NxRLab/gibbot/Code/Python_Projects/Vision/readme.md

Camera.py - Defines Camera class for grabbing, transforming, and clustering blobs
DisplayBlobs.py - Manages two Cameras, combines their output, and displays it to the screen
GUITest.py - Simple standalone Tkinter test code
