NxRLab/gibbot/Code/PIC_Projects/PIC32/BLDC/README

4/2/13
The initial version of this code was tested on a Pittman 4443S013 brushless motor.  The target motor is the Maxon EC 60, so the code will mostly likely change to reflect this.
