NxRLab/gibbot/Frame/Frame v4/POWERPOINT/12.10.14 Presentation.pptx

## Gibbot Frame V4

By Preston Wang

## Version 3

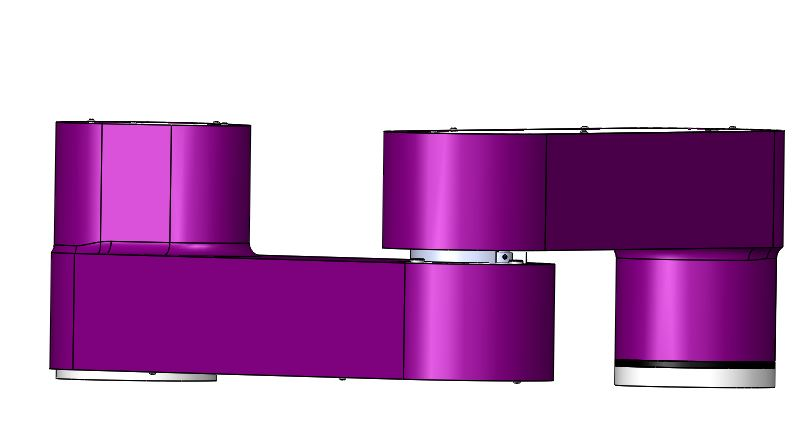
[picture p2: figure]

- Frame Material: ABS Plastic
- Manufacture Method: Rapid Prototyped
- Length: 9.4 in.
- Height: 4.94 in.
- Major Design Change: Redesigned Magnet Holder into one piece, Combined Carrier and Shaft into one component, Added Double Bearings at Magnet Holder Connection

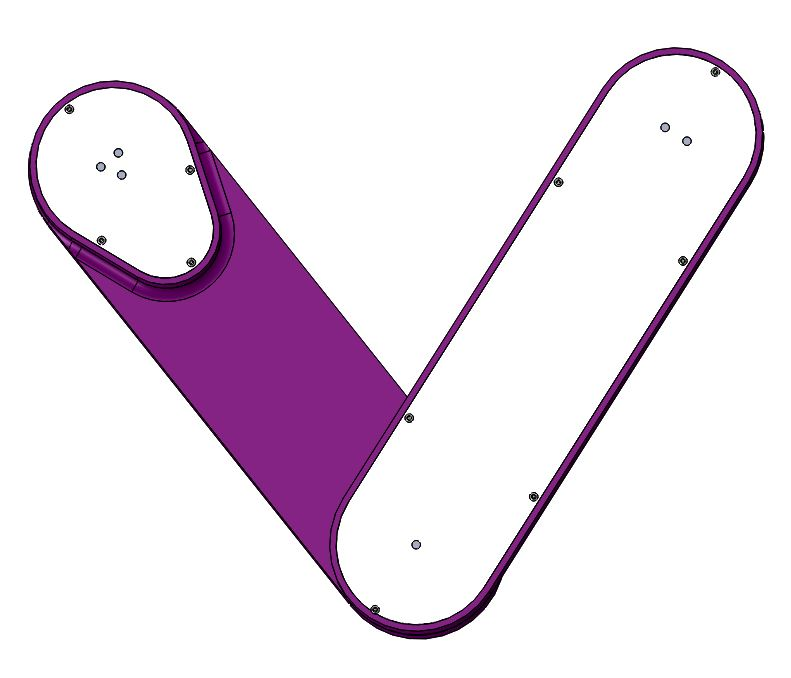
[picture p3: figure]

## Design Goals

- Increase space for wiring
  - Current frame layout and length does not provide enough space for wires between the motor and board
  - Increase overall length of frame
- Reduce the angular play between links
  - Change the link connection from a single bearing to double bearing
- Increase the stiffness of the connection between the links
  - Change carrier attachment to frame from blindly threaded screw to nuts and bolts
- Verify wall thickness of combined carrier and shaft

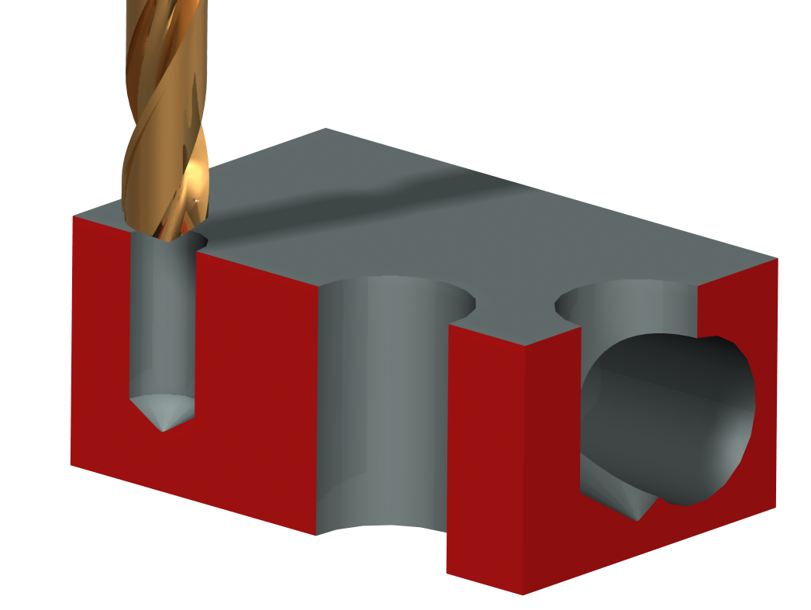
[picture p4: figure]

## Reason for Changing Gears

- Nut and bolt connection requires adequate clearance between fastener and motor
  - Current ring gear size does not satisfy clearance requirement
- Increasing ring gear ID will provide required clearance
  - Increase spacing between planetary gear bearings and DC Motor fasteners

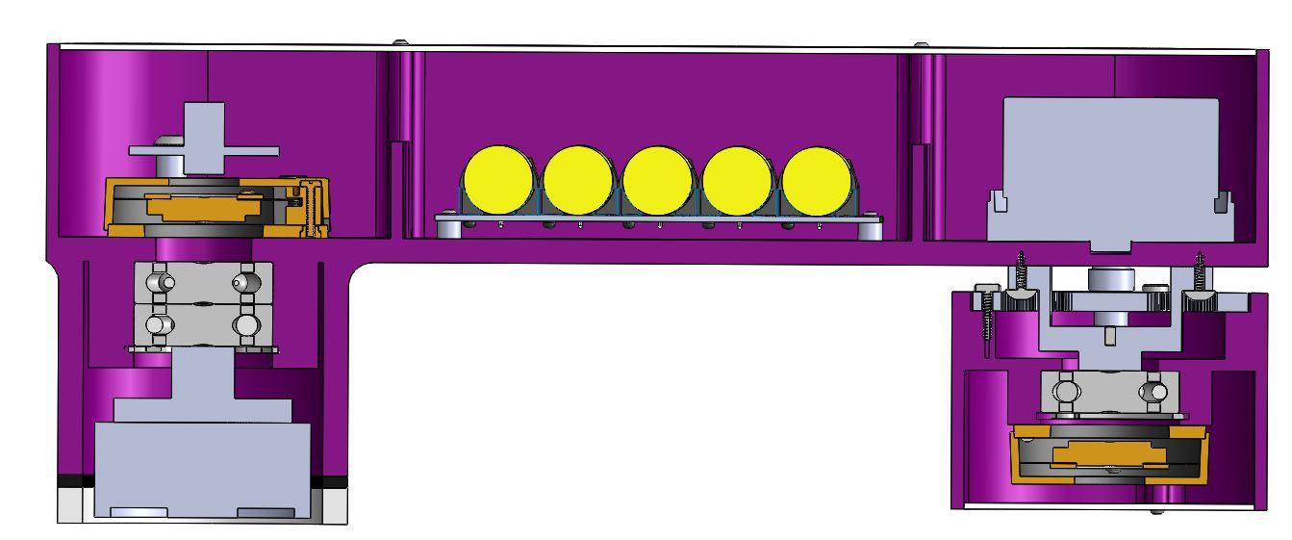
[picture p5: figure]
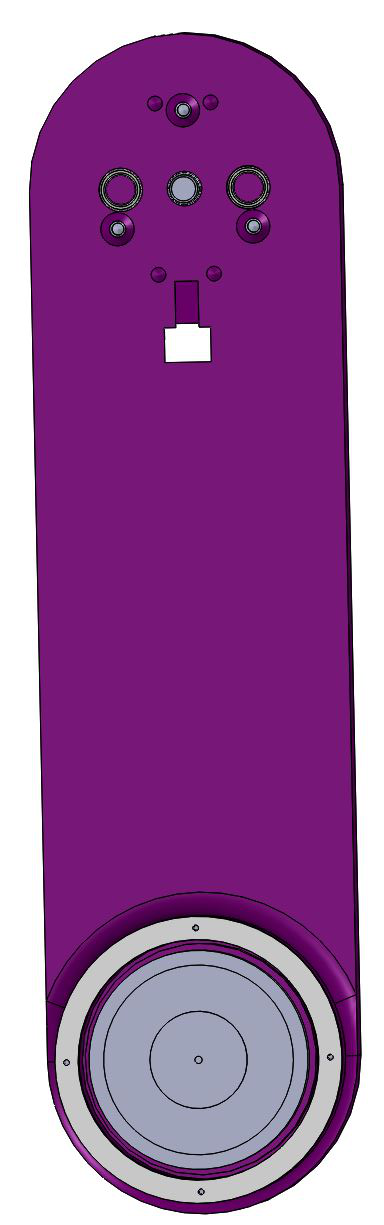
[picture p6: figure]

## Gear Selection Criteria

- Increase Ring Gear ID
  - Minimum ID is 3.5 in
- Maintain same gear ratio of 6
  - # of revolution of sun gear to revolution of ring gear
- Choose planetary gears and sun gear with hubs
  - Hubs provide means of attaching gears to shafts
  - Sun gear bore must be 8mm to fit on motor shaft
- Verify that gears can withstand max torque from motor

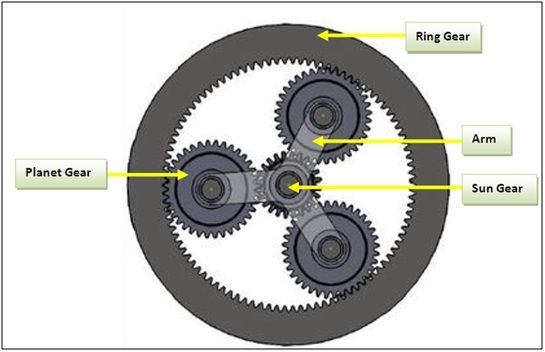
[picture p7: figure]
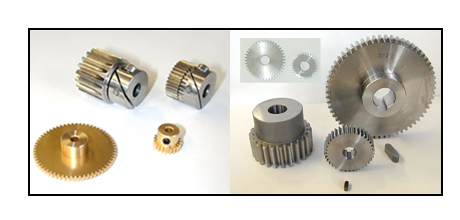
[picture p8: figure]

## Gear Selection

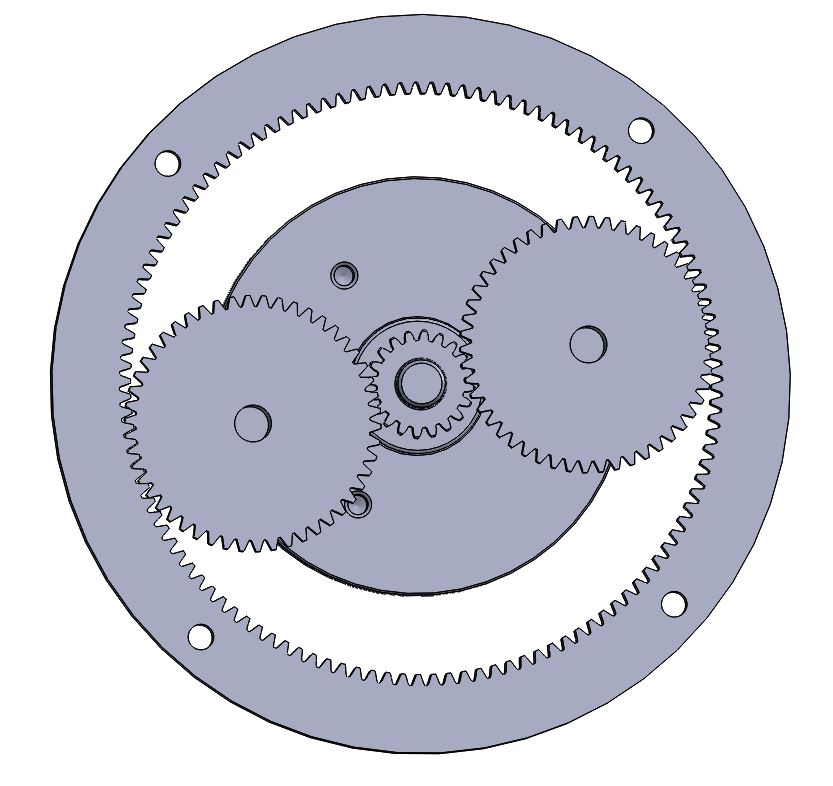
[picture p9: figure]
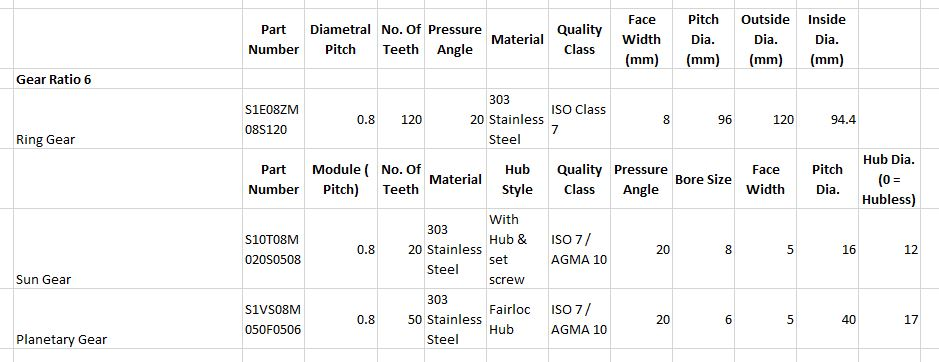
[picture p10: figure]
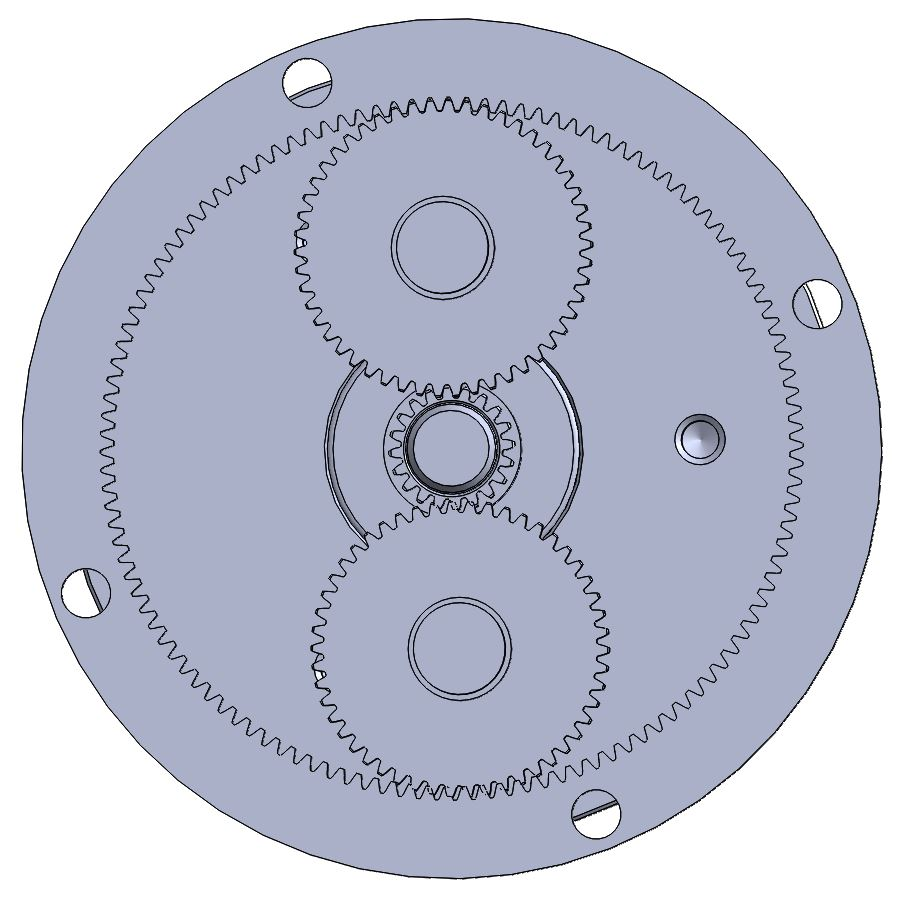
[picture p11: figure]

## Gear Calculations

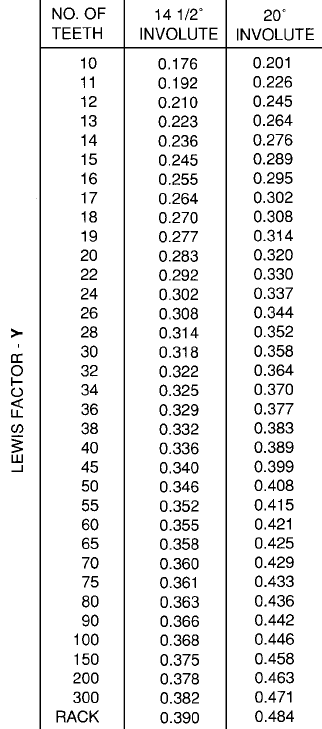
[picture p12: figure]
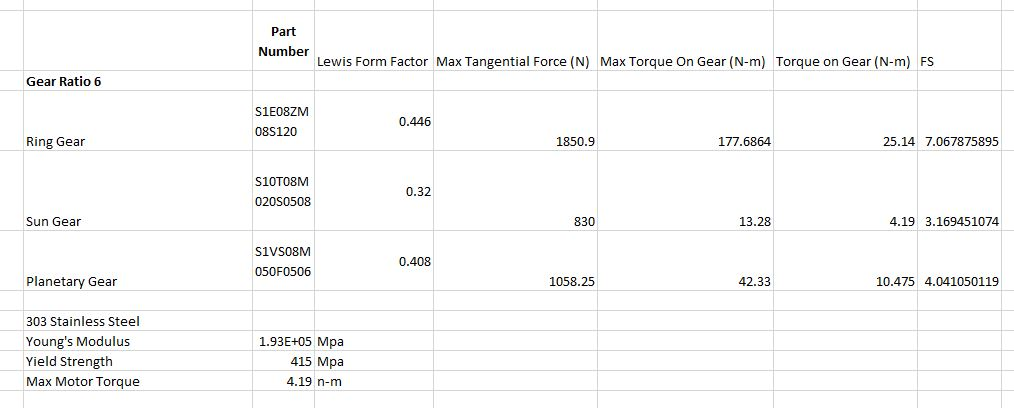
[picture p13: figure]
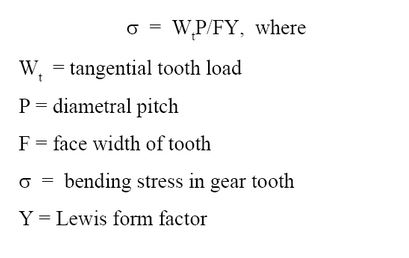
[picture p14: figure]

## Shaft and Fastener Calculations

## Carrier and Shaft

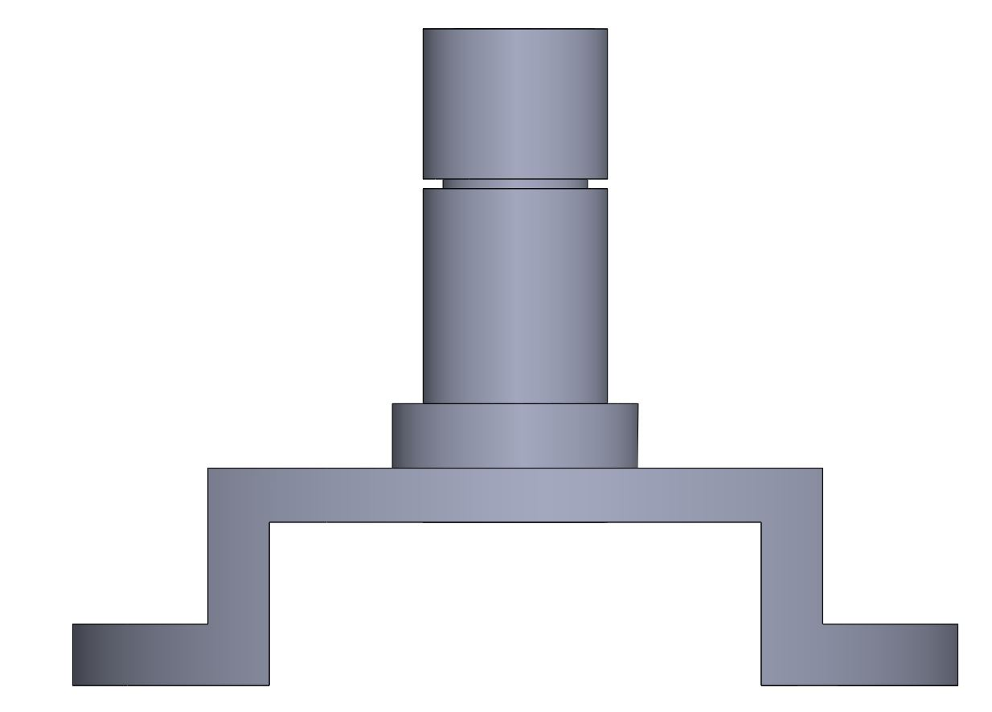
[picture p15: figure]

- Changes:
  - Increased Height to accommodate 2 bearings
  - Increased width to provide clearance between fastener and DC motor
  - Changed bearing holes to accommodate 12mm OD bearing
- Maintained ¾ in. OD and ½ in. ID on shaft
  - Can reuse same bearings
  - Maintains space for wiring

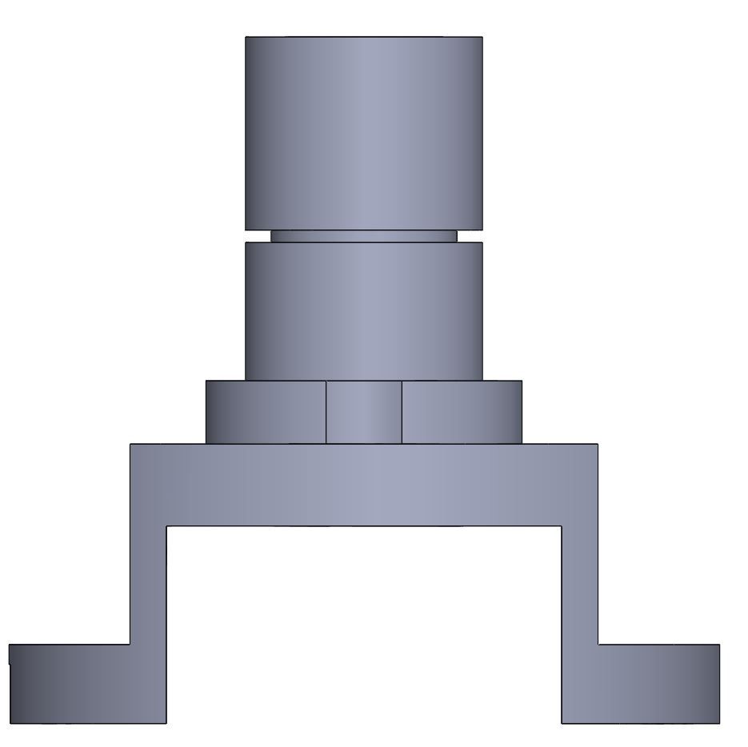
[picture p16: figure]

## Wall Link

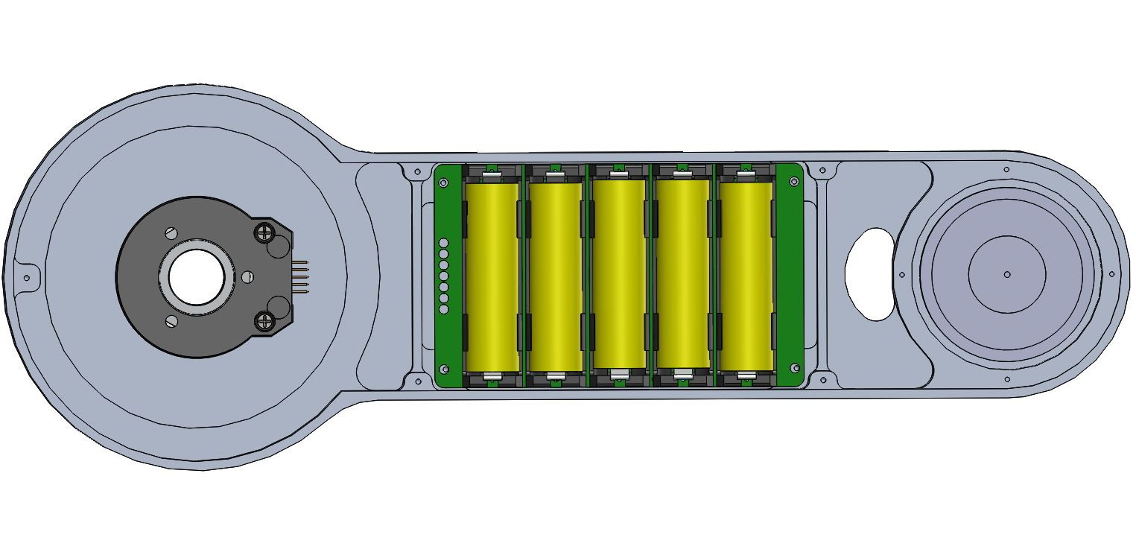
[picture p17: figure]
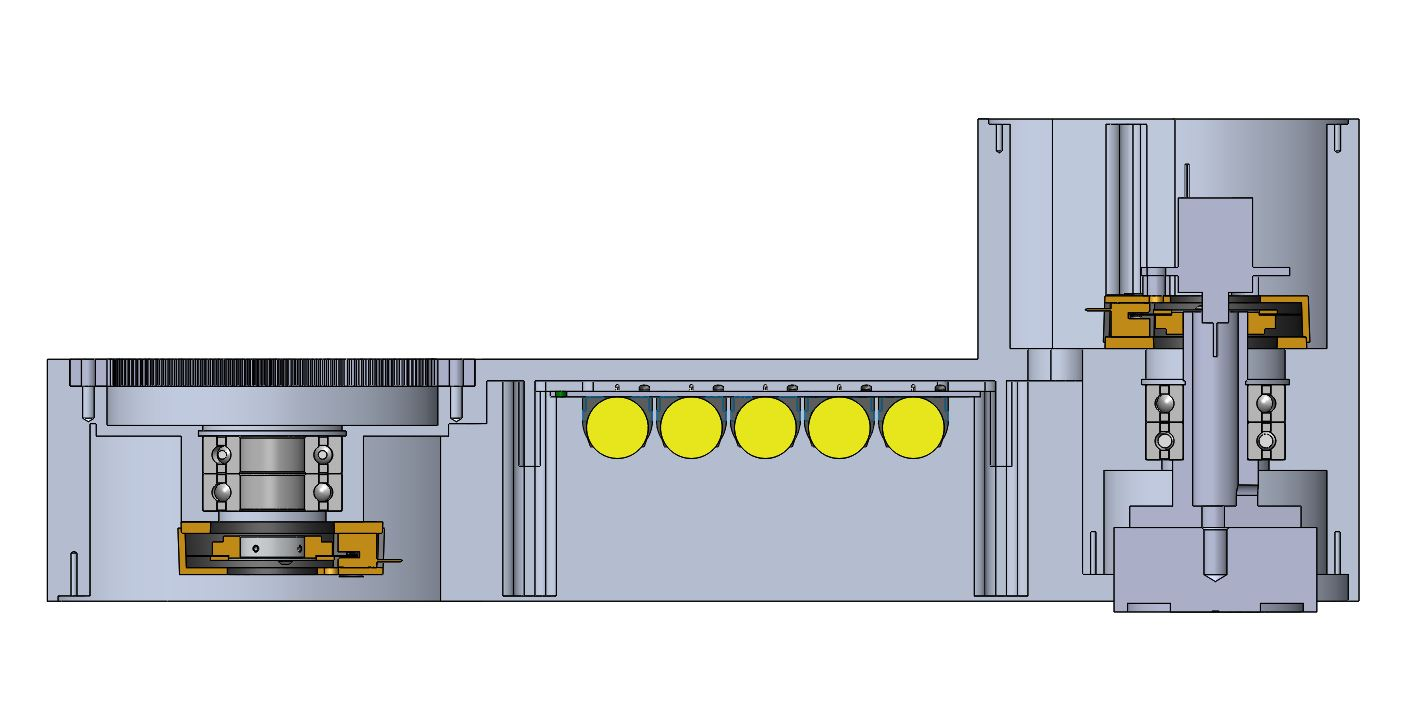
[picture p18: figure]

## Motor Link

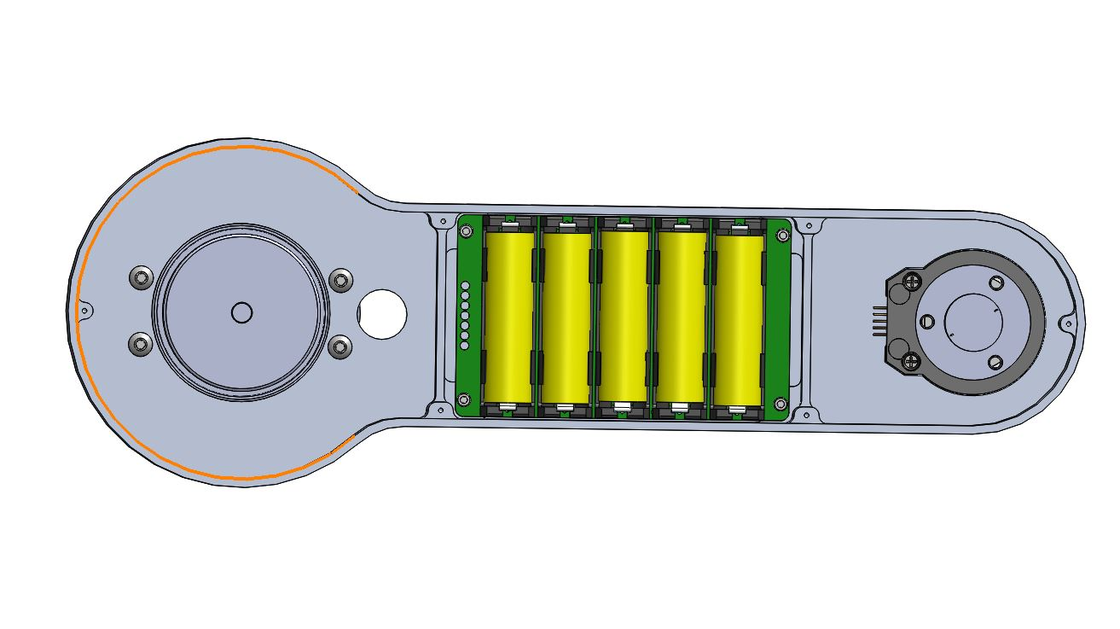
[picture p19: figure]
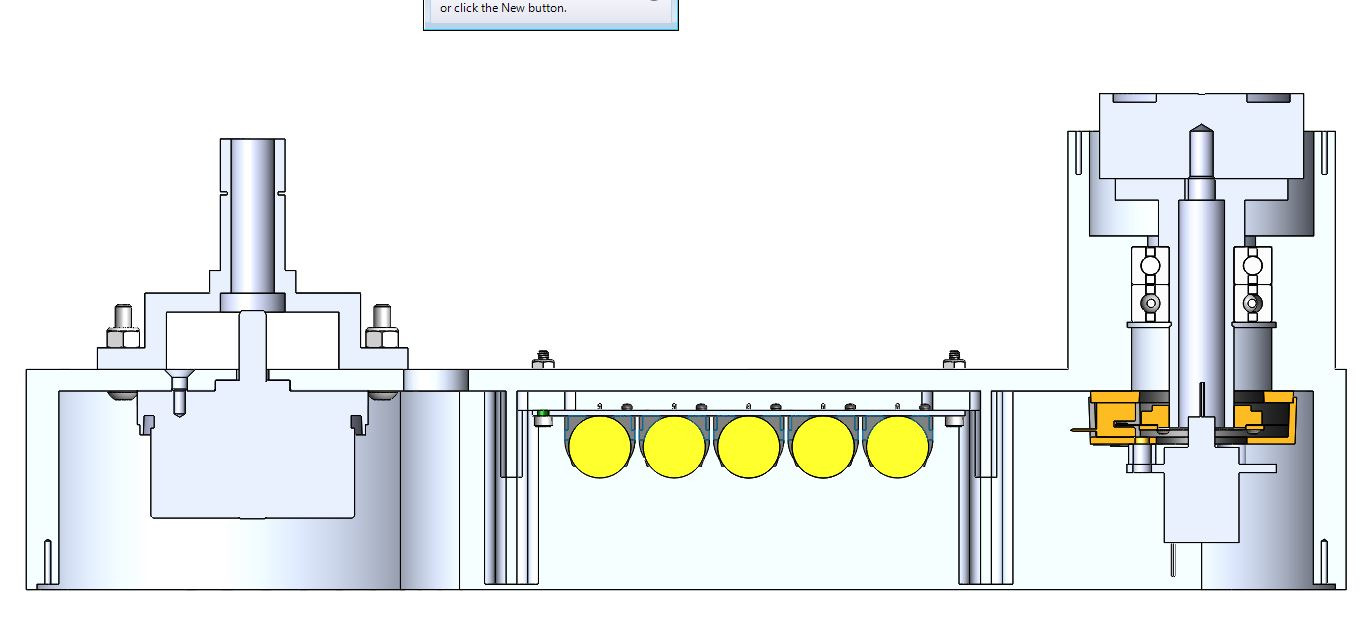
[picture p20: figure]

## Gibbot

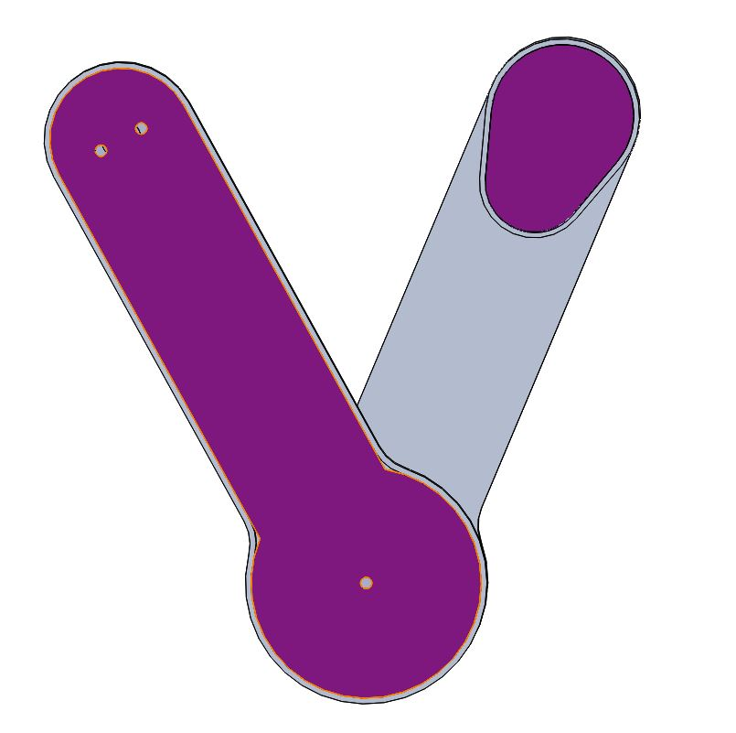
[picture p21: figure]
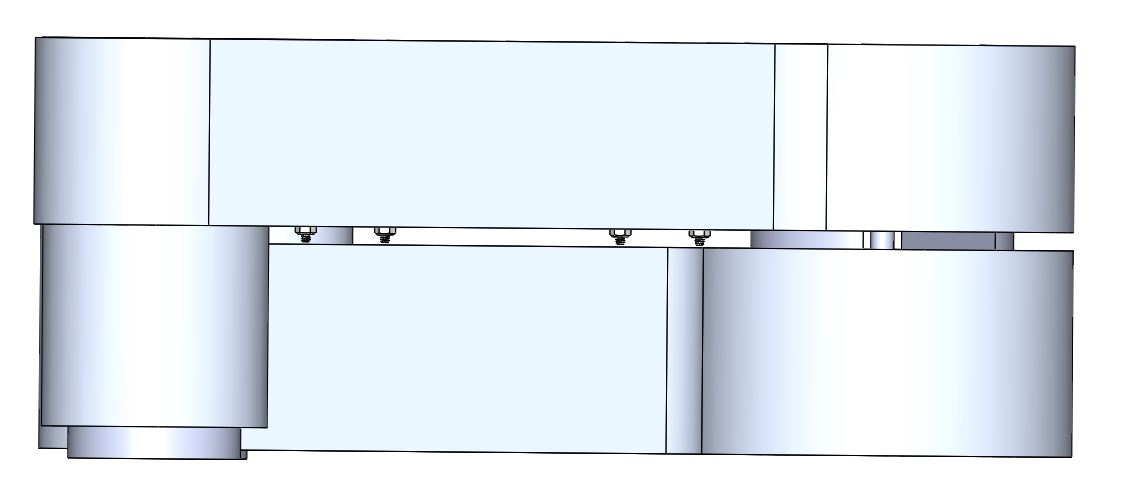
[picture p22: figure]
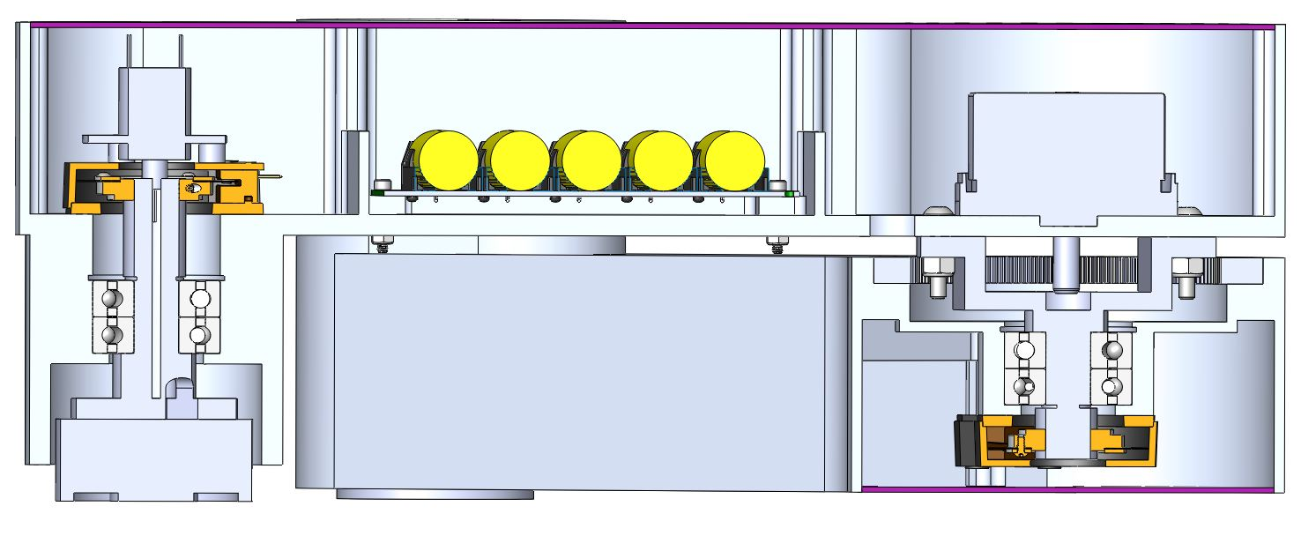
[picture p23: figure]

## Comparison to Previous Year

- Wall Link Weight:
  - V4: 4.26 Lbs
  - V3: 1.23 Lbs
- Motor Link Weight:
  - V4: 3.55 Lbs
  - V3: 0.97 Lbs

## Future Steps

- Decrease height of Motor and Wall Link
- FEA of Links
- GD&T of both links
- Outsource to Industrial Molds

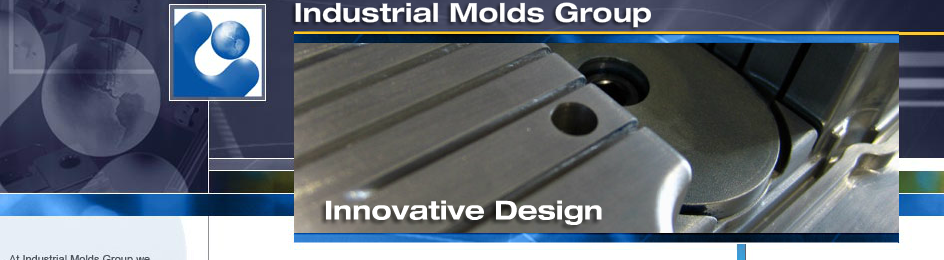
[picture p24: figure]
