NxRLab/gibbot/Documentation/Reports/PCB Documentation/v5.pdf

# Gibbot v5 PCB

Andrew Griesemer

June 9, 2014

## Contents

1 dsPIC Pinout | 2
2 Power Regulation | 2
3 BLDC Motor Driver | 4
4 Inertial Measurement Unit - MPU9150 | 8
5 XBee | 8
6 Magnet Control | 8
7 IR LEDs | 9
8 Current Sensor | 9
9 Wire Gages | 10
10 PCB Bill of Materials | 12
11 Board Issues | 13

## 1 dsPIC Pinout

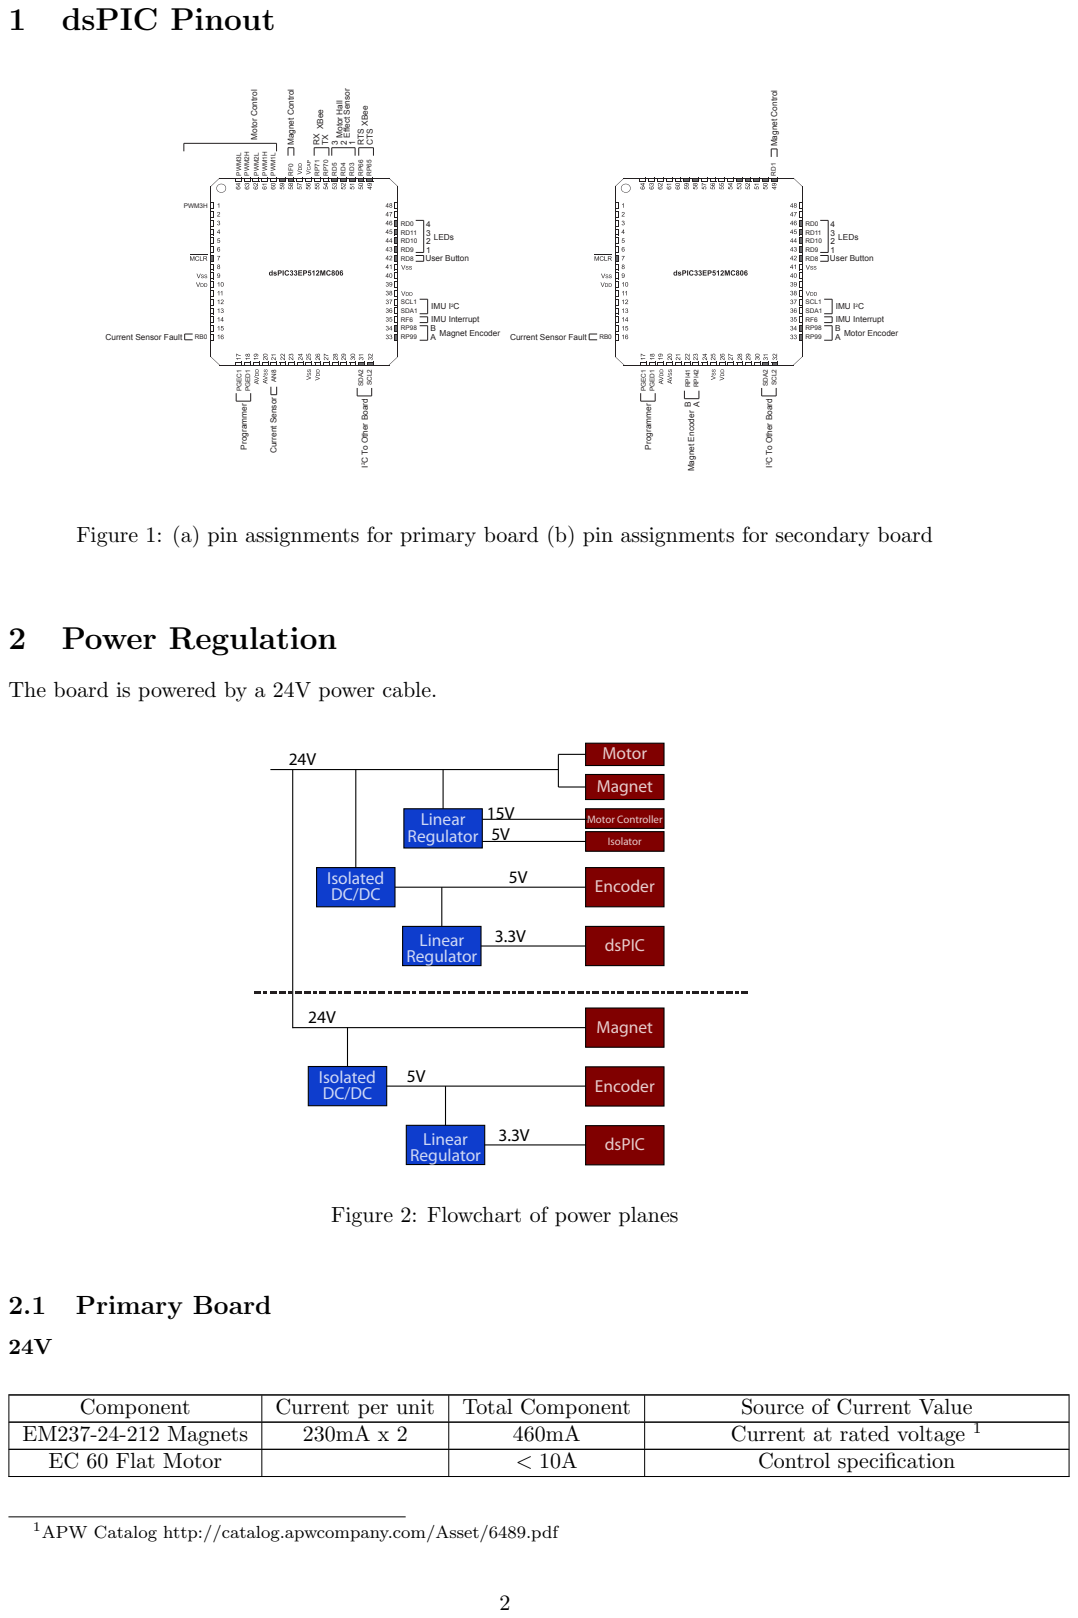
[picture p75: page 2]
SCL1 SDA1 RF6 RP98 RP99; SDA2; SCL2; PGEC1; PGED1; LEDs; User Button; IMU I²; C IMU Interrupt Magnet Encoder B A; Current Sensor; Programmer; TX XBee; RTS; CTS XBee; Motor Hall; Effect Sensor; Motor Control; Magnet Control; PWM3L; PWM2H; PWM2L; PWM1H PWM1L; PWM3H; C IMU Interrupt Motor Encoder B A; Magnet Encoder; RPI41; RPI42; 2 Power Regulation; Linear Regulator; Isolated DC/DC; Motor; Magnet; Encoder; dsPIC; Motor Controller; Isolator; 2.1 Primary Board

Current Sensor Fault

2C To Other Board

Figure 1: (a) pin assignments for primary board (b) pin assignments for secondary board

The board is powered by a 24V power cable.

Figure 2: Flowchart of power planes

Component | Current per unit | Total Component | Source of Current Value
EM237-24-212 Magnets | 230mA x 2 | 460mA | Current at rated voltage 1
EC 60 Flat Motor | | < 10A | Control specification

1APW Catalog http://catalog.apwcompany.com/Asset/6489.pdf

15V

Component | Current per unit | Total Component | Source of Current Value
2 Encoders | 78mA x 2 | 156mA | 62mA maximum no load current + 8mA x 2 maximum output current²

5V

Component | Current per unit | Total Component | Source of Current Value
E3 Encoders | 78mA x 2 | 156mA | 62mA maximum no load current + 8mA x 2 maximum output current³

3.3V

dsPIC | | 320mA | Absolute maximum rating current from VSS⁴
Status LEDs | 3.3mA x 6 | 20mA | Assuming 3.3V and 1k resistor
IMU | | 10mA | 3.9mA gyro + 6mA magnetometer⁵
IR LEDs | 10mA x 6 | 60 mA | 3.3V and 330 ohm resistor
Total | | 0.410 A

### 2.2 Digital Isolation

In previous iterations noise from the motor caused spurious errors across the board. To eliminate the noise the V5 board uses a CC6-2405SF-E (http://www.digikey.com/product-search/en?vendor=0&keywords=CC6-2405SF-E) isolated DC/DC converter on each board to isolate the 5V ground plane from the 24V ground plane. Digital signals to the motor controller and the magnet MOSFETs are transmitted through SI86x0EC-B-IS1 (http://www.digikey.com/product-detail/en/SI8610EC-B-IS/336-2058-5-ND/2623300) series digital isolators.

2E3 1800 CPR product page http://www.usdigital.com/products/e3
3E3 1800 CPR product page http://www.usdigital.com/products/e3
4dsPIC33EP512MC806 datasheet http://ww1.microchip.com/downloads/en/DeviceDoc/70616g.pdf 5MPU-9150 datasheet http://dlnmh9ip6v2uc.cloudfront.net/datasheets/Sensors/IMU/PS-MPU-9150A.pdf

## 3 BLDC Motor Driver

### 3.1 BLDC Motor Background

A Brushless DC Motor is different from a brushed DC motor because it lacks the internal brushes that allow a typical DC motor to reverse the direction of current flow as the rotor coil rotates within the magnetic stator. In order to drive a BLDC motor the direction of current flow must be commutated by external control circuitry. Benefits of BLDC motors over brushed motors include lighter weight for the same amount of torque and increased longevity.
A typical BLDC motor has two or more coils and a sensor that can determine the angular position of the rotor. A microcontroller reads the state of the sensor and changes the direction of current across the coils in order to maximize torque. The BLDC motor on the Gibbot is the Maxon EC 60 Flat which has 3 coils and 3 Hall Effect sensors that detect the angular position of the rotor. A commutation pattern diagram is shown in Figure 3. This diagram depicts the same pattern as the diagram in the Maxon E-Paper Catalog⁶
, but has been modified for clarity. In the diagram the binary hall effect sensor states are shown on top. The MOSFET bridge outputs are shown below. The MOSFET bridge states are indicated as either high, low or float. The float state is represented by a diagonal line.

## Block commutation

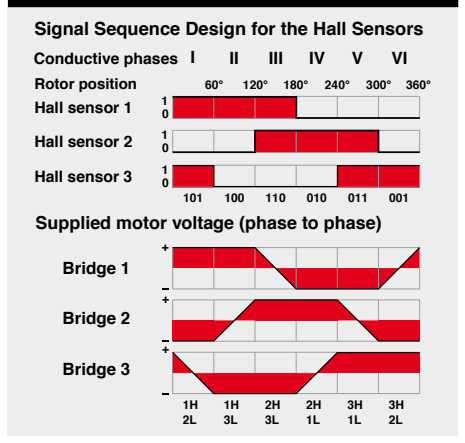
[picture p76: figure]
I II III IV V VI; Bridge 1; Conductive phases; Hall sensor 1; Rotor position; Hall sensor 2 Hall sensor 3 Supplied motor voltage (phase to phase); Bridge 2; Bridge 3

## Signal Sequence Design for the Hall Sensors

Figure 3: The commutation pattern for the Maxon EC 60 Flat Motor.

The pin connections for the Maxon EC 60 Flat motor hall effect sensor ribbon cable are given in Table 1a. Note: The pin numbering from the EC 60 Flat catalog page is for a ribbon cable that has been replaced. The motor pole connections are given in Table 1b.

Table 1: Motor Connections

(a) Hall Effect Cable Pin Connections
Color | Pin Number | Connection
Blue | 1 | 5V
Gray | 2 | GND
Gray | 3 | 1
Gray | 4 | 2
Gray | 5 | 3
(b) Motor Pin Connections
Color | Pin Connection
Red | 1
Black | 2
White | 3

For a lower power application the control of each coil of the motor could have been accomplished by a typical H-bridge. Because the Gibbot requires up to 10A at 24V the commutation circuitry requires higher power H-bridges using MOSFETs. Figure 4 shows the schematic of an H-bridge connection for a single coil. The pull down resistor on the low-side MOSFET gate prevents both MOSFETs from activating before the dsPIC turns on.

6Figure 3 is taken from pg 32 of the Maxon E-Paper Catalog http://epaper.maxonmotor.ch/en/

Figure 4: A single H-bridge for the BLDC motor

### 3.2 HIP4086 Driver

The driver circuit uses Intersil’s HIP4086 3-Phase MOSFET driver⁷
. This chip solves two issues with driving the MOSFETs from a dsPIC, (1) stepping up the control voltage for the low side MOSFET from the microcontroller’s logic level 3.3V to the 15V required to fully turn on the MOSFET. (2) stepping up the gate voltage for the high side MOSFET to 15V plus the motor drive voltage. This voltage level is required because the high side MOSFET’s source is connected to the motor coil so the gate-to-source voltage on the high side MOSFET is referenced to the motor voltage. The HIP4086 accomplishes this higher voltage with Bootstrap capacitors (more info in Section 3.5). The chip also has added functionality such as programmable deadtime which is described further in Section 3.6.

### 3.3 MOSFET Selection

The bridge MOSFETs are the most critical components in the BLDC driver. The MOSFETs must be able to switch quickly and withstand the high drive voltages and switching currents.

Gate Charge (QG) The switching speed of the MOSFET is primarily determined by the gate charge. A smaller gate charge correlates with faster switching time so the gate charge should be minimize. The gate charge listed on a datasheet is typically the gate charge at a VGS = 5V . However, when the HIP4086 has a supply voltage of 15V VGS will be 15V. To determine QG at this voltage a plot of QG vs VGS is used. The plot from the datasheet of the MOSFETs used in the current motor driver circuit, the IRFR3806TRPBF, is shown in Figure 5⁸
. From the plot QG = 33nC at VGS=15V
0 | 5 | 10 | 15 | 20 | 25
Q , Total Gate Charge (nC)

0.0

2.0

4.0

6.0

8.0

10.0

12.0

V

G

S, Gate-to S- ource Voltage V( )

I

D= 25A

14.0

16.0

30 35

VDS= 48V
VDS= 30V
VDS= 12V

Figure 5: Typical Gate Charge vs. Gate-to-Source Voltage linearly extrapolated to VGS = 15V .

7Datasheet http://www.intersil.com/content/dam/Intersil/documents/hip4/hip4086-a.pdf
8
IRFR3806PbF datasheet pg 3 http://www.irf.com/product-info/datasheets/data/irfr3806pbf.pdf

Max Continuous Current The required continuous current for the motor to achieve the desired torque is 10A.

Max Drain to Source Voltage (VDS) The required drain-to-source voltage is the same as the Motor Supply Voltage, which was 48V, but is now 24V. To keep the design flexible to the higher voltage range VDS is set a value above 48V.

Max Gate-to-Source Voltage (VGS) The required gate-to-source voltage is determined by the gate drive voltage of the HIP4086 driver. This gate drive voltage is the same as the supply voltage for the HIP4086. The recommended maximum operating supply voltage on the HIP4086 datasheet⁹ is
15V. To keep the design flexible to supply voltages for the HIP4086 the max gate-to-source voltage should be at least ±15V .

On State Drain-to-Source Resistance (RDS(ON)) The on state resistance effects the efficiency of the drive circuitry and partially determines the temperature rise during operation. RDS(ON) should also be minimized.

Maximum Power Dissipation (PD) This value is not considered in MOSFET selection. While the ability of the MOSFET to dissipate heat from conducting is important, the way in which PD,MAX is defined varies widely between manufacturers. Moreover, the ability of a MOSFET to dissipate heat should not vary significantly between different devices in the same physical package. Determining a specification for power dissipation would also be difficult because it involves a combination of the power dissipated during turn-on and turn-off periods when RDS is high and the power dissipated during the fully on state at the much lower RDS(ON)

### 3.4 Clamping Circuit

The HIP4086 Datasheet and the HIP4086 Demo Board User Guide provide two different methods of clamping the HS pin to prevent negative transients. The two methods are shown in Figure 6. The purpose of the clamping circuit is to limit the negative transient voltage that is induced when the high side MOSFET is turned off to the -6V voltage limit specified for the HIP4086. The two methods accomplish this while limiting the current that is able to flow through the path during the deadtime when both MOSFETs are off. The method used in the HIP4086 Datasheet (Figure 6a) uses two diodes in series. The method used in the HIP4086 Demo Board User Guide (Figure 6b) uses a single diode with a resistor in series. Because values are not established for the resistor in the Demo Board User Guide method we used the simpler method from the Datasheet (Figure 6a).

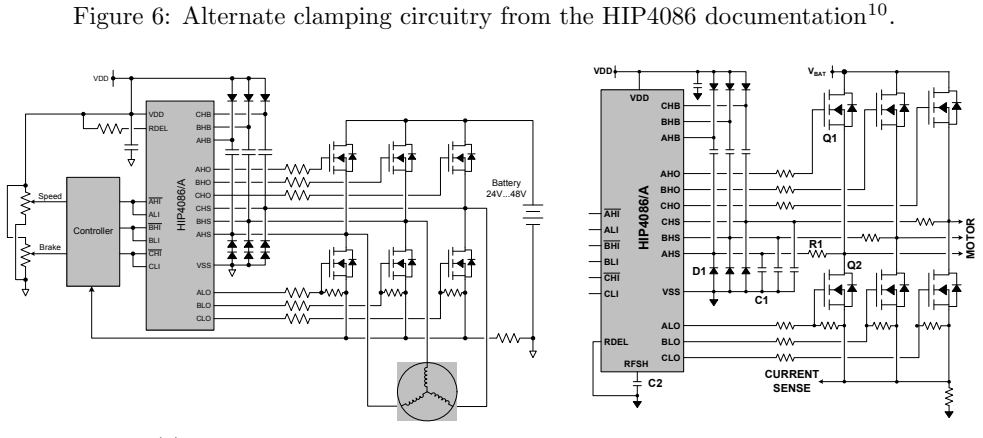
[picture p77: figure]
Controller; AHO; CLO; BLO; ALO; CHO; BHO; CLI; BLI; ALI; CHI; BHI; AHI; CHS; AHS; BHS; CHB; AHB; BHB; VDD RDEL; VDD; Speed; Brake; Battery 24V...48V; HIP4086/A; VSS; RDEL; OTO; VBAT; CURRENT SENSE; RFSH

Figure 6: Alternate clamping circuitry from the HIP4086 documentation¹⁰

(a) HIP4086 Datasheet
(b) HIP4086 Demo Board User guide

9HIP4086 Datasheet pg 5 http://www.intersil.com/content/dam/Intersil/documents/hip4/hip4086-a.pdf
10HIP4086 datasheet pg 12 http://www.intersil.com/content/dam/Intersil/documents/hip4/hip4086-a.pdf and HIP4086
Demo Board User Guide, Application Note 1829 pg 7 http://www.intersil.com/content/dam/Intersil/documents/an18/an1829.pdf

### 3.5 Bootstrap Capacitor, Diode and Resistor Selection

The boot capacitor value is chosen so that the capacitor can provide the gate charge of the driven FET without causing the capacitor voltage to sag excessively.
The formula for calculating bootstrap capacitance from the HIP4086 datasheet is:

QC = QGAT E + P eriod ·

IHB +

VHO

RGS

+ IGAT ELEAK

Because there is no gate-to-source resistor for the high side MOSFETs, the VHO
RGS

term can be elimi-nated. The other values are calculated as follows:

QGAT E = 32nC, gate Charge of the MOSFET at VGS = 15V and VDS ≈ 30V from Figure 5. P eriod = 50µs, maximum on time of the high side MOSFET at 100% Duty Cycle.
IHB = 100µA, worst case high side current through the xHB pin of the HIP4086. IGateLeak = 100nA, leakage current of the MOSFET gate.

QC = 32nC +

1
20, 000Hz

∗ (100uA + 100nA) = 37nC

CBOOT =

QC
Ripple · VDD

CBOOT =

37nC
5% · 15V

= 49nF ≈ 0.047uF

### 3.6 Set Dead Time on the HIP4086

Because the gate capacitance of the MOSFET keeps the MOSFET on for a period of time after the control signal has gone low, there must be a delay between the turn-off event of one PWM output in a complementary pair and the turn-on event of the other. Otherwise shoot through might occur when both MOSFETs are conducting causing the power to short to ground. The time between transitions of the control PWM signal is called dead time. In the current configurations of the Gibbot dead time is redudantly programmed into both the dsPIC PWM control as well as the HIP4086.
Dead time on the HIP4086 is set using a resistor between ground and the pin RDEL on the HIP4086. Figure 7 from the HIP4086 datasheet can be used to set RDEL approximately.

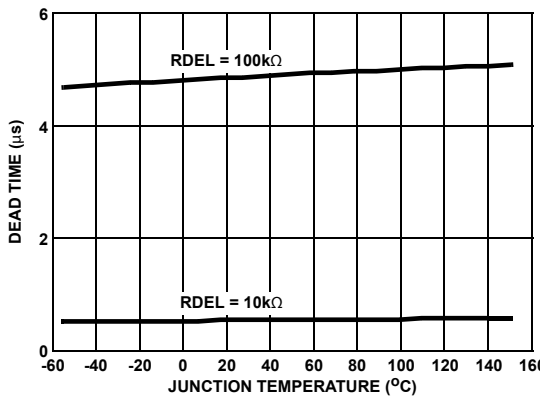
[picture p78: figure]
JUNCTION TEMPERATURE (; DEAD TIME (μs); RDEL = 100kΩ; RDEL = 10kΩ

-60 -40 -20 0 20 40 60 80 100 120 140 160

Figure 7: RDEL vs. Dead Time¹¹

11From HIP4086 3-Phase Bridge Driver Configurations and Applications pg 4 http://www.intersil.com/content/dam/Intersil/documents/an96/an9642.pdf

## 4 Inertial Measurement Unit - MPU9150

The MPU9150 is a 9-axis sensor with a 3-axis gyroscope, a 3-axis accelerometer and a 3-axis magne-tometer. There is an MPU9150 on both the primary and secondary board. The supporting circuitry is shown in Figure 8 below¹². Pull-up resistors in a 0402 package are attached the the SCL and SDA I²C communication lines.

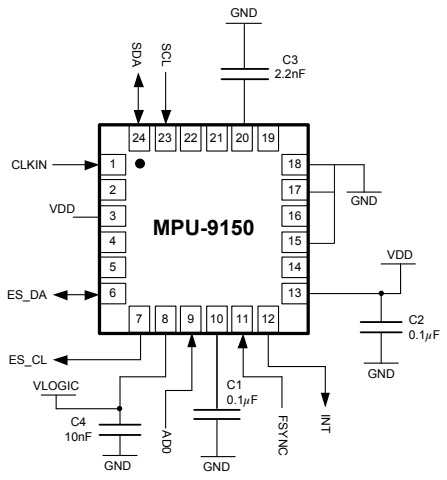
[picture p79: figure]
MPU-9150; CLKIN; GND; FSYNC; INT; VDD; SCL; SDA; VLOGIC

Figure 8: MPU9150 Typical Operating Circuit

## 5 XBee

There are pads for installing an XBee on both the primary and the secondary board. The XBee is connected to the dsPIC on each board through two communications wires, RX and TX.
CTS and RTS, Multiple LEDs are connected to outputs from the XBee to provide a visual indicator of its status. The schematic for these connections are shown in Figure 9.

RSSI Recieved Signal Strength Indicator - A high speed PWM output ranging from 24% to 100% duty cycle depending on the strength in decibels above the sensitivity threshold of the last recieved RF packet.

Associated Blinks when the XBee is associated with a coordinator.

## 6 Magnet Control

Logic level MOSFETs control the electromagnets. To maintain isolation between the noisy 24V line and the 5V digital line the magnet MOSFET control signal is transmitted through a digital isolator.

12MPU9150 Product Specification p21 http://www.invensense.com/mems/gyro/documents/PS-MPU-9150A-00v4 3.pdf

Figure 9: XBee Connections

## 7 IR LEDs

The Gibbot is mounted with six Optitrack IR LEDs. (http://www.naturalpoint.com/optitrack/static/documents/850%20nm%20IR%20LED%20Data%20Sheet.pdf) The LEDs are mounted on the face plate in three clusters (2 above the top magnet, 1 above the motor, 3 above the bottom magnet) so that the Optitrack cameras can detect the position of each magnet and the motor joint.

### 7.1 IR LED Resistor Values

In this iteration all of the LEDs are powered on 5V lines. The minimum resistor values were calculated as follows:

1 LED
5V − (1 ∗ VF,MAX)

IF,MAX

=

5V − 1.6V
100mA = 34Ω

2 LED
5V − (2 ∗ VF,MAX)

IF,MAX

=

5V − 3.2V
100mA = 18Ω

3 LED
5V − (3 ∗ VF,MAX)

IF,MAX

=

5V − 4.8V
100mA = 2Ω

Where:
VF,MAX = 1.6V
IF,MAX = 100mA
To avoid the risk of running maximum current through the resistors these value should be increased by about 50%.

## 8 Current Sensor

The current sensor used on the board is the ACS716KLATR-12CB-T which has an optimized accuracy range of +/- 12.5A and a linear sensing range of +/- 37.5A. The sensor outputs an analog voltage proportional to the current through its sensing path, centered at 1.65V for zero current with a slope of 37mV/A.

### 8.1 dsPIC ADC Inductor

The dsPIC33EP512MC806 datasheet¹³ recommends an inductor between the VDD and AV DD to improve ADC noise rejection. The inductance of this inductor is calculated as follows:

L =

1
2 · π ·

FCNV
2

·

√
C

!2

Where:
FCNV = ADC Conversion Rate
When the ADC is configured to read a single input using manual read triggering and automatic sampling triggering with TAD = 250ns the maximum FCONV = 115kHz.

L =

1
2 · π ·

115kHz
2

·

√

.1uF !2
= 76µH

The datasheet also specifies that the inductor should have a maximum impedance of 1Ω and a current rating of at least 10mA. The largest inductance value available on Digikey (http://www.digikey.com/product-detail/en/LBC3225T470KR/587-2430-1-ND/2230296) that was still in a relatively small package was 47µH. From this value, the maximum FCNV should be:

FCNV,MAX =

1
π ·

√
L · C

=

1
π ∗

√
47µH · 0.1µF

= 147kHz

13dsPIC33EPXXX(GP/MC/MU)806/810/814 datasheet pg 32 http://ww1.microchip.com/downloads/en/DeviceDoc/70616g.pdf

### 8.2 ACS716 Filter Capacitor

The ACS716 allows for a filter capacitor to limit noise in the sensor. The capacitance is determined from the plot below. Since the motor is driven with a PWM frequency at 20kHz an appropriate bandwidth is between 10 and 20kHz. The corresponding capacitance from Figure 10 is between 5 and 9nF.

Capacitor connected between FILTER pin and GND
1000

100

10

1

0.1
0.01 | 0.1 | 1 | 10 | 100 | 1000

Bandwidth (kHz)

Capacitance (nF)

Figure 10: ACS716 Bandwidth versus External Capacitor Value, CF

14

### 8.3 Overcurrent Threshold

The overcurrent threshold voltage allows us to detect if the current level is above a user-set limit, likely because of a short. The overcurrent limit is set using a voltage divider composed of RH and RL to set a reference voltage on pin VOC . When the current through the current path is detected to be higher than

COC = IOC ∗ 37mV /A

the ACS716 drives the output of the FAULT pin high. We chose to set the current threshold at 30A.

COC = 30A ∗ 37mV /A = 1.1V

Resistors values of RH = 2k and RL = 1k set VOC at

VOC = 3.3V ∗

1k
1k + 2k

= 1.1V

To prevent the fault detection from triggering because of noise a capacitor is connected between fault and ground. The maximum recomended value of 22nF is used. In previous iterations this features was configured, but the FAULT pin was not connected to the PIC. The pin is now connected to pin B0 on the PIC.

## 9 Wire Gages

### 9.1 Wire Sources

The standard wire gages on purchased connectors are:

Orbex Slip Ring 2A: AWG26 or AWG28

Sparkfun JST PH Jumper Wire: 24 AWG

Sparkfun JST SH Jumper Wire: 28 AWG

Mechatronics Lab Red & Black 22 AWG

Nick’s stores Red, Blue & Green 30 AWG

NxR 30 AWG Black
22 AWG Green
16-19 AWG Lime Green
22 AWG Black, Blue, Red White, Green, Orange in Grey case 16 AWG Blue, Brown Green
Unknown AWG Red, Black, White shielded clear
22 AWG Striped

14From ACS716 Datasheet pg 10 http://www.allegromicro.com/˜/media/Files/Datasheets/ACS716-Datasheet.ashx

### 9.2 Wire Requirements

24V Power
Current Sensor
Main Board 5V Power 22 AWG Red & Black Secondary Board 5V Power 22 AWG Red & Black

### 1 LED Power 30 AWG Red & Black 2 LED Power 30 AWG Red & Black 3 LED Power 30 AWG Red & Black

Top Magnet Control 30 AWG Red, Green, Blue & Red Bottom Magnet Power 22 AWG Red & Black
Top Magnet (Slip Ring) 28 AWG Red, Yellow & Black Bottom Magnet (Slip Ring) 28 AWG Red, Yellow & Black Top Magnet Encoder 30 AWG Black, Red, Green & Blue Bottom Magnet Encoder 30 AWG Black, Red, Green & Blue Motor Encoder 30 AWG Black, Red, Green & Blue
I2C 30 AWG Green & Blue

## 10 PCB Bill of Materials

Part Number | Quantity | Description
Microcontrollers & Sensors
PIC1, PIC2 | 2 | DSPIC33EP512MC806 (http://www.digikey.com/product-detail/en/DSPIC33EP512MC806-I%2FPT/DSPIC33EP512MC806-I%2FPT-ND/2835084)
X1 | 1 | XBee Series 1 Wired Antenna (https://www.sparkfun.com/products/8665)
CS1 | 1 | ACS716KLATR-6BB-T Current Sensor (http://www.digikey.com/product-detail/en/ACS716KLATR-6BB-T/620-1445-1-ND/2890908)
IMU1, IMU2 | 2 | MPU-9150 (Out of Stock)
| 2 | MPU-6000 (Replacement) (http://www.digikey.com/product-detail/en/MPU-6000/1428-1005-1-ND/4038006)
MD1 | 1 | HIP4086 BLDC Motor Driver (http://www.digikey.com/product-detail/en/HIP4086ABZ/HIP4086ABZ-ND/936251)
Resistors
R40, R41, R43 | 3 | 0 ohm
R70 | 1 | 3.3 Ω
R34, R35, R36, R37, R38, R39 | 6 | 10 Ω
R25 | 1 | 22 Ω
R24 | 1 | 47 Ω
R2, R7, R8, R9, R10, R11, R12, R13, R17, R18, R19, R31, R66, R67, R68, R69, R77, R78 | 18 | 1k Ω
R1 | 1 | 2k Ω
R14, R42, R61, R73 | 4 | 2.2k Ω
R16 | 1 | 10kΩ
R4, R5, R6 | 3 | 20k Ω
R3 | 1 | 330k Ω
Capacitors
C34, C35, C36, C37, C50, C51, C52, C53, C61 | 9 | .01uF 0603
C1, C11, C12, C13, C21, C22, C25, C26, C28, C29, C31, C32, C33, C38, C40, C41, C42, C43, C54, C55, C56, C57, C59, C60, C62 | 25 | .1uF 0603
C7, C8 | 2 | .1uF 0603 25V Rated
C39 | 1 | .1uF 0603 50V Rated
C6, C46, C47 | 3 | .1uF 1206
C17, C18, C19 | 3 | .03uF 0603 16V Rated
C2 | 1 | 1nF 0603
C64 | 1 | 1uF 1206
C23, C27 | 2 | 2.2nF 0603
C20, C24 | 2 | 10nF 0603
C15, C48, C49, C63 | 4 | 10uF 0603 Polarized
C5, C30 | 2 | 10uF 0603
C14, C44, C45, C58, C65 | 5 | 10uF 1206
C66, C67 | 2 | 10uF 1206
C4 | 1 | 22nF 0603
C9, C10 | 1 | 22uF 0603 15V Rated
C3 | 1 | 7nF 0603
Diodes
D1, D2, D3, D4, D5, D7, D8, D9, D10, D11, D12
11 | ES1B 100V, 1A (http://www.digikey.com/product-detail/en/ES1B/ES1BFSCT-ND/3042546)

Power Converters
P2 | 1 | 24V to 5V DC-DC Converter (http://www.digikey.com/product-search/en?WT.z_header=search_go&lang=en&site=us&x=0&y=0&formaction=on)
P3 | 1 | 24V to 15V & 5V Linear Regulator (http://www.digikey.com/product-search/en?vendor=0&keywords=IFX21004TNV51)
P1, P4 | 2 | 5V to 3.3V LDO Regulator (http://www.digikey.com/product-detail/en/TLV1117LV33DCYR/296-28778-1-ND/2666520)
P5 | 1 | 15V to 5V Linear Regulator (http://www.digikey.com/product-detail/en/LM2937IMPX-5.0%2FNOPB/LM2937IMPX-5.0%2FNOPBCT-ND/3526931)
Digital Isolators
DI2, DI3 | 2 | 1 Channel (http://www.digikey.com/scripts/DkSearch/dksus.dll?Detail&itemSeq=147517739&uq=635321171204954916)

Part Number | Quantity | Description
DI1 | 1 | 6 Channel (http://www.digikey.com/product-detail/en/SI8660EC-B-IS1/336-2118-5-ND/2623366)
MOSFETs
1H, 1L, 2H, 2L, 3H, 3L | 6 | IRFR3806 (http://www.digikey.com/product-detail/en/IRFR3806TRPBF/IRFR3806TRPBFCT-ND/1925534)
M1, M2 | 2 | SSM3K329RLFCT-ND, 30V, Logic Level (http://www.digikey.com/product-detail/en/SSM3K329R,LF/SSM3K329RLFCT-ND/3522426)
LEDs
12 | 0603 LED
Switches & Buttons
SW1 | 1 | SPDT Slide Switch (http://www.digikey.com/product-detail/en/MHSS1104/679-1848-ND/1795408)
RESET1, USER1, RESET2, USER2 | 4 | Momentary, Normally Off, Tactile Switch (http://www.digikey.com/product-detail/en/MJTP1243/679-2452-ND/1798039)
Connectors
J1, J6, J7, J8, J9, J14, J15, J20, J21 | 9 | JST PH 2pos Right Angle Header (http://www.digikey.com/product-search/en?pv88=2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)
| 9+ | JST PH 2pos Housing (http://www.digikey.com/product-search/en?s=3742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)
| 5+ | JST KR 2pos IDC (http://www.digikey.com/product-search/en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)
J4, J13 | 2 | JST PH 3pos Right Angle Header (http://www.digikey.com/product-search/en?pv69=367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)
| 2+ | JST PH 3pos Housing (http://www.digikey.com/product-search/en?s=3742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)
| 5+ | JST KR 3pos IDC (http://www.digikey.com/product-search/en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)
J2, J17, J18 | 3 | JST PH 4pos Right Angle Header (http://www.digikey.com/product-search/en?pv69=367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)
| 2 | JST PH 4pos Housing (http://www.digikey.com/product-search/en?s=3742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)
| 5+ | JST KR 4pos IDC (http://www.digikey.com/product-search/en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)
J3, J12 | 2 | JST PH 8pos Right Angle Header (http://www.digikey.com/product-search/en?pv69=367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)
| 2 | JST PH 8pos Housing (http://www.digikey.com/product-search/en?s=3742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)
| 2 | JST PH 8pos IDC (http://www.digikey.com/product-search/en?s=3215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)
| 40+ | JST PH Contact 22-26AWG (http://www.digikey.com/product-detail/en/SPH-001T-P0.5L/455-2147-1-ND/1634655)
| 40+ | JST PH Contact 24-30AWG (http://www.digikey.com/product-detail/en/SPH-002T-P0.5S/455-1127-1-ND/527358)
| 40+ | JST PH Contact 28-32AWG (http://www.digikey.com/product-detail/en/SPH-004T-P0.5S/455-1318-1-ND/608807)
J10, J11, J16, J19 | 4 | JST SH/SR 2pos Right Angle Header (http://www.digikey.com/product-detail/en/SM02B-SRSS-TB(LF)(SN)/455-1802-1-ND/926873)
| 4+ | JST SR 2pos IDC (http://www.digikey.com/product-search/en/connectors-interconnects/rectangular-connectors-free-hanging-panel-mount/1442549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)
J5 | 1 | JST SH/SR 5pos Right Angle Header (http://www.digikey.com/product-detail/en/SM05B-SRSS-TB(LF)(SN)/455-1805-1-ND/926876)
| 1 | JST SR 5pos IDC (http://www.digikey.com/product-search/en?pv88=24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)
| 20+ | JST SH Contacts 28-32AWG (http://www.digikey.com/product-detail/en/SSH-003T-P0.2/455-1561-1-ND/720818)
JP1, JP2, JP3, JP4, JP5 | 5 | Molex Mini Fit Jr. 2pos Right Angle Header (http://www.digikey.com/product-detail/en/0039300020/WM21351-ND/930320)
| 5 | Molex Mini Fit Jr. 2pos Vertical Header (http://www.digikey.com/product-detail/en/0039293026/WM3843-ND/2002650)
| 5 | Molex Mini Fit Jr. 2pos Housing (http://www.digikey.com/product-detail/en/0039012020/WM3700-ND/61315)
JP6 | 1 | Molex Mini Fit Jr. 3pos Right Angle Header (http://www.digikey.com/product-detail/en/0039303035/WM18446-ND/300079)
| 1 | Molex Mini Fit Jr. 3pos Housing (http://www.digikey.com/product-detail/en/0039012020/WM3700-ND/61315)
| 15 | Molex Mini Fit Jr. Contacts 16AWG (http://www.digikey.com/product-detail/en/0039000077/WM3112CT-ND/1643460)
| 15 | Molex Mini Fit Jr. Contacts 18-24AWG (http://www.digikey.com/product-detail/en/0039000038/WM2501CT-ND/467978)
| 15 | Molex Mini Fit Jr. Contacts 22-28AWG (http://www.digikey.com/product-detail/en/0039000046/WM2503CT-ND/3028710)
Miscellaneous
10 | 18650 Battery Holder (http://www.keyelco.com/product.cfm/Thru-Hole-Mount/1043P/product_id/13958)

## 11 Board Issues

Triangles on programming pins DC-DC Converter RC Pin shorted to 24V, should be shorted to GND. Pads for standoffs misaligned. Motor Board Current Sense and Input Voltage mislabeled On 8 pin connector between PIC board and motor board 3.3V and GND are reversed in order Motor hall effect sensors connection pins are labeled in reverse order RDEL is not connected to 15V. Encoder inputs are in different order on different boards Magnet MOSFET - ”SOT23F” label is the footprint, part number is actually SSM3K329R SCL and SDA on secondary board labeled incorrectly
