NxRLab/gibbot/Documentation/Reports/PCB Documentation/CodeDoc.pdf

# Gibbot v4 Code

Andrew Griesemer

April 26, 2014

## 1 I²C

The Gibbot PCB uses I²C communication between the dsPIC in each link. The dsPICs also each communicate with a MPU-9150 Nine Axis Sensor via I²C. To maintain compatibility, the I²C protocol between the two dsPICs will be based off of the I²C used by the MPU-9150. For communication between the two dsPICs the dsPIC in the top link will act as master and the dsPIC in the lower link will act as slave. For communication between the dsPICs and the MPU-9150 both dsPICs will act as master. This section references three documents in the footnotes. Those documents are:

MPU-9150 Product Specification Revision 4.3 http://www.invensense.com/mems/gyro/documents/PS-MPU-9150A-00v4 3.pdf

dsPIC33/PIC24 Family Reference Manual: Inter-Integrated Circuit (I2C) Section

http://ww1.microchip.com/downloads/en/DeviceDoc/70000195f.pdf

dsPIC33EPXXX(GP/MC/MU)806/810/814 Data Sheet (10/17/2012)

http://ww1.microchip.com/downloads/en/DeviceDoc/70616g.pdf

### 1.1 Commands

Single-Byte Write Sequence

Burst Write Sequence

Master | S | AD+W | | RA | | DATA | | P
Slave | | | ACK | | ACK | | ACK
Master | S | AD+W | RA | DATA | DATA | P
Slave | ACK | ACK | ACK | ACK

Single-Byte Read Sequence

Burst Read Sequence

Master | S | AD+W | RA | S | AD+R | NACK | P
Slave | ACK | ACK | ACK | DATA
Master | S | AD+W | | RA | | S | AD+R | | | ACK | | NACK | P
Slave | | | ACK | | ACK | | | ACK | DATA | | DATA
Signal | Description
S | Start Condition: SDA goes from high to low while SCL is high
AD | Slave I² C address
W | Write bit (0)
R | Read bit (1)
ACK | Acknowledge: SDA line is low while the SCL line is high at the 9th clock cycle
NACK | Not-Acknowledge: SDA line stays high at the 9th clock cycle
RA | MPU-9150 internal register address
DATA | Transmit or received data
P | Stop condition: SDA going from low to high while SCL is high

Figure 1: I²C commands for MPU-9150¹

The module is responsbible for the four different commands shown in Figure 1.

### 1.2 Slave Configuration

Because the slave dsPIC does not control the timing of the I²C messages communication is handled by the the I²C Slave Interrupt. The initialization code for the I²C does four things:

1. Sets a 7 bit address that the I²C module will recognize as the device address.
2. Configures a global pointer variable RegPtr to point to the address of the first slot in an array RegBuffer.

1From MPU-9150 Product Spec p 34-35

3. Initialize the I²C slave interrupt
4. Turn on the I²C module

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

At the beginning of a transmission the I²C module detects the start condition and compares the following address byte with the I2C2ADD register. If the address matches, the I²C Slave Interrupt flag is set, the D/A bit in the I2C2STAT register is cleared and the R/W bit in the I2C2STAT register is modified to reflect the R/W bit in the command. If the address does not match, the module takes no action and all following bytes are ignored until after a stop condition is detected.

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

}
}
IF S 3 bi t s . SI2C2IF = 0 ; }
