NxRLab/gibbot/Documentation/Reports/PCB Documentation/images/V5PowerPath.pdf

Linear
Regulator

Isolated
DC/DC

Linear
Regulator

Motor
Magnet

Encoder

dsPIC

24V

15V

5V

3.3V

Isolated
DC/DC

Linear
Regulator

5V

3.3V

24V

Encoder

dsPIC

Motor Controller
5V | Isolator

Magnet
