NxRLab/gibbot/Documentation/Reports/PCB Documentation/images/commutation.pdf

I II III IV V VI

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
60° 120° 180° 240° 300° 360°

Conductive phases

Hall sensor 1

Rotor position

Hall sensor 2
Hall sensor 3

Supplied motor voltage (phase to phase)

Block commutation
Signal Sequence Design for the Hall Sensors
