NxRLab/gibbot/Documentation/Reports/PCB Documentation/images/commutation2.pdf

## I II III IV V VI

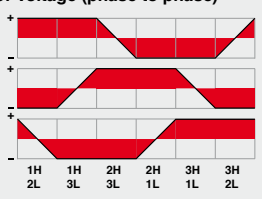
[picture p80: figure]

## Bridge 1

1
0
1
0
1
0

60° 120° 180° 240° 300° 360°

## Conductive phases

## Hall sensor 1

### Rotor position

## Hall sensor 2 Hall sensor 3

## Supplied motor voltage (phase to phase)

# Block commutation

## Bridge 2

## Bridge 3

## Signal Sequence Design for the Hall Sensors

101 100 110 010 011 001
