NxRLab/gibbot/Documentation/Reports/PCB Documentation/images/mpu9150.pdf

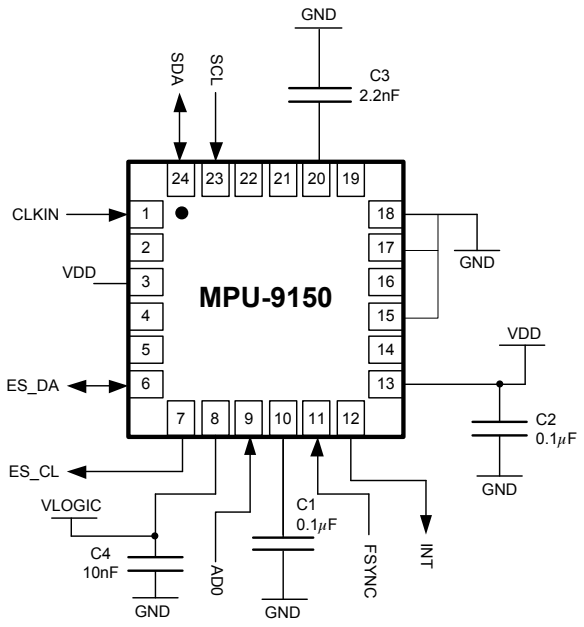
[picture p81: figure]
MPU-9150; CLKIN; GND; FSYNC; INT; VDD; SCL; SDA; VLOGIC
