NxRLab/gibbot/Documentation/Reports/PCB Documentation/images/qg.pdf

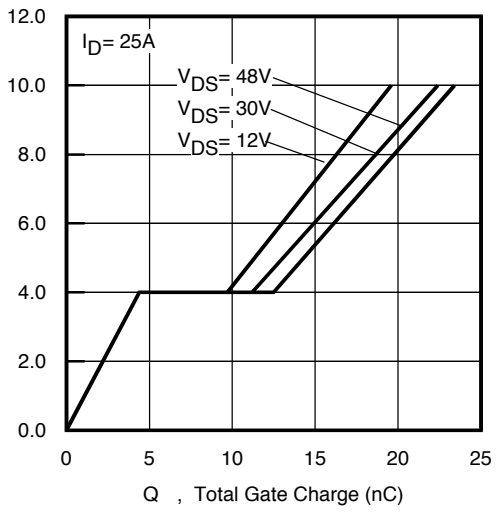
[picture p82: figure]
tal Ga; e Charge (nC)

### VGS, Gate-to S- ource Voltage V( )
