NxRLab/gibbot/Documentation/Reports/PCB Documentation/images/qg2.pdf

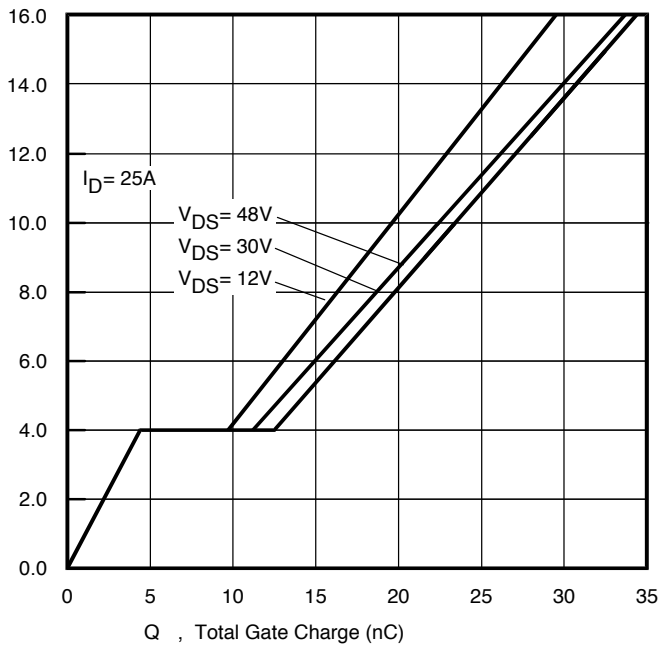
[picture p83: figure]
tal Ga; e Charge (nC)

### VGS, Gate-to S- ource Voltage V( )
