NxRLab/gibbot/Code/Java_Projects/gui4/images/bananaBubble.png

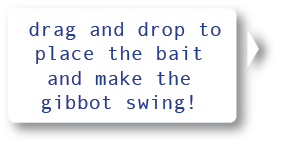
Code/Java_Projects/gui4/images/bananaBubble.png
