NxRLab/gibbot/Code/Java_Projects/gui4/images/batteryArrow.png

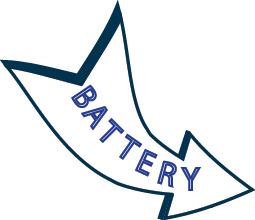
Code/Java_Projects/gui4/images/batteryArrow.png
