NxRLab/gibbot/Code/Java_Projects/gui4/images/batteryBar.png

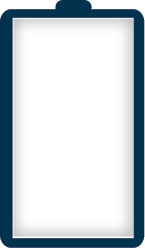
Code/Java_Projects/gui4/images/batteryBar.png
