NxRLab/gibbot/Code/Java_Projects/gui4/images/bicep.png

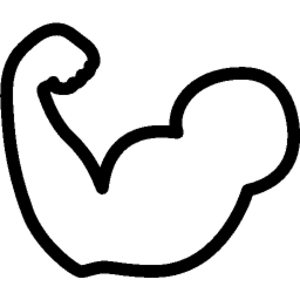
Code/Java_Projects/gui4/images/bicep.png
