NxRLab/gibbot/Code/Java_Projects/gui4/images/board.png

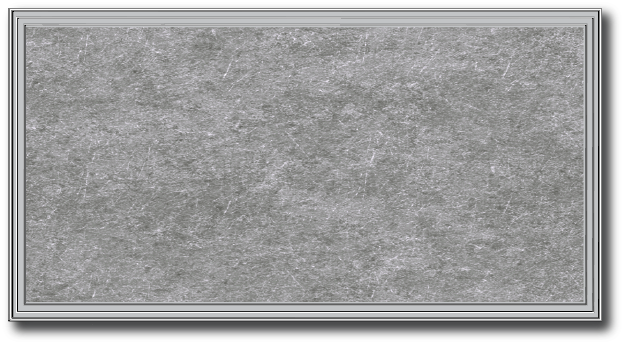
Code/Java_Projects/gui4/images/board.png
