NxRLab/gibbot/Code/Java_Projects/gui4/images/gibbotBubble.png

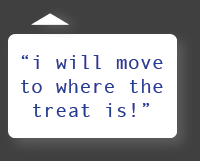
Code/Java_Projects/gui4/images/gibbotBubble.png
