NxRLab/gibbot/Code/Java_Projects/gui4/images/gibbotTab1.png

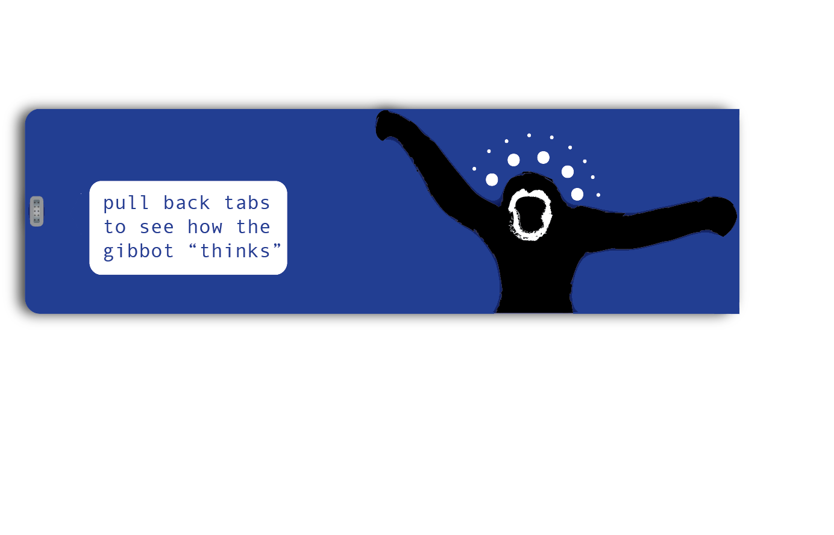
Code/Java_Projects/gui4/images/gibbotTab1.png
