NxRLab/gibbot/Code/Java_Projects/gui4/images/gibbotTab2.png

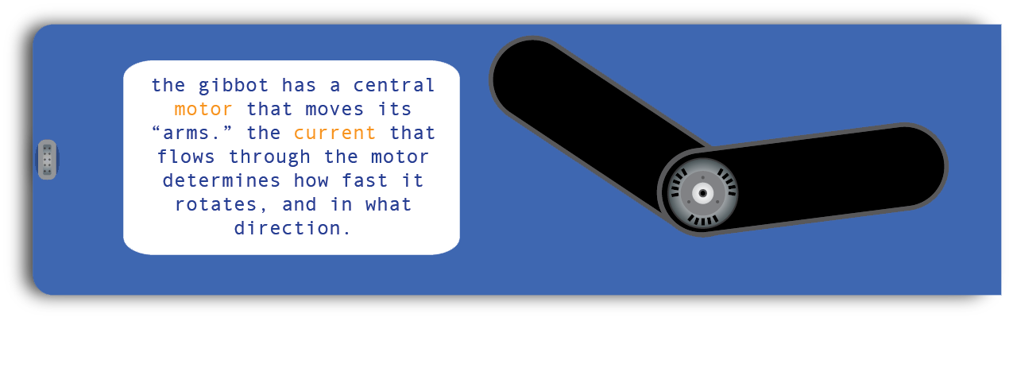
Code/Java_Projects/gui4/images/gibbotTab2.png
