NxRLab/gibbot/Code/Java_Projects/gui4/images/gibbotTab3.png

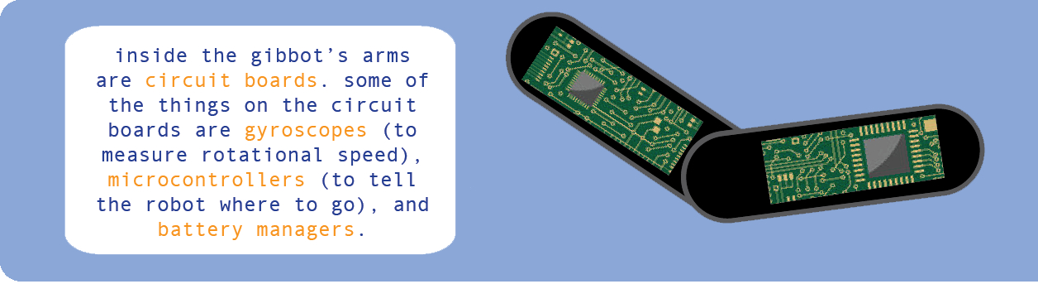
Code/Java_Projects/gui4/images/gibbotTab3.png
