NxRLab/gibbot/Code/Java_Projects/gui4/images/jungle.png

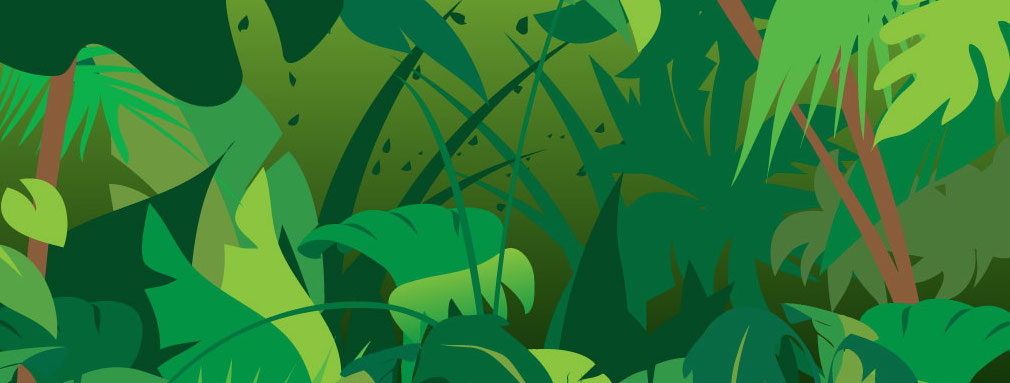
Code/Java_Projects/gui4/images/jungle.png
