NxRLab/gibbot/Code/Java_Projects/gui4/images/sleepBubble.png

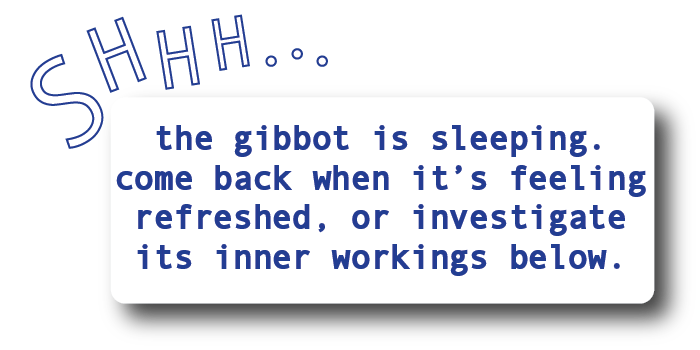
Code/Java_Projects/gui4/images/sleepBubble.png
