NxRLab/gibbot/Code/Java_Projects/gui4/images/speedometer.png

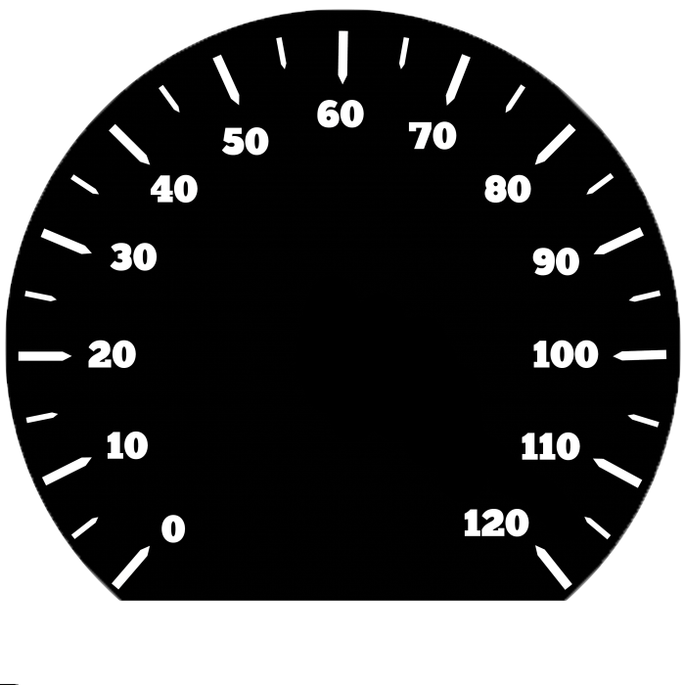
Code/Java_Projects/gui4/images/speedometer.png
