NxRLab/gibbot/Code/Java_Projects/gui4/images/thermometer.png

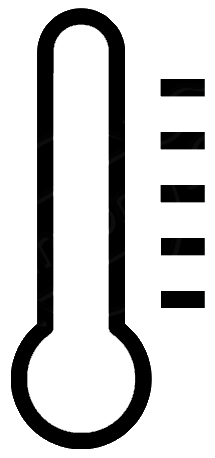
Code/Java_Projects/gui4/images/thermometer.png
