NxRLab/gibbot/Documentation/Images/Other/4 Attempts at Bridge.JPG

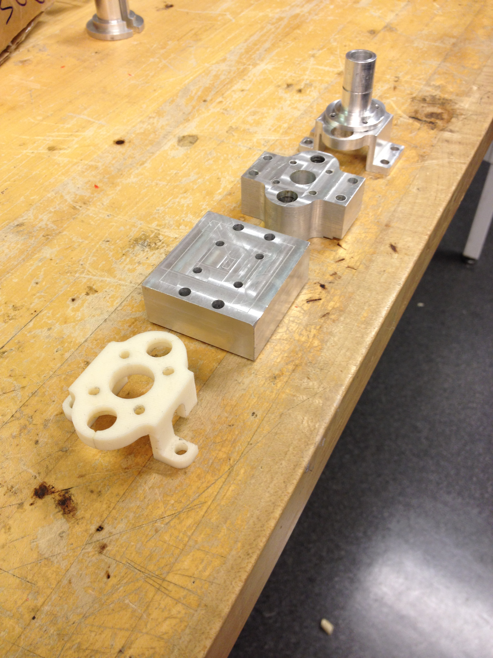
Documentation/Images/Other/4 Attempts at Bridge.JPG
