NxRLab/gibbot/Documentation/Images/Other/4 Attempts of Bridge.JPG

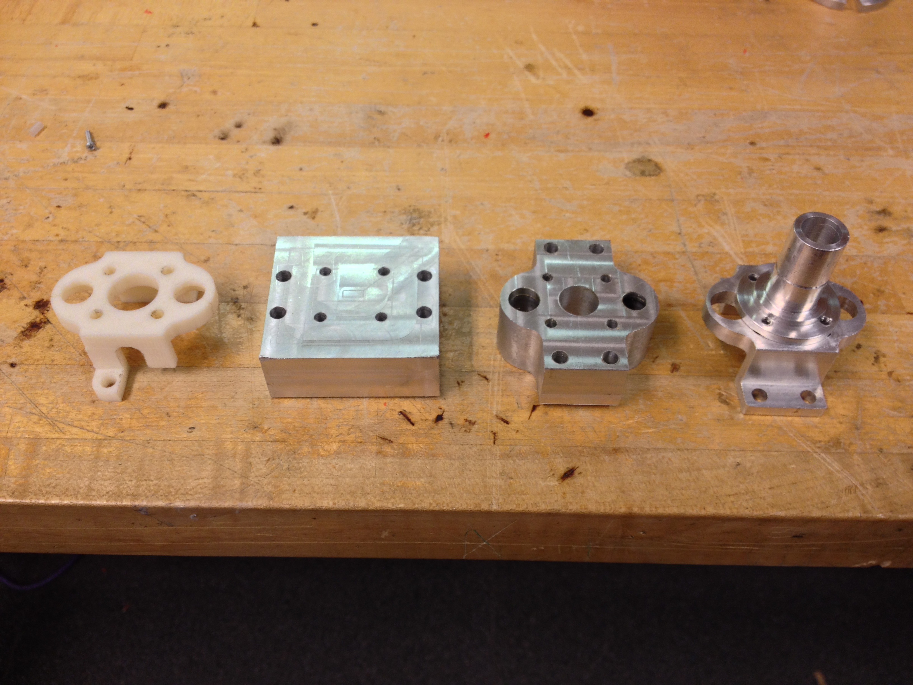
Documentation/Images/Other/4 Attempts of Bridge.JPG
