NxRLab/gibbot/Documentation/Images/Other/Frame.JPG

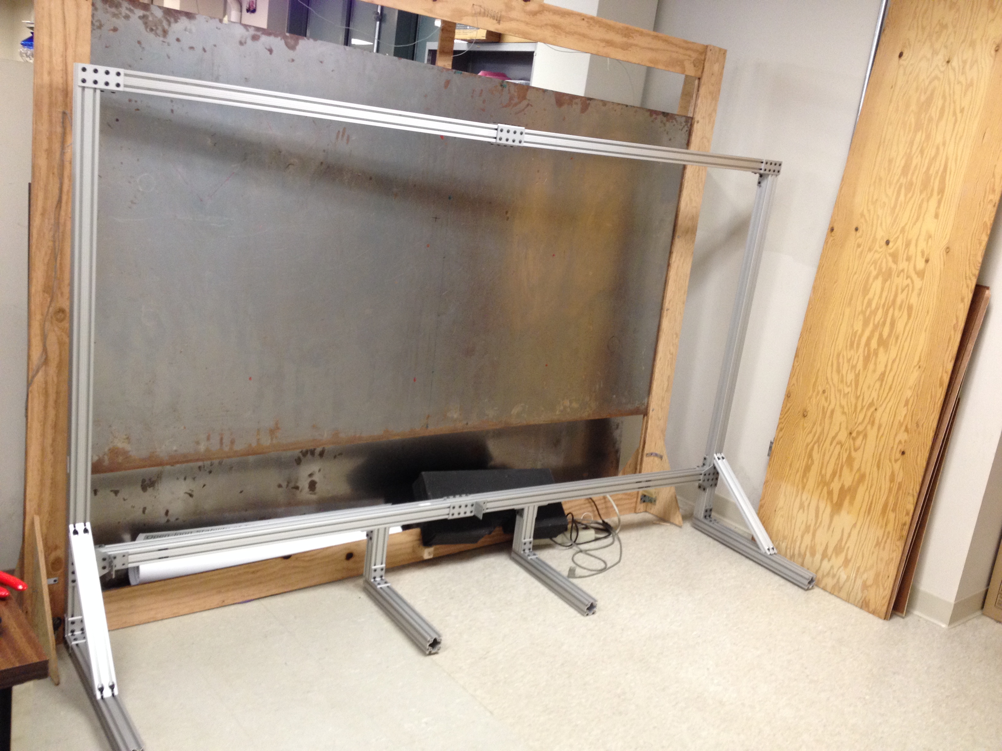
Documentation/Images/Other/Frame.JPG
