NxRLab/gibbot/Documentation/Images/Other/Wall Whiteboard Design.JPG

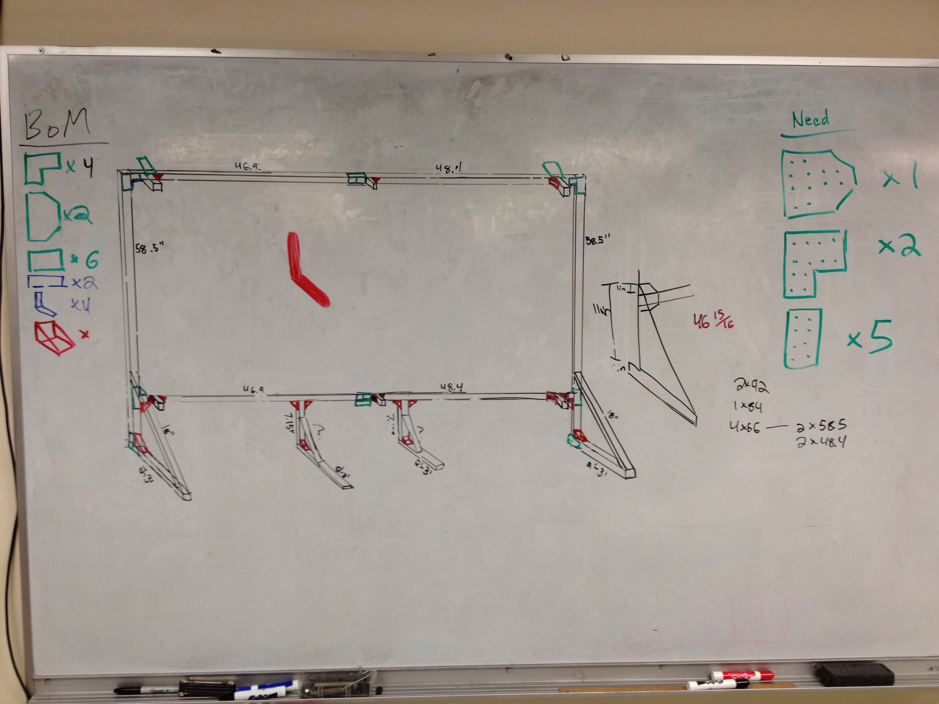
Documentation/Images/Other/Wall Whiteboard Design.JPG
