NxRLab/gibbot/Documentation/Images/PCBs/BLDC Driver Prototype 1.JPG

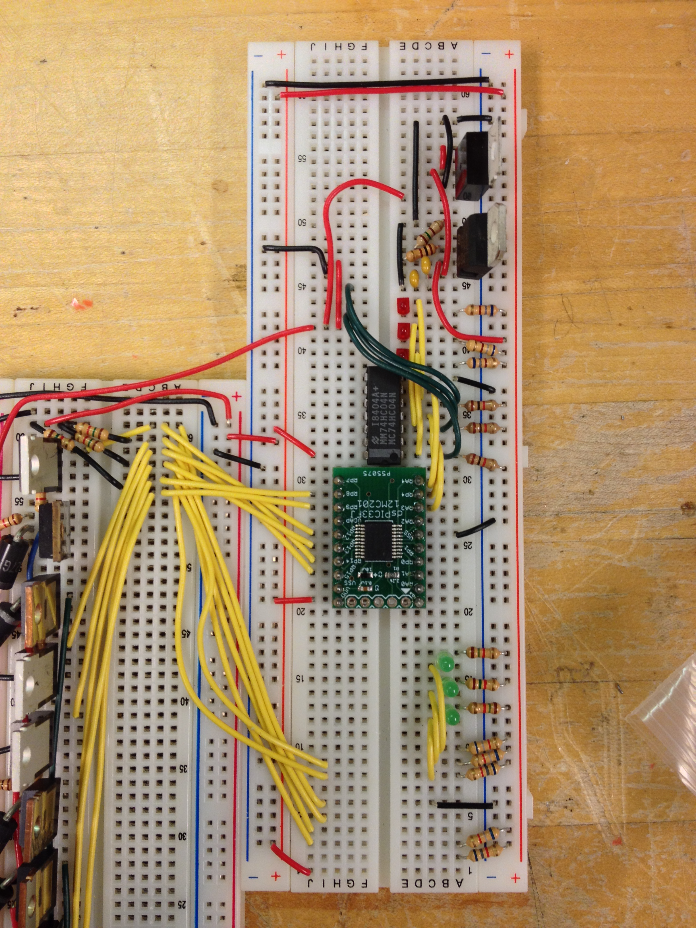
Documentation/Images/PCBs/BLDC Driver Prototype 1.JPG
