NxRLab/gibbot/Documentation/Images/PCBs/BLDC Driver Prototype 2.JPG

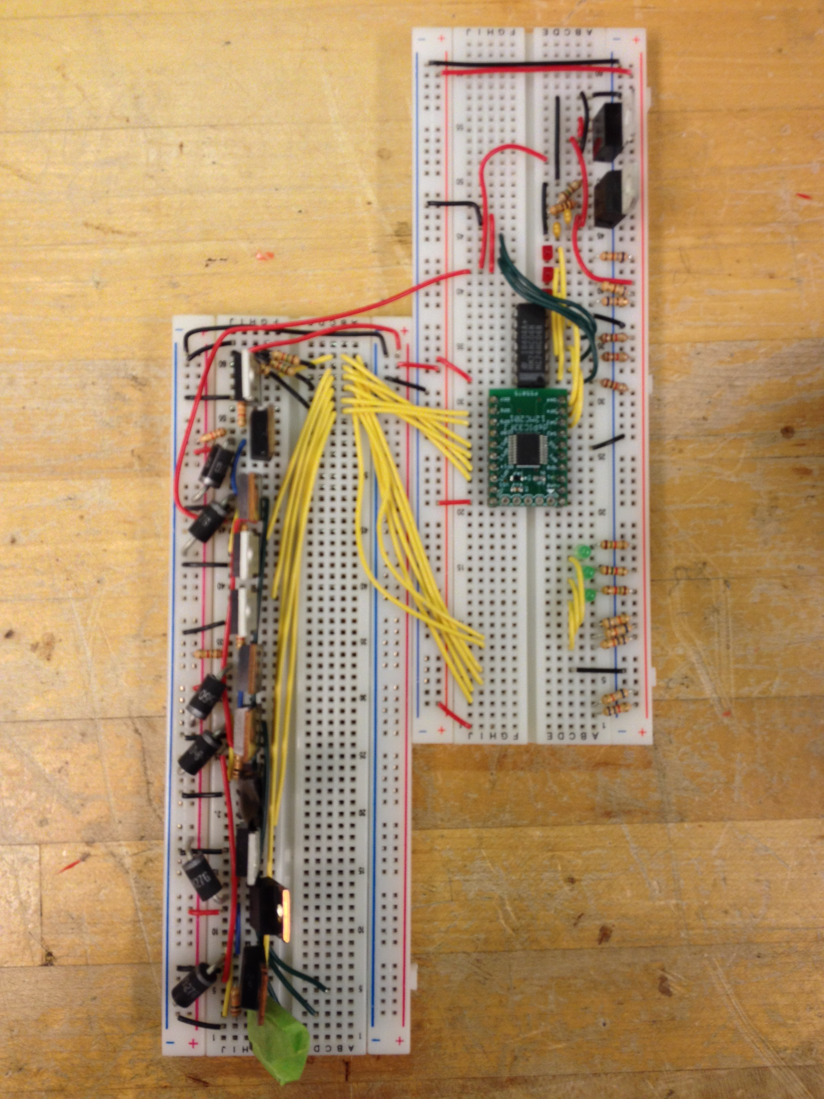
Documentation/Images/PCBs/BLDC Driver Prototype 2.JPG
