NxRLab/gibbot/Documentation/Images/PCBs/BLDC Driver Prototype.JPG

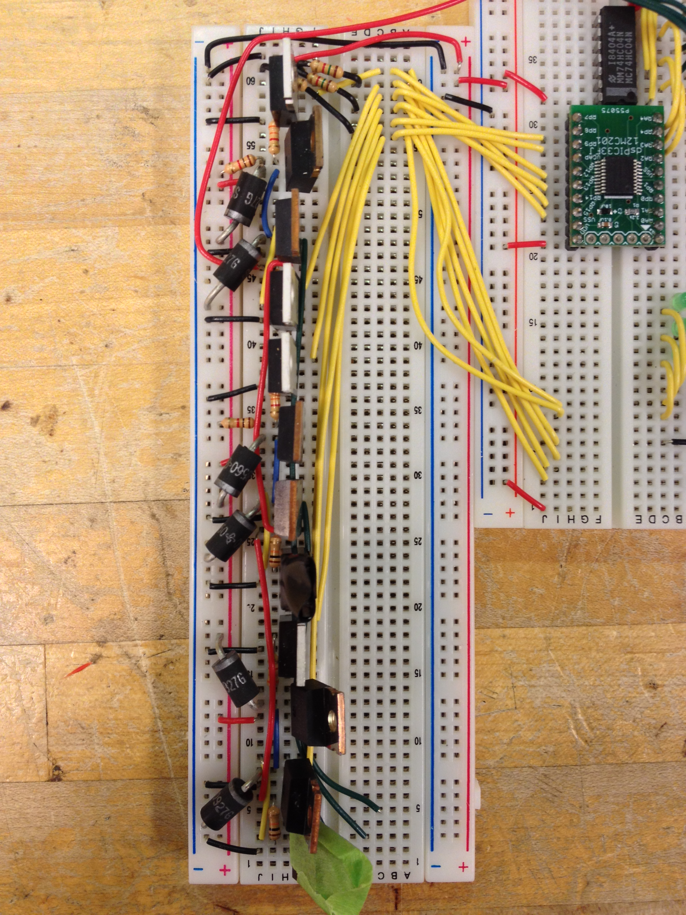
Documentation/Images/PCBs/BLDC Driver Prototype.JPG
