NxRLab/gibbot/Documentation/Images/PCBs/IMG_1069.JPG

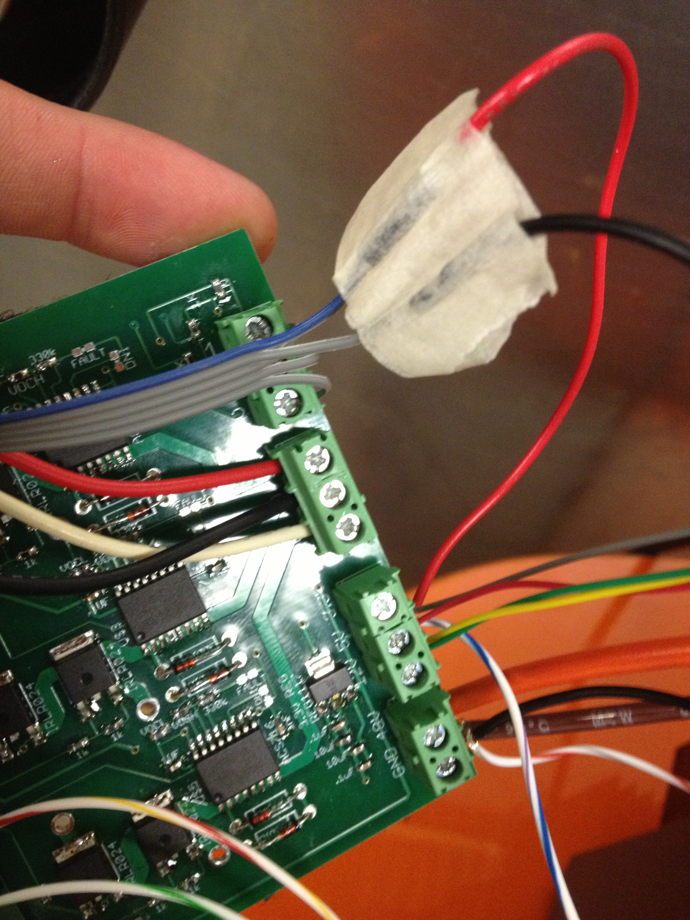
Documentation/Images/PCBs/IMG_1069.JPG
