NxRLab/gibbot/Documentation/Images/PCBs/PCB v3 Blown Capacitor.JPG

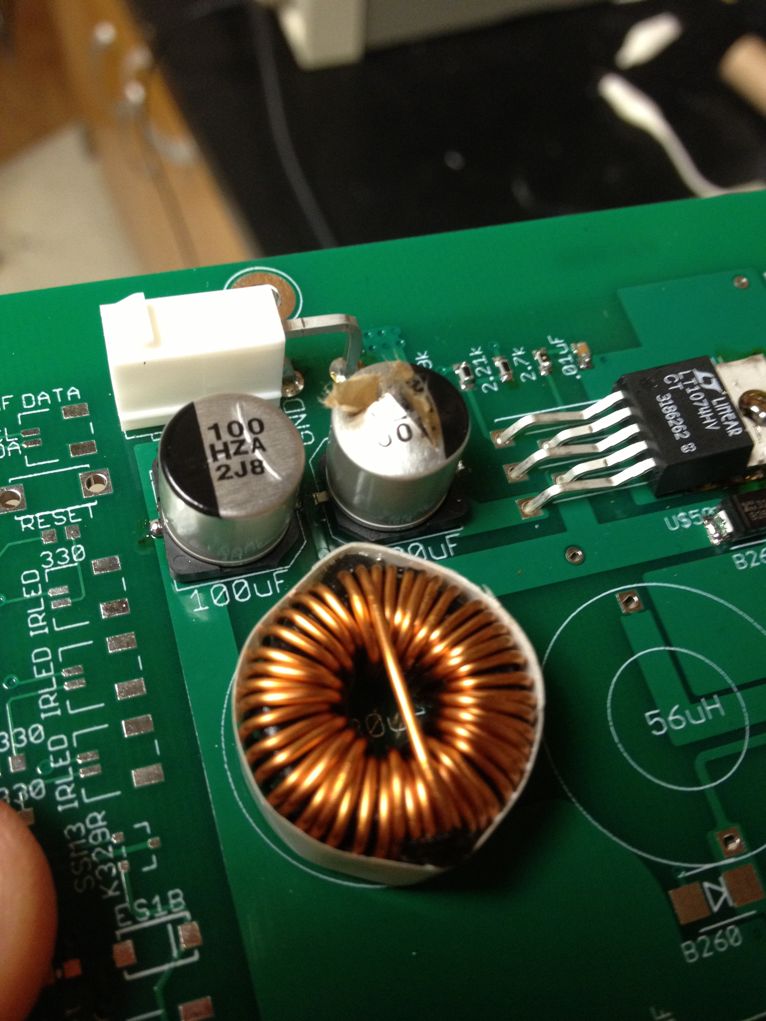
Documentation/Images/PCBs/PCB v3 Blown Capacitor.JPG
