NxRLab/gibbot/Documentation/Images/PCBs/PCB v3 Power Circuitry.JPG

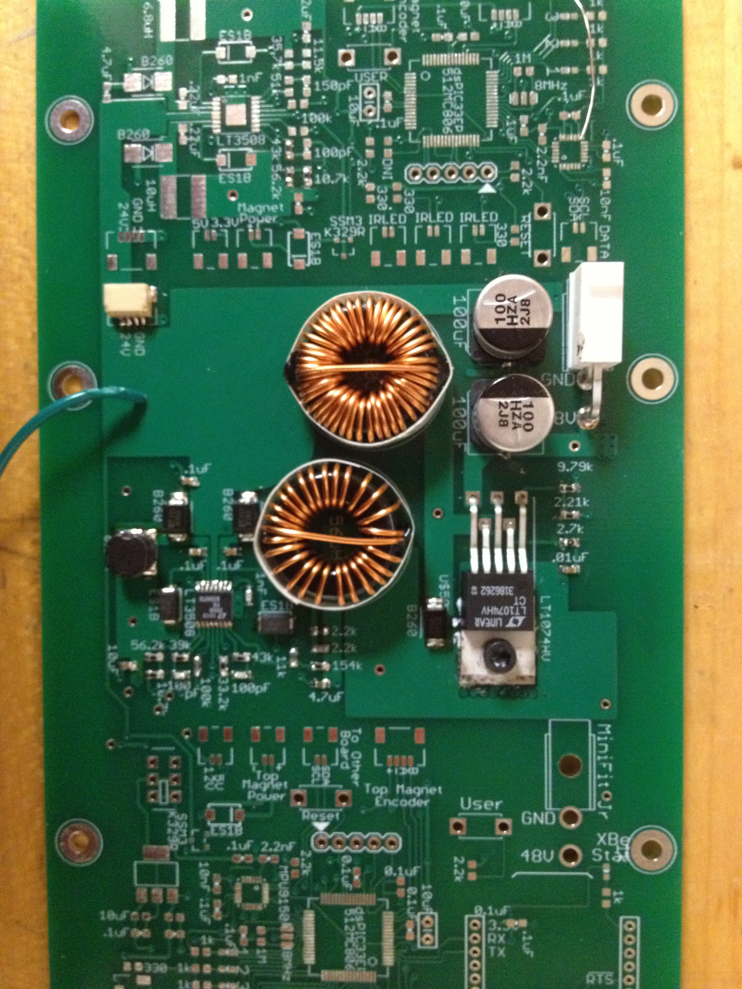
Documentation/Images/PCBs/PCB v3 Power Circuitry.JPG
