NxRLab/gibbot/Documentation/Images/PCBs/PCB v3b 2.JPG

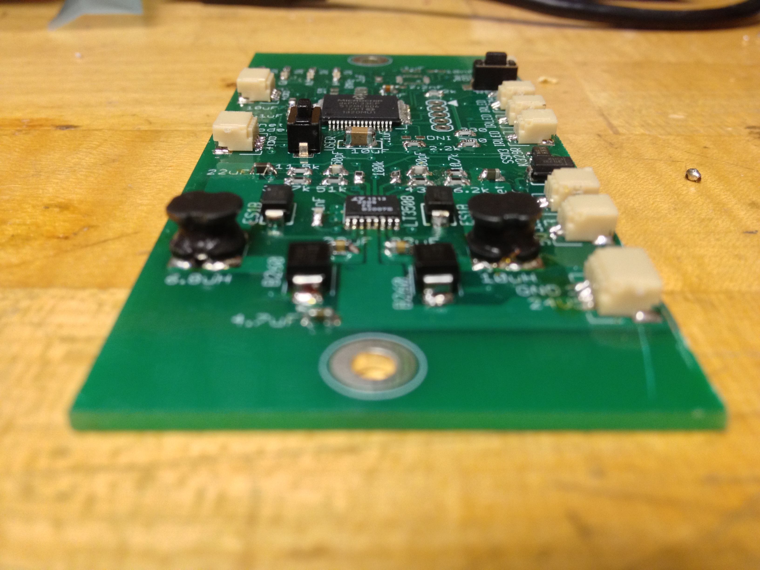
Documentation/Images/PCBs/PCB v3b 2.JPG
