NxRLab/gibbot/Documentation/Images/PCBs/PCB v3b 3.JPG

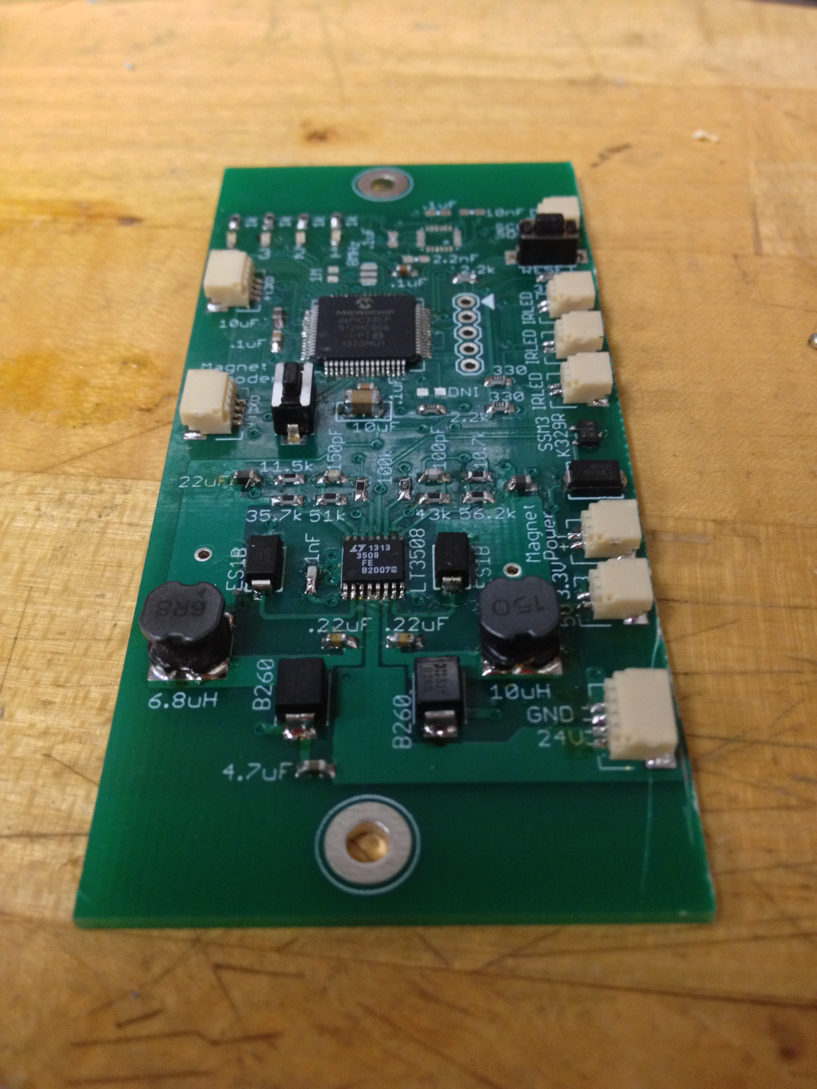
Documentation/Images/PCBs/PCB v3b 3.JPG
