NxRLab/gibbot/Documentation/Images/PCBs/PCB v3b.JPG

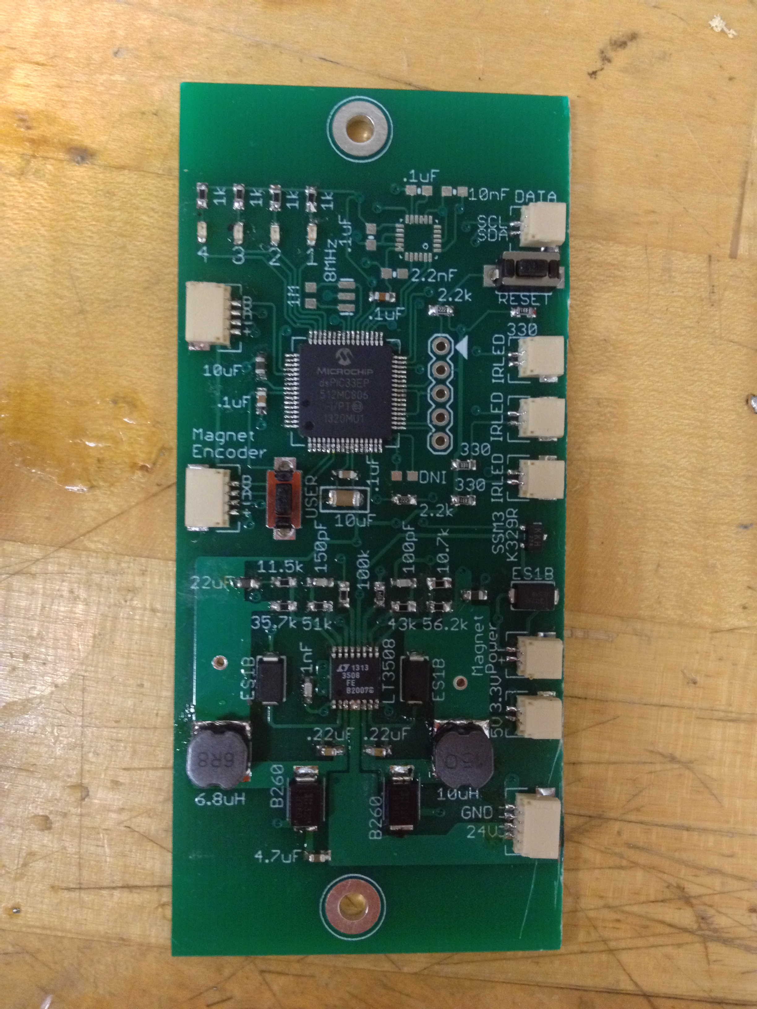
Documentation/Images/PCBs/PCB v3b.JPG
