NxRLab/gibbot/Documentation/Images/Scope Pictures/TEK00004.PNG

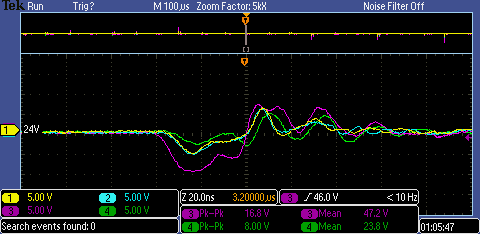
Documentation/Images/Scope Pictures/TEK00004.PNG
