NxRLab/gibbot/Documentation/Images/Scope Pictures/TEK00005.PNG

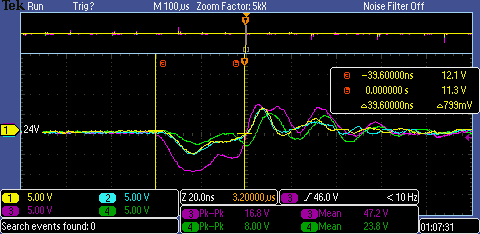
Documentation/Images/Scope Pictures/TEK00005.PNG
