NxRLab/gibbot/Documentation/Images/Scope Pictures/TEK00006.PNG

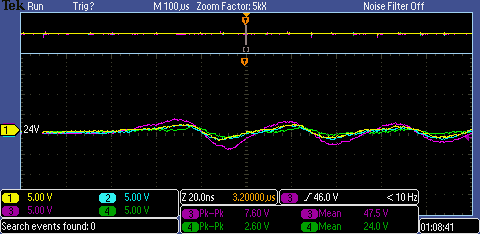
Documentation/Images/Scope Pictures/TEK00006.PNG
