NxRLab/gibbot/Documentation/Images/Scope Pictures/TEK00008.PNG

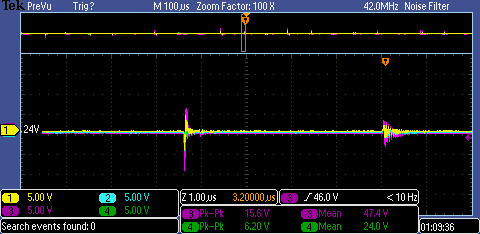
Documentation/Images/Scope Pictures/TEK00008.PNG
