NxRLab/gibbot/Documentation/Images/Scope Pictures/TEK00009.PNG

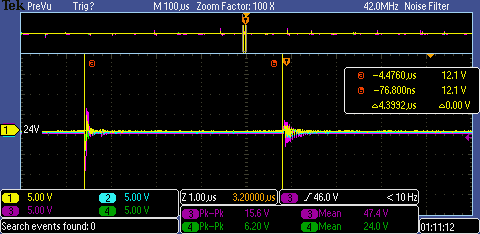
Documentation/Images/Scope Pictures/TEK00009.PNG
