NxRLab/gibbot/Documentation/Images/Scope Pictures/TEK00010.PNG

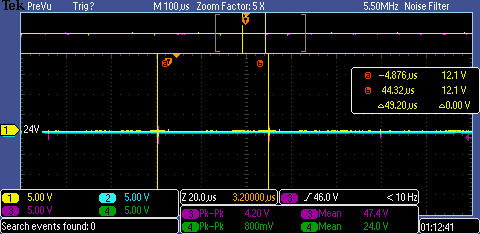
Documentation/Images/Scope Pictures/TEK00010.PNG
