NxRLab/gibbot/Documentation/Images/Scope Pictures/TEK00012.PNG

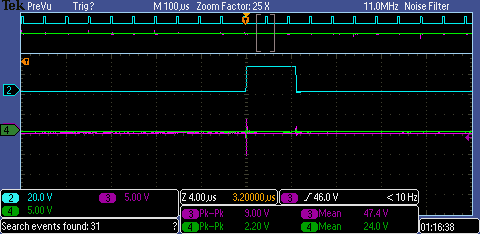
Documentation/Images/Scope Pictures/TEK00012.PNG
