NxRLab/gibbot/Documentation/Images/Scope Pictures/TEK00014.PNG

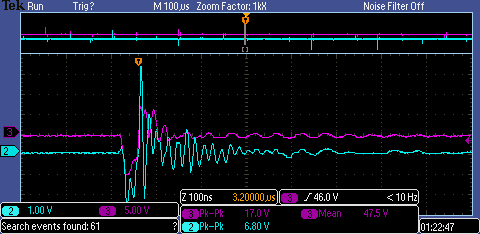
Documentation/Images/Scope Pictures/TEK00014.PNG
