NxRLab/gibbot/Documentation/Images/Wiki/dspic.png

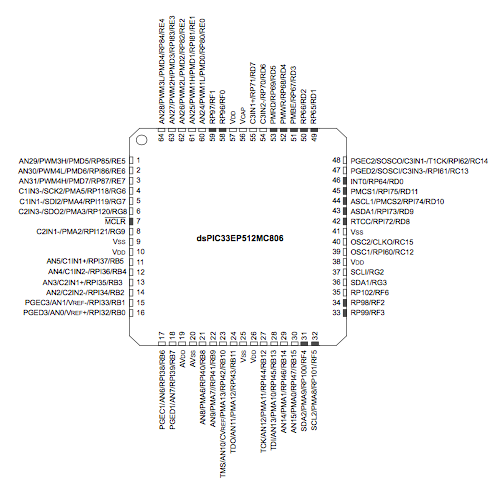
Documentation/Images/Wiki/dspic.png
