NxRLab/gibbot/Documentation/Images/Wiki/Gibbot Power Path 2.png

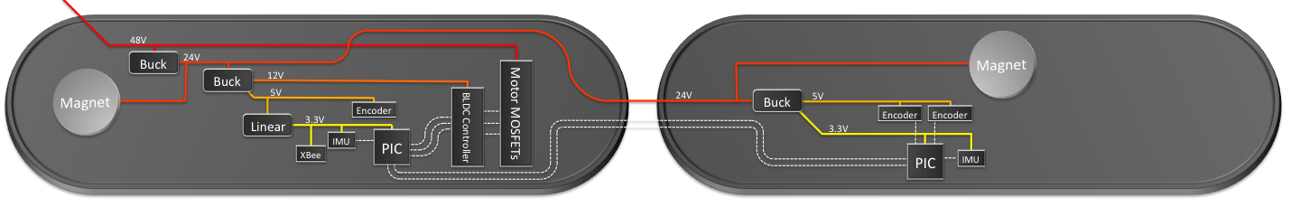
Documentation/Images/Wiki/Gibbot Power Path 2.png
