NxRLab/gibbot/Documentation/Images/Wiki/GroundPath.png

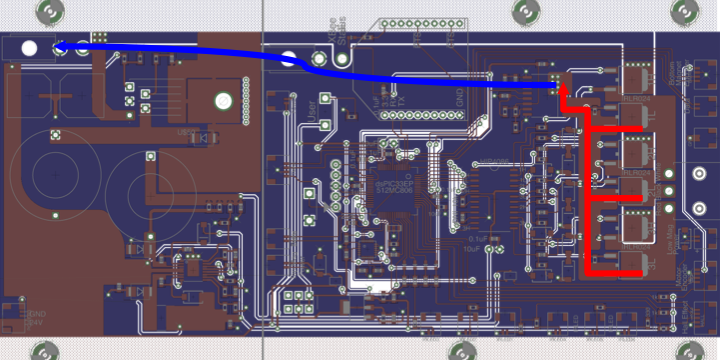
Documentation/Images/Wiki/GroundPath.png
