NxRLab/gibbot/Documentation/Images/Wiki/LT1074SampleCircuit.png

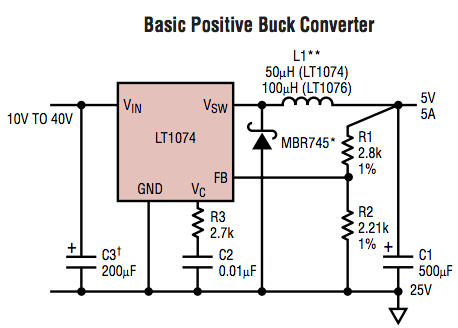
Documentation/Images/Wiki/LT1074SampleCircuit.png
