NxRLab/gibbot/Frame/CAD v3/9.4in. Frame/Pictures/4.1.14-4.PNG

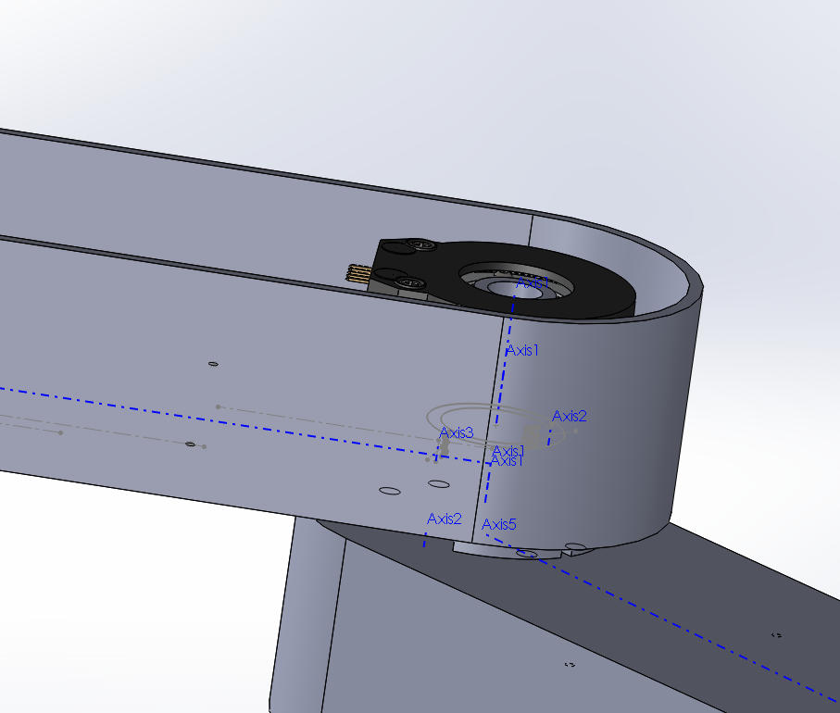
Frame/CAD v3/9.4in. Frame/Pictures/4.1.14-4.PNG
