NxRLab/gibbot/Frame/CAD v3/9.4in. Frame/Pictures/4.2.14-1.PNG

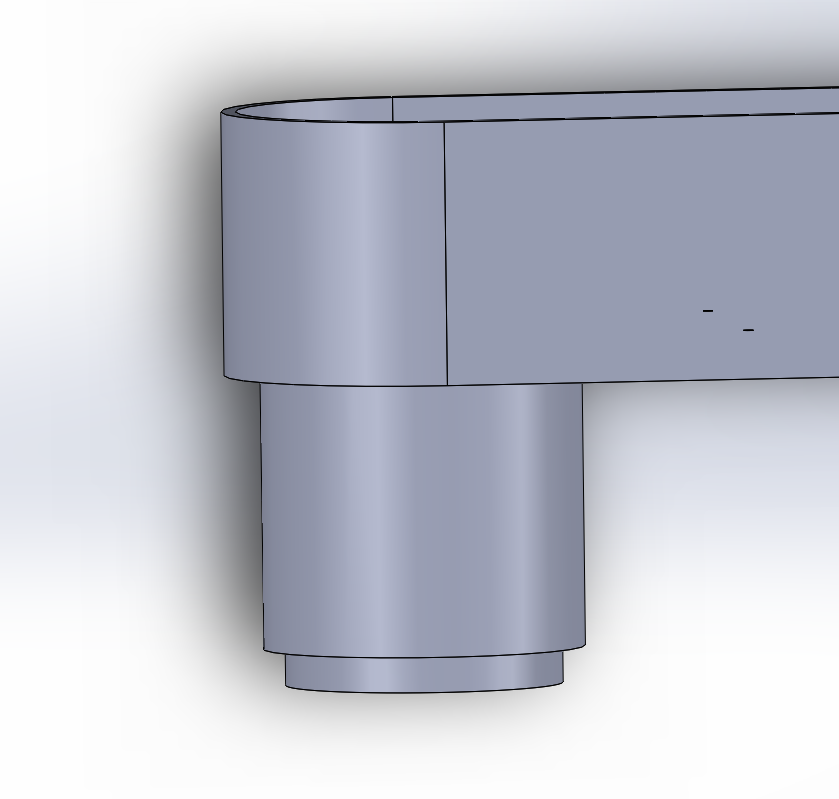
Frame/CAD v3/9.4in. Frame/Pictures/4.2.14-1.PNG
