NxRLab/gibbot/Frame/CAD v3/9.4in. Frame/Pictures/4.2.14-2.PNG

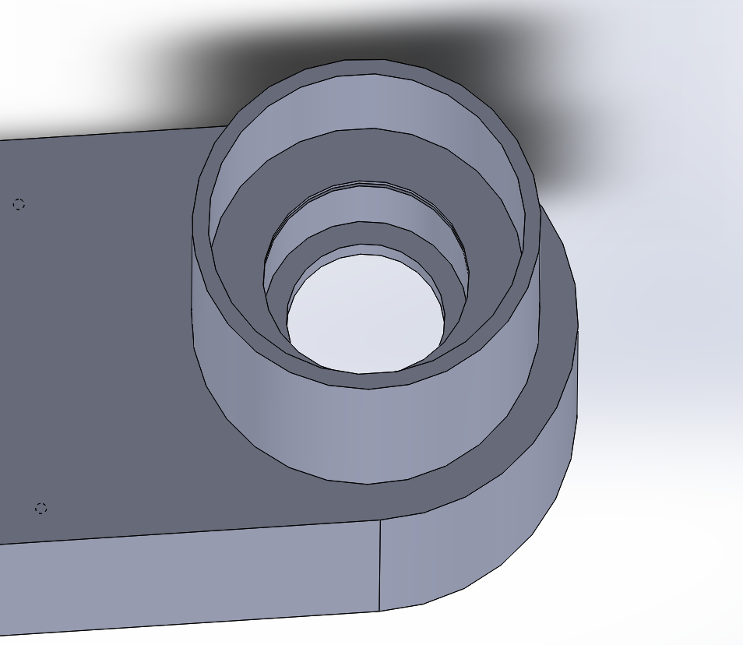
Frame/CAD v3/9.4in. Frame/Pictures/4.2.14-2.PNG
