NxRLab/gibbot/Frame/CAD v3/9.4in. Frame/Pictures/4.4.14 - M322M1-0600.PNG

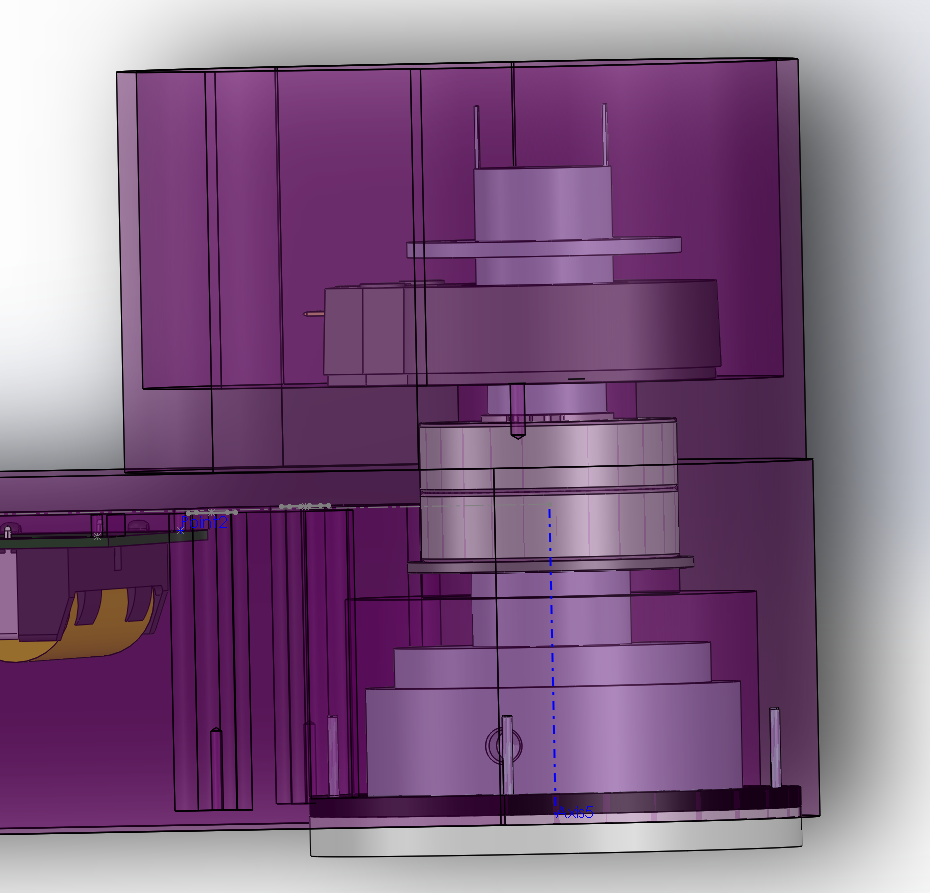
Frame/CAD v3/9.4in. Frame/Pictures/4.4.14 - M322M1-0600.PNG
