NxRLab/gibbot/Frame/CAD v3/9.4in. Frame/Pictures/Combined Carrier and Shaft 3.31.14.PNG

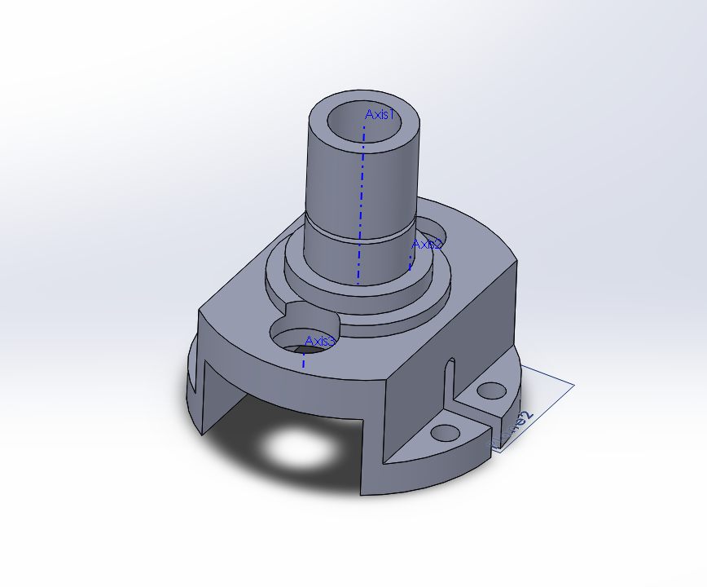
Frame/CAD v3/9.4in. Frame/Pictures/Combined Carrier and Shaft 3.31.14.PNG
