NxRLab/gibbot/Frame/Frame v4/POWERPOINT/Pictures/Motor Link Section View.JPG

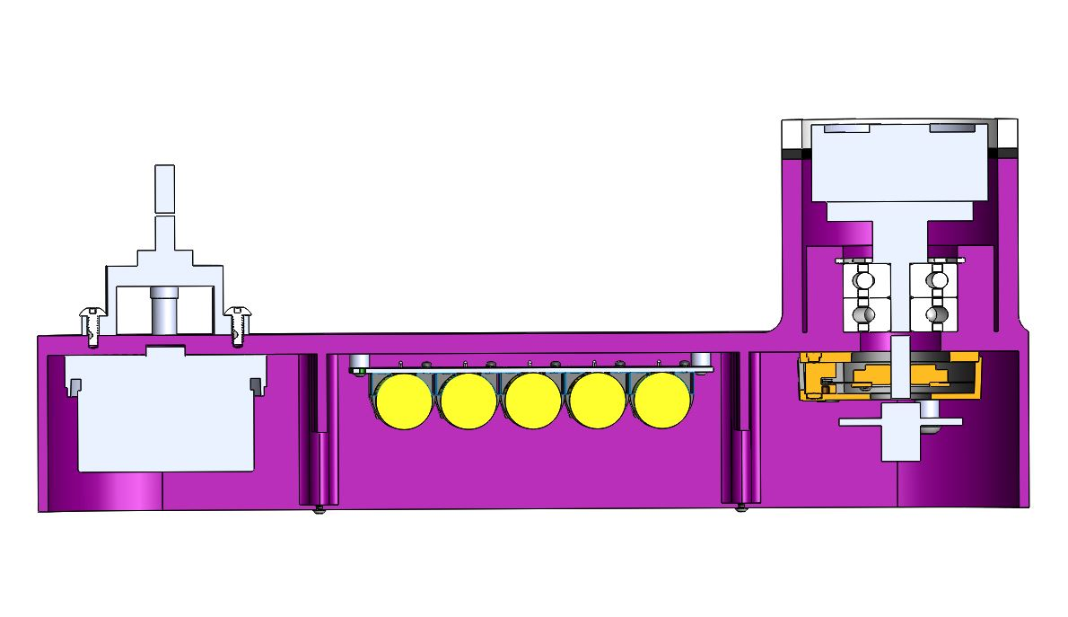
Frame/Frame v4/POWERPOINT/Pictures/Motor Link Section View.JPG
