NxRLab/gibbot/Frame/Frame v4/POWERPOINT/Pictures/Motor link.JPG

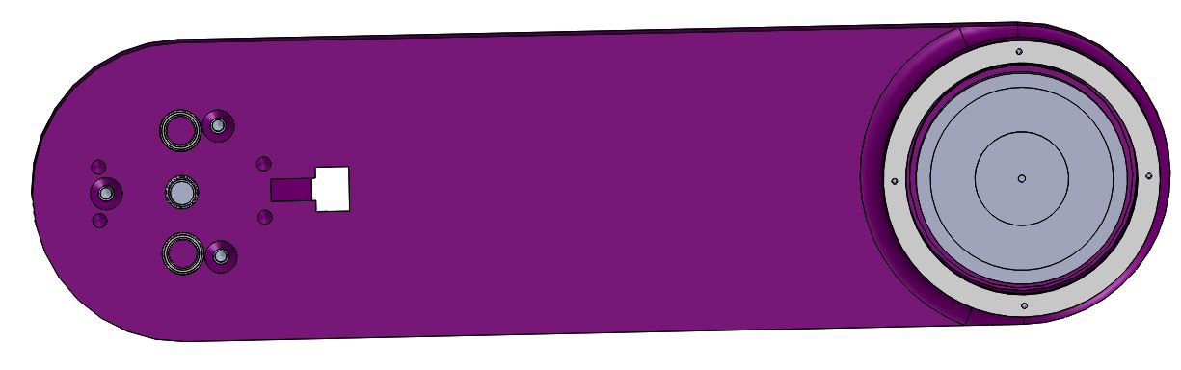
Frame/Frame v4/POWERPOINT/Pictures/Motor link.JPG
