NxRLab/gibbot/WebApp/bunch.png

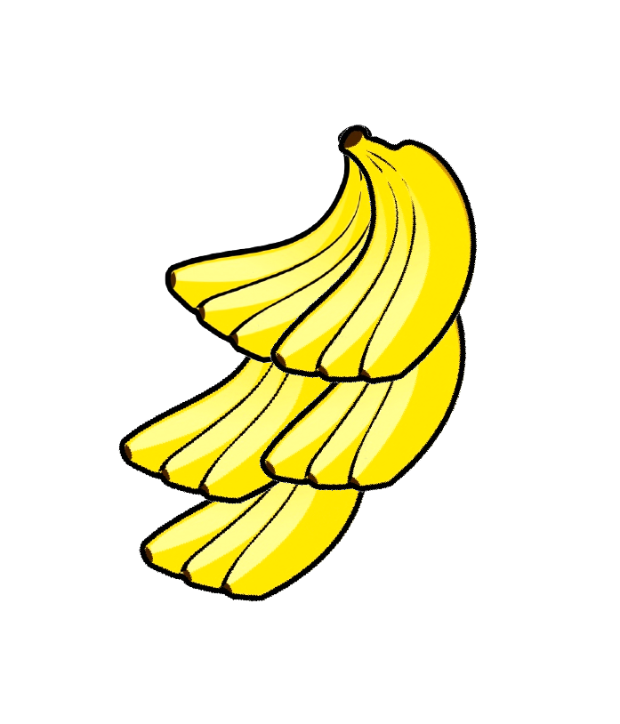
WebApp/bunch.png
