NxRLab/gibbot/WebApp/gibbon.jpeg

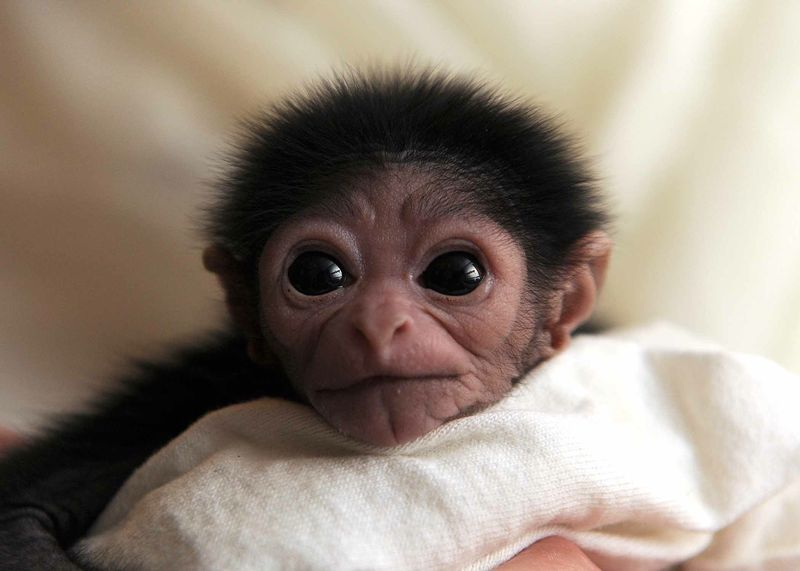
WebApp/gibbon.jpeg
