NxRLab/gibbot/WebApp/NEW WEBSITE/images/4.jpg

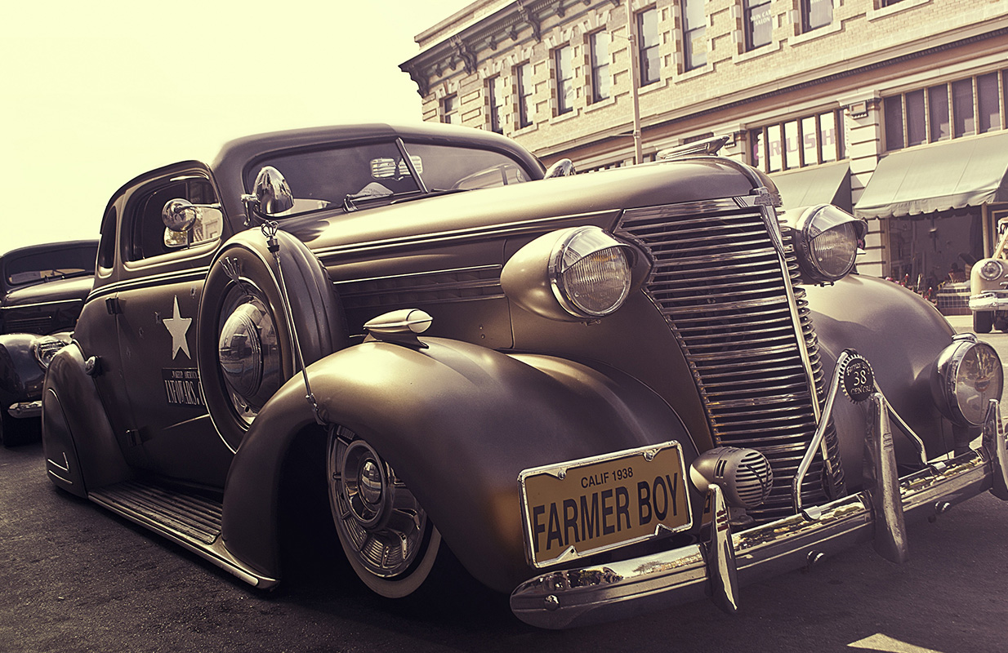
WebApp/NEW WEBSITE/images/4.jpg
