NxRLab/gibbot/WebApp/NEW WEBSITE/images/5.jpg

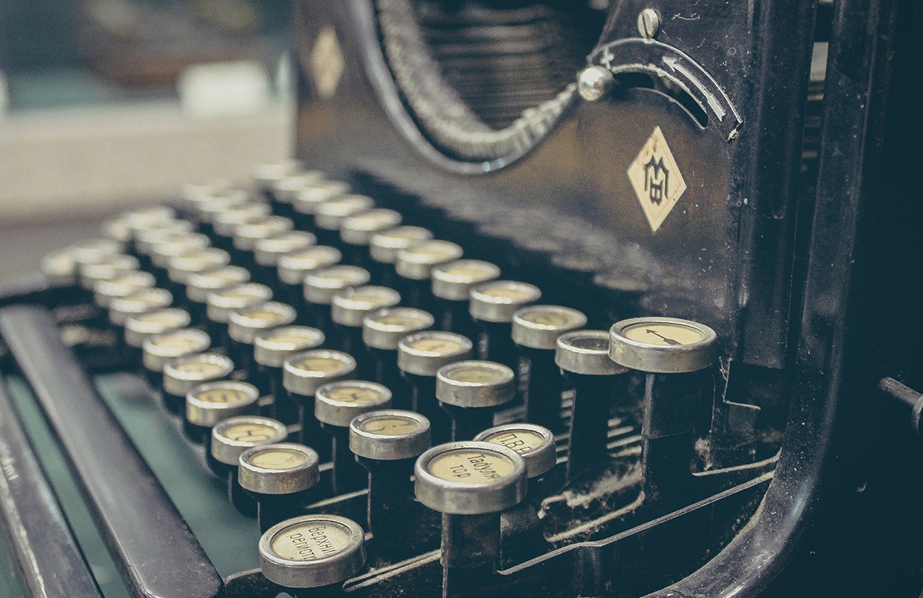
WebApp/NEW WEBSITE/images/5.jpg
