NxRLab/gibbot/WebApp/NEW WEBSITE/images/map.jpg

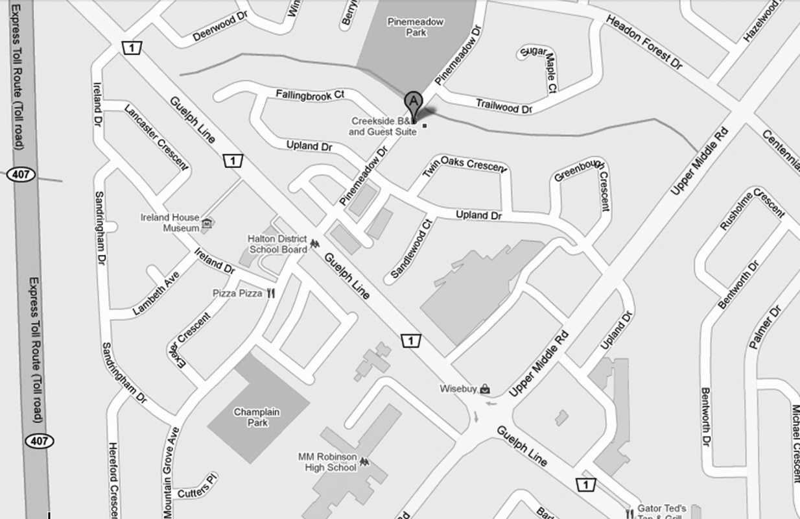
WebApp/NEW WEBSITE/images/map.jpg
