NxRLab/gibbot/WebApp/NEW WEBSITE/images/portfolio/1.jpg

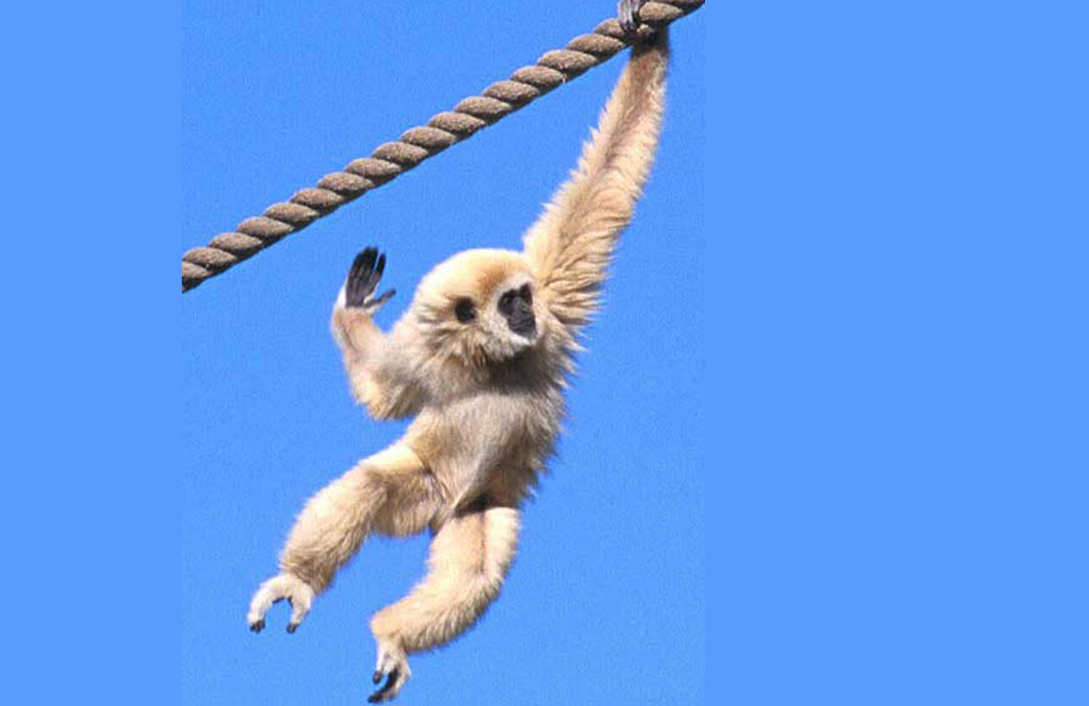
WebApp/NEW WEBSITE/images/portfolio/1.jpg
