NxRLab/gibbot/WebApp/NEW WEBSITE/images/portfolio/2.jpg

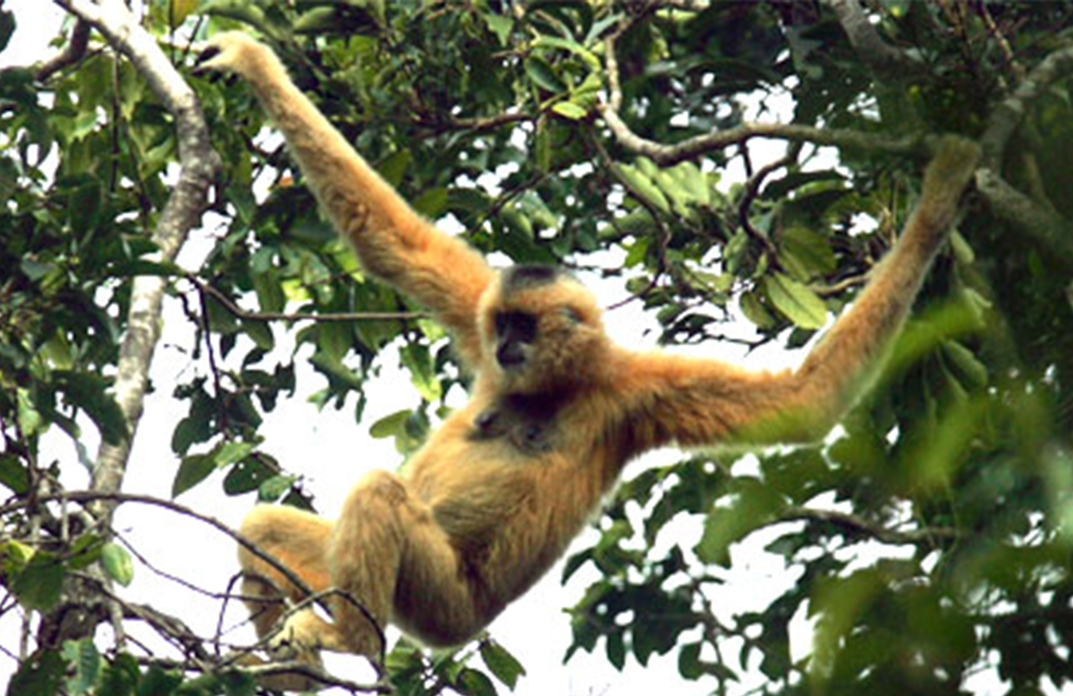
WebApp/NEW WEBSITE/images/portfolio/2.jpg
