NxRLab/gibbot/WebApp/NEW WEBSITE/images/portfolio/3.jpg

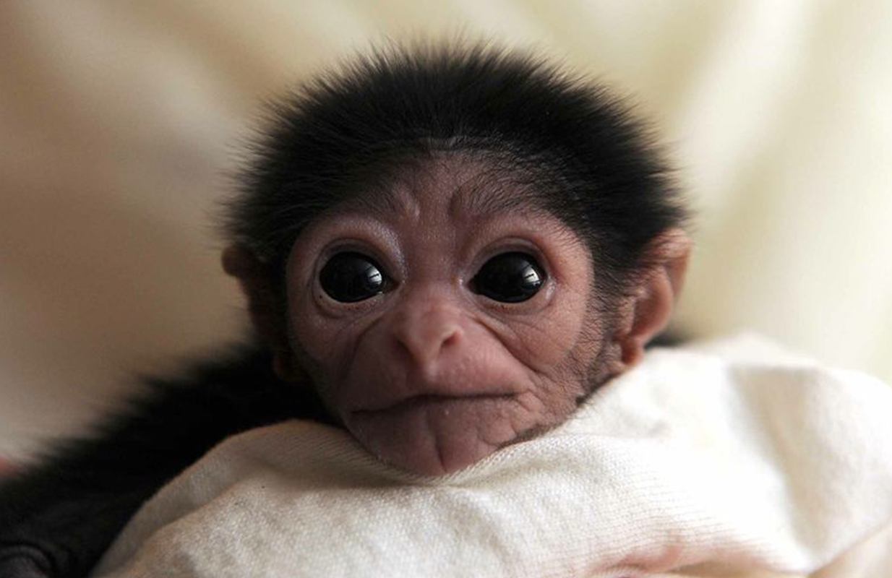
WebApp/NEW WEBSITE/images/portfolio/3.jpg
