NxRLab/gibbot/WebApp/NEW WEBSITE/images/portfolio/4.jpg

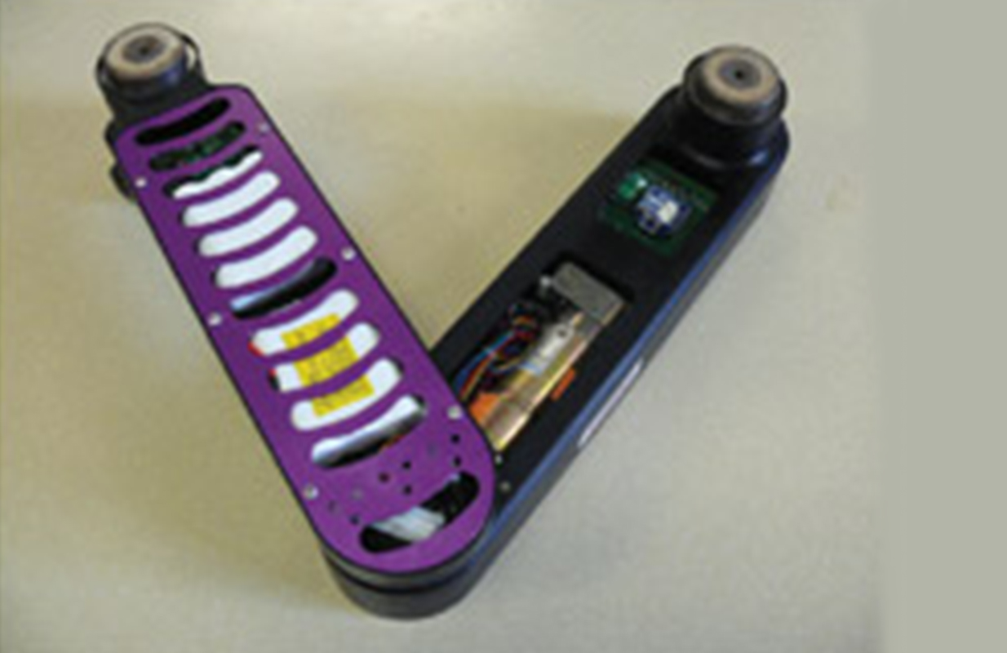
WebApp/NEW WEBSITE/images/portfolio/4.jpg
