NxRLab/gibbot/WebApp/NEW WEBSITE/images/portfolio/5.jpg

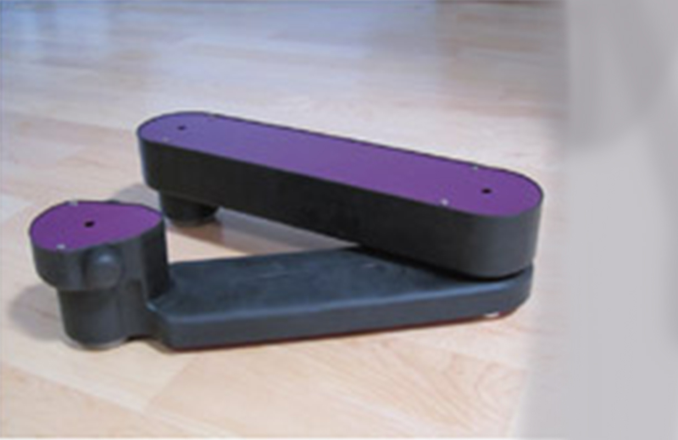
WebApp/NEW WEBSITE/images/portfolio/5.jpg
