NxRLab/gibbot/WebApp/NEW WEBSITE/images/portfolio/6.jpg

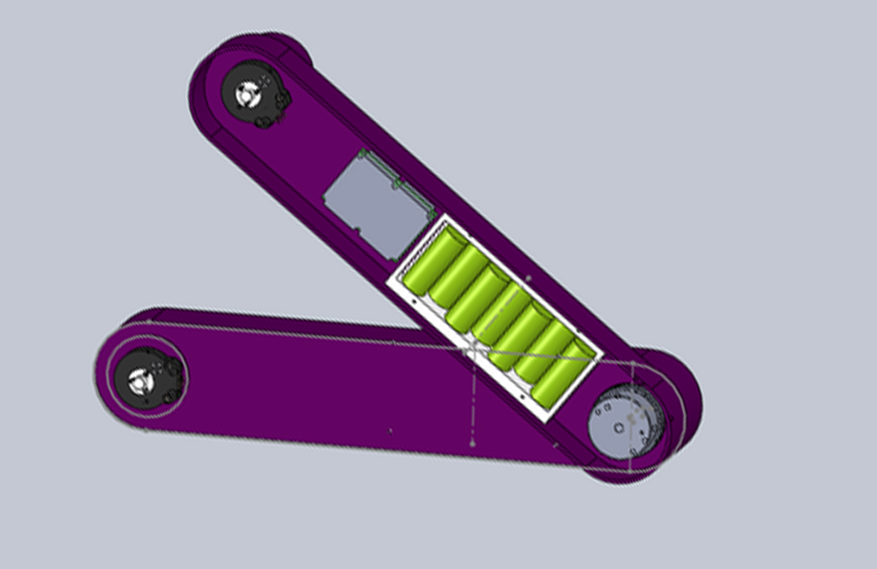
WebApp/NEW WEBSITE/images/portfolio/6.jpg
