NxRLab/gibbot/WebApp/NEW WEBSITE/jungle.png

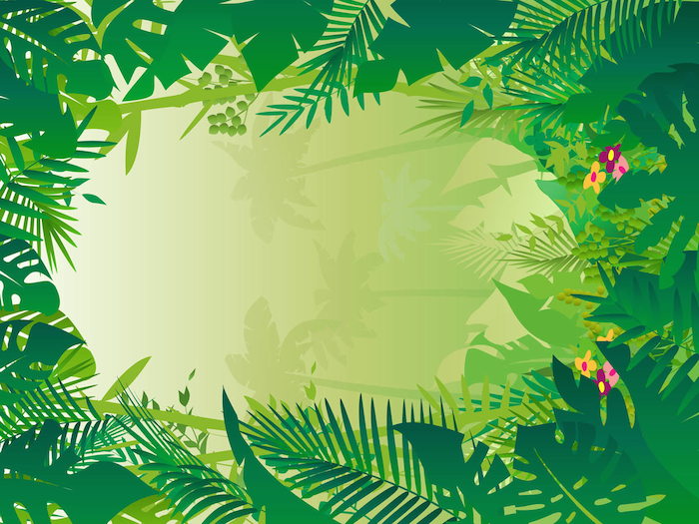
WebApp/NEW WEBSITE/jungle.png
