NxRLab/gibbot/Documentation/Reports/PCB Documentation/billofmaterials.tex

\newpage
\section{PCB Bill of Materials}
\begin{longtable}{| >{\centering\arraybackslash}p{0.4\textwidth} | c | l |}
\hline 
\textbf{ Part Number} & \textbf{Quantity} &\textbf{Description}\\ \endhead  \hline
\multicolumn{3}{|l|} {\textbf{Microcontrollers \& Sensors}}  \\ \hline
PIC1, PIC2 & 2 & \href{http://www.digikey.com/product-detail/en/DSPIC33EP512MC806-I%2FPT/DSPIC33EP512MC806-I%2FPT-ND/2835084}{DSPIC33EP512MC806}\\ \hline
X1 & 1 & \href{https://www.sparkfun.com/products/8665}{XBee Series 1 Wired Antenna}\\ \hline
CS1 & 1 & \href{http://www.digikey.com/product-detail/en/ACS716KLATR-6BB-T/620-1445-1-ND/2890908}{ACS716KLATR-\textbf{6BB}-T Current Sensor}\\ \hline
IMU1, IMU2 & 2 & MPU-9150 (Out of Stock)\\ \hline
& 2 & \href{http://www.digikey.com/product-detail/en/MPU-6000/1428-1005-1-ND/4038006}{MPU-6000 (Replacement)}\\ \hline
MD1 & 1 & \href{http://www.digikey.com/product-detail/en/HIP4086ABZ/HIP4086ABZ-ND/936251}{HIP4086 BLDC Motor Driver}\\ \hline

\multicolumn{3}{|l|} {\textbf{Resistors}}  \\ \hline
R40, R41, R43 & 3 & \href{}{0 ohm} \\ \hline
R70 & 1 & \href{}{3.3 $\Omega$} \\ \hline
R34, R35, R36, R37, R38, R39 & 6 & \href{}{10 $\Omega$} \\ \hline
R25 & 1 & \href{}{22 $\Omega$} \\ \hline
R24 & 1 & \href{}{47 $\Omega$} \\ \hline
R2, R7, R8, R9, R10, R11, R12, R13, R17, R18, R19, R31, R66, R67, R68, R69, R77, R78 & 18 & \href{}{1k $\Omega$} \\ \hline
R1 & 1 & \href{}{2k $\Omega$} \\ \hline
R14, R42, R61, R73  & 4 & \href{}{2.2k $\Omega$} \\ \hline
R16 & 1 & \href{}{10k$\Omega$} \\ \hline
R4, R5, R6 & 3 & \href{}{20k $\Omega$} \\ \hline
R3 & 1 & \href{}{330k $\Omega$} \\ \hline

\multicolumn{3}{|l|} {\textbf{Capacitors}}  \\ \hline
C34, C35, C36, C37, C50, C51, C52, C53, C61 & 9 & \href{}{.01uF 0603} \\ \hline
C1, C11, C12, C13, C21, C22, C25, C26, C28, C29, C31, C32, C33, C38, C40, C41, C42, C43, C54, C55, C56, C57, C59, C60, C62 & 25 & \href{}{.1uF 0603} \\ \hline
C7, C8 & 2 & \href{}{.1uF 0603 25V Rated} \\ \hline
C39 & 1 & \href{}{.1uF 0603 50V Rated} \\ \hline
C6, C46, C47 & 3 & \href{}{.1uF 1206} \\ \hline
C17, C18, C19 & 3 & \href{}{.03uF 0603 16V Rated} \\ \hline
C2 & 1 & \href{}{1nF 0603} \\ \hline
C64 & 1 & \href{}{1uF 1206} \\ \hline
C23, C27 & 2 & \href{}{2.2nF 0603} \\ \hline
C20, C24 & 2 & \href{}{10nF 0603} \\ \hline
C15, C48, C49, C63 & 4 & \href{}{10uF 0603 Polarized} \\ \hline
C5, C30 & 2 & \href{}{10uF 0603} \\ \hline
C14, C44, C45, C58, C65 & 5 & \href{}{10uF 1206} \\ \hline
C66, C67 & 2 & \href{}{10uF 1206} \\ \hline
C4 & 1 & \href{}{22nF 0603} \\ \hline
C9, C10 & 1 & \href{}{22uF 0603 15V Rated} \\ \hline
C3& 1 & \href{}{7nF 0603} \\ \hline

\multicolumn{3}{|l|} {\textbf{Diodes}}  \\ \hline
D1, D2, D3, D4, D5, D7, D8, D9, D10, D11, D12 & 11 & \href{http://www.digikey.com/product-detail/en/ES1B/ES1BFSCT-ND/3042546}{ES1B 100V, 1A}\\ \hline

\multicolumn{3}{|l|} {\textbf{Power Converters}}  \\ \hline
P2 & 1 & \href{http://www.digikey.com/product-search/en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}{24V to 5V DC-DC Converter}\\ \hline
P3 & 1 & \href{http://www.digikey.com/product-search/en?vendor=0&keywords=IFX21004TNV51}{24V to 15V \& 5V Linear Regulator}\\ \hline
P1, P4 & 2 & \href{http://www.digikey.com/product-detail/en/TLV1117LV33DCYR/296-28778-1-ND/2666520}{5V to 3.3V LDO Regulator}\\ \hline
P5 & 1 & \href{http://www.digikey.com/product-detail/en/LM2937IMPX-5.0\%2FNOPB/LM2937IMPX-5.0\%2FNOPBCT-ND/3526931}{15V to 5V Linear Regulator}\\ \hline

\multicolumn{3}{|l|} {\textbf{Digital Isolators}}  \\ \hline
DI2, DI3 & 2 & \href{http://www.digikey.com/scripts/DkSearch/dksus.dll?Detail&itemSeq=147517739&uq=635321171204954916}{1 Channel} \\ \hline 
DI1 & 1 & \href{http://www.digikey.com/product-detail/en/SI8660EC-B-IS1/336-2118-5-ND/2623366}{6 Channel}\\ \hline

\multicolumn{3}{|l|} {\textbf{MOSFETs}}  \\ \hline
1H, 1L, 2H, 2L, 3H, 3L & 6 & \href{http://www.digikey.com/product-detail/en/IRFR3806TRPBF/IRFR3806TRPBFCT-ND/1925534}{IRFR3806}\\ \hline
M1, M2 & 2 & \href{http://www.digikey.com/product-detail/en/SSM3K329R,LF/SSM3K329RLFCT-ND/3522426}{SSM3K329RLFCT-ND, 30V, Logic Level}\\ \hline

\multicolumn{3}{|l|} {\textbf{LEDs}}  \\ \hline
& 12 & 0603 LED\\ \hline

\multicolumn{3}{|l|} {\textbf{Switches \& Buttons}}  \\ \hline
SW1 & 1 & \href{http://www.digikey.com/product-detail/en/MHSS1104/679-1848-ND/1795408}{SPDT Slide Switch}\\ \hline
RESET1, USER1, RESET2, USER2 & 4 & \href{http://www.digikey.com/product-detail/en/MJTP1243/679-2452-ND/1798039}{Momentary, Normally Off, Tactile Switch}\\ \hline

\multicolumn{3}{|l|} {\textbf{Connectors}}  \\ \hline
J1, J6, J7, J8, J9, J14, J15, J20, J21 & 9 & \href{http://www.digikey.com/product-search/en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}{JST PH 2pos Right Angle Header}\\ \hline
& 9+ & \href{http://www.digikey.com/product-search/en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}{JST PH 2pos Housing}\\ \hline
& 5+ & \href{http://www.digikey.com/product-search/en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}{JST KR 2pos IDC}\\ \hline

J4, J13 & 2 & \href{http://www.digikey.com/product-search/en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}{JST PH 3pos Right Angle Header} \\ \hline
& 2+ & \href{http://www.digikey.com/product-search/en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}{JST PH 3pos Housing}\\ \hline
& 5+ & \href{http://www.digikey.com/product-search/en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}{JST KR 3pos IDC}\\ \hline

J2, J17, J18 & 3 & \href{http://www.digikey.com/product-search/en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}{JST PH 4pos Right Angle Header} \\ \hline
& 2 & \href{http://www.digikey.com/product-search/en?s=3742&pv88=6&FV=fff40016\%2Cfff802fc&k=jst+ph&mnonly=0&newproducts=0&ColumnSort=0&page=1&stock=1&quantity=0&ptm=0&fid=0&pageSize=25}{JST PH 4pos Housing}\\ \hline
& 5+ & \href{http://www.digikey.com/product-search/en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}{JST KR 4pos IDC}\\ \hline

J3, J12 & 2 & \href{http://www.digikey.com/product-search/en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}{JST PH 8pos Right Angle Header} \\ \hline
& 2 & \href{http://www.digikey.com/product-search/en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}{JST PH 8pos Housing}\\ \hline
& 2 & \href{http://www.digikey.com/product-search/en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}{JST PH 8pos IDC}\\ \hline

& 40+ & \href{http://www.digikey.com/product-detail/en/SPH-001T-P0.5L/455-2147-1-ND/1634655}{JST PH Contact 22-26AWG}\\ \hline
& 40+ & \href{http://www.digikey.com/product-detail/en/SPH-002T-P0.5S/455-1127-1-ND/527358}{JST PH Contact 24-30AWG}\\ \hline
& 40+ & \href{http://www.digikey.com/product-detail/en/SPH-004T-P0.5S/455-1318-1-ND/608807}{JST PH Contact 28-32AWG}\\ \hline

J10, J11, J16, J19 & 4 & \href{http://www.digikey.com/product-detail/en/SM02B-SRSS-TB(LF)(SN)/455-1802-1-ND/926873}{JST SH/SR 2pos Right Angle Header}\\ \hline
& 4+ & \href{http://www.digikey.com/product-search/en/connectors-interconnects/rectangular-connectors-free-hanging-panel-mount/1442549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}{JST SR 2pos IDC}\\ \hline
J5 & 1 & \href{http://www.digikey.com/product-detail/en/SM05B-SRSS-TB(LF)(SN)/455-1805-1-ND/926876}{JST SH/SR 5pos Right Angle Header}\\ \hline
& 1 & \href{http://www.digikey.com/product-search/en?pv88=24&FV=ffec0cc3\%2Cfff40016%2Cfff802f5&mnonly=0&newproducts=0&ColumnSort=0&page=1&stock=1&quantity=0&ptm=0&fid=0&pageSize=25}{JST SR 5pos IDC}\\ \hline
& 20+ & \href{http://www.digikey.com/product-detail/en/SSH-003T-P0.2/455-1561-1-ND/720818}{JST SH Contacts 28-32AWG}\\ \hline

JP1, JP2, JP3, JP4, JP5 & 5 & \href{http://www.digikey.com/product-detail/en/0039300020/WM21351-ND/930320}{Molex Mini Fit Jr. 2pos Right Angle Header}\\ \hline
 & 5 & \href{http://www.digikey.com/product-detail/en/0039293026/WM3843-ND/2002650}{Molex Mini Fit Jr. 2pos Vertical Header}\\ \hline
 & 5 & \href{http://www.digikey.com/product-detail/en/0039012020/WM3700-ND/61315}{Molex Mini Fit Jr. 2pos Housing}\\ \hline
 
JP6 & 1 & \href{http://www.digikey.com/product-detail/en/0039303035/WM18446-ND/300079}{Molex Mini Fit Jr. 3pos Right Angle Header}\\ \hline
 & 1 & \href{http://www.digikey.com/product-detail/en/0039012020/WM3700-ND/61315}{Molex Mini Fit Jr. 3pos Housing}\\ \hline
 & 15 & \href{http://www.digikey.com/product-detail/en/0039000077/WM3112CT-ND/1643460}{Molex Mini Fit Jr. Contacts 16AWG}\\ \hline
 & 15 & \href{http://www.digikey.com/product-detail/en/0039000038/WM2501CT-ND/467978}{Molex Mini Fit Jr. Contacts 18-24AWG}\\ \hline
 & 15 & \href{http://www.digikey.com/product-detail/en/0039000046/WM2503CT-ND/3028710}{Molex Mini Fit Jr. Contacts 22-28AWG}\\ \hline
 
 \multicolumn{3}{|l|} {\textbf{Miscellaneous}}  \\ \hline
 & 10 & \href{http://www.keyelco.com/product.cfm/Thru-Hole-Mount/1043P/product_id/13958}{18650 Battery Holder}\\ \hline

\end{longtable}
