NxRLab/gibbot/Frame/Frame v4/EXCEL/Gear Selection.xlsx

Sheet: Summary
Selected Gears
 |  | Diametral Pitch | No. Of Teeth | Pressure Angle | Material | Quality Class | Face Width (mm) | Pitch Dia. (mm) | Outside Dia. (mm) | Inside Dia. (mm) |  | Lewis Form Factor | Max Tangential Force | Max Torque On Gear | Torque on Gear | FS
Gear Ratio 6
Ring Gear | S1E08ZM08S120 | 0.8 | 120 | 20 | 303 Stainless Steel | ISO Class 7 | 8 | 96 | 120 | 94.4 |  | 0.446 | 1850.9 | 177.6864 | 25.14 | 7.067875895
 | Part Number | Module ( Pitch) | No. Of Teeth | Material | Hub Style | Quality Class | Pressure Angle | Bore Size | Face Width | Pitch Dia. | Hub Dia. (0 = Hubless)
Sun Gear | S10T08M020S0508 | 0.8 | 20 | 303 Stainless Steel | With Hub & set screw | ISO 7 / AGMA 10 | 20 | 8 | 5 | 16 | 12 | 0.32 | 830 | 13.28 | 4.19 | 3.169451074
Planetary Gear | S1VS08M050F0506 | 0.8 | 50 | 303 Stainless Steel | Fairloc Hub | ISO 7 / AGMA 10 | 20 | 6 | 5 | 40 | 17 | 0.408 | 1058.25 | 42.33 | 10.475 | 4.041050119
Gear Ratio 9
Ring Gear | S1E10ZM10S108 | 1 | 108 | 20 | 303 Stainless Steel | ISO Class 7 | 10 | 108 | 150 | 106 |  | 0.446 | 1850.9 | 199.8972 | 37.71 | 5.300906921
 | Part Number | Module ( Pitch) | No. Of Teeth | Material | Hub Style | Quality Class | Pressure Angle | Bore Size | Face Width | Pitch Dia. | Hub Dia. (0 = Hubless)
Sun Gear | S10T10M012S0508 | 1 | 12 | 303 Stainless Steel | With Hub & set screw | ISO 7 / AGMA 10 | 20 | 8 | 5 | 12 | 12 | 0.245 | 508.375 | 6.1005 | 4.19 | 1.455966587
Planetary Gear | S10T10M048S1010 | 1 | 48 | 303 Stainless Steel | With Hub & set screw | ISO 7 / AGMA 10 | 20 | 10 | 10 | 48 | 20 | 0.399 | 1655.85 | 79.4808 | 16.76 | 4.742291169
303 Stainless Steel
Young's Modulus | 193000 | Mpa
Yield Strength | 415 | Mpa
Max Motor Torque | 4.19 | n-m

Sheet: Ring Gear
Current BOLT Circle Diameter | 1.994863 | in |  |  |  |  | Young's Modulus | Yield Strength
Current ID of Ring Gear | 2.3622 | in |  |  |  | Brass | 13500 | 18100
Motor OD | 2.677 | in |  |  |  | 303 Stainless Steel | 28000 | 60200
 |  |  |  |  |  | Carbon Steel | 29000 | 45000
Desired ID of Ring Gear | > 3.5 | in
Options:
Inch
Part Number | Diametral Pitch | No. Of Teeth | Pressure Angle | Material | Quality Class | Face Width (in) | Pitch Dia. (in) | Outside Dia. (in) | Inside Dia. (in)
A 1B10-N48192 | 48 | 192 | 14.5 | Brass | Commercial | 0.125 | 4 | 4.75 | 3.9583
A 1B10-N24096 | 24 | 96 | 14.5 | Brass | Commercial | 0.25 | 4 | 4.75 | 3.9167
A 1B10-N32128 | 32 | 128 | 14.5 | Brass | Commercial | 0.1875 | 4 | 4.75 | 3.9375
A 1B10-N24144 | 24 | 144 | 14.5 | Brass | Commercial | 0.25 | 6 | 6.75 | 5.9167
A 1B10-N32192 | 32 | 192 | 14.5 | Brass | Commercial | 0.1875 | 6 | 6.75 | 5.9375
Metric
Part Number | Diametral Pitch | No. Of Teeth | Pressure Angle | Material | Quality Class | Face Width (mm) | Pitch Dia. (mm) | Outside Dia. (mm) | Inside Dia. (mm) | mm | in
A 1C10MYK10096 | 1 | 96 | 20 | Carbon Steel | Commercial | 10 | 96 | 125 | 94 | 94 | 3.7007894
S1E10ZM10S096 | 1 | 96 | 20 | 303 Stainless Steel | ISO Class 7 | 10 | 96 | 120 | 94 | 94 | 3.7007894
S1E08ZM08S120 | 0.8 | 120 | 20 | 303 Stainless Steel | ISO Class 7 | 8 | 96 | 120 | 94.4 | 94.4 | 3.71653744
S1E10ZM10S100 | 1 | 100 | 20 | 303 Stainless Steel | ISO Class 7 | 10 | 100 | 150 | 98 | 98 | 3.8582698
A 1C10MYK10100 | 1 | 100 | 20 | Carbon Steel | Commercial | 10 | 100 | 130 | 98 | 98 | 3.8582698
S1E10ZM10S108 | 1 | 108 | 20 | 303 Stainless Steel | ISO Class 7 | 10 | 108 | 150 | 106 | 106 | 4.1732306
A 1C10MYK10108 | 1 | 108 | 20 | Carbon Steel | Commercial | 10 | 108 | 140 | 106 | 106 | 4.1732306
A 1C10MYK10120 | 1 | 120 | 20 | Carbon Steel | Commercial | 10 | 120 | 150 | 118 | 118 | 4.6456718
S1E10ZM10S120 | 1 | 120 | 20 | 303 Stainless Steel | ISO Class 7 | 10 | 120 | 150 | 118 | 118 | 4.6456718

Sheet: Sun Gear
Pressure Angle | 20
Ring Gear Teeth | 120 | 108
Desired Gear Ratio | 6 | 9
Sun Gear Teeth | 20 | 12
Motor Shaft Diameter | 8 | mm
Part Number | Module ( Pitch) | No. Of Teeth | Material | Hub Style | Quality Class | Pressure Angle | Bore Size | Face Width | Pitch Dia. | Hub Dia. (0 = Hubless) | all metric
Gear Ratio 6
A 1C 2MYK10020A | 1 | 20 | Carbon Steel | With Hub & set screw | ISO 8 / AGMA 9 | 20 | 8 | 8 | 20 | 16
A 1C 2MYKW10020 | 1 | 20 | Carbon Steel | With Hub & set screw | ISO 8 / AGMA 9 | 20 | 8 | 10 | 20 | 16
A 1C 1MYKW10020 | 1 | 20 | Carbon Steel | Hubless | ISO 8 / AGMA 9 | 20 | 8 | 12 | 20 | 0
A 1C 2MYKX10020 | 1 | 20 | Carbon Steel | With Hub & set screw | ISO 8 / AGMA 9 | 20 | 8 | 12 | 20 | 16
A 1C 2MY10020 | 1 | 20 | Carbon Steel | With Hub No Set Screw | ISO 8 / AGMA 9 | 20 | 8 | 8 | 20 | 16
A 1C 2MYK10020AS | 1 | 20 | Carbon Steel | With Hub & set screw | ISO 8 / AGMA 9 | 20 | 8 | 8 | 20 | 16
A 1C 2MYKX10020S | 1 | 20 | Carbon Steel | With Hub & set screw | ISO 8 / AGMA 11 | 20 | 8 | 12 | 20 | 16
A 1C 2MYKW10020S | 1 | 20 | Carbon Steel | With Hub & set screw | ISO 8 / AGMA 12 | 20 | 8 | 10 | 20 | 16
A 1B 2MY10020 | 1 | 20 | Brass | With Hub No Set Screw | ISO 8 / AGMA 9 | 20 | 8 | 8 | 20 | 16
S10S10M020T1008G | 1 | 20 | AISI 4135 Steel | With Hub & set screw | ISO 5 - Ground | 20 | 8 | 10 | 20 | 16
S10S10M020P1008G | 1 | 20 | AISI 4135 Steel | With Hub No Set Screw | ISO 5 - Ground | 20 | 8 | 10 | 20 | 16
A 1Y 2MY10020 | 1 | 20 | 416 Stainless Steel | With Hub No Set Screw | ISO 8 / AGMA 9 | 20 | 8 | 8 | 20 | 16
S10T05M020S0508 | 0.5 | 20 | 303 Stainless Steel | With Hub & set screw | ISO 7 / AGMA 10 | 20 | 8 | 5 | 10 | 12
S10T10M020S1008 | 1 | 20 | 303 Stainless Steel | With Hub & set screw | ISO 7 / AGMA 10 | 20 | 8 | 10 | 20 | 20
S10T08M020S0508 | 0.8 | 20 | 303 Stainless Steel | With Hub & set screw | ISO 7 / AGMA 10 | 20 | 8 | 5 | 16 | 12
S10T10M020S0508 | 1 | 20 | 303 Stainless Steel | With Hub & set screw | ISO 7 / AGMA 10 | 20 | 8 | 5 | 20 | 12
S10T10M020A0508 | 1 | 20 | 2024 Aluminum alloy | With Hub & set screw | ISO 7 / AGMA 10 | 20 | 8 | 5 | 20 | 12
S10T08M020A0508 | 0.8 | 20 | 2024 Aluminum alloy | With Hub & set screw | ISO 7 / AGMA 10 | 20 | 8 | 5 | 16 | 12
S10T05M020A0508 | 0.5 | 20 | 2024 Aluminum alloy | With Hub & set screw | ISO 7 / AGMA 10 | 20 | 8 | 5 | 10 | 12
Gear Ratio 8
S10T08M015A0508 | 0.8 | 15 | 2024 Aluminum alloy | With Hub & set screw | ISO 7 / AGMA 10 | 20 | 8 | 5 | 12 | 12
S10T10M015A0508 | 1 | 15 | 2024 Aluminum alloy | With Hub & set screw | ISO 7 / AGMA 10 | 20 | 8 | 5 | 15 | 12
S10T10M015S1008 | 1 | 15 | 303 Stainless Steel | With Hub & set screw | ISO 7 / AGMA 10 | 20 | 8 | 10 | 15 | 20
S10T10M015S0508 | 1 | 15 | 303 Stainless Steel | With Hub & set screw | ISO 7 / AGMA 10 | 20 | 8 | 5 | 15 | 12
S10T08M015S0508 | 0.8 | 15 | 303 Stainless Steel | With Hub & set screw | ISO 7 / AGMA 10 | 20 | 8 | 5 | 12 | 12
Gear Ratio 10
S10T10M012S0508 | 1 | 12 | 303 Stainless Steel | With Hub & set screw | ISO 7 / AGMA 10 | 20 | 8 | 5 | 12 | 12
S10T10M012A0508 | 1 | 12 | 2024 Aluminum alloy | With Hub & set screw | ISO 7 / AGMA 10 | 20 | 8 | 5 | 12 | 12
A 1C 8MYK15012 | 1.5 | 12 | Carbon Steel | With Hub No Set Screw | ISO 8 / AGMA 9 | 20 | 8 | 18 | 18 | 0

Sheet: Planetary Gear
Pressure Angle | 20
Ring Gear Teeth | 120 | 108
Ring Gear Pitch Diameter | 96 | 108
Gear Ratio | 6 | 9
Sun Gear pitch Diameter | 16 | 12
Sun Gear Teeth | 20 | 12
Planetary Gear Teeth | 50 | 48
Planetary Gear Pitch Diameter | 40 | 48
Part Number | Module ( Pitch) | No. Of Teeth | Material | Hub Style | Quality Class | Pressure Angle | Bore Size | Face Width | Pitch Dia. | Hub Dia. (0 = Hubless)
 |  |  |  |  |  | Degree | mm | mm | mm | mm
Gear Ratio 6
A 1C 2MY08050 | 0.8 | 50 | Carbon Steel | With Hub No Set Screw | ISO 8 / AGMA 9 | 20 | 8 | 6 | 40 | 19
A 1B 2MYK08050 | 0.8 | 50 | Brass | With Hub & set screw | ISO 8 / AGMA 9 | 20 | 6 | 5 | 40 | 14
A 1B 2MY08050 | 0.8 | 50 | Brass | With Hub No Set Screw | ISO 8 / AGMA 9 | 20 | 8 | 6 | 40 | 19
S10S08M050T0812G | 0.8 | 50 | AISI 4135 Steel | With Hub & set screw | ISO 5 - Ground | 20 | 12 | 8 | 40 | 25
A 1Y 2MY08050 | 0.8 | 50 | 416 Stainless Steel | With Hub No Set Screw | ISO 8 / AGMA 9 | 20 | 8 | 6 | 40 | 19
S1VS08M050F0506 | 0.8 | 50 | 303 Stainless Steel | Fairloc Hub | ISO 7 / AGMA 10 | 20 | 6 | 5 | 40 | 17
S12N08M050S0310 | 0.8 | 50 | 303 Stainless Steel | Hubless | ISO 7 / AGMA 10 | 20 | 10 | 3 | 40 | 0
S12N08M050S0510 | 0.8 | 50 | 303 Stainless Steel | Hubless | ISO 7 / AGMA 10 | 20 | 10 | 5 | 40 | 0
S12S08M050N0310 | 0.8 | 50 | 303 Stainless Steel | Hubless | ISO 7 / AGMA 10 | 20 | 10 | 3.2 | 40 | 0
S12A08M050N0310 | 0.8 | 50 | 2024 Aluminum alloy | Hubless | ISO 7 / AGMA 10 | 20 | 10 | 3.2 | 40 | 0
S12N08M050A0310 | 0.8 | 50 | 2024 Aluminum alloy | Hubless | ISO 7 / AGMA 10 | 20 | 10 | 3 | 40 | 0
S12N08M050A0510 | 0.8 | 50 | 2024 Aluminum alloy | Hubless | ISO 7 / AGMA 10 | 20 | 10 | 5 | 40 | 0
Gear Ratio 9
S10T10M048S0505 | 1 | 48 | 303 Stainless Steel | With Hub & set screw | ISO 7 / AGMA 10 | 20 | 5 | 5 | 48 | 10
S1VS10M048F0608 | 1 | 48 | 303 Stainless Steel | Fairloc Hub | ISO 7 / AGMA 10 | 20 | 8 | 6 | 48 | 17
S12N10M048S0310 | 1 | 48 | 303 Stainless Steel | Hubless | ISO 7 / AGMA 10 | 20 | 10 | 3 | 48 | 0
S10T10M048S1010 | 1 | 48 | 303 Stainless Steel | With Hub & set screw | ISO 7 / AGMA 10 | 20 | 10 | 10 | 48 | 20
S10T10M048S0508 | 1 | 48 | 303 Stainless Steel | With Hub & set screw | ISO 7 / AGMA 10 | 20 | 8 | 5 | 48 | 12
S12N10M048S0510 | 1 | 48 | 303 Stainless Steel | Hubless | ISO 7 / AGMA 10 | 20 | 10 | 5 | 48 | 0
S12S10M048N0310 | 1 | 48 | 303 Stainless Steel | Hubless | ISO 7 / AGMA 10 | 20 | 10 | 3.2 | 48 | 0
