NxRLab/gibbot/Frame/Frame v4/EXCEL/Shaft Calculations.xlsx

Sheet: Bearing and Shaft
Aluminum 6061-T6511 |  |  | Dynamic Load Capacity of Bearing | 2100 lbs
Yield Strength | 38000
Shear Yield Strength | 20900
 |  |  |  |  |  | Shear
Shear Load | Distance to First Bearing | Distance to Second Bearing | Force on Shaft @ Bearing 1 | Force on Shaft @ Bearing 2 | FS | Area | ID | OD | Section Modulus | Required OD | Chosen OD
100 | 1.1781 | 1.6156 | -369.28 | 269.28 | 3 | 0.05300669856 | 0.5 | 0.5634627093 | 0.009300789474 | 0.586127 | 0.75

Sheet: Fastener
Stainless Steel type 316 |  | Aluminum 6061
Yield Strength | 42000 | Bearing Strength | 58000
Shear Yield Strength | 23100 | Tensile Strength | 40000
 |  |  |  |  | Bearing |  | Shear Tear Out
Shear Load | Fastener OD | Shear Area | Shear Stress | FS | Bearing Stres FS | Required Thickness | Tear out Stress FS | Lc | Required Thickness
100 | 0.19 | 0.017 | 5882.352941 | 3.927 | 3 | 0.02722323049 | 3 | 0.17654 | 0.03540274159
Current Thickness
0.5
