NxRLab/gibbot/Frame/CAD v3/Wall Link.SLDASM

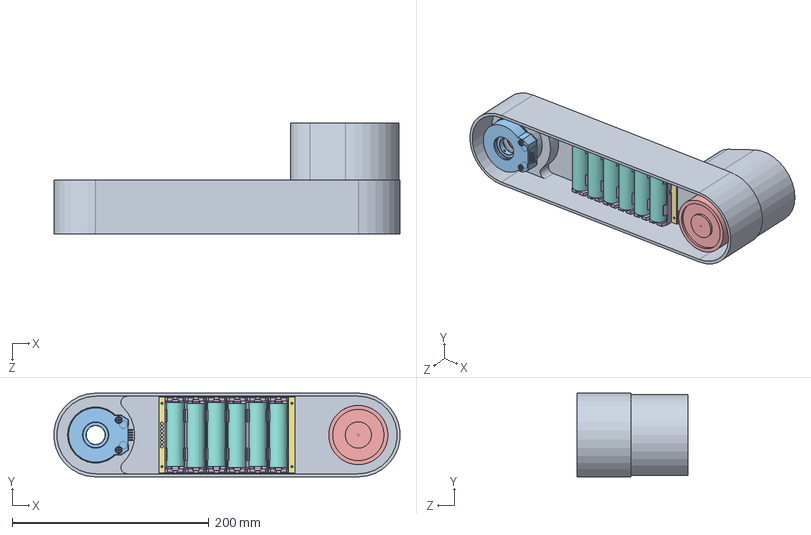
[picture p152: CAD file, 2014-04-04]
Frame/CAD v3/Wall Link.SLDASM
351.3 x 85.1 x 112.4 mm
Wall Link Frame
ring_gear
Magnet Encoders E3-X-750-X-H-D-X x 2
magnet holder
EM237 Magnet
Battery Holder - keystone-PN1043 x 6
Battery PCB
battery_6612 x 6
Bearing - .750
1.625 Bore Internal Retaining Ring
