NxRLab/gibbot/Frame/Frame v4/SOLIDWORKS/Batteries/Battery Assembly.SLDASM

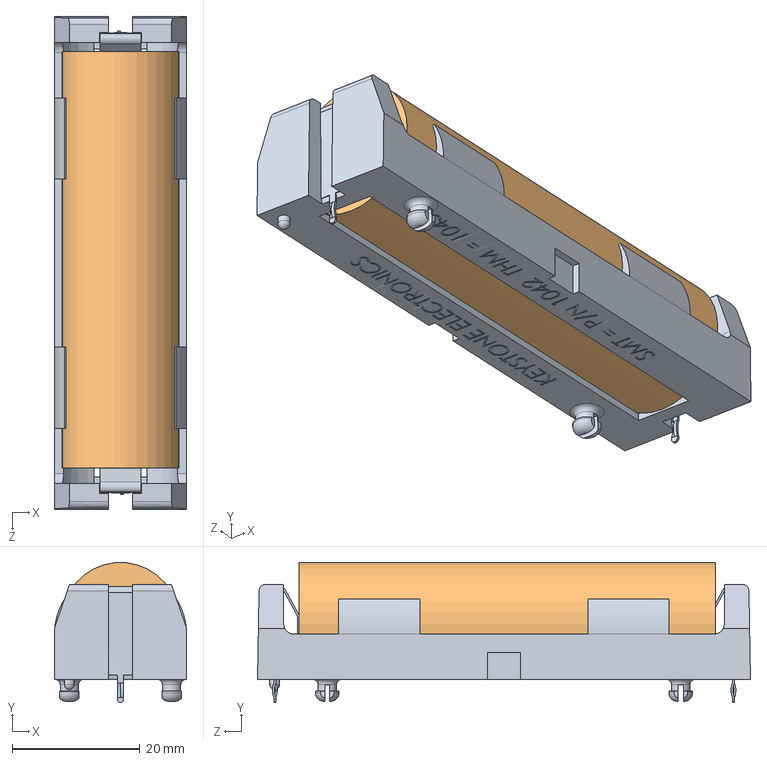
[picture p153: CAD file, 2014-12-19]
Frame/Frame v4/SOLIDWORKS/Batteries/Battery Assembly.SLDASM
20.7 x 21.9 x 77.1 mm
Battery Holder - keystone-PN1043
battery_6612
