NxRLab/gibbot/Frame/Frame v4/SOLIDWORKS/Batteries/PCB_Battery Assembly.SLDASM

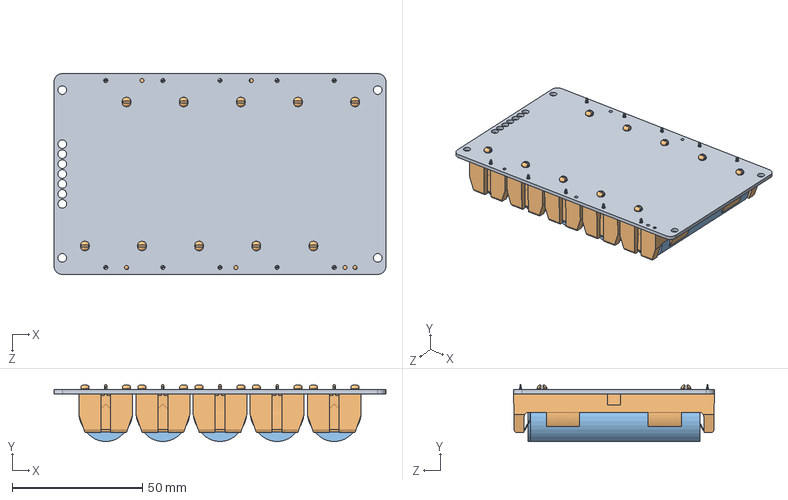
[picture p154: CAD file, 2014-12-19]
Frame/Frame v4/SOLIDWORKS/Batteries/PCB_Battery Assembly.SLDASM
127.4 x 21.9 x 77.1 mm
Battery PCB
Battery Holder - keystone-PN1043 x 5
battery_6612 x 5
