NxRLab/gibbot/Frame/CAD v3/9.4in. Frame/3d Printer Fit Assembly.SLDASM

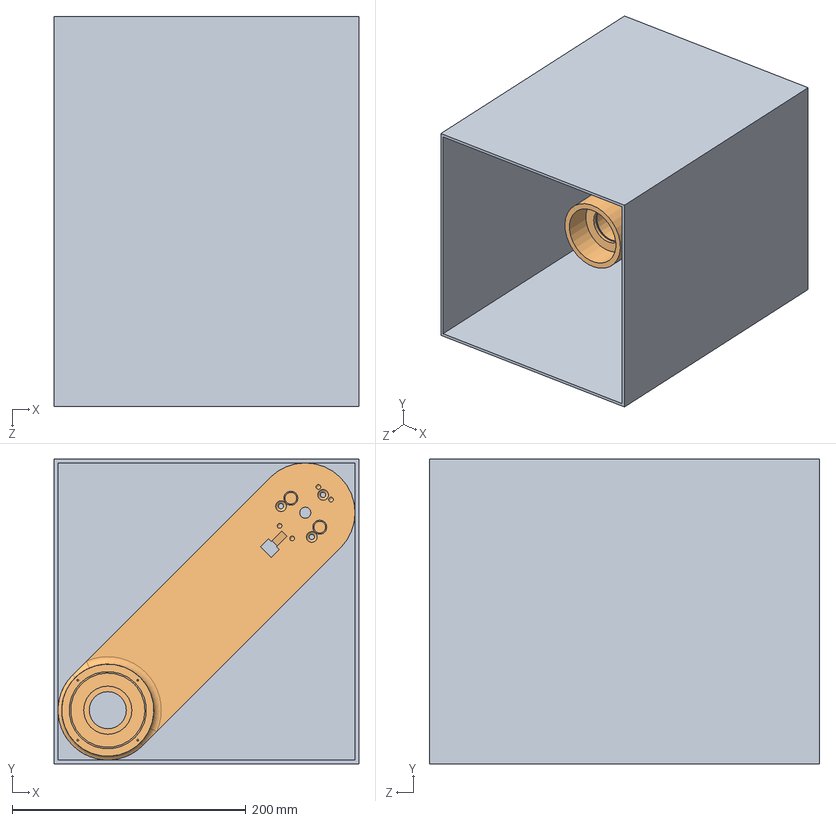
[picture p155: CAD file, 2014-05-01]
Frame/CAD v3/9.4in. Frame/3d Printer Fit Assembly.SLDASM
260.4 x 260.4 x 333.4 mm
3D Printer Bed
Motor Link Frame
