NxRLab/gibbot/Frame/Frame v4/SOLIDWORKS/Motor and Gear.SLDASM

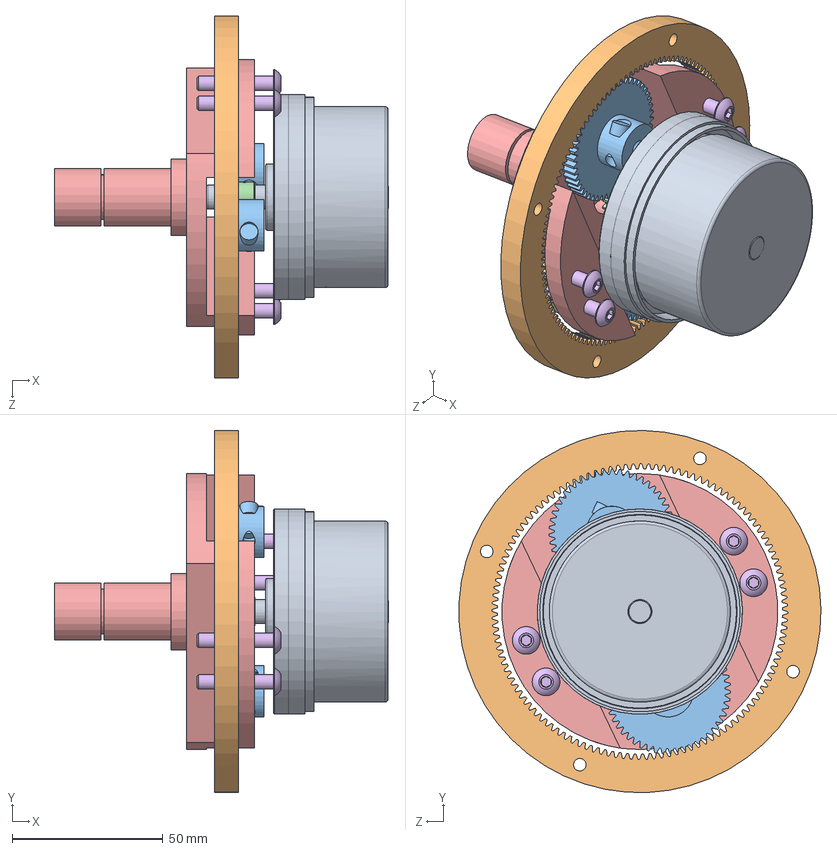
[picture p156: CAD file, 2014-12-19]
Frame/Frame v4/SOLIDWORKS/Motor and Gear.SLDASM
110.8 x 119.9 x 119.9 mm
EC60 Motor
Ring Gear
Planetary Gear x 2
Sun Gear
10-32 Button Cap Screw x 4
10-32 Thread Locking Nut x 4
