NxRLab/gibbot/Frame/CAD v3/9.4in. Frame/PCB_Battery Assembly.SLDASM

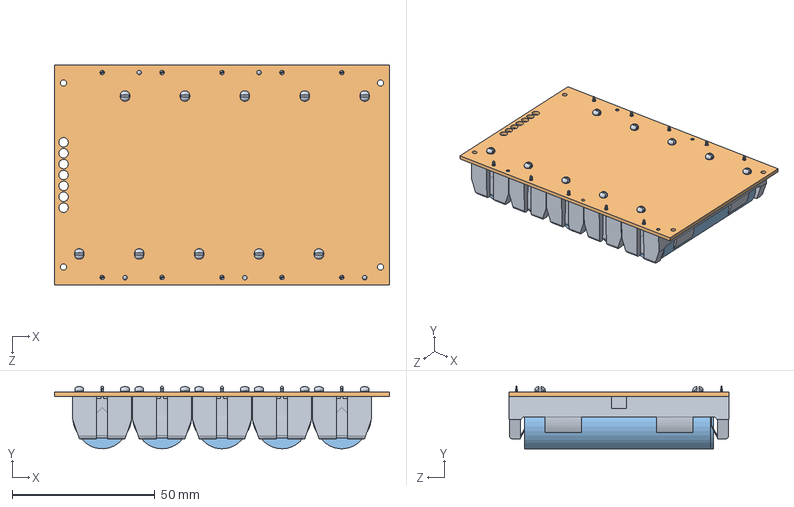
[picture p157: CAD file, 2014-05-01]
Frame/CAD v3/9.4in. Frame/PCB_Battery Assembly.SLDASM
117.2 x 21.9 x 77.1 mm
Battery Holder - keystone-PN1043 x 5
Battery PCB
battery_6612 x 5
