NxRLab/gibbot/Frame/Frame v4/SOLIDWORKS/Motor Link Assembly.SLDASM

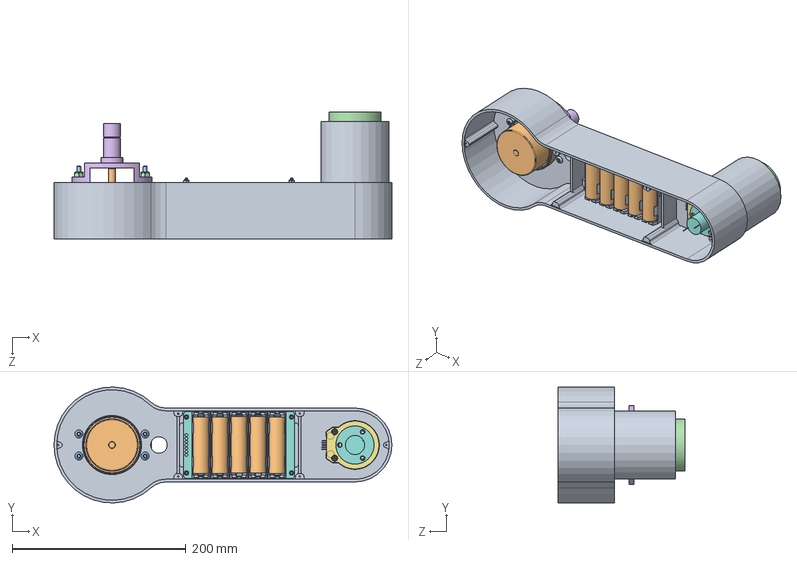
[picture p158: CAD file, 2014-12-19]
Frame/Frame v4/SOLIDWORKS/Motor Link Assembly.SLDASM
388.6 x 133.3 x 146.0 mm
Motor Link Frame
EC60 Motor
Bearing - .750 x 2
EM237 Magnet
Magnet Holder Motor Link
Shaft_Carrier_Combined
Magnet Encoders E3-X-750-X-H-D-X
Battery PCB
Battery Holder - keystone-PN1043 x 5
battery_6612 x 5
10-32 Button Cap Screw x 4
10-32 Thread Locking Nut x 4
5-40 Bolt x 4
5-40 Nylon Locknut x 4
M5 Nylon Spacer x 3
Slip Ring M322M1-0202
