NxRLab/gibbot/Frame/Frame v4/SOLIDWORKS/Wall Link Assembly.SLDASM

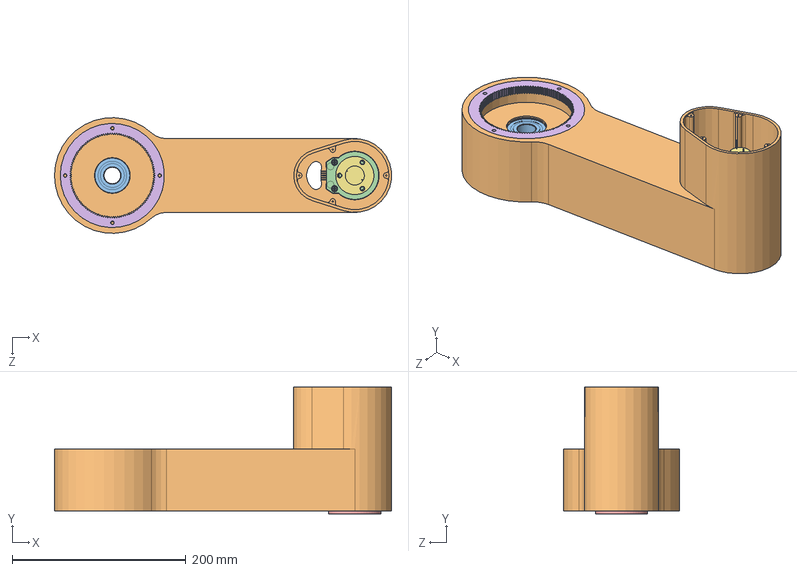
[picture p159: CAD file, 2014-12-19]
Frame/Frame v4/SOLIDWORKS/Wall Link Assembly.SLDASM
388.4 x 146.0 x 133.3 mm
magnet holder
Wall Link Frame
Bearing - .750 x 4
Magnet Encoders E3-X-750-X-H-D-X x 2
EM237 Magnet
Ring Gear
Slip Ring M322M1-0202
M5 Nylon Spacer x 3
Battery PCB
Battery Holder - keystone-PN1043 x 5
battery_6612 x 5
