NxRLab/gibbot/Frame/CAD v3/10.5in Frame/PCB_Battery Assembly.SLDASM

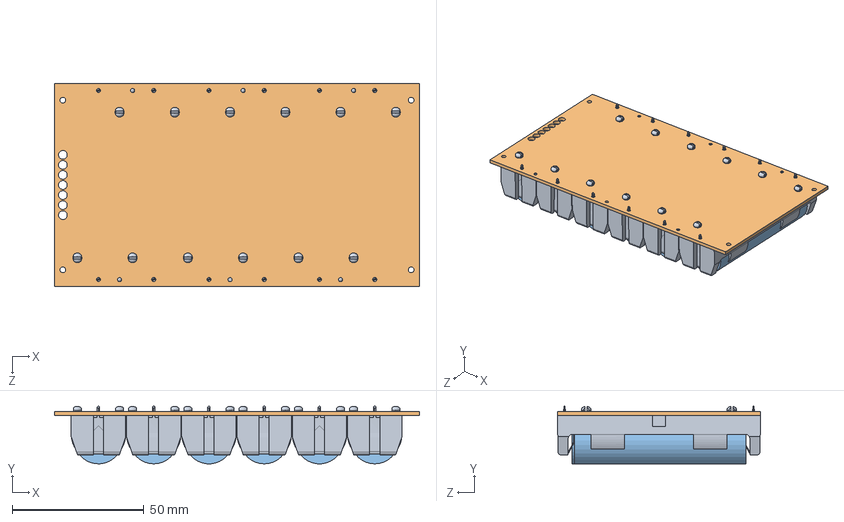
[picture p160: CAD file, 2014-04-11]
Frame/CAD v3/10.5in Frame/PCB_Battery Assembly.SLDASM
138.4 x 21.9 x 77.1 mm
Battery Holder - keystone-PN1043 x 6
Battery PCB
battery_6612 x 6
