NxRLab/gibbot/Frame/Frame v4/SOLIDWORKS/Gibbot.SLDASM

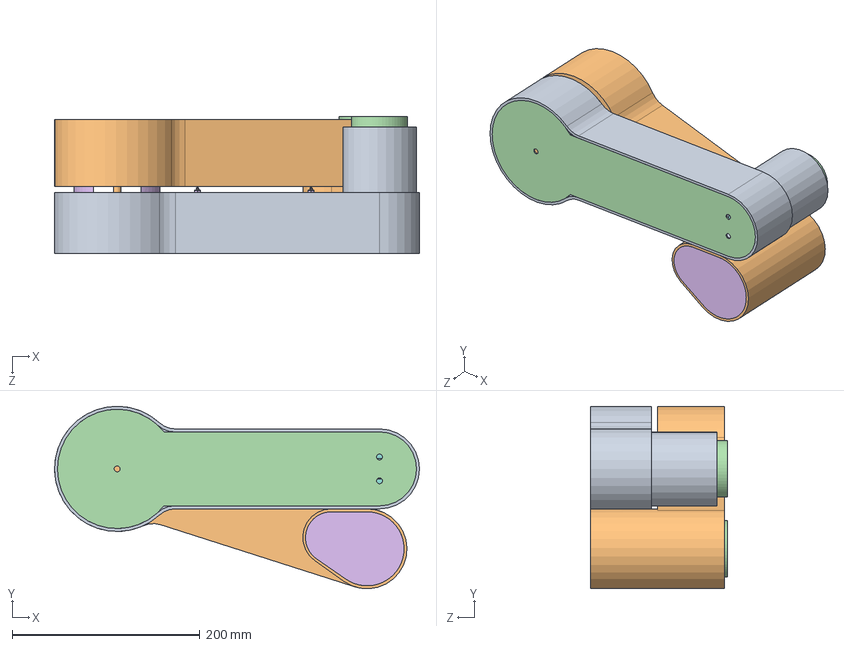
[picture p161: CAD file, 2014-12-19]
Frame/Frame v4/SOLIDWORKS/Gibbot.SLDASM
388.6 x 194.3 x 146.0 mm
Motor Link Frame
EC60 Motor
Bearing - .750 x 6
EM237 Magnet x 2
Magnet Holder Motor Link
Shaft_Carrier_Combined
Magnet Encoders E3-X-750-X-H-D-X x 3
Battery PCB x 2
Battery Holder - keystone-PN1043 x 10
battery_6612 x 10
10-32 Button Cap Screw x 4
10-32 Thread Locking Nut x 4
5-40 Bolt x 4
5-40 Nylon Locknut x 4
M5 Nylon Spacer x 6
Slip Ring M322M1-0202 x 2
magnet holder
Wall Link Frame
Ring Gear
Motor Link Cover
Wall Link Cover
Wall Link Cover 2
