NxRLab/gibbot/Frame/CAD v3/9.4in. Frame/Shaft Assembly Test.SLDASM

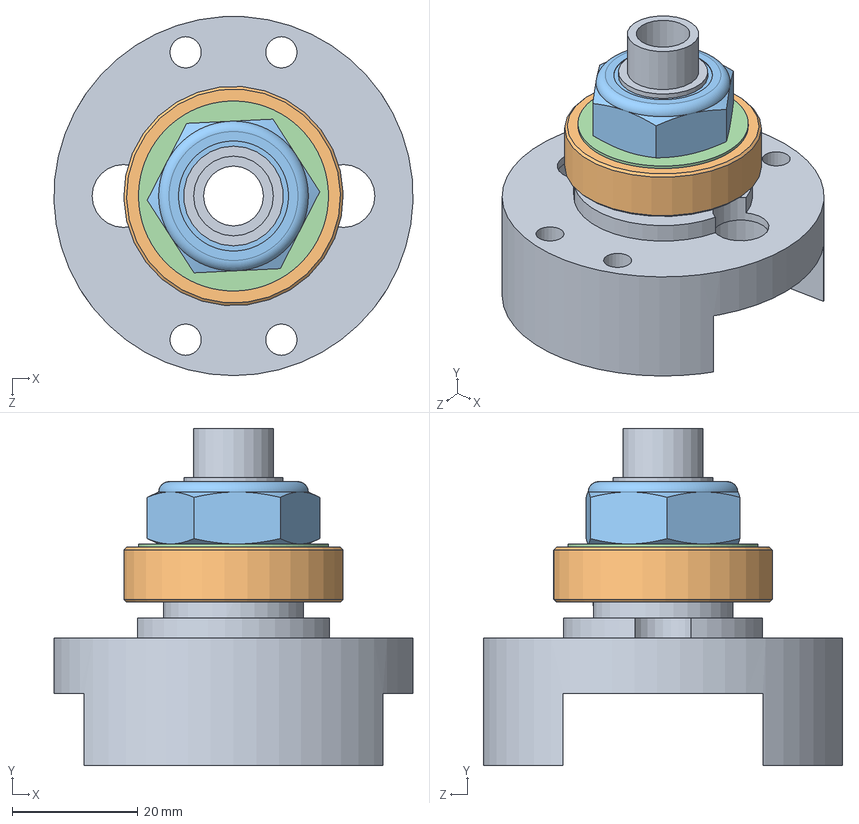
[picture p162: CAD file, 2014-04-04]
Frame/CAD v3/9.4in. Frame/Shaft Assembly Test.SLDASM
57.1 x 53.6 x 57.1 mm
Shaft_Carrier_Combined_V2
Bearing-.625in
Locknut-.625in
Washer-.625in.
