NxRLab/gibbot/Frame/CAD v3/10.5in Frame/EC60_motor_12_198_IP00.sldasm

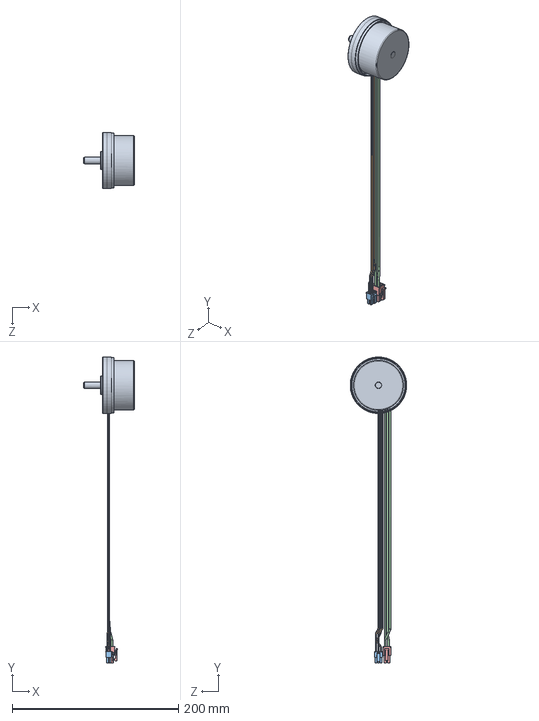
[picture p163: CAD file, 2013-06-06]
Frame/CAD v3/10.5in Frame/EC60_motor_12_198_IP00.sldasm
61.3 x 368.0 x 67.9 mm
