NxRLab/gibbot/Frame/CAD v3/.75 Bore External Retaining Ring.SLDPRT

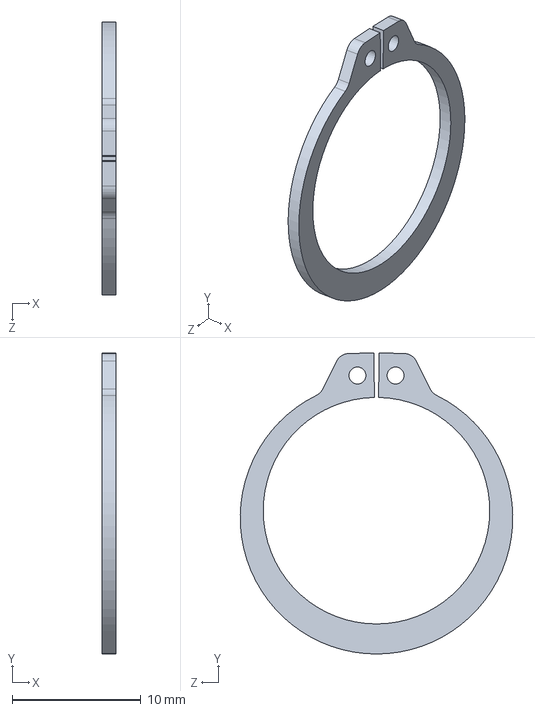
[picture p164: CAD file, 2014-04-04]
Frame/CAD v3/.75 Bore External Retaining Ring.SLDPRT
1.07 x 23.4 x 21.2 mm
