NxRLab/gibbot/Frame/CAD v3/10.5in Frame/3D Printing/Motor Link Frame v2.STL

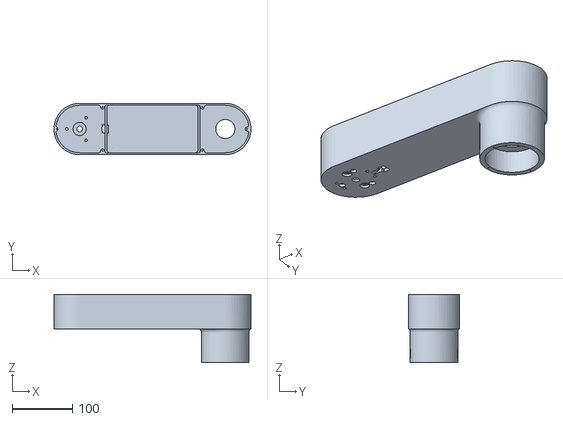
[picture p165: CAD file, 2014-05-01]
Frame/CAD v3/10.5in Frame/3D Printing/Motor Link Frame v2.STL
326.3 x 85.1 x 113.4
