NxRLab/gibbot/Frame/CAD v3/10.5in Frame/Drawings/Battery PCB.DXF

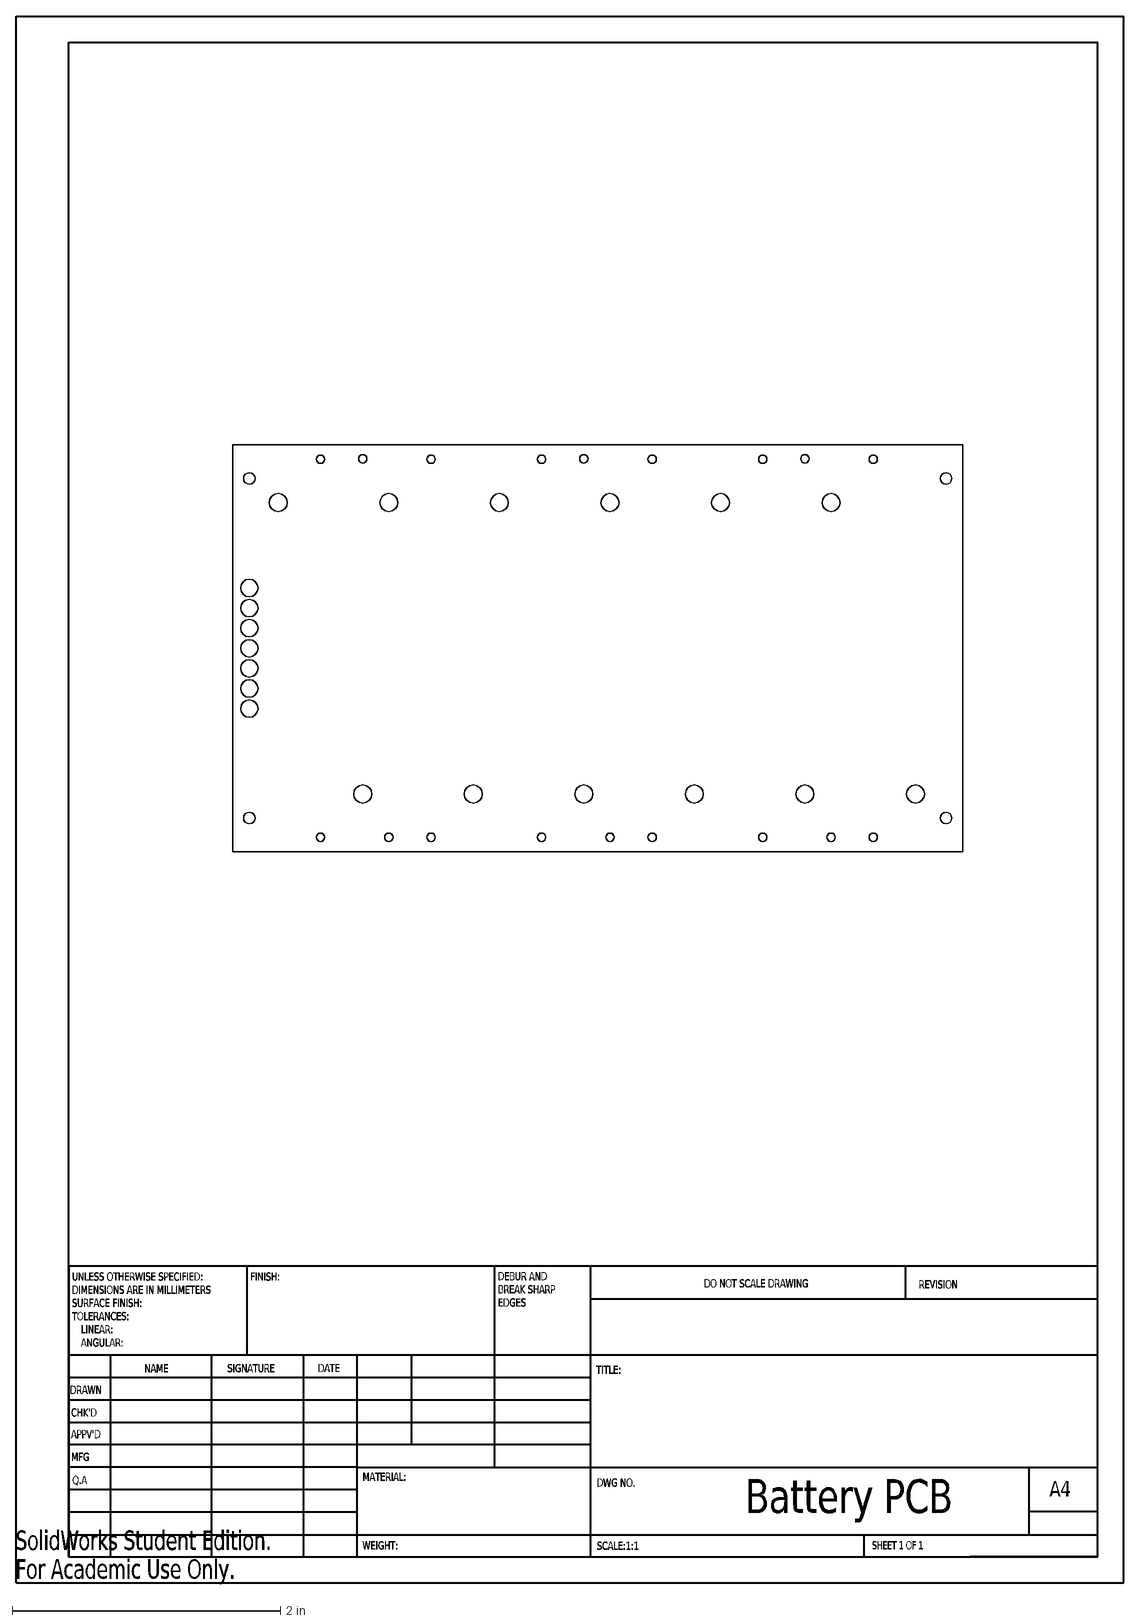
[picture p166: CAD file, 2015-01-28]
Frame/CAD v3/10.5in Frame/Drawings/Battery PCB.DXF
Battery PCB
WEIGHT:
A4
SHEET 1 OF 1
SCALE:1:1
DWG NO.
TITLE:
REVISION
DO NOT SCALE DRAWING
MATERIAL:
DATE
SIGNATURE
NAME
DEBUR AND
BREAK SHARP
EDGES
FINISH:
UNLESS OTHERWISE SPECIFIED:
DIMENSIONS ARE IN MILLIMETERS
SURFACE FINISH:
TOLERANCES:
LINEAR:
ANGULAR:
Q.A
MFG
APPV'D
CHK'D
DRAWN
SolidWorks Student Edition.
For Academic Use Only.
