NxRLab/gibbot/Frame/CAD v3/9.4in. Frame/3D Printing/Wall Link Frame (Undersized Holes).SLDPRT

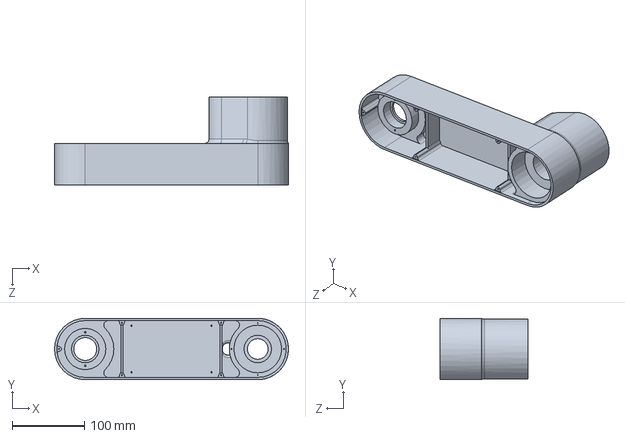
[picture p167: CAD file, 2014-05-01]
Frame/CAD v3/9.4in. Frame/3D Printing/Wall Link Frame (Undersized Holes).SLDPRT
323.8 x 85.1 x 121.2 mm
