NxRLab/gibbot/Frame/CAD v3/9.4in. Frame/Battery PCB.SLDPRT

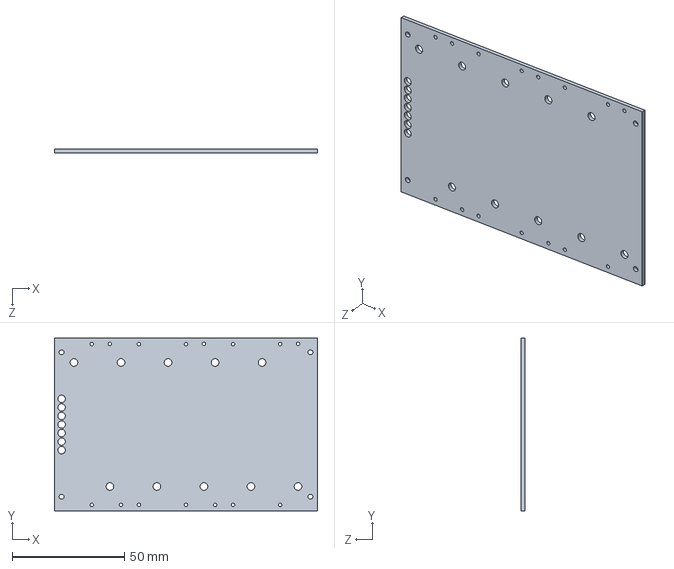
[picture p168: CAD file, 2014-05-01]
Frame/CAD v3/9.4in. Frame/Battery PCB.SLDPRT
117.2 x 77.1 x 1.59 mm
