NxRLab/gibbot/Frame/CAD v3/9.4in. Frame/CAM/Blank.SLDPRT

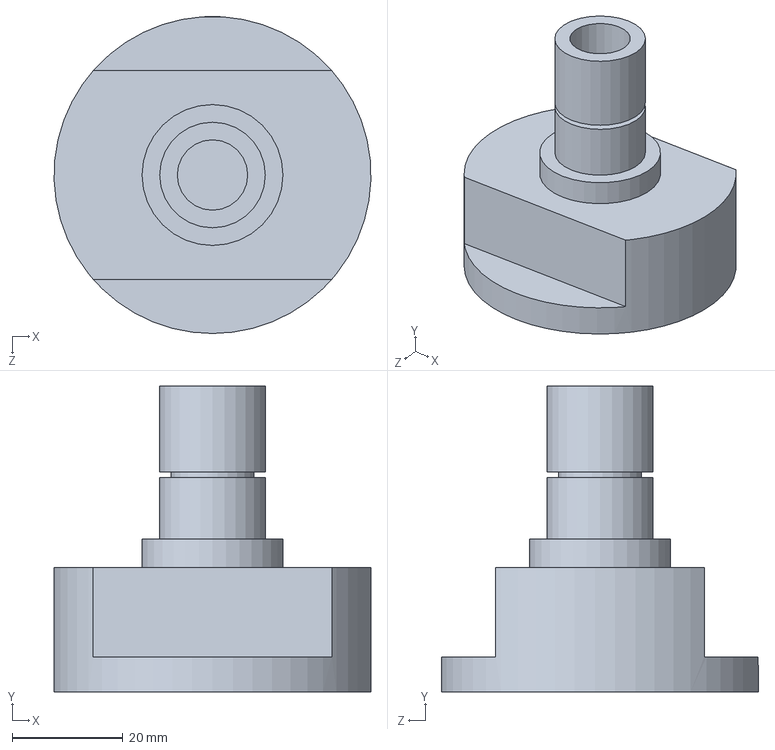
[picture p169: CAD file, 2014-05-01]
Frame/CAD v3/9.4in. Frame/CAM/Blank.SLDPRT
57.1 x 55.2 x 57.1 mm
