NxRLab/gibbot/Frame/Frame v4/SOLIDWORKS/Batteries/Battery PCB.SLDPRT

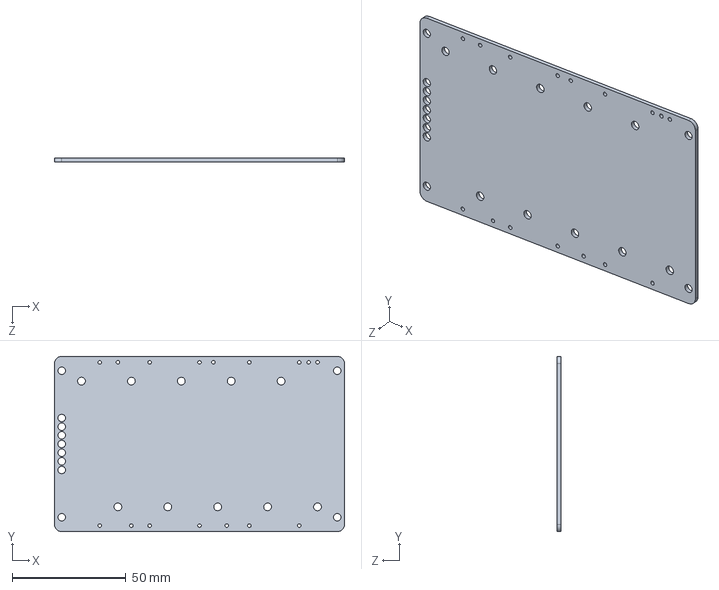
[picture p170: CAD file, 2014-12-19]
Frame/Frame v4/SOLIDWORKS/Batteries/Battery PCB.SLDPRT
127.4 x 77.1 x 1.59 mm
