NxRLab/gibbot/Frame/Frame v4/SOLIDWORKS/Bearings/Bearing - .750.SLDPRT

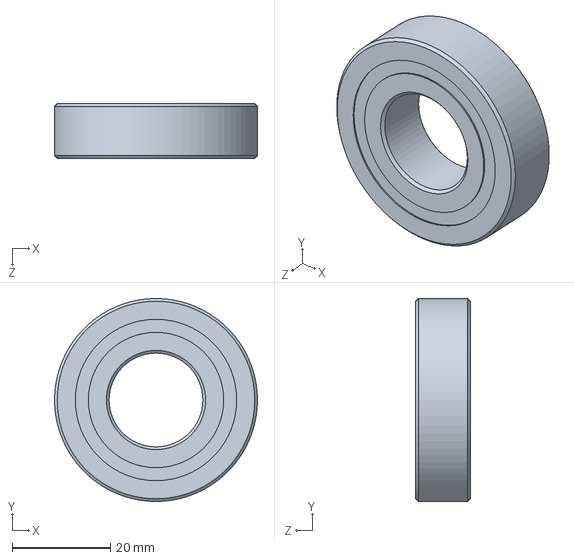
[picture p171: CAD file, 2014-12-19]
Frame/Frame v4/SOLIDWORKS/Bearings/Bearing - .750.SLDPRT
41.3 x 41.3 x 11.1 mm
