NxRLab/gibbot/Frame/Frame v4/SOLIDWORKS/Gear/Planetary Gear.SLDPRT

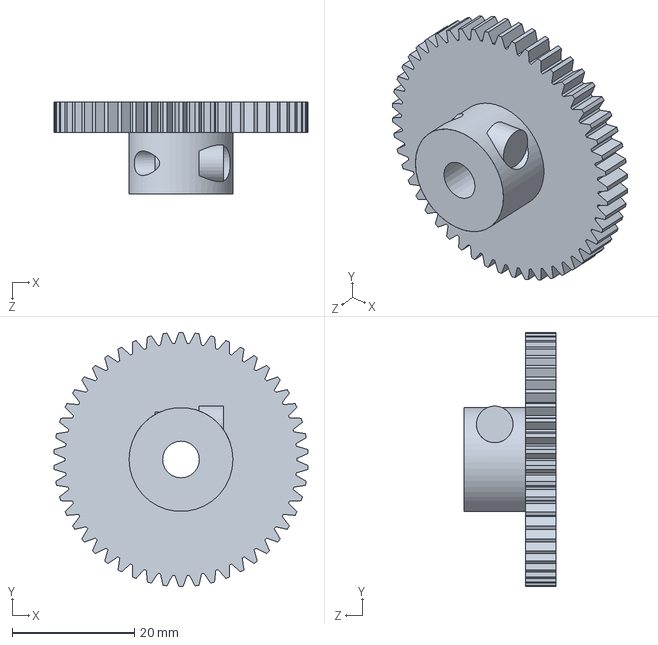
[picture p172: CAD file, 2014-12-19]
Frame/Frame v4/SOLIDWORKS/Gear/Planetary Gear.SLDPRT
41.6 x 41.6 x 15.0 mm
