NxRLab/gibbot/Frame/Frame v4/SOLIDWORKS/Motor Link Cover.SLDPRT

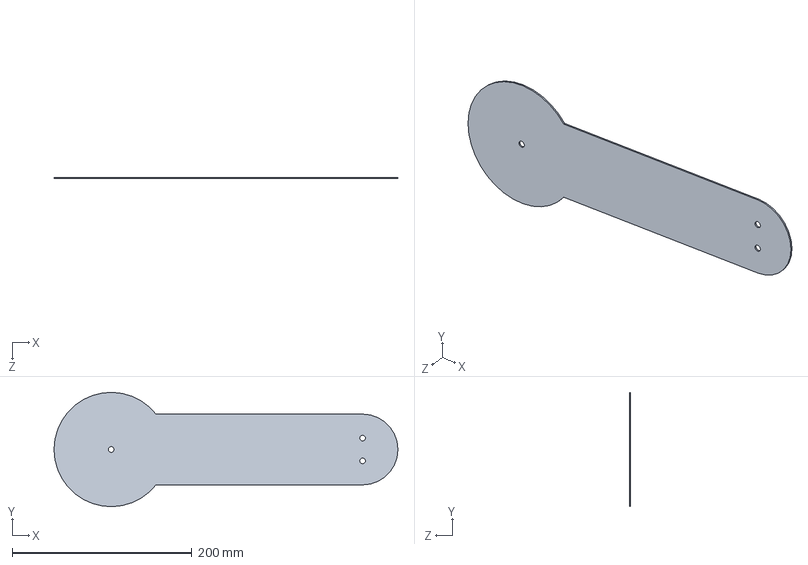
[picture p173: CAD file, 2014-12-19]
Frame/Frame v4/SOLIDWORKS/Motor Link Cover.SLDPRT
382.3 x 127.0 x 1.59 mm
