NxRLab/gibbot/Frame/Frame v4/Sponsorship/Wall Link Frame.STEP

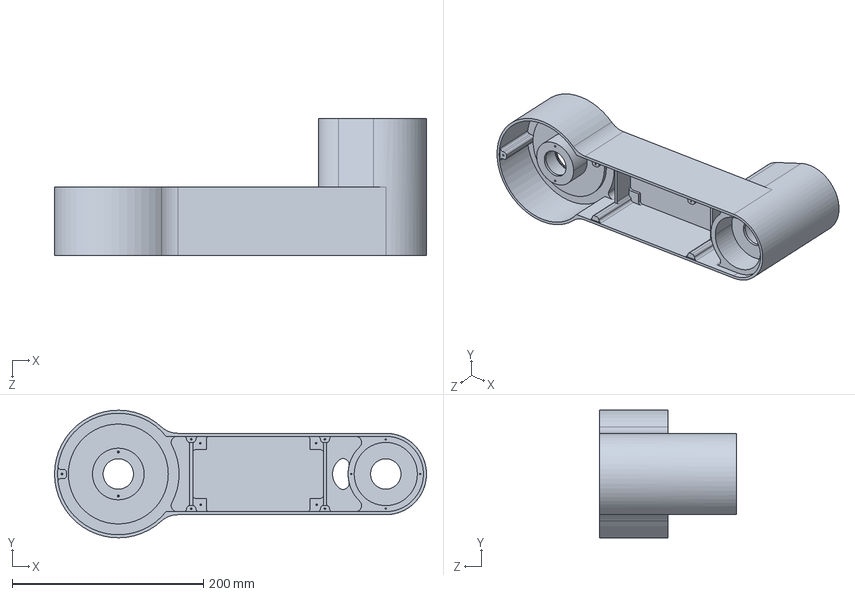
[picture p174: CAD file, 2015-01-28]
Frame/Frame v4/Sponsorship/Wall Link Frame.STEP
388.6 x 133.3 x 142.9 mm
