NxRLab/gibbot/Frame/CAD v3/10.5in Frame/3D Printing/Wall Link Frame (Undersized Holes).SLDPRT

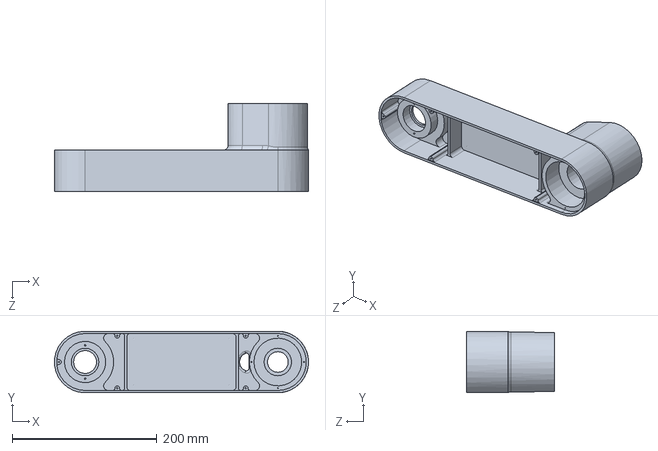
[picture p175: CAD file, 2014-04-11]
Frame/CAD v3/10.5in Frame/3D Printing/Wall Link Frame (Undersized Holes).SLDPRT
351.4 x 85.1 x 121.2 mm
