NxRLab/gibbot/Frame/CAD v3/10.5in Frame/Acrylic Cover 2 Wall Link.SLDPRT

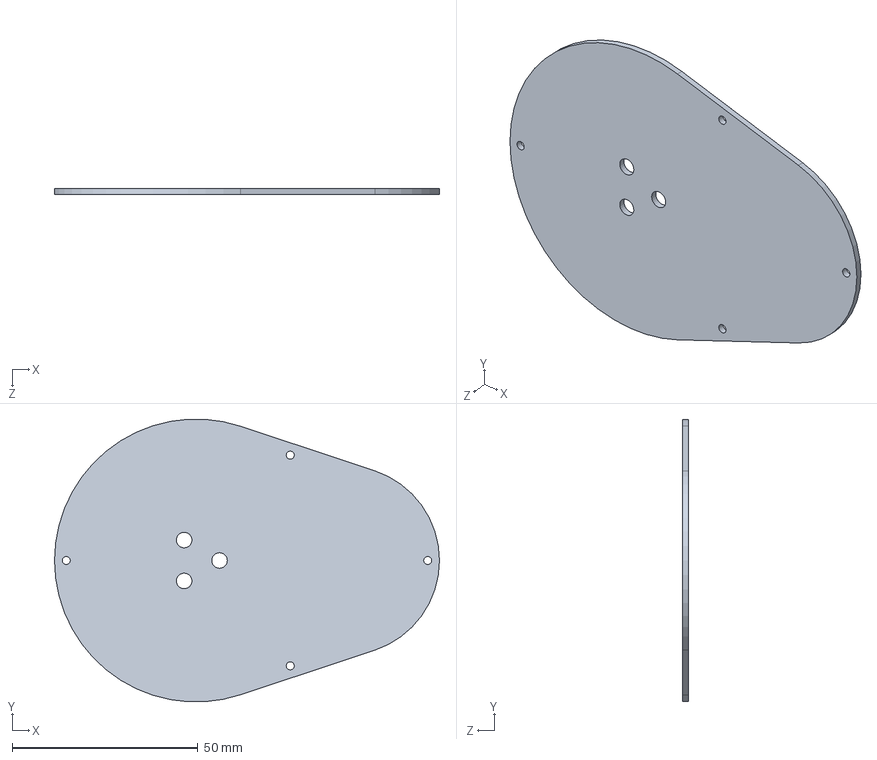
[picture p176: CAD file, 2014-04-11]
Frame/CAD v3/10.5in Frame/Acrylic Cover 2 Wall Link.SLDPRT
103.7 x 76.1 x 1.59 mm
