NxRLab/gibbot/Frame/CAD v3/9.4in. Frame/3D Printer Bed.SLDPRT

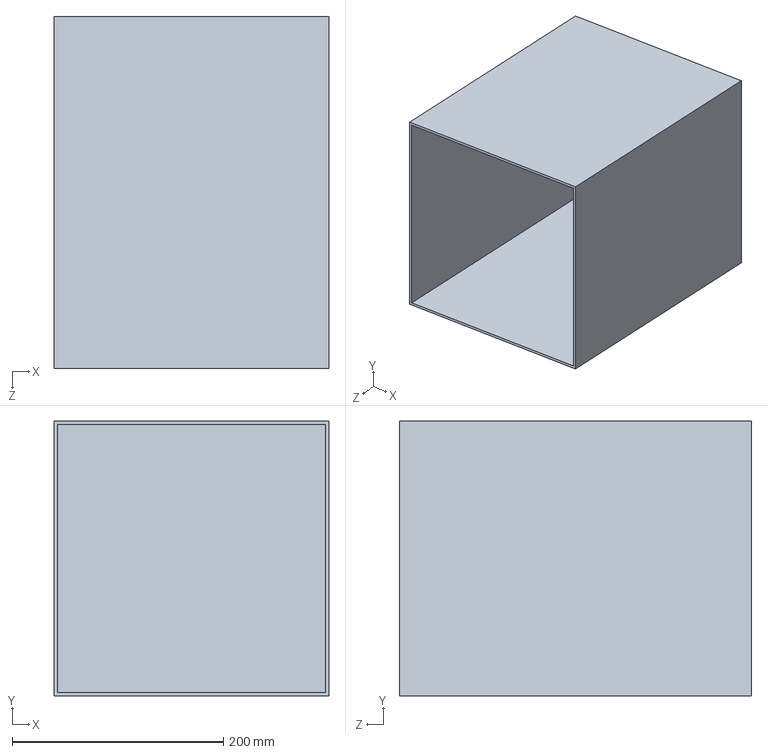
[picture p177: CAD file, 2014-05-01]
Frame/CAD v3/9.4in. Frame/3D Printer Bed.SLDPRT
260.4 x 260.4 x 333.4 mm
