NxRLab/gibbot/Frame/CAD v3/9.4in. Frame/3D Printing/Motor Link Frame (undersized Holes).SLDPRT

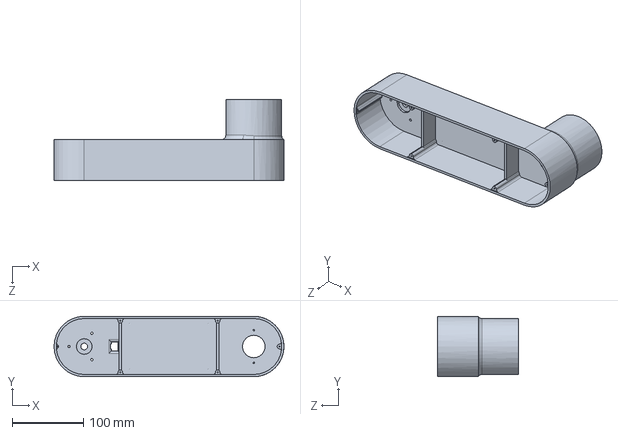
[picture p178: CAD file, 2014-05-01]
Frame/CAD v3/9.4in. Frame/3D Printing/Motor Link Frame (undersized Holes).SLDPRT
323.8 x 85.1 x 113.4 mm
