NxRLab/gibbot/Frame/Frame v4/SOLIDWORKS/EC60 Motor.SLDPRT

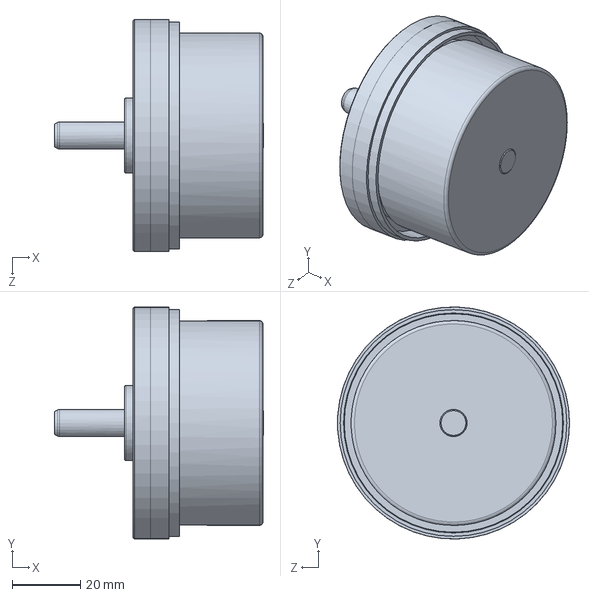
[picture p179: CAD file, 2014-12-19]
Frame/Frame v4/SOLIDWORKS/EC60 Motor.SLDPRT
61.3 x 68.0 x 68.0 mm
