NxRLab/gibbot/Frame/Frame v4/SOLIDWORKS/Gear/Sun Gear.SLDPRT

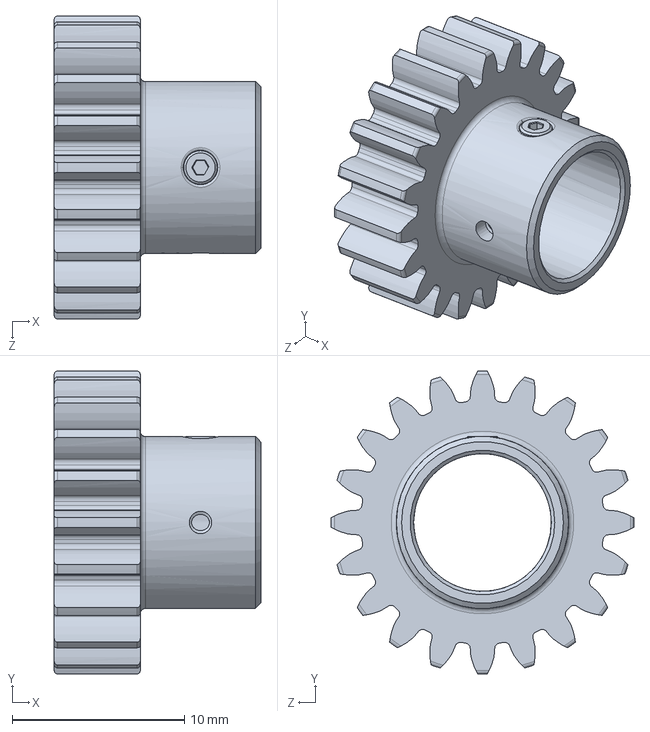
[picture p180: CAD file, 2014-12-19]
Frame/Frame v4/SOLIDWORKS/Gear/Sun Gear.SLDPRT
12.0 x 17.6 x 17.6 mm
