NxRLab/gibbot/Frame/Frame v4/Sponsorship/Motor Link Frame.STEP

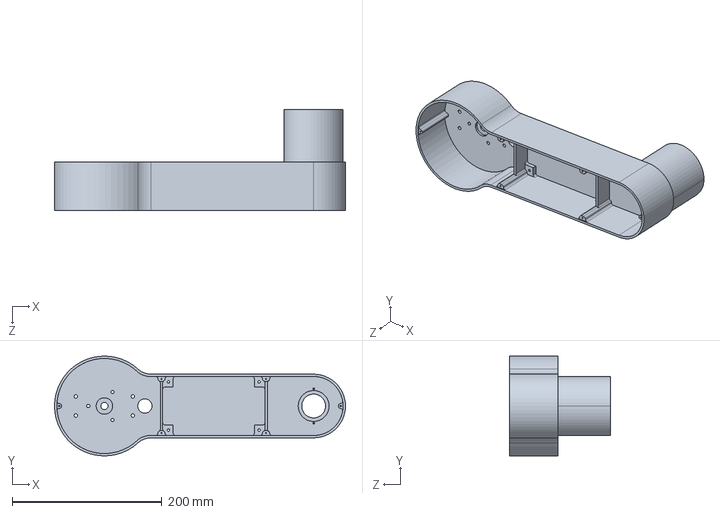
[picture p181: CAD file, 2015-01-28]
Frame/Frame v4/Sponsorship/Motor Link Frame.STEP
388.6 x 133.3 x 134.9 mm
