NxRLab/gibbot/Frame/CAD v3/10.5in Frame/3D Printing/Motor Link Frame (undersized Holes).SLDPRT

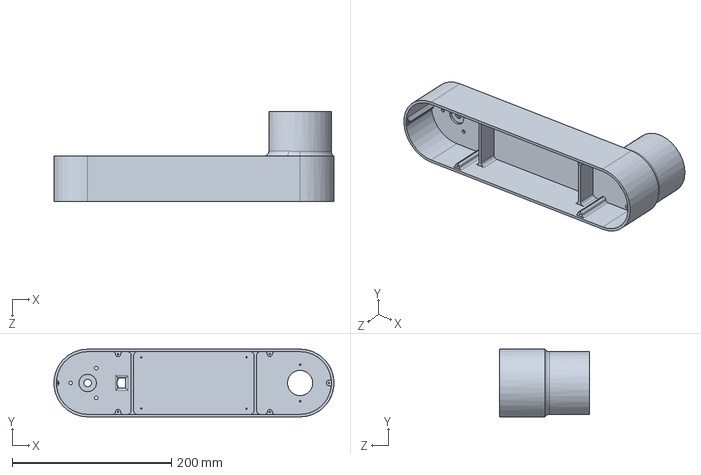
[picture p182: CAD file, 2014-04-11]
Frame/CAD v3/10.5in Frame/3D Printing/Motor Link Frame (undersized Holes).SLDPRT
351.6 x 85.1 x 113.4 mm
