NxRLab/gibbot/Frame/Frame v4/SOLIDWORKS/Gear/Ring Gear.SLDPRT

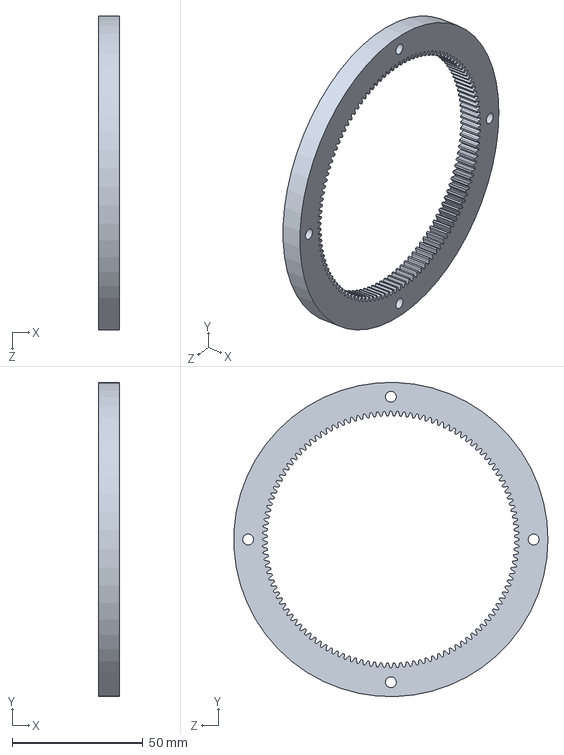
[picture p183: CAD file, 2014-12-19]
Frame/Frame v4/SOLIDWORKS/Gear/Ring Gear.SLDPRT
8.00 x 119.9 x 119.9 mm
