NxRLab/gibbot/Frame/CAD v3/10.5in Frame/Battery PCB.SLDPRT

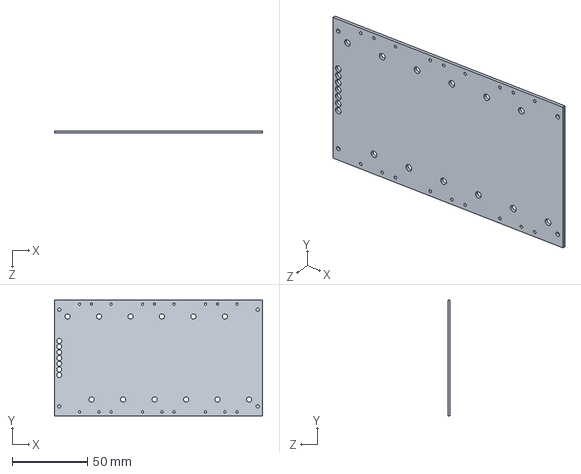
[picture p184: CAD file, 2014-04-11]
Frame/CAD v3/10.5in Frame/Battery PCB.SLDPRT
138.4 x 77.1 x 1.59 mm
