NxRLab/gibbot/Frame/CAD v3/9.4in. Frame/Motor Link Acrylic Cover.SLDPRT

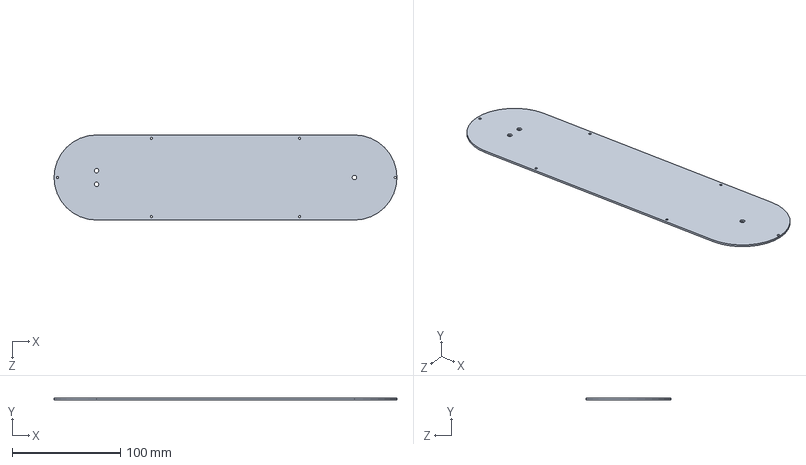
[picture p185: CAD file, 2014-05-01]
Frame/CAD v3/9.4in. Frame/Motor Link Acrylic Cover.SLDPRT
317.5 x 1.59 x 78.7 mm
