NxRLab/gibbot/Frame/Frame v4/SOLIDWORKS/Batteries/Battery Holder - keystone-PN1043.SLDPRT

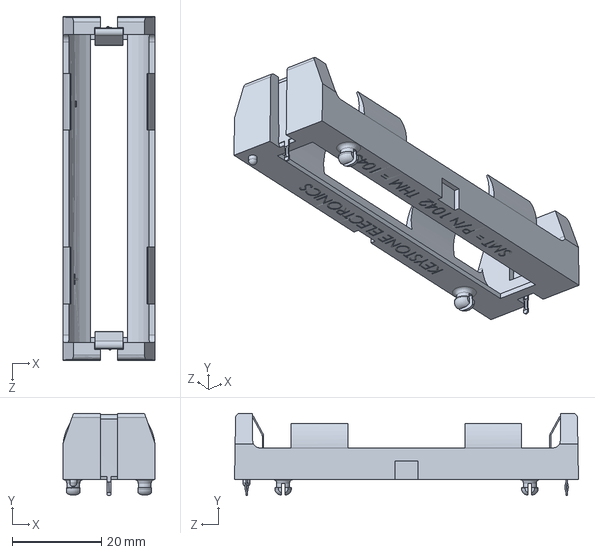
[picture p186: CAD file, 2014-12-19]
Frame/Frame v4/SOLIDWORKS/Batteries/Battery Holder - keystone-PN1043.SLDPRT
20.7 x 18.5 x 77.1 mm
