NxRLab/gibbot/Frame/Frame v4/SOLIDWORKS/Wall Link Frame.SLDPRT

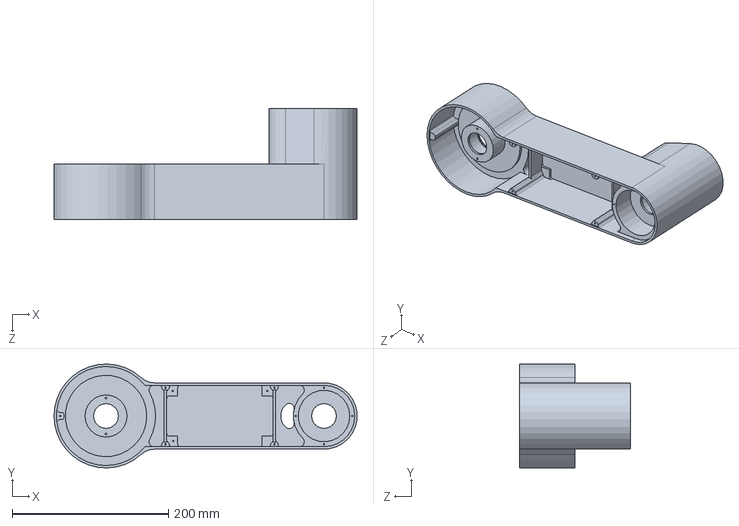
[picture p187: CAD file, 2014-12-19]
Frame/Frame v4/SOLIDWORKS/Wall Link Frame.SLDPRT
388.4 x 133.3 x 142.9 mm
