NxRLab/gibbot/Frame/CAD v3/10.5in Frame/magnet holder.SLDPRT

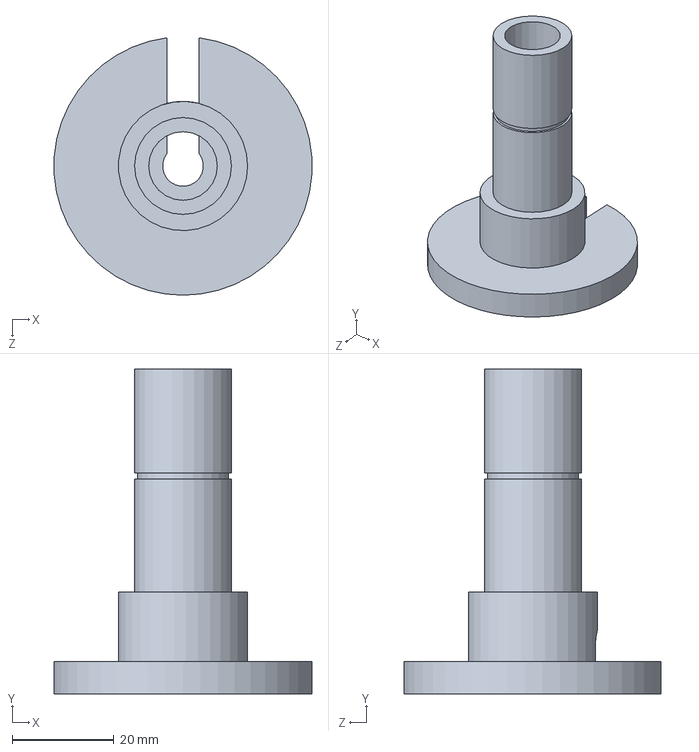
[picture p188: CAD file, 2014-04-11]
Frame/CAD v3/10.5in Frame/magnet holder.SLDPRT
50.7 x 63.9 x 50.6 mm
