NxRLab/gibbot/Frame/CAD v3/9.4in. Frame/Wall Link Acrylic Cover.SLDPRT

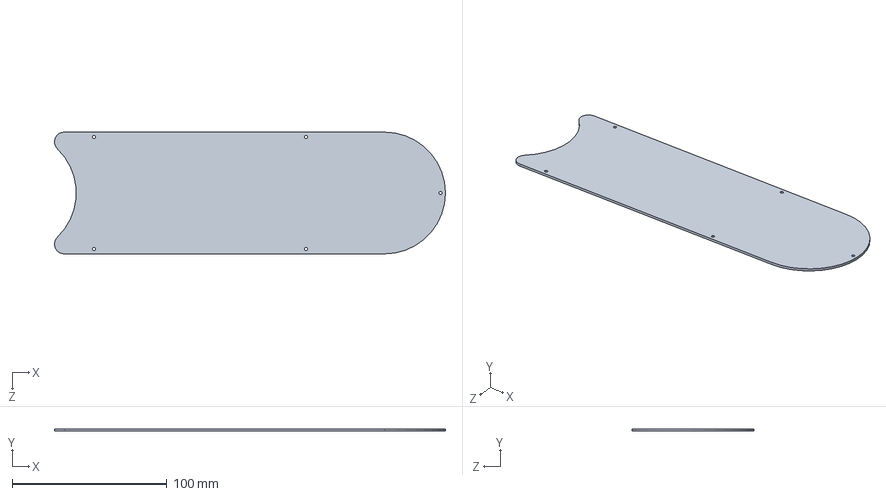
[picture p189: CAD file, 2014-05-01]
Frame/CAD v3/9.4in. Frame/Wall Link Acrylic Cover.SLDPRT
252.8 x 1.59 x 78.7 mm
