NxRLab/gibbot/Frame/Frame v4/SOLIDWORKS/Batteries/battery_6612.SLDPRT

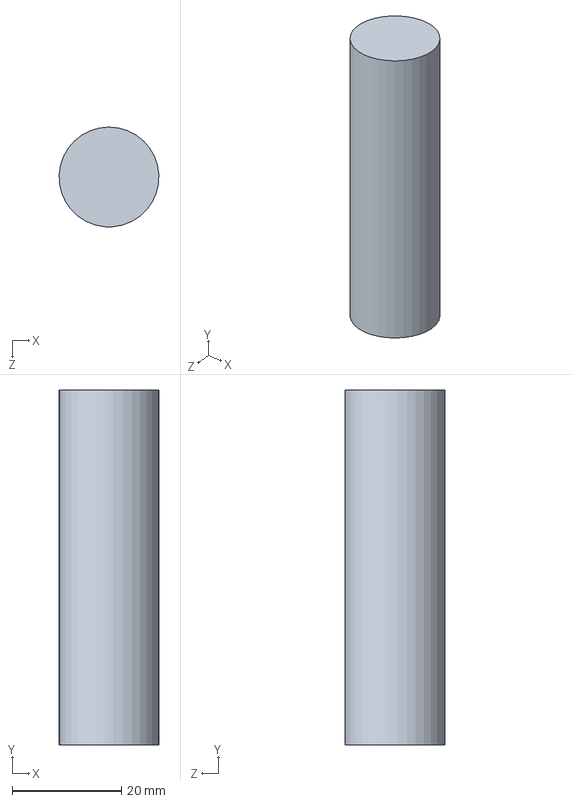
[picture p190: CAD file, 2014-12-19]
Frame/Frame v4/SOLIDWORKS/Batteries/battery_6612.SLDPRT
18.3 x 65.0 x 18.3 mm
