NxRLab/gibbot/Frame/Frame v4/SOLIDWORKS/Magnet Encoders E3-X-750-X-H-D-X.SLDPRT

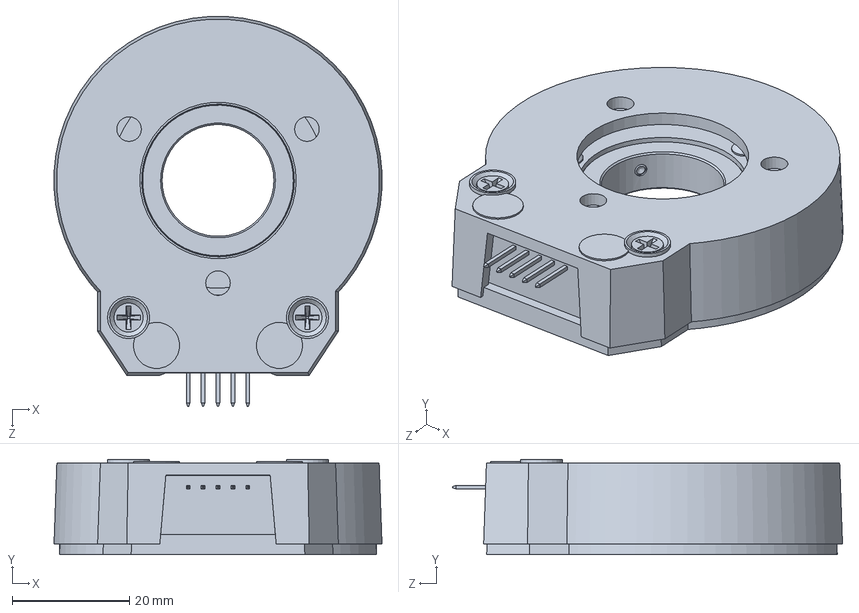
[picture p191: CAD file, 2014-12-19]
Frame/Frame v4/SOLIDWORKS/Magnet Encoders E3-X-750-X-H-D-X.SLDPRT
55.9 x 16.3 x 66.5 mm
