NxRLab/gibbot/Frame/Frame v4/SOLIDWORKS/Shaft_Carrier_Combined.SLDPRT

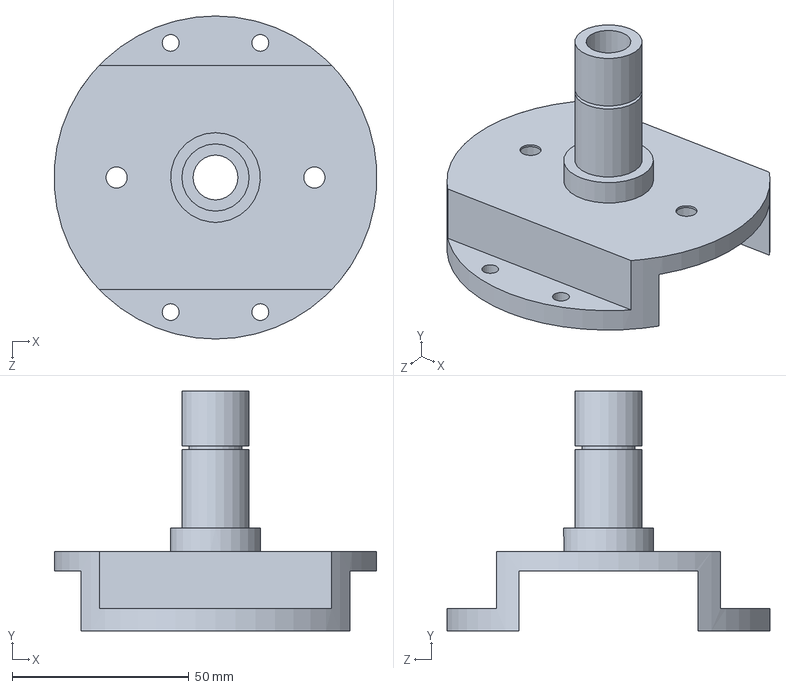
[picture p192: CAD file, 2014-12-19]
Frame/Frame v4/SOLIDWORKS/Shaft_Carrier_Combined.SLDPRT
91.3 x 67.9 x 91.4 mm
