NxRLab/gibbot/Frame/CAD v3/10.5in Frame/Motor Link Acrylic Cover.SLDPRT

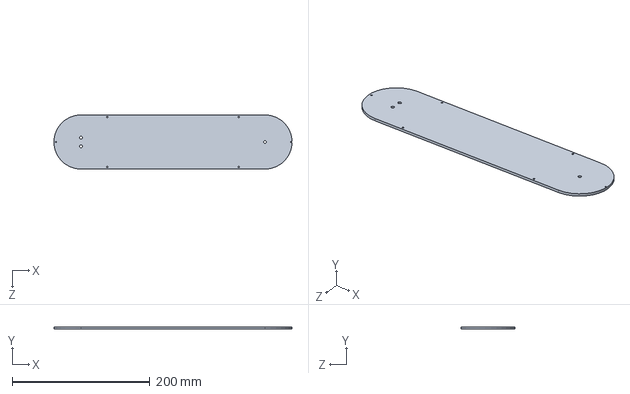
[picture p193: CAD file, 2014-04-11]
Frame/CAD v3/10.5in Frame/Motor Link Acrylic Cover.SLDPRT
345.0 x 3.17 x 78.7 mm
