NxRLab/gibbot/Frame/Frame v4/SOLIDWORKS/Wall Link Cover.SLDPRT

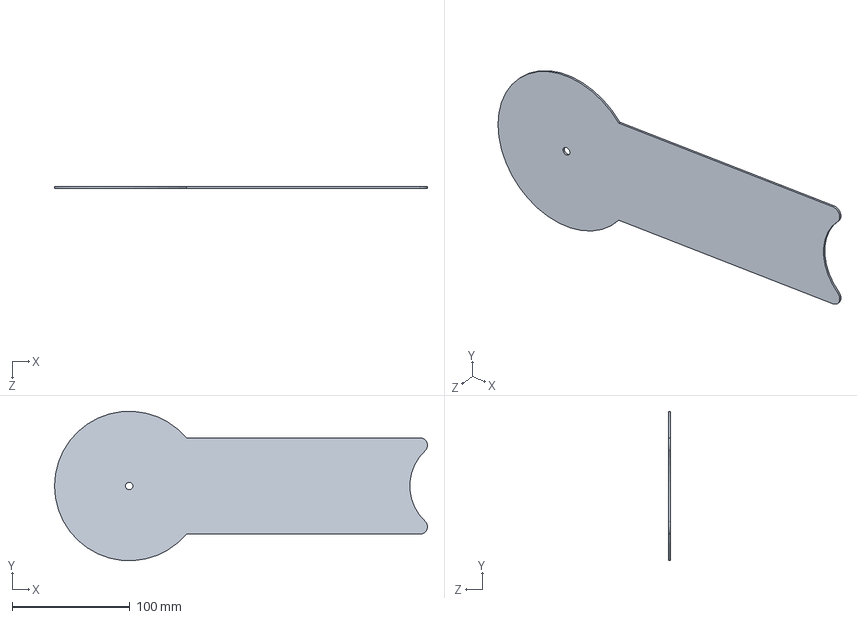
[picture p194: CAD file, 2014-12-19]
Frame/Frame v4/SOLIDWORKS/Wall Link Cover.SLDPRT
317.0 x 126.8 x 1.59 mm
