NxRLab/gibbot/Frame/CAD v3/9.4in. Frame/Motor Link Frame.SLDPRT

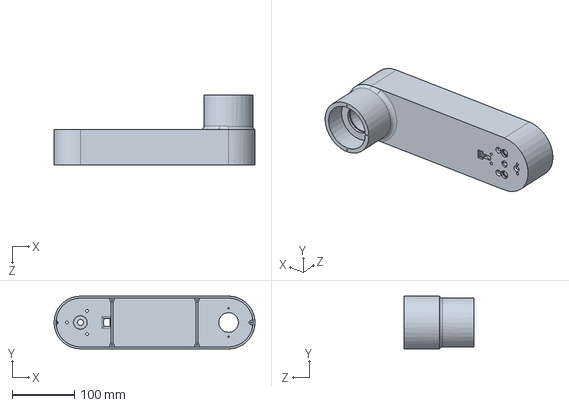
[picture p195: CAD file, 2014-05-01]
Frame/CAD v3/9.4in. Frame/Motor Link Frame.SLDPRT
323.8 x 85.1 x 113.4 mm
