NxRLab/gibbot/Frame/CAD v3/10.5in Frame/Shaft_Carrier_Combined.SLDPRT

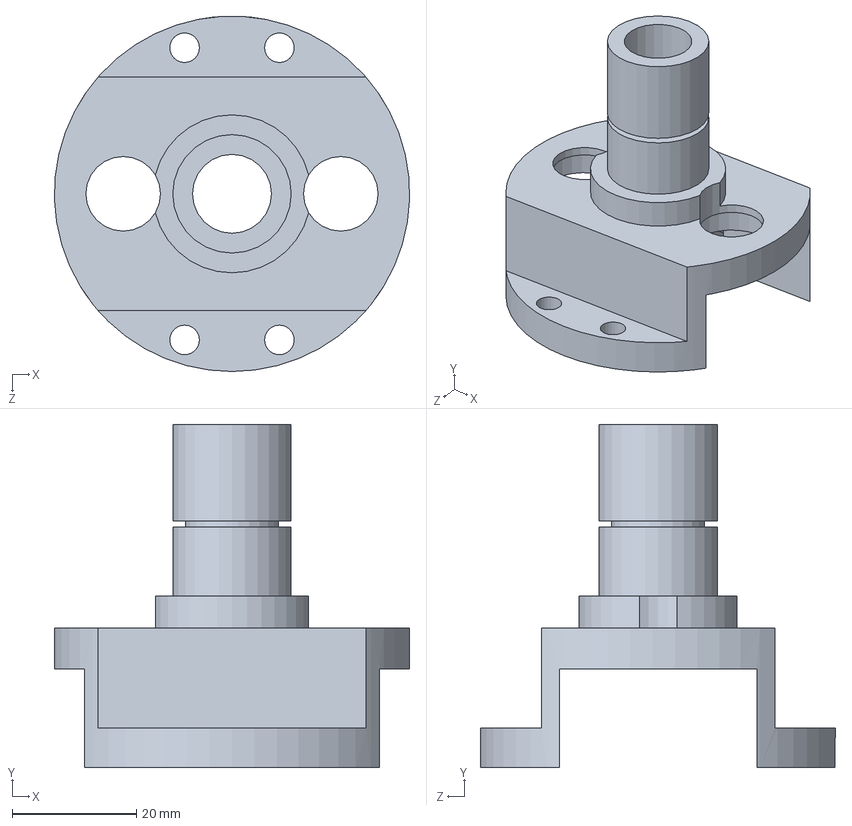
[picture p196: CAD file, 2014-04-11]
Frame/CAD v3/10.5in Frame/Shaft_Carrier_Combined.SLDPRT
57.1 x 55.2 x 57.1 mm
