NxRLab/gibbot/Frame/CAD v3/10.5in Frame/Wall Link Acrylic Cover.SLDPRT

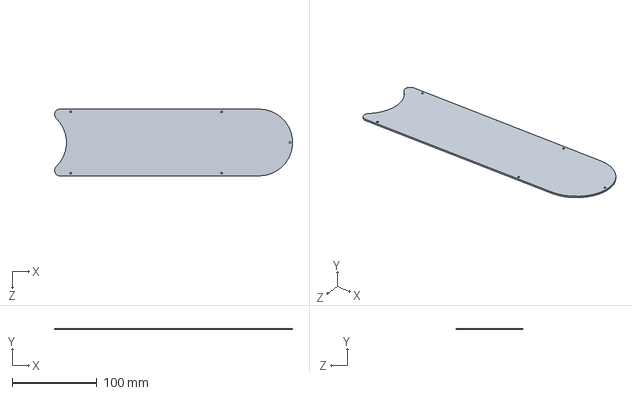
[picture p197: CAD file, 2014-04-11]
Frame/CAD v3/10.5in Frame/Wall Link Acrylic Cover.SLDPRT
280.6 x 1.59 x 78.7 mm
