NxRLab/gibbot/Frame/CAD v3/9.4in. Frame/Steel Plate.SLDPRT

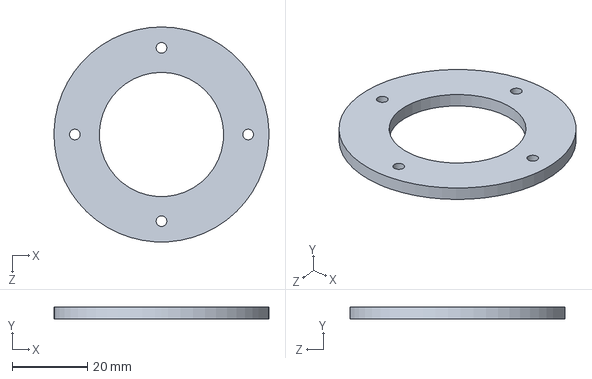
[picture p198: CAD file, 2014-05-01]
Frame/CAD v3/9.4in. Frame/Steel Plate.SLDPRT
57.1 x 3.17 x 57.1 mm
