NxRLab/gibbot/Frame/Frame v4/SOLIDWORKS/Wall Link Cover 2.SLDPRT

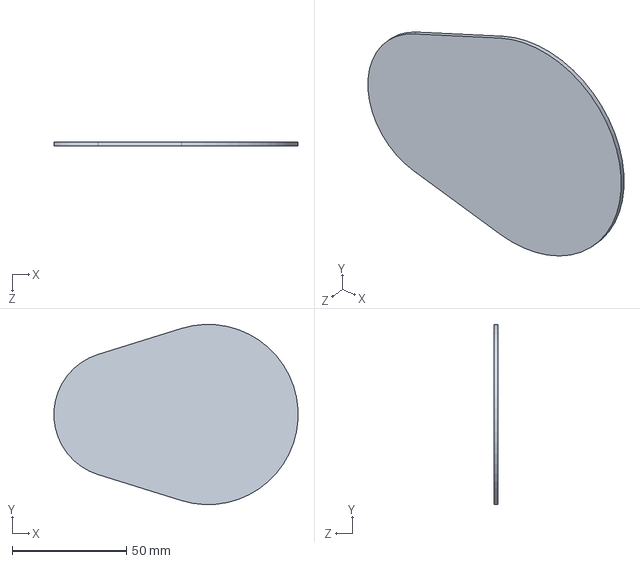
[picture p199: CAD file, 2014-12-19]
Frame/Frame v4/SOLIDWORKS/Wall Link Cover 2.SLDPRT
106.6 x 78.7 x 1.59 mm
