NxRLab/gibbot/Frame/CAD v3/10.5in Frame/#2 Spacer.SLDPRT

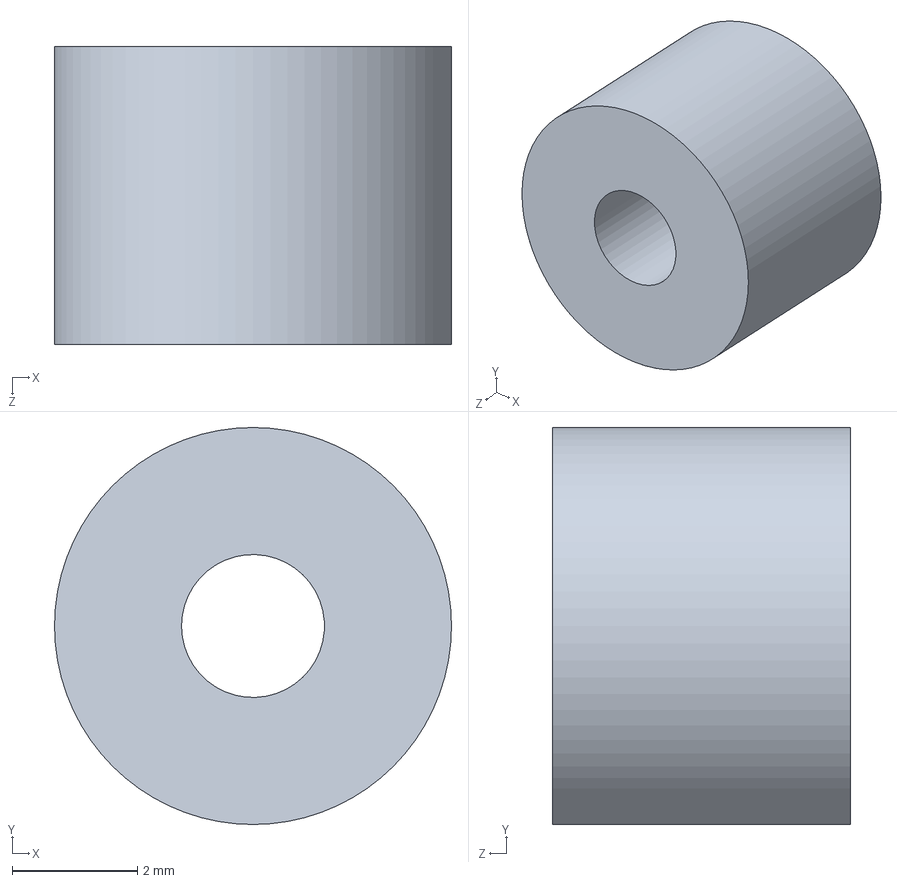
[picture p200: CAD file, 2014-04-11]
Frame/CAD v3/10.5in Frame/#2 Spacer.SLDPRT
6.35 x 6.35 x 4.76 mm
