NxRLab/gibbot/Frame/Frame v4/SOLIDWORKS/Slip Ring M322M1-0202.SLDPRT

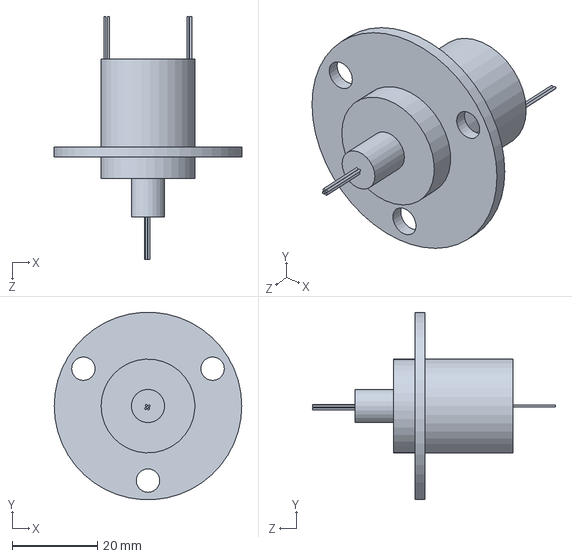
[picture p201: CAD file, 2014-12-19]
Frame/Frame v4/SOLIDWORKS/Slip Ring M322M1-0202.SLDPRT
44.0 x 43.9 x 57.0 mm
