NxRLab/gibbot/Frame/CAD v3/10.5in Frame/Delrin_Ring.SLDPRT

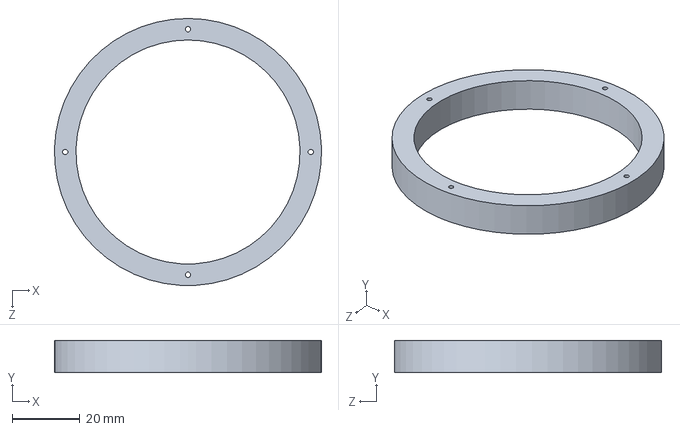
[picture p202: CAD file, 2014-04-11]
Frame/CAD v3/10.5in Frame/Delrin_Ring.SLDPRT
78.7 x 9.53 x 78.7 mm
