NxRLab/gibbot/Frame/Frame v4/SOLIDWORKS/Magnet Holder Motor Link.SLDPRT

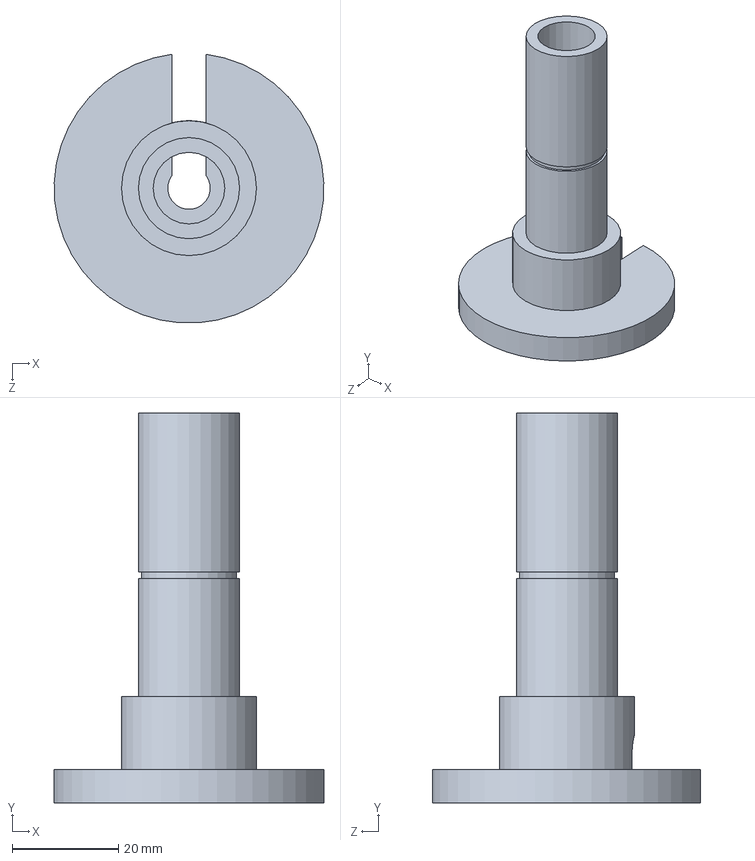
[picture p203: CAD file, 2014-12-19]
Frame/Frame v4/SOLIDWORKS/Magnet Holder Motor Link.SLDPRT
50.8 x 73.4 x 50.5 mm
