NxRLab/gibbot/Frame/Frame v4/SOLIDWORKS/EM237 Magnet.SLDPRT

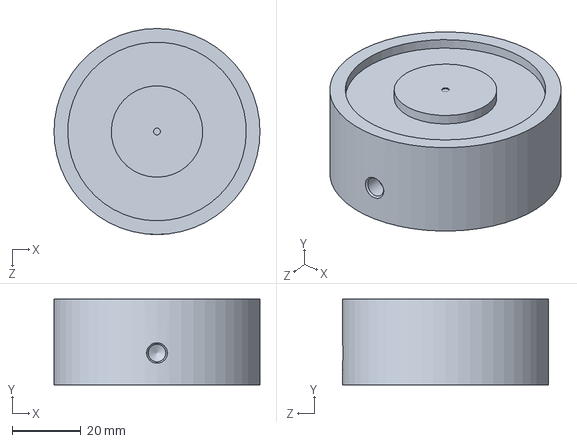
[picture p204: CAD file, 2014-12-19]
Frame/Frame v4/SOLIDWORKS/EM237 Magnet.SLDPRT
60.1 x 25.0 x 60.1 mm
