NxRLab/gibbot/Frame/CAD v3/10.5in Frame/Dowel Pin - .0625.SLDPRT

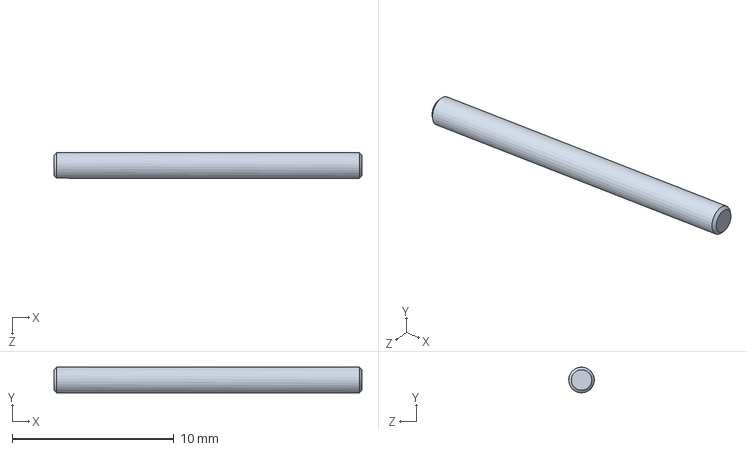
[picture p205: CAD file, 2014-04-09]
Frame/CAD v3/10.5in Frame/Dowel Pin - .0625.SLDPRT
19.1 x 1.58 x 1.59 mm
