NxRLab/gibbot/Frame/CAD v3/10.5in Frame/Bearing-I8mmO16mm.SLDPRT

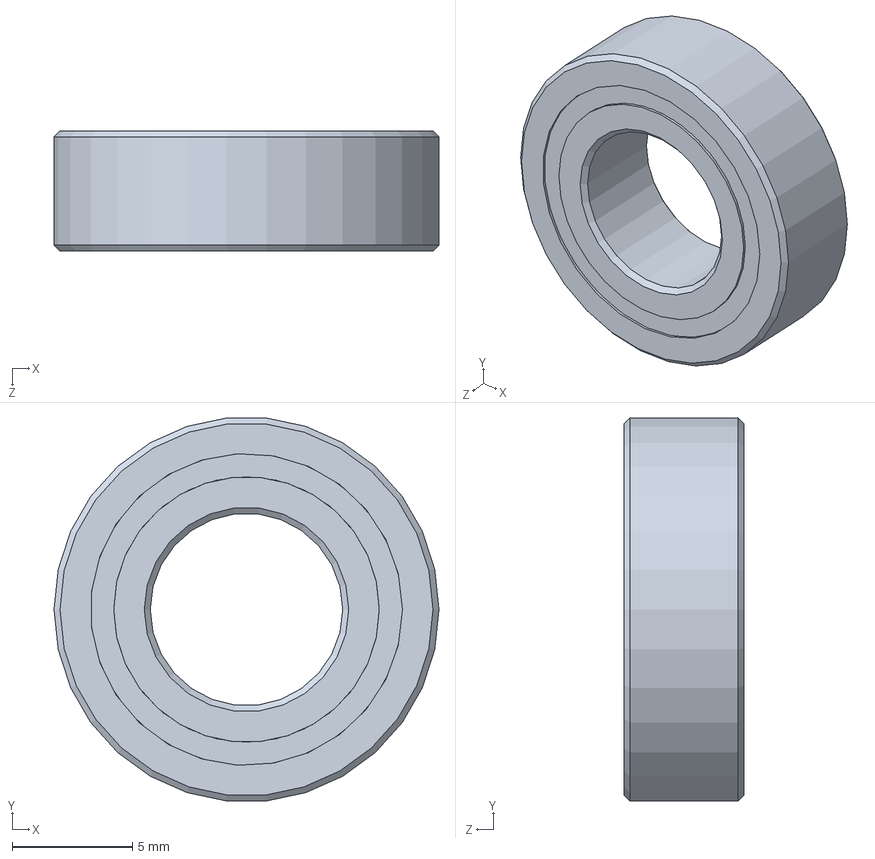
[picture p206: CAD file, 2014-04-09]
Frame/CAD v3/10.5in Frame/Bearing-I8mmO16mm.SLDPRT
16.0 x 15.9 x 5.00 mm
