NxRLab/gibbot/Frame/CAD v3/10.5in Frame/M5 Nylon Spacer.SLDPRT

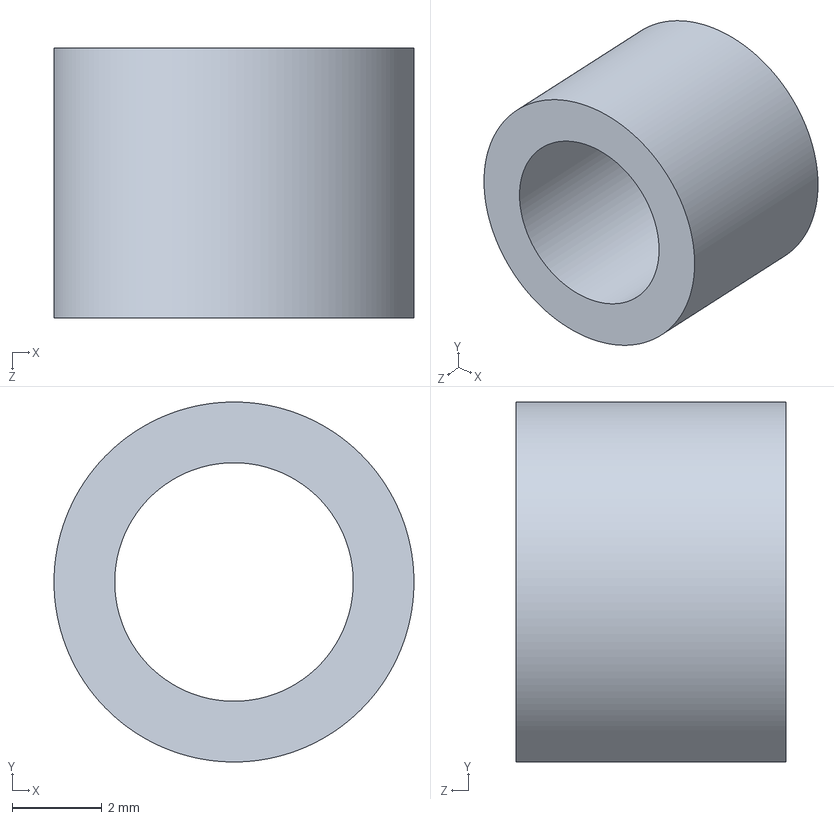
[picture p207: CAD file, 2014-04-09]
Frame/CAD v3/10.5in Frame/M5 Nylon Spacer.SLDPRT
8.00 x 8.00 x 6.00 mm
