NxRLab/gibbot/Frame/CAD v3/10.5in Frame/Neoprene Ring.SLDPRT

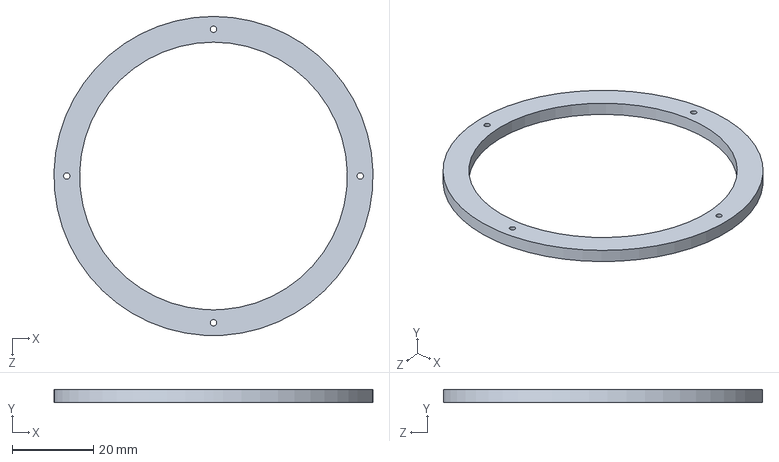
[picture p208: CAD file, 2014-04-09]
Frame/CAD v3/10.5in Frame/Neoprene Ring.SLDPRT
78.7 x 3.17 x 78.7 mm
