NxRLab/gibbot/Frame/CAD v3/10.5in Frame/Slip Ring M322M1-0600.SLDPRT

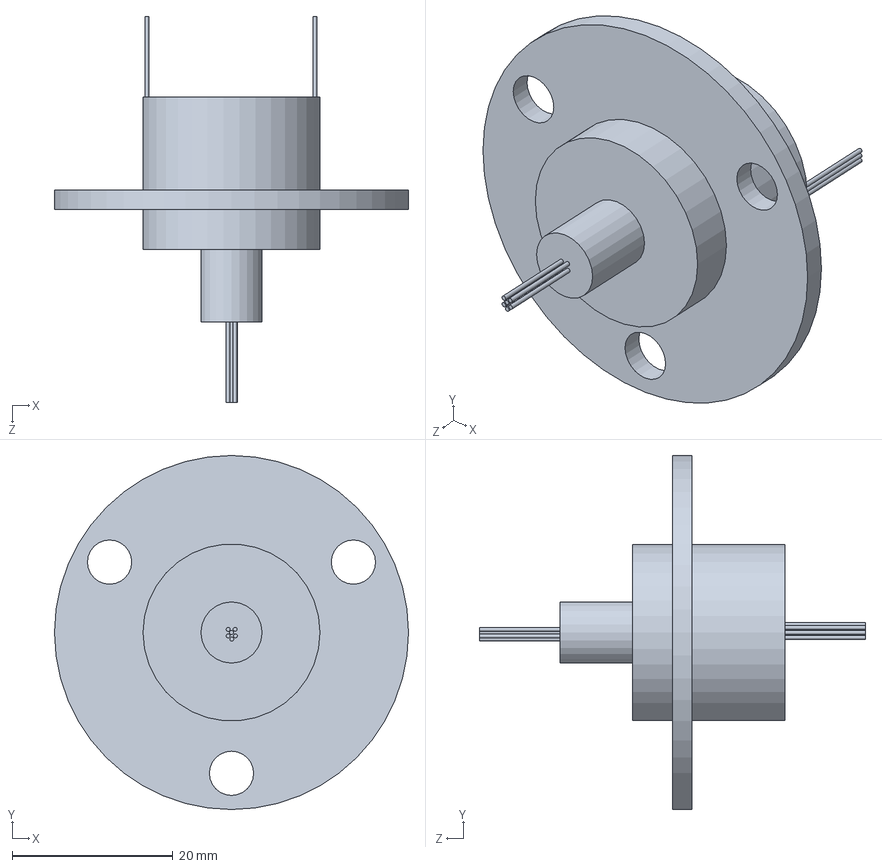
[picture p209: CAD file, 2014-04-09]
Frame/CAD v3/10.5in Frame/Slip Ring M322M1-0600.SLDPRT
44.0 x 44.0 x 48.0 mm
