NxRLab/gibbot/Frame/CAD v3/9.4in. Frame/ring_gear.SLDPRT

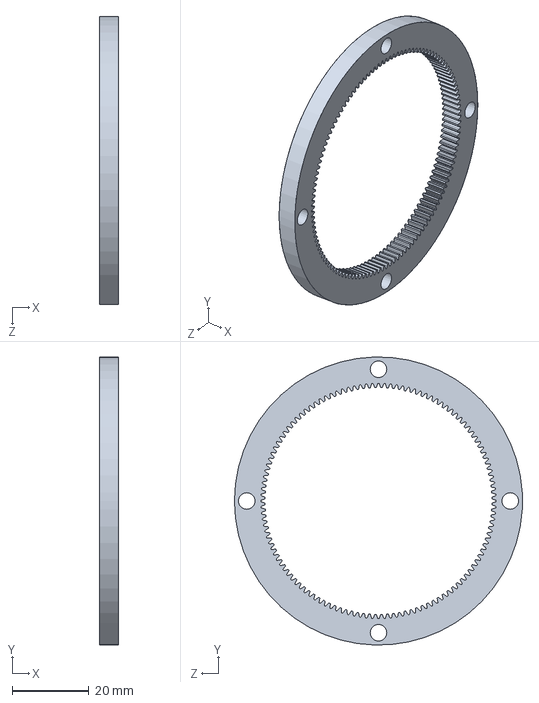
[picture p210: CAD file, 2014-04-09]
Frame/CAD v3/9.4in. Frame/ring_gear.SLDPRT
5.00 x 75.0 x 75.0 mm
