NxRLab/gibbot/Frame/CAD v3/10.5in Frame/Retaining Ring-1.375in.SLDPRT

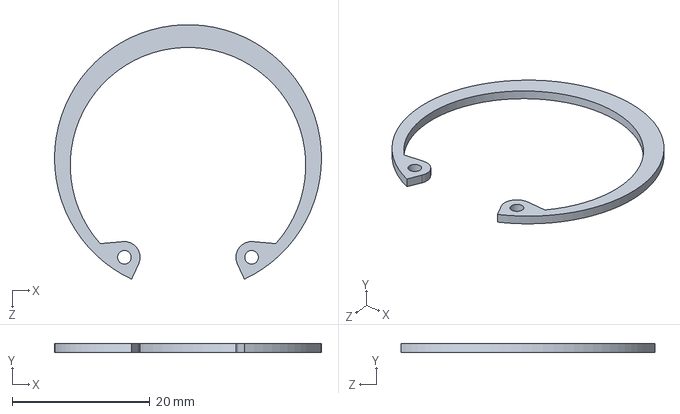
[picture p211: CAD file, 2014-04-04]
Frame/CAD v3/10.5in Frame/Retaining Ring-1.375in.SLDPRT
38.8 x 1.27 x 36.9 mm
