NxRLab/gibbot/Frame/CAD v3/10.5in Frame/1.625 Bore Internal Retaining Ring.SLDPRT

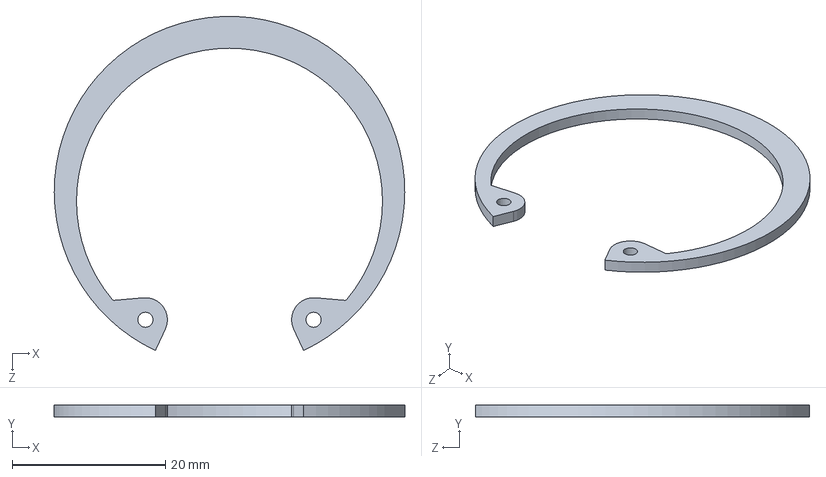
[picture p212: CAD file, 2014-04-04]
Frame/CAD v3/10.5in Frame/1.625 Bore Internal Retaining Ring.SLDPRT
45.8 x 1.57 x 43.7 mm
