NxRLab/gibbot/Frame/CAD v3/9.4in. Frame/Sun Gear.SLDPRT

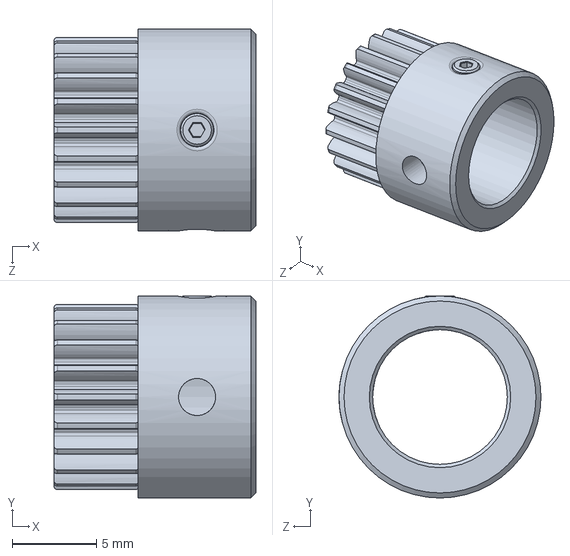
[picture p213: CAD file, 2014-04-04]
Frame/CAD v3/9.4in. Frame/Sun Gear.SLDPRT
12.0 x 12.0 x 12.0 mm
