NxRLab/gibbot/Frame/CAD v3/10.5in Frame/Bearing-.625in.SLDPRT

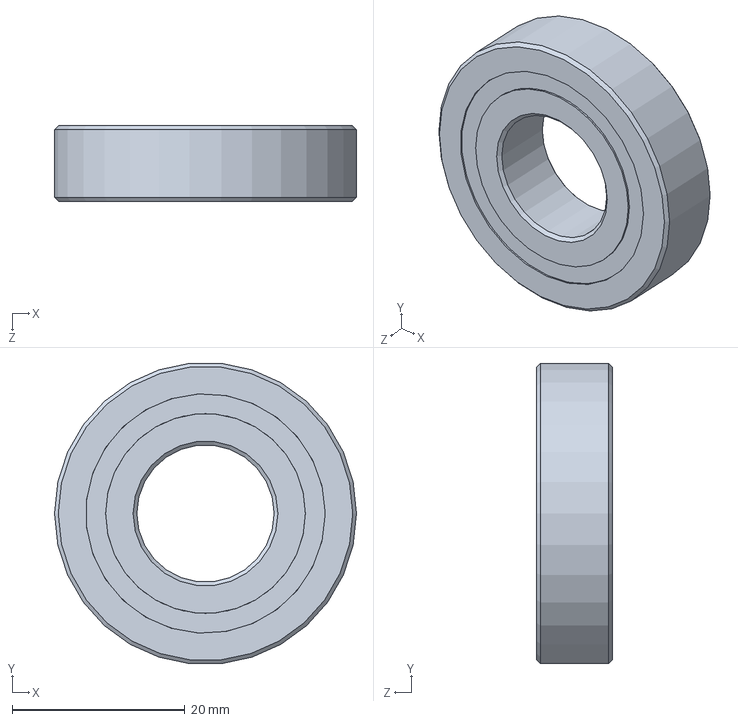
[picture p214: CAD file, 2014-04-04]
Frame/CAD v3/10.5in Frame/Bearing-.625in.SLDPRT
34.9 x 34.7 x 8.73 mm
