NxRLab/gibbot/Frame/CAD v3/9.4in. Frame/carrier_shaft.SLDPRT

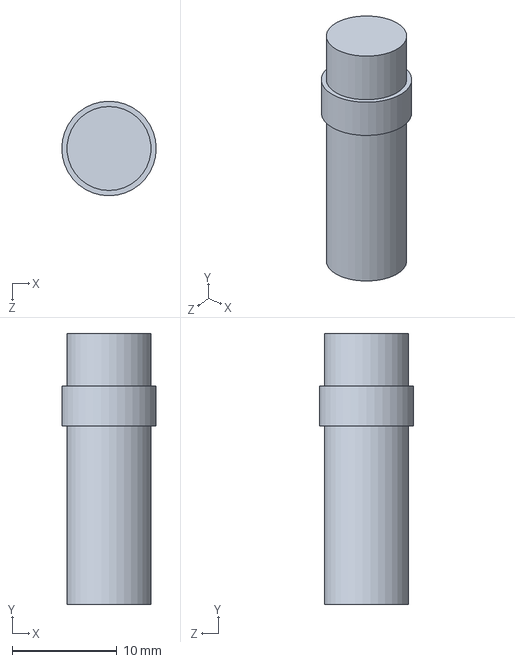
[picture p215: CAD file, 2014-04-04]
Frame/CAD v3/9.4in. Frame/carrier_shaft.SLDPRT
9.00 x 25.8 x 9.00 mm
