NxRLab/gibbot/Frame/CAD v3/10.5in Frame/planet_gear.SLDPRT

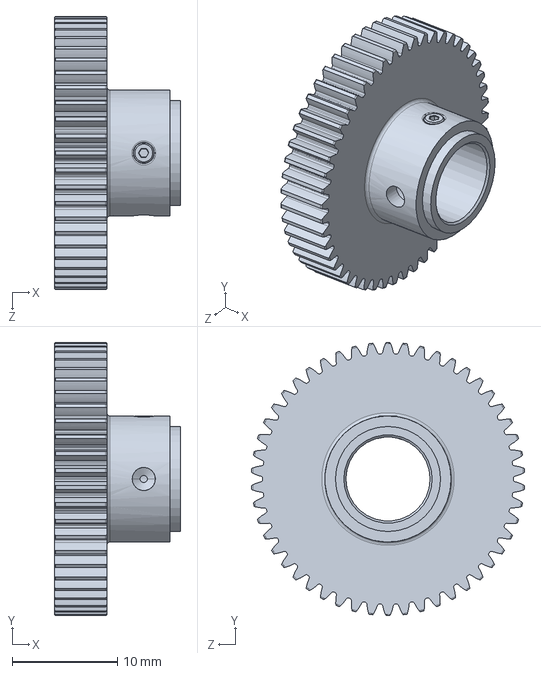
[picture p216: CAD file, 2014-04-04]
Frame/CAD v3/10.5in Frame/planet_gear.SLDPRT
12.0 x 26.0 x 26.0 mm
