NxRLab/gibbot/(list of files, cad)

Other CAD files:
Frame/CAD v3/10.5in Frame/Harness_1-Motor Link.sldasm
Frame/CAD v3/9.4in. Frame/Harness_1-Motor Link.sldasm
Frame/Frame v4/SOLIDWORKS/Motor Link Frame.SLDPRT
Frame/CAD v3/9.4in. Frame/Magnet Encoders E3-X-750-X-H-D-X.SLDPRT
Frame/CAD v3/10.5in Frame/Magnet Encoders E3-X-750-X-H-D-X.SLDPRT
Frame/CAD v3/9.4in. Frame/Wall Link Frame.SLDPRT
Frame/CAD v3/9.4in. Frame/Acrylic Cover 2 Wall Link.SLDPRT
Frame/CAD v3/9.4in. Frame/Shaft_Carrier_Combined.SLDPRT
Frame/CAD v3/10.5in Frame/Wall Link Frame.SLDPRT
Frame/CAD v3/10.5in Frame/Motor Link Frame.SLDPRT
Frame/Frame v4/SOLIDWORKS/magnet holder.SLDPRT
Frame/CAD v3/9.4in. Frame/Slip Ring M322M1-0202.SLDPRT
Frame/CAD v3/10.5in Frame/Slip Ring M322M1-0202.SLDPRT
Frame/CAD v3/10.5in Frame/battery_6612.SLDPRT
Frame/CAD v3/9.4in. Frame/ring_gear_S1E05ZM05S120.SLDPRT
Frame/CAD v3/10.5in Frame/EM237 Magnet.SLDPRT
Frame/CAD v3/9.4in. Frame/EM237 Magnet.SLDPRT
Frame/CAD v3/9.4in. Frame/battery_6612.SLDPRT
Frame/CAD v3/10.5in Frame/ring_gear_S1E05ZM05S120.SLDPRT
Frame/CAD v3/10.5in Frame/EC60 Motor.SLDPRT
Frame/CAD v3/9.4in. Frame/Battery Holder - keystone-PN1043.SLDPRT
Frame/CAD v3/9.4in. Frame/Bearing - .750.SLDPRT
Frame/CAD v3/10.5in Frame/Battery Holder - keystone-PN1043.SLDPRT
Frame/CAD v3/10.5in Frame/Bearing - .750.SLDPRT
Frame/CAD v3/9.4in. Frame/EC60 Motor.SLDPRT
Frame/CAD v1/Assembly and Part Files/001_000X.sldprt
Frame/CAD v1/Assembly and Part Files/1001-2001 ELECTROMAGNET ASSY.sldasm
Frame/CAD v1/Assembly and Part Files/1001-2003 BATTERY LINK ASSY.sldasm
Frame/CAD v1/Assembly and Part Files/1001-3005 ELECTROMAGNET STATOR SHIM.SLDPRT
Frame/CAD v1/Assembly and Part Files/1001-3006,3007,0001 MOTOR LINK HOUSING & COVER, MAGNET TEST FIXTURE.SLDPRT
Frame/CAD v1/Assembly and Part Files/1001-3008 LINK CONNECTION SHAFT.SLDPRT
Frame/CAD v1/Assembly and Part Files/1001-3009 MODIFIED PINION GEAR.SLDPRT
Frame/CAD v1/Assembly and Part Files/1001-3010 MOTOR MOUNTING FLANGE.SLDPRT
Frame/CAD v1/Assembly and Part Files/1001-3011 MODIFIED DRIVEN GEAR.SLDPRT
Frame/CAD v1/Assembly and Part Files/1001-3012 BALL GLIDER.SLDPRT
Frame/CAD v1/Assembly and Part Files/8224 with gearhead and encoder.SLDPRT
Frame/CAD v1/Assembly and Part Files/90128A105.SLDPRT
Frame/CAD v1/Assembly and Part Files/90128A242.SLDPRT
Frame/CAD v1/Assembly and Part Files/90272A091.SLDPRT
Frame/CAD v1/Assembly and Part Files/91251A113.SLDPRT
Frame/CAD v1/Assembly and Part Files/91290A110.SLDPRT
Frame/CAD v1/Assembly and Part Files/96562A106.SLDPRT
Frame/CAD v1/Assembly and Part Files/97633A250.SLDPRT
Frame/CAD v1/Assembly and Part Files/98381A438 (1).SLDPRT
Frame/CAD v1/Assembly and Part Files/98511A521.SLDPRT
Frame/CAD v1/Assembly and Part Files/ASME B18.8.2 - 0.0939x0.5.sldprt
Frame/CAD v1/Assembly and Part Files/Amax26 - 110209.SLDPRT
Frame/CAD v1/Assembly and Part Files/Battery 18650.SLDPRT
Frame/CAD v1/Assembly and Part Files/Bearing - Delrin 6455K640.SLDPRT
Frame/CAD v1/Assembly and Part Files/Bearing 6455K12.SLDPRT
Frame/CAD v1/Assembly and Part Files/Bowed Retaining Ring 98398A153.SLDPRT
Frame/CAD v1/Assembly and Part Files/Bumper 9541K3.SLDPRT
Frame/CAD v1/Assembly and Part Files/Canon TR-36.SLDPRT
Frame/CAD v1/Assembly and Part Files/E7P-X-197-S-C-T-X.SLDPRT
Frame/CAD v1/Assembly and Part Files/Enc 22.sldasm
Frame/CAD v1/Assembly and Part Files/GP26B 144029.sldasm
Frame/CAD v1/Assembly and Part Files/HX-SHCS 0.112-40x0.188x0.188-N.SLDPRT
Frame/CAD v1/Assembly and Part Files/HX-SHCS 0.25-20x1x1-N.SLDPRT
Frame/CAD v1/Assembly and Part Files/Locknut 94820A225.SLDPRT
Frame/CAD v1/Assembly and Part Files/Maxon Motor-Gearhead-Encoder.SLDASM
Frame/CAD v1/Assembly and Part Files/NU Electronics Board.SLDPRT
Frame/CAD v1/Assembly and Part Files/Oring -133 McMaster 5577K133.SLDPRT
Frame/CAD v1/Assembly and Part Files/Retaining Ring 97633A200.SLDPRT
Frame/CAD v1/Assembly and Part Files/Retaining Ring 99142A480.SLDPRT
Frame/CAD v1/Assembly and Part Files/Retaining Ring 99142A560.SLDPRT
Frame/CAD v1/Assembly and Part Files/Set Screw 91385A191.SLDPRT
Frame/CAD v1/Assembly and Part Files/Standoff 93620A103.SLDPRT
Frame/CAD v1/Assembly and Part Files/TAQCHO.sldprt
Frame/CAD v1/Assembly and Part Files/User Library-5mm led w_bushing.SLDPRT
Frame/CAD v1/Assembly and Part Files/VH_200.sldprt
Frame/CAD v1/Assembly and Part Files/Washer 99040A505.SLDPRT
Frame/CAD v1/Assembly and Part Files/Washer 99432A374.SLDPRT
Frame/CAD v1/Drawings and PDFs/1001-0001-01 ELECTROMAGNET TEST FIXTURE.SLDDRW
Frame/CAD v1/Drawings and PDFs/1001-0002-01 ELECTROMAGNET WINDING MANDREL.SLDDRW
Frame/CAD v1/Drawings and PDFs/1001-2001-03 ELECTROMAGNET ASSY.SLDDRW
Frame/CAD v1/Drawings and PDFs/1001-2002-01 MOTOR LINK ASSY.SLDDRW
Frame/CAD v1/Drawings and PDFs/1001-2003-01 BATTERY LINK ASSY.SLDDRW
Frame/CAD v1/Drawings and PDFs/1001-3001-03 ELECTROMAGNET STATOR.SLDDRW
Frame/CAD v1/Drawings and PDFs/1001-3002-03 ELECTROMAGNET ROTOR.SLDDRW
Frame/CAD v1/Drawings and PDFs/1001-3003-03 ELECTROMAGNET SPOOL.SLDDRW
Frame/CAD v1/Drawings and PDFs/1001-3004-02 ELECTROMAGNET SHAFT.SLDDRW
Frame/CAD v1/Drawings and PDFs/1001-3005-01 ELECTROMAGNET STATOR SHIM.SLDDRW
Frame/CAD v1/Drawings and PDFs/1001-3006-01 MOTOR LINK HOUSING.SLDDRW
Frame/CAD v1/Drawings and PDFs/1001-3007-01 MOTOR LINK DORSAL COVER.SLDDRW
Frame/CAD v1/Drawings and PDFs/1001-3008-01 LINK CONNECTION SHAFT.SLDDRW
Frame/CAD v1/Drawings and PDFs/1001-3009-01 MODIFIED PINION GEAR.SLDDRW
Frame/CAD v1/Drawings and PDFs/1001-3010-01 MOTOR MOUNTING FLANGE.SLDDRW
Frame/CAD v1/Drawings and PDFs/1001-3011-01 MODIFIED DRIVEN GEAR.SLDDRW
Frame/CAD v1/Drawings and PDFs/1001-3012-01 BALL GLIDER.SLDDRW
Frame/CAD v1/Drawings and PDFs/1001-3013-01 BATTERY LINK HOUSING.SLDDRW
Frame/CAD v1/Drawings and PDFs/1001-3014-01 BATTERY LINK DORSAL COVER.SLDDRW
Frame/CAD v1/Drawings and PDFs/1001-3015-01 BATTERY LINK PALMAR COVER.SLDDRW
Frame/CAD v1/Drawings and PDFs/PDFs/1001-3005-01 ELECTROMAGNET STATOR SHIM.DXF
Frame/CAD v1/Drawings and PDFs/PDFs/1001-3006-01 MOTOR LINK HOUSING.DXF
Frame/CAD v1/Drawings and PDFs/PDFs/1001-3007-01 MOTOR LINK DORSAL COVER.DXF
Frame/CAD v1/Drawings and PDFs/PDFs/1001-3010-01 MOTOR MOUNTING FLANGE.DXF
Frame/CAD v1/Drawings and PDFs/PDFs/1001-3013-01 BATTERY LINK HOUSING.DXF
Frame/CAD v1/Drawings and PDFs/PDFs/1001-3014-01 BATTERY LINK DORSAL COVER.DXF
Frame/CAD v1/Drawings and PDFs/PDFs/1001-3015-01 BATTERY LINK PALMAR COVER.DXF
Frame/CAD v2/1393671.sldprt
Frame/CAD v2/1393804.sldprt
Frame/CAD v2/1393805.sldprt
Frame/CAD v2/1393806_ASM.sldasm
Frame/CAD v2/1393835_ASM.sldasm
Frame/CAD v2/1393836.sldprt
Frame/CAD v2/1393837.sldprt
Frame/CAD v2/60355K509_bearing_1in_ID_mcmaster.SLDPRT
Frame/CAD v2/6621_holder_10.SLDPRT
Frame/CAD v2/6621_holder_5.SLDPRT
Frame/CAD v2/6621_holder_9.SLDPRT
Frame/CAD v2/90272A080_screw2-56_mcmaster.SLDPRT
Frame/CAD v2/90272A106_screw4-40_mcmaster.SLDPRT
Frame/CAD v2/91294A190_flathead_screw_M4x10_mcmaster.SLDPRT
Frame/CAD v2/91390A149_setscrew_mcmaster.SLDPRT
Frame/CAD v2/91698A428_flathead_screw_M4x10_mcmaster.SLDPRT
Frame/CAD v2/92949A263_buttonhead_screw_10-32x.375_mcmaster.SLDPRT
Frame/CAD v2/94639A464_spacer_mcmaster.SLDPRT
Frame/CAD v2/97633A230_snapring_ext_.625.SLDPRT
Frame/CAD v2/97633A300_snapring_ext_1_mcmaster.SLDPRT
Frame/CAD v2/98541A116_snapring_ext_8mm.SLDPRT
Frame/CAD v2/99142A540_snapring_int_1.5in_mcmaster.SLDPRT
Frame/CAD v2/99142A590_snapring_int_2in_mcmaster.SLDPRT
Frame/CAD v2/BatteryBox_6.SLDPRT
Frame/CAD v2/BatteryBox_6batt.SLDPRT
Frame/CAD v2/BatteryBox_8.SLDPRT
Frame/CAD v2/BatteryBox_9.SLDPRT
Frame/CAD v2/Battery_A123.SLDPRT
Frame/CAD v2/CAM/Bottom_Arm_Blank.prt
Frame/CAD v2/CAM/Bottom_Arm_Mfg.prt
Frame/CAD v2/CAM/Top_Arm_Blank.prt
Frame/CAD v2/CAM/Top_Arm_Mfg.prt
Frame/CAD v2/CAM/frame_bottom.prt
Frame/CAD v2/CAM/frame_top.prt
Frame/CAD v2/E3-64-500-NE-H-D-B_encoder.SLDPRT
Frame/CAD v2/E3-X-625-X-H-D-X.SLDPRT
Frame/CAD v2/EC60_gear_assm.SLDASM
Frame/CAD v2/EC60_motor_12_198_IP00_STEP.sldasm
Frame/CAD v2/EM237 Generic Model.SLDPRT
Frame/CAD v2/NU Electronics Board.SLDPRT
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
