NxRLab/gibbot/PCB/V8/V8Print1/V8Print1.TXT

%
M48
M72
T01C0.0236
T02C0.0276
T03C0.0300
T04C0.0315
T05C0.0354
T06C0.0400
T07C0.0433
T08C0.0472
T09C0.0550
T10C0.0583
T11C0.0591
T12C0.0710
T13C0.1120
T14C0.1181
T15C0.1539
T16C0.1550
%
T01
X11816Y6107
X15016Y3127
X19226Y4207
X19356Y3582
X19771Y2912
X20376Y2457
X21186Y3252
X20781Y3697
X20496Y4232
X20336Y4782
X20456Y6142
X19451Y6127
X17581Y7557
X22576Y3662
X23946Y3557
X25166Y3732
X26306Y3717
X24866Y5082
X25601Y5142
X23786Y5557
X22826Y5142
X27906Y5557
X28096Y5082
X27976Y3962
X29051Y5657
X30046Y5147
X30321Y5697
X29436Y6442
X31941Y4507
X32111Y2872
X31506Y2257
X30941Y1707
X27736Y1512
X32591Y8132
X34731Y8187
X35766Y8187
X37091Y8557
X37081Y9492
X39446Y10222
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
