NxRLab/gibbot/PCB/V8/V8Print2/V8Print2.TXT

%
M48
M72
T01C0.0236
T02C0.0315
T03C0.0400
T04C0.0433
T05C0.0472
T06C0.0591
T07C0.0630
%
T01
X15001Y6302
X17701Y6252
X18801Y6502
X19301Y7052
X21701Y6152
X22551Y6202
X23201Y6202
X23851Y6002
X25601Y4902
X26601Y4952
X27251Y4652
X27501Y3952
X29201Y3102
X25451Y2552
X24551Y2552
X24551Y1802
X21801Y2602
X21701Y4152
X27601Y7052
X28201Y7152
X28801Y7152
X27601Y7852
X28201Y8002
X28801Y8002
X28551Y9252
X27901Y9052
X26501Y10302
X27051Y10652
X26501Y11752
X23101Y11352
X19501Y12652
X17001Y11552
X16751Y10102
X16351Y9452
X15001Y8602
X20051Y8252
X22101Y8252
X23901Y8252
X24151Y7502
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
