NxRLab/gibbot/PCB/Battery Manager/BatteryManagerV1_Print/BatteryPrintV1.TXT

%
M48
M72
T01C0.0197
T02C0.0236
T03C0.0240
T04C0.0300
T05C0.0315
T06C0.0320
T07C0.0400
T08C0.0472
T09C0.0583
T10C0.0591
T11C0.1539
%
T01
X39936Y11351
X40936Y11351
X44266Y11351
X45266Y11351
X43101Y7601
X42101Y7601
X53601Y11351
X54601Y11351
X58601Y11351
X59601Y11351
X43101Y22601
X42101Y22601
T02
X47101Y28001
X43651Y30301
X37851Y30951
X46401Y33801
X27766Y24301
X28481Y21791
X23666Y21396
X22836Y21671
X20976Y21501
X18666Y20136
X18396Y19636
X18156Y19171
X19116Y18201
X19441Y18571
X20111Y19136
X20421Y19886
X21436Y17916
X20396Y17401
X18396Y16806
X16756Y18611
X16371Y19521
X15221Y19861
X14656Y19491
X15316Y18931
X13106Y18996
X13001Y20011
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
