NxRLab/gibbot/PCB/Gibbot v4/Control CAM/Gibbot v4.2print.TXT

%
M48
M72
T01C0.0236
T02C0.0315
T03C0.0394
T04C0.0400
T05C0.0433
T06C0.0472
T07C0.0591
T08C0.0600
T09C0.0630
T10C0.0710
T11C0.0940
T12C0.1181
T13C0.1550
%
T01
X1731Y1994
X4101Y4054
X5601Y3054
X7101Y3054
X7101Y4054
X5101Y7554
X7701Y11354
X8301Y11354
X5851Y11954
X4001Y14554
X2171Y14414
X3521Y16224
X3266Y16904
X3601Y18254
X3951Y18874
X2701Y19754
X1951Y19674
X4991Y21994
X4951Y22654
X5901Y22604
X6701Y21504
X7751Y21504
X8401Y20954
X9451Y21254
X10701Y21254
X10151Y20414
X11551Y20404
X12851Y19754
X15701Y19704
X15851Y18304
X14001Y17404
X16471Y15834
X16471Y15114
X16581Y14154
X16591Y13514
X15551Y11804
X17201Y8804
X17201Y8054
X17201Y7054
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
