NxRLab/gibbot/PCB/V7/V7Print/V7Print.TXT

%
M48
M72
T01C0.0236
T02C0.0300
T03C0.0315
T04C0.0354
T05C0.0394
T06C0.0400
T07C0.0433
T08C0.0472
T09C0.0583
T10C0.0591
T11C0.0630
T12C0.0710
T13C0.1102
T14C0.1181
T15C0.1539
T16C0.1550
%
T01
X5504Y4630
X7054Y4830
X7128Y5540
X10654Y5080
X10654Y6030
X14604Y5730
X15304Y6330
X16654Y6680
X16604Y7630
X15304Y7778
X14604Y7130
X18304Y7930
X20604Y7580
X21254Y7580
X23104Y8970
X21254Y9278
X22889Y9975
X26104Y11230
X26409Y10530
X27909Y10995
X28879Y10725
X29849Y11125
X28664Y11545
X26709Y12235
X32104Y12230
X34204Y12780
X35154Y12580
X35045Y12063
X36104Y12930
X35154Y13180
X35404Y13730
X35304Y14780
X33204Y14580
X32754Y14080
X31254Y13980
X29154Y15330
X29004Y16230
X29004Y17180
X27554Y17230
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
