NxRLab/gibbot/PCB/V5/CAM/print.TXT

%
M48
M72
T01C0.0236
T02C0.0300
T03C0.0315
T04C0.0320
T05C0.0354
T06C0.0394
T07C0.0400
T08C0.0433
T09C0.0472
T10C0.0583
T11C0.0591
T12C0.0630
T13C0.0710
T14C0.1102
T15C0.1181
T16C0.1539
T17C0.1550
%
T01
X5453Y3984
X5863Y4864
X13703Y3404
X16953Y3404
X20203Y3404
X23453Y3404
X22853Y5004
X24203Y5554
X24203Y6454
X23803Y7904
X21553Y8154
X20353Y7854
X20053Y7254
X18603Y8204
X18053Y8195
X17503Y8204
X17553Y9304
X18953Y10104
X19213Y10554
X18053Y10754
X18603Y11154
X21553Y9634
X20583Y9504
X22953Y9604
X24753Y9604
X24753Y10654
X26453Y11304
X26003Y11804
X26653Y12404
X28603Y11854
X29003Y11454
X30203Y11354
X34603Y11904
X32353Y12754
X34353Y13154
X35853Y14454
X35403Y14904
X34153Y15254
X33103Y14654
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
