NxRLab/gibbot/Documentation/Images/Other/Broken 3D printed bridge.JPG

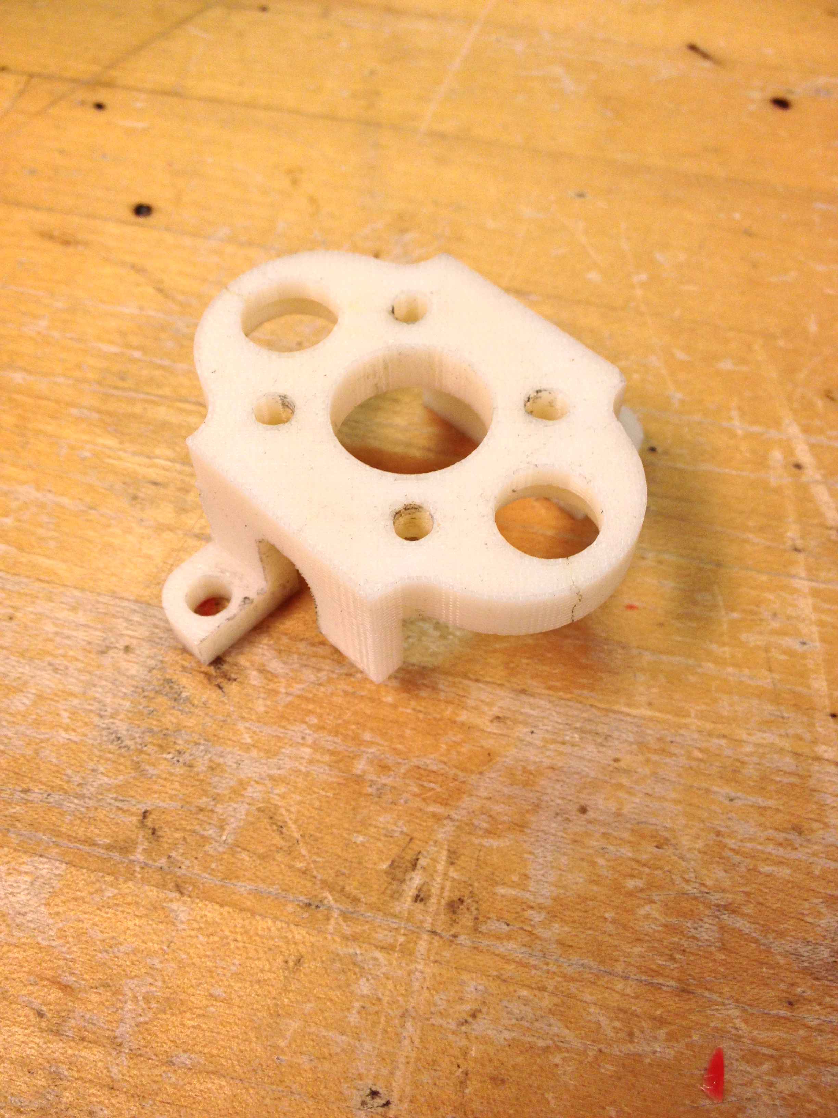
Documentation/Images/Other/Broken 3D printed bridge.JPG
