NxRLab/gibbot/Documentation/Images/PCBs/PCB v3 Unsoldered.JPG

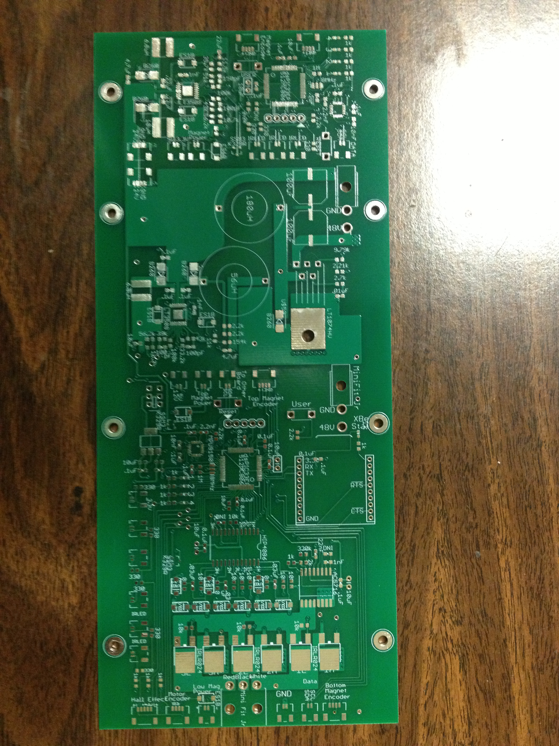
Documentation/Images/PCBs/PCB v3 Unsoldered.JPG
