NxRLab/gibbot/Documentation/Images/Whole Robot/PCB v2 Setup.JPG

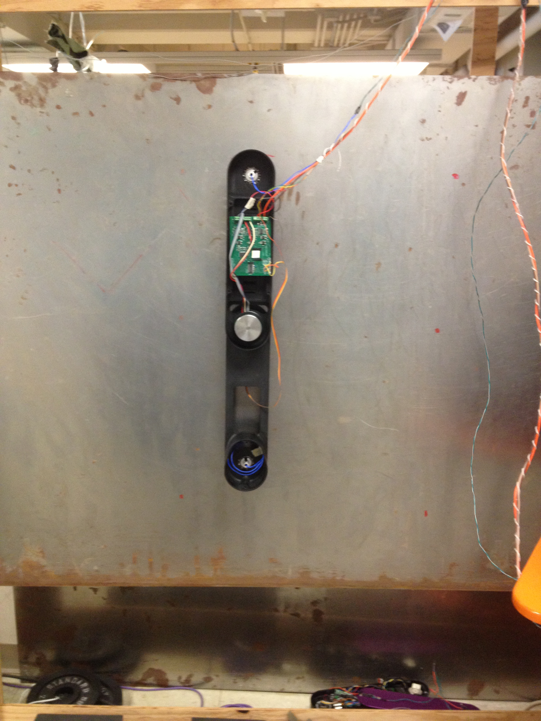
Documentation/Images/Whole Robot/PCB v2 Setup.JPG
