NxRLab/gibbot/Documentation/Images/Whole Robot/PCB v2 Wiring.JPG

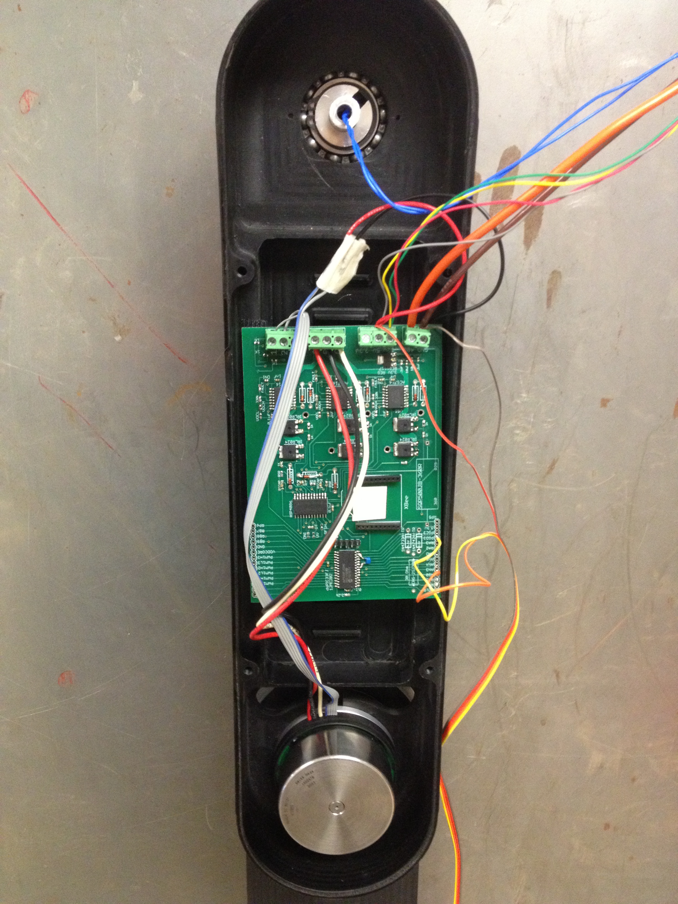
Documentation/Images/Whole Robot/PCB v2 Wiring.JPG
