NxRLab/gibbot/Documentation/Images/Whole Robot/PCB v3 Wiring 2.JPG

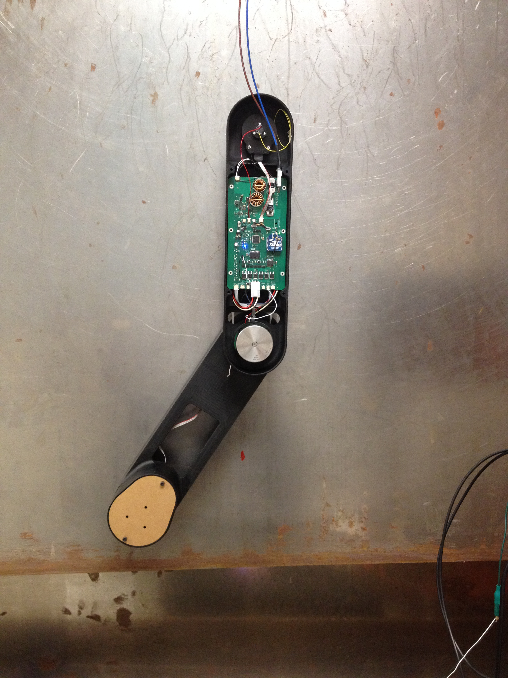
Documentation/Images/Whole Robot/PCB v3 Wiring 2.JPG
