NxRLab/gibbot/Documentation/Images/Whole Robot/PCB v3 Wiring.JPG

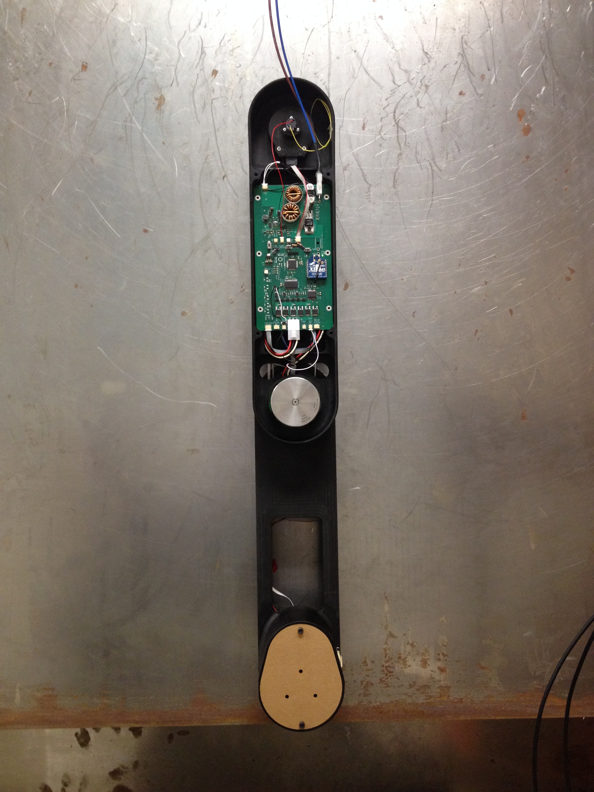
Documentation/Images/Whole Robot/PCB v3 Wiring.JPG
