NxRLab/gibbot/Frame/CAD v3/9.4in. Frame/Pictures/4.3.14 - Motor Sub Assembly.PNG

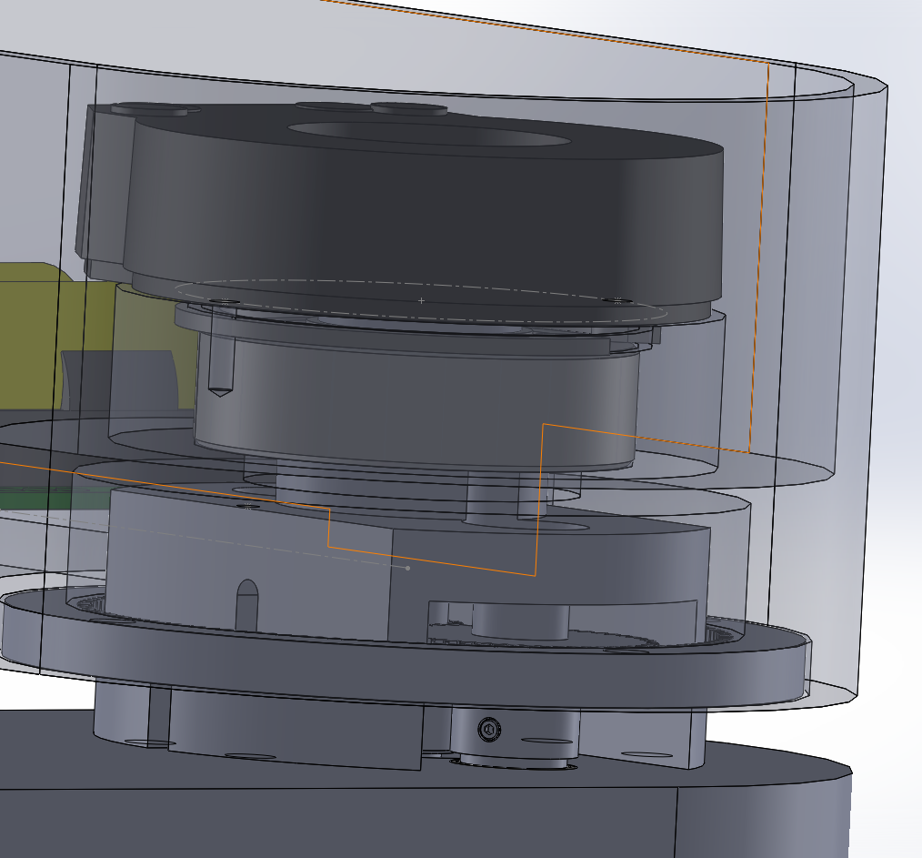
Frame/CAD v3/9.4in. Frame/Pictures/4.3.14 - Motor Sub Assembly.PNG
