NxRLab/gibbot/Documentation/Reports/Battery Test/1CellTest.pdf

# Single Battery Charge Test

## 1 Goal

Safely charge 1 Li-Ion battery through multiple charge test cycles using the Gibbot v4 charge test board, which uses the LTC4000 charge controller and the LT1704 DC/DC Converter.

### 1.1 Procedure

According to the specifications for the Tenergy LiFePO4 3.2V 1100mAh 18650 Battery are given in the table below¹
:
Specification | Value
Charge Voltage | 3.6V ± 0.05V
Average Working Voltage | 3.2V
Standard Charge Current | 0.5A
Standard Discharge End Voltage | 2.0V

The measured storage voltage for the batteries is 3.30V. For initial tests the battery will be discharged through a power resistor from 3.30V to 3.0V. The charger will then charge the battery back up to 3.60V. The following outputs will be measured with an oscilloscope during charging:

VOUT The voltage across the battery

IIMON The voltage on this pin is 20 times (typical) the sense voltage VIN,CLN across the input current sense resistor RIS, therefore providing a voltage equal to 0.1 times the input current.

IBMON The voltage on this pin is 20 times (typical) the sense voltage VIN,CLN across the charge current sense resistor RIS, therefore providing a voltage equal to 0.1 times the charge current.

## 2 Program Resistor Values

The LTC4000 (http://cds.linear.com/docs/en/datasheet/4000fa.pdf) is a charge controller that interfaces with a DC/DC Buck Converter to regulate the voltage input to the main board and the charging circuit. The LTC4000 (http://cds.linear.com/docs/en/datasheet/4000fa.pdf) has 4 regulation loops for

1. Input current control
2. Battery current control when the battery is charging and trickle charging
3. Battery voltage control
4. Output voltage control

Threshold values for each of these regulation loops are set using resistor divider networks.

### 2.1 Programmed Voltage Levels

Translating the battery charge cycle specifications from Table 1 into the values used by the LTC4000 we get:
VF LOAT = 3.6V
VOUT = 4.0V
These values satisfy the qualification from the datasheet that “VOUT should not be programmed to be less than 105% of VF LOAT to ensure that the battery can be fully charged²
.” They are also in line with

1http://www.all-battery.com/datasheet/30072-0 datasheet.pdf
2pg 20 http://cds.linear.com/docs/en/datasheet/4000fb.pdf

Figure 1: LTC 4000 Footprint

1 | 28
2 | 27
3 | 26
4 | 25
5
6 | 23
7 | 22
8 | 21
9
10 | 19
11 | 18
12 | 17
13
14

TOP VIEW

GN PACKAGE
28-LEAD PLASTIC SSOP

24

20

16
15

ENC
IBMON
CX
CL
TMR
GND
FLT
CHRG
BIAS
NTC
FBG
BFB
BAT
BGATE

IL
IIMON
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
IGATE
OFB
CSP
CSN

TJMAX = 125°C, θJA = 80°C/W, θJC = 25°C/W

the Design Example modified for a single LiFePO4³ .

Setting VOUT automatically sets VOUT(INST ON) as⁴ :

VOUT(INST ON) =

VOUT
1.225

= 3.27V

Setting VF LOAT automatically sets VLOBAT as⁵ :

VLOBAT = VF LOAT ∗ 0.68 = 2.45V

VOUT(INST ON) sets a battery voltage level for which the charger will regulate the MOSFET at BGATE. If a battery is connected with a voltage below VOUT(INST ON) BGATE is regulated to ensure that the voltage at the output is maintained at the level of VOUT(INST ON)
. For this reason
VOUT(INST ON) should be programmed to be the minimum output voltage required to power the output.
It is important to not set VOUT too high relative to VF LOAT . From the datasheet “VOUT should not be programmed too high since VOUT(INST ON)

, the minimum voltage on CSP, depends on the same resistors ROF B1 and ROF B2 that set VOUT ...The higher the programmed value of VOUT(INST ON)
, the larger the
operating region when the charger PMOS is driven in the linear region where it is less efficient⁶ .”

### 2.2 ROFB1 = 298kΩ & RBFB1 = 288kΩ

VOUT is set by a resistor divider from CSP to FBG with the junction connected to OFB. ROF B2, the resistor between FBG and OFB, will have the datasheet recommended value of 127k⁷
. The value of
ROF B1 is set using the formula⁸
:

ROF B1 =

VOUT
1.193

− 1

- 127kΩ =
4.0V
1.193

− 1

- 127kΩ = 298kΩ

Because of available resistor values, ROF B2 is set to 100k and ROF B1 is set to 220k. This produces a VOUT of:

3pg 20 http://cds.linear.com/docs/en/datasheet/4000fb.pdf
4pg 20 http://cds.linear.com/docs/en/datasheet/4000fb.pdf
5LTC4000 Datasheet, Electrical Characteristics, pg3 http://cds.linear.com/docs/en/datasheet/4000fb.pdf
6pg 20 http://cds.linear.com/docs/en/datasheet/4000fb.pdf
7Typical Application circuit diagram pg 1 LTC4000 datasheet http://cds.linear.com/docs/en/datasheet/4000fb.pdf 8pg 18 LTC4000 datasheet http://cds.linear.com/docs/en/datasheet/4000fb.pdf

VOUT =

ROF B1

ROF B2

+ 1

- 1.193 =
220k
100k

+ 1
- 1.193 = 3.82V

VF LOAT is set by a resistor divider from BAT to FBG with the junction connected to BFB. RBF B2, the resistor between FBG and BFB, will have the datasheet recommended value of 133k⁹
. For the float
voltage of 3.6V from above, the value of RBF B is set using the formula¹⁰:

RBF B1 =

VF LOAT
1.135

− 1

- 133kΩ =
3.6V
1.135

− 1

- 133kΩ = 288kΩ

### 2.3 RIL = 1kΩ & RCL = 1kΩ

Both RIL and RCL should be set to 1k to limit both the input current and the charge current to a maximum value of 0.5A according to the following formula¹¹:

RIL =

ILIM · RIS
2.5uA =

0.5A · 5mΩ
2.5uA = 1kΩ

RCL =

ICLIM · RCS
2.5uA =

0.5A · 5mΩ
2.5uA = 1kΩ

Assuming the sense resistor for both is a 5mΩ, 1% accuracy, 3W, metal element sense resistor. (http://www.digikey.com/product-detail/en/PWR4412-2SCR0050F/PWR4412-2SCR0050F-ND/2564433) If a power resistor is applied between VOUT and GND the current through the resistor should be subtracted from the charge current. This difference can be measured in the difference of the voltage outputs between IIMON and IBMON.

### 2.4 CTMR = 8nF & RCX = 2kΩ

After the float voltage is reached the charger starts a timer. When this timer runs out the charge stops chargin. The period of time for which the batteries will trickle charge is set by CTMR according to the following formula¹²

CTMR = tT ERM INAT E(h) · 34.6nF = 0.25h · 34.6nF = 8.65nF

This also sets the period of time for which the charger will supply current to a battery whose voltage is below the Bad Battery Voltage.

tBADBAT =

CTMR(nF)
138.5

=

8nF
138.5

= 3.5min

Because of existing resistor values, CTMR is set to 10nF. This sets tT ERM INAT E and tBADBAT as follows:

tT ERM INAT E(h) = CTMR
34.6nF

=

10nF
34.6nF

= 0.29h = 17.3min

tBADBAT =

CTMR(nF)
138.5

=

10nF
138.5

= 4.3min

If TMR were instead tied to BIAS charge termination is controlled by RCX according to the following formula. Where ICX is used for C/10 charging.

RCX =

IC/X · RCS + 0.5mV
0.25uA | =

.05A · 5mΩ + 0.5mV
.25uA | = 2kΩ

Because of existing resistor values, RCX is set to 2.21k producing an IC/X limit of:

IC/X =

(RCX · 0.25uA) · 0.5mV

RCS

=

(2.21kΩ · 0.25uA) · 0.5mV
5mΩ

= 0.055A

Because a capacitor is connected between TMR and GND the capacitor (CTMR) controls charge termination. In this configuration, the only effect RCX will have is that the outputs of CHRG and FLT will assume a high impedance state when the charge current falls belowIC/X

13. Because CHRG and
FLT are not properly connected on this board, this effect cannot be observed.

9Typical Application circuit diagram pg 1 LTC4000 datasheet http://cds.linear.com/docs/en/datasheet/4000fb.pdf 10pg 17 LTC4000 datasheet http://cds.linear.com/docs/en/datasheet/4000fb.pdf
11From pg 16 of the LTC4000 datasheet http://cds.linear.com/docs/en/datasheet/4000fb.pdf
12From pg 18 of the LTC4000 datasheet http://cds.linear.com/docs/en/datasheet/4000fb.pdf
13From pg 18 of the LTC4000 datasheet http://cds.linear.com/docs/en/datasheet/4000fb.pdf

### 2.5 FLT & CHRG Shorted

FLT and CHRG were supposed to be connected to LEDs to indicate an over temperature condition or an active charge cycle. However, the LEDs are connected to ground and the outputs are only pull down outputs. Either rewire the anode of the diodes to a high voltage source and change the resistor values or short the outputs to GND.

### 2.6 RVM1 = 487kΩ

The input voltage pin VM measures the input voltage through a voltage divider. If the input voltage level drops below a given threshold the controller will pull the RST pin low. If this pin were connected to the EN of a buck converter it would disable the buck converter and cut power to the batteries and VOUT. An LED could also be connected to the RST pin so that instead of shutting down the buck converter, the LED would provide a visual indicator if the voltage is too low. Because the RST pin is left unconnected in this iteration the input voltage level set on pin VM will have no effect, but will be configured anyway.
The minimum supplied voltage required to charge the circuit can be calculated from the LT1074 datasheet based on the equation below¹⁴ and the limitation that the maximum duty cycle is 90%¹⁵

VIN =

VO + Vf
90% + VSW =

4.0V + 0.48V
90% + 2V = 7.0V

Where:
VSW = Switching voltage of LT1074 2V
Vf = Diode forward voltage = 0.48V for PDS760

The voltage is set by a voltage divider from the input voltage source to GND with VM connected at the junction. The value of R2, the resistor from VM to GND is set to 100k according to the datasheet¹⁶ .
The value of RV M1 is set using the equation below¹⁷

RV M1 =

VV M RST
1.193V

− 1

- RV M2 =
7.0V
1.193V

− 1

- 100k = 487kΩ

Because of the available resistor values, RV M1 is set to 330k. This sets the Voltage threshold at:

VV M RST =

RV M1

RV M2

+ 1
- 1.193V = 5.13V

Because the RST pin is not properly connected this low voltage threshold should have no effect.

### 2.7 NTC

Temperature qualification is unnecessary in this test. Leave NTC, 21.6k and 9.91k unsoldered.

### 2.8 LT1074 FB1 = 1.79k

The datasheet recommends that the DC/DC Converter should be set to regulate it’s output voltage at greater than 110% of the output voltage¹⁸. For the output voltage of VOUT = 4.0V above this means the LT1074 should be programmed to output at least 4.4V.
The value of RF B2 is set to the datasheet recommended value of 2.21kΩ. The value of RF B1 is set according to the following formula:

R1 =

R2 · (VOUT − VREF )

VREF

=

2.21kΩ · (4.4V − 2.21V )
2.21V

= 2.19kΩ

Because of available resistor values, R1 was set to 2.21k. This produces a VOUT of:

VOUT =

R1
R2
- VREF
+ VREF =
2.21kΩ
2.21kΩ
- 2.21V
+ 2.21V = 4.42V

14LT1074 Design Manual Application Note 44, Pg 17, Equation 1 http://cds.linear.com/docs/en/application-note/an44fa.pdf
15Listed as 90% in electrical characteristics table pg 4. Stated as 93% on pg 6. http://cds.linear.com/docs/en/application-note/an44fa.pdf
16Typical Application circuit diagram pg 1 LTC4000 datasheet http://cds.linear.com/docs/en/datasheet/4000fb.pdf 17LTC4000 datasheet pg 23 http://cds.linear.com/docs/en/datasheet/4000fb.pdf
18LTC4000 Datasheet pg 23 http://cds.linear.com/docs/en/datasheet/4000fb.pdf

### 2.9 LT1074 FDBK RC = 10kΩ & CC = 1uF

For the final circuit the loop compensation resistor and capacitor values should be determined either emperically or analytically. For this initial test they will be set at the datasheet recommended initial value of CC = 1uF and RC = 10k will be used.

## 3 PCB Components

### 3.1 MOSFETs

Two P-Channel MOSFETs control the flow of current. A MOSFET between IID and CSP controls the flow of power from the input source. A MOSFET between CSN and BAT controls the power flowing in and out of the batteries.

### 3.1.1 Input Power Control

The parameters that determine the choice of MOSFET are:

- The maximum drain to source voltage is 10*3.6*1.05 = 37.8V
- The drain to source current is 5A
- An acceptable temperature rise is 30 C during operation

These parameters led to the choice of Vishay’s SUM110P06-07L (http://www.vishay.com/docs/72439/72439.pdf) which can tolerate 60V D-S. If VGS = 4.5V , RDS(on) = 8.8mOhm at ambient temperature. When the MOSFET is passing 5A it will be dissipating 0.22W. With an RΘJAof 40 C/W the junction temperature would only rise by about 9 C.

### 3.1.2 Battery Power Control

The BGATE MOSFET is limited by the power it must dissipate during charging. When the battery voltage is below VINST ON = 3.27V, the BGATE MOSFET is regulated to maintain a steady output voltage. However, this means that the MOSFET is being used as a resistor and will dissipate more power. The power dissipated when the battery is below VLOBAT and the charger is trickle charging is calculated using the following equation¹⁹:

PT RKL = (0.86 ∗ VF LOAT − VBAT ) ∗ ICLIM(T RKL) = (0.86 ∗ 3.6V − 0V ) ∗ 0.05A = 0.15W

Where:
ICLIM(T RKL) = ICLIM/10 = 0.05A

The power dissipation when the battery voltage is above VLOBAT , but below VINST ON is calculated using²⁰:

PINST ON = (0.86 ∗ VF LOAT − VBAT ) ∗ ICLIM = (0.86 ∗ 3.6V − 2.45V ) ∗ 0.5A = 0.49W

Power dissipation will not be an issue in this setup, but should be considered when more batteries or higher charge current are implemented. The other parameters determining the choice of BGATE MOSFET are looser than the parameters for the IGATE MOSFET:

- The maximum drain to source voltage is 10*3.6 = 36V
- The drain to source current is 4A

However, to simplify the design, Vishay’s SUM110P06-07L (http://www.vishay.com/docs/72439/72439.pdf) MOSFET will be used in both locations. This could be reconsidered in future designs to save space–move from a D2PAK to a DPAK MOSFET–or to reduce the RDS(ON) on the BGAT E MOSFET.

19LTC4000 Datasheet pg 19, 27 http://cds.linear.com/docs/en/datasheet/4000fb.pdf 20LTC4000 Datasheet pg 19, 27 http://cds.linear.com/docs/en/datasheet/4000fb.pdf
