NxRLab/gibbot/Documentation/Reports/Battery Test/footprint.pdf

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
TOP VIEW

GN PACKAGE
28-LEAD PLASTIC SSOP

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
IBMON
CX
CL
TMR
GND
FLT
CHRG
BIAS
NTC
FBG
BFB
BAT
BGATE

IL
IIMON
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
IGATE
OFB
CSP
CSN

TJMAX = 125°C, θJA = 80°C/W, θJC = 25°C/W
