NxRLab/gibbot/Controls/testing/motortest2.txt

3713
3714
3584
2291
732
532
1796
3200
3296
2056
782
833
2101
3163
2911
1655
810
1250
2466
3052
2423
1305
984
1770
2737
2769
1886
1126
1355
2272
2772
2313
1462
1234
1860
2566
2517
1816
1319
1602
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
