NxRLab/gibbot/Controls/testing/motortest3.txt

3717
3645
2505
844
304
1236
2829
3445
2619
1123
524
1301
2697
3224
2441
1150
745
1562
2739
2997
2127
1085
1005
1913
2801
2702
1768
1069
1347
2260
2761
2320
1469
1191
1752
2493
2558
1916
1334
1466
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
