NxRLab/gibbot/Controls/testing/motortest5.txt

3912
3692
2260
753
601
1865
3364
3591
2425
994
755
1862
3211
3390
2295
1060
974
2073
3184
3132
2020
1070
1270
2381
3156
2788
1707
1137
1655
2674
3025
2368
1465
1338
2088
2841
2744
1952
1394
1682
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
