NxRLab/gibbot/Controls/testing/motortest6.txt

3850
3816
2785
1081
409
1243
2877
3603
2865
1335
617
1318
2769
3413
2698
1337
796
1554
2830
3224
2399
1239
1007
1894
2927
2973
2035
1166
1302
2262
2949
2627
1689
1211
1687
2560
2820
2218
1465
1419
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
