NxRLab/gibbot/Controls/testing/walltestdata.docx

Walltest1

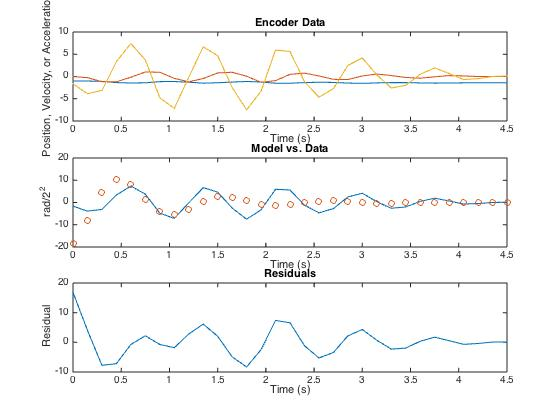
[picture p226: figure]

I =

0.0181

B =

0.0575

Walltest2

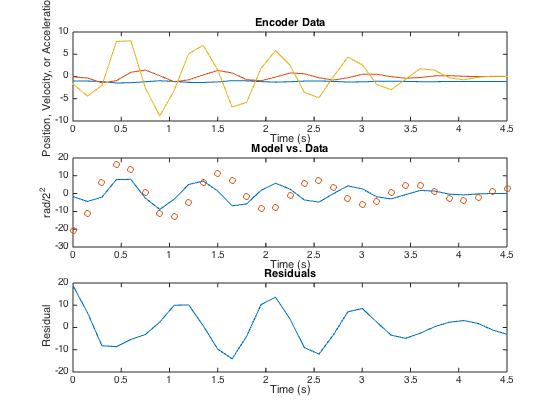
[picture p227: figure]

I =

0.0159

B =

0.0177

Walltest3

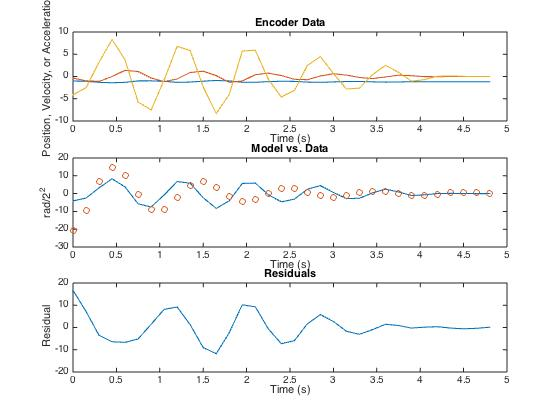
[picture p228: figure]

I =

0.0155

B =

0.0325

Walltest4

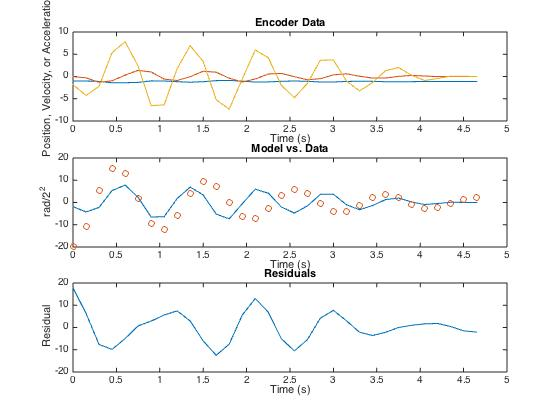
[picture p229: figure]

I =

0.0167

B =

0.0215

Walltest5

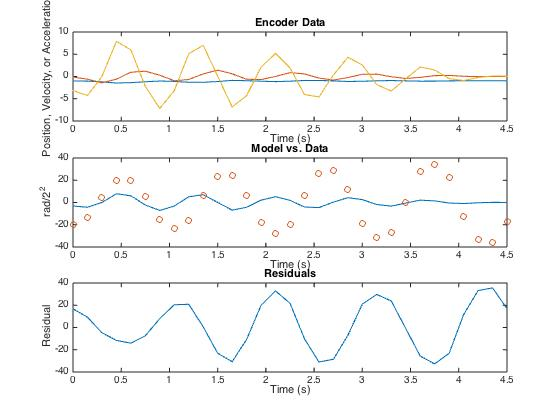
[picture p230: figure]

I =

0.0165

B =

-0.0078

Iavg = 0.01654

Bavg = 0.0248

Bavg(w/o negative test 5 answer) = 0.0323
