NxRLab/gibbot/Controls/testing/motortest2.jpg

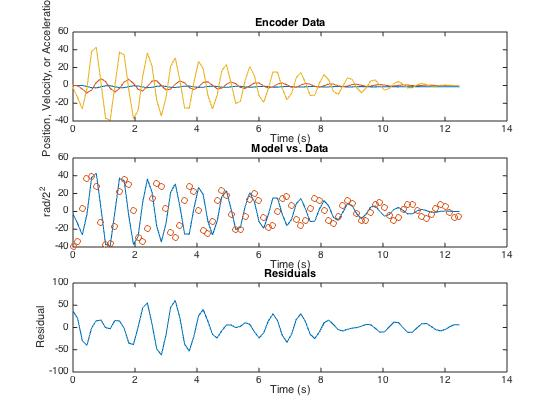
Controls/testing/motortest2.jpg
