NxRLab/gibbot/Controls/testing/motortest3.jpg

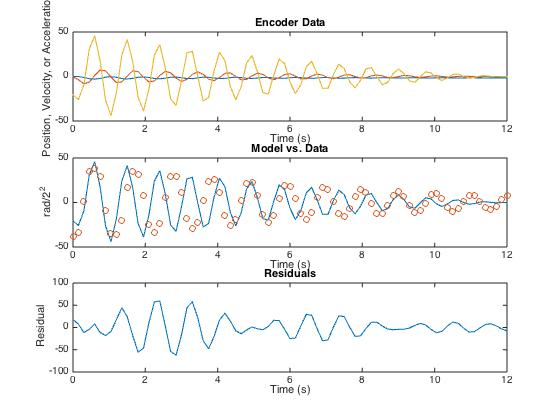
Controls/testing/motortest3.jpg
