NxRLab/gibbot/Controls/testing/motortest5 .jpg

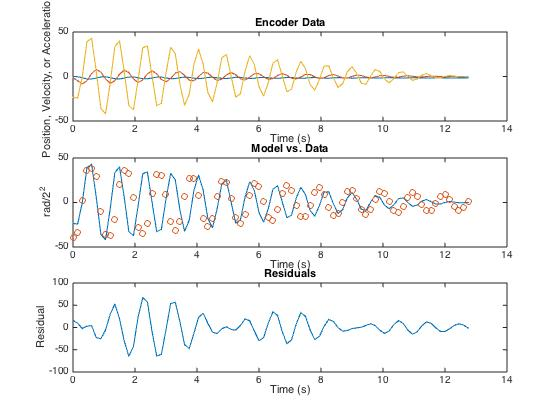
Controls/testing/motortest5 .jpg
