NxRLab/gibbot/Controls/testing/motortest6.jpg

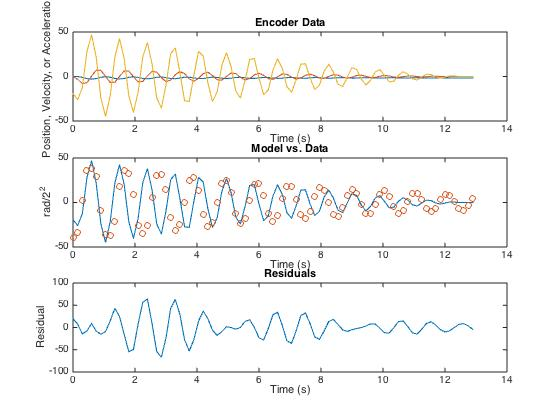
Controls/testing/motortest6.jpg
