NxRLab/gibbot/Documentation/Images/Other/Magnet Weight Test Setup.JPG

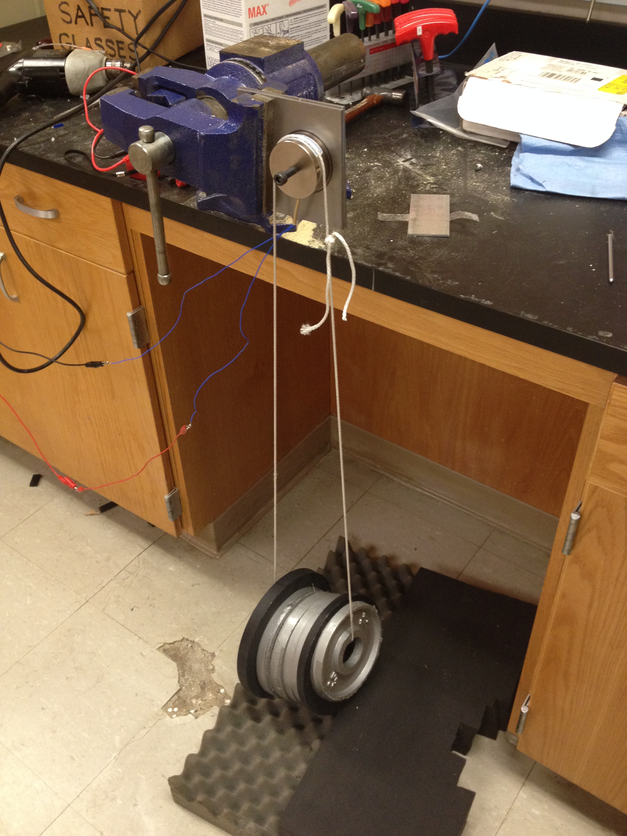
Documentation/Images/Other/Magnet Weight Test Setup.JPG
