NxRLab/gibbot/Frame/CAD v3/9.4in. Frame/Pictures/4.4.14 - Clearence Issues with M322M1-0202.PNG

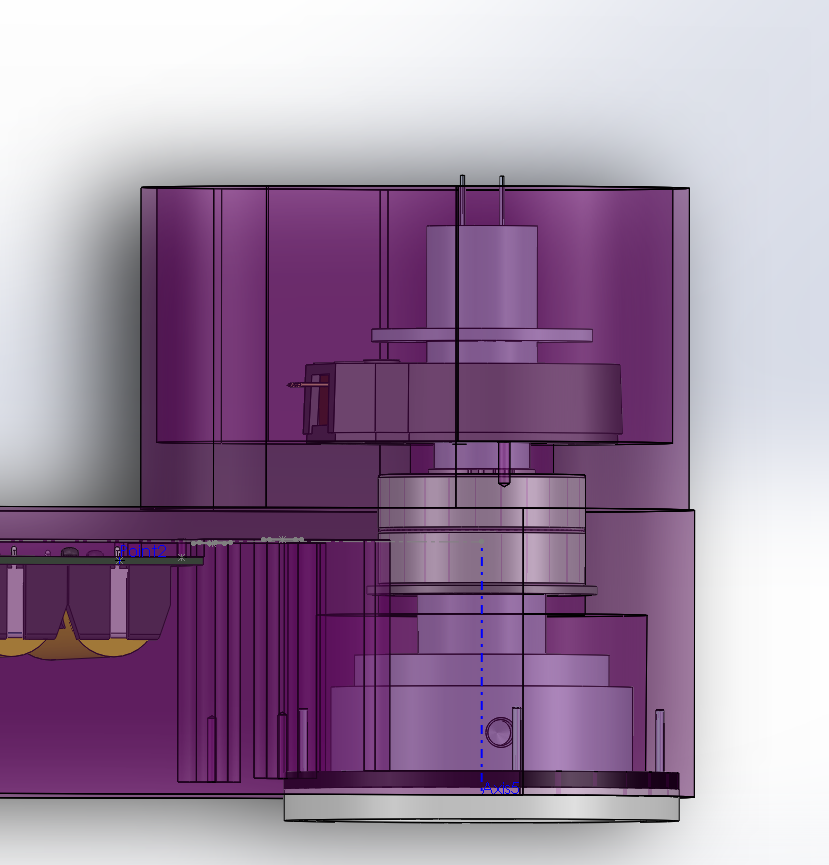
Frame/CAD v3/9.4in. Frame/Pictures/4.4.14 - Clearence Issues with M322M1-0202.PNG
