NxRLab/gibbot/Frame/CAD v3/9.4in. Frame/Pictures/4.9.14 - issue with 4-40 hole and snap rings.PNG

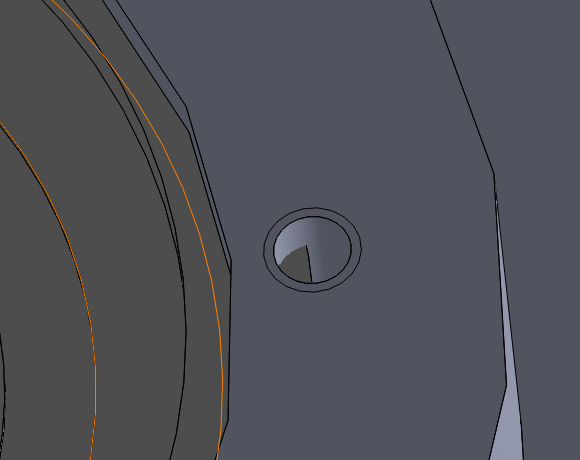
Frame/CAD v3/9.4in. Frame/Pictures/4.9.14 - issue with 4-40 hole and snap rings.PNG
