NxRLab/gibbot/Frame/CAD v3/9.4in. Frame/Pictures/4.9.14 - solved issue with snap ring and 4-40 hole.JPG

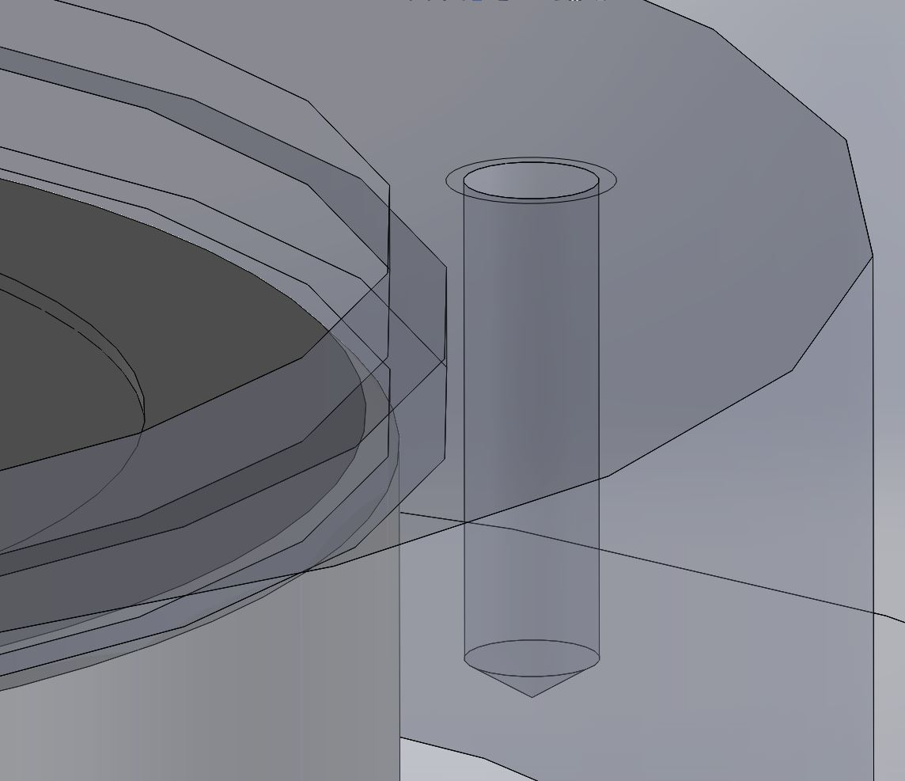
Frame/CAD v3/9.4in. Frame/Pictures/4.9.14 - solved issue with snap ring and 4-40 hole.JPG
