NxRLab/gibbot/Documentation/Reports/PCB Documentation/images/flowchart.pdf

PC

# Cameras

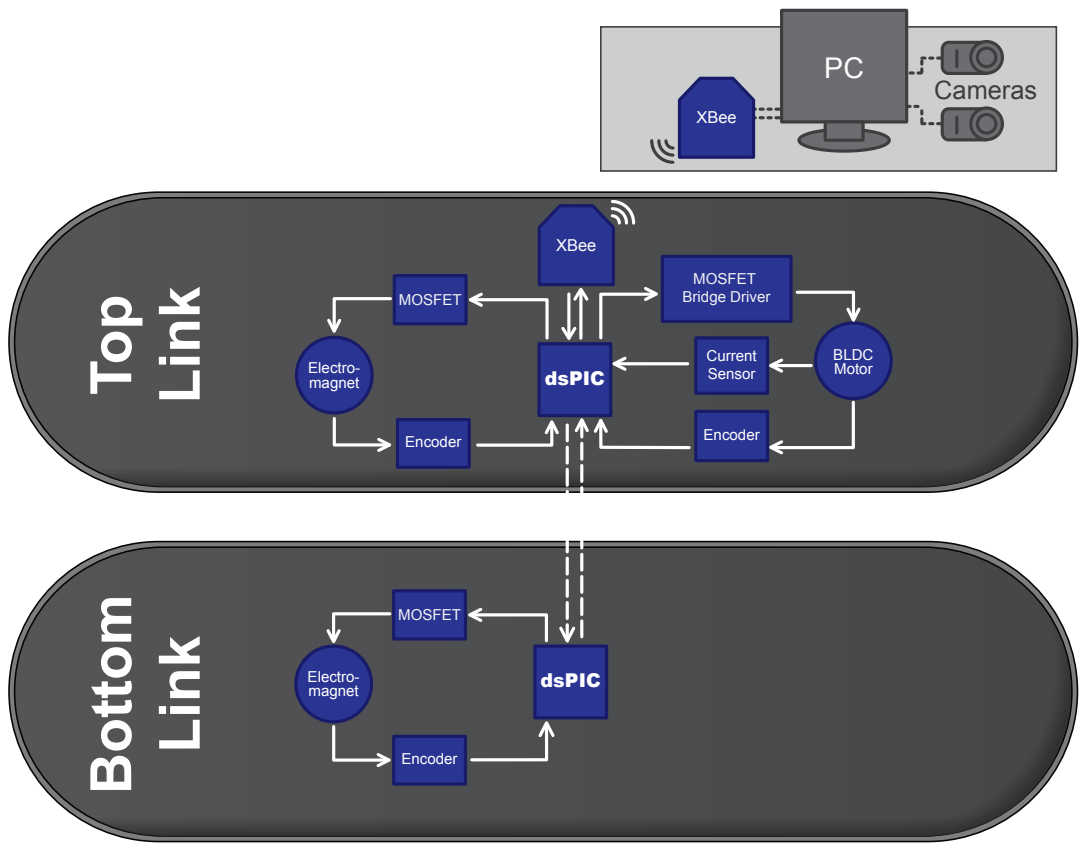
[picture p239: page 1]
Top; Link; Bottom Link; XBee; dsPIC; MOSFET Bridge Driver; Current Sensor; BLDC Motor; Encoder; Electro- magnet; MOSFET
