NxRLab/gibbot/Frame/CAD v3/9.4in. Frame/3D Printing/Motor Link Frame (Undersized Holes).PDF

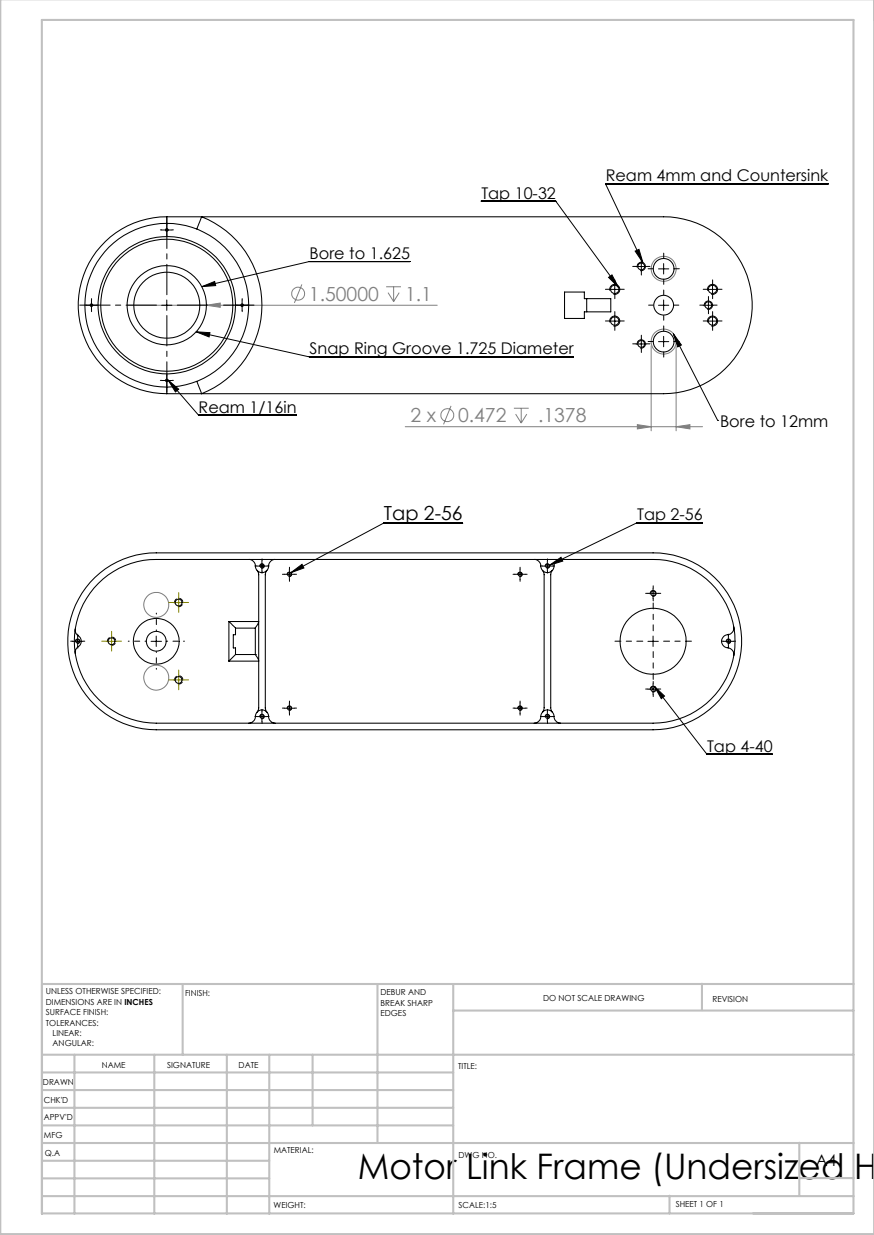
[picture p240: page 1]
Bore to 12mm; Tap 10-32; Bore to 1.625; Ream 1/16in; Tap 2-56; Tap 4-40; SCALE:1:5; SHEET 1 OF 1; DO NOT SCALE DRAWING; REVISION; DEBUR AND BREAK SHARP; UNLESS OTHERWISE SPECIFIED:; FINISH:

Ream 4mm and Countersink

Snap Ring Groove 1.725 Diameter

DIMENSIONS ARE IN INCHES
SURFACE FINISH:
TOLERANCES:
LINEAR:
ANGULAR:

NAME | SIGNATURE | DATE | | | | TITLE:
Q.A | | | | Motor Link Frame (Undersized Holes) WEIGHT: MATERIAL: | DWG NO. | A4

DRAWN
CHK'D
APPV'D
MFG
