NxRLab/gibbot/Frame/CAD v3/9.4in. Frame/3D Printing/Wall Link Frame (Undersized Holes).PDF

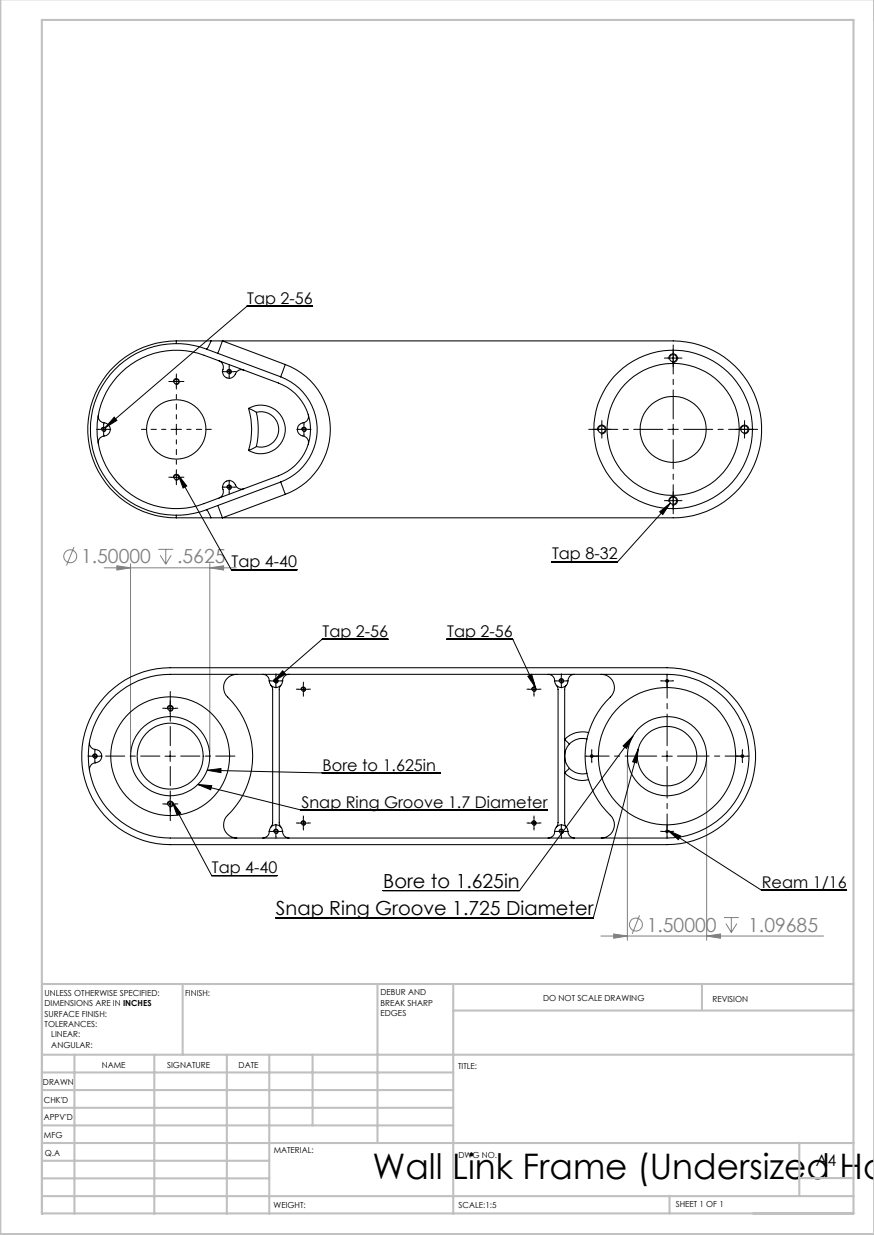
[picture p241: page 1]
Tap 2-56; Tap 4-40 1.50000 .5625; Tap 8-32; Bore to 1.625in; SCALE:1:5; SHEET 1 OF 1; DO NOT SCALE DRAWING; REVISION; DEBUR AND BREAK SHARP; UNLESS OTHERWISE SPECIFIED:; FINISH:

Bore to 1.625in
Snap Ring Groove 1.7 Diameter

Ream 1/16 Tap 4-40
Snap Ring Groove 1.725 Diameter

DIMENSIONS ARE IN INCHES
SURFACE FINISH:
TOLERANCES:
LINEAR:
ANGULAR:

NAME | SIGNATURE | DATE | | | | TITLE:
Q.A | | | | Wall Link Frame (Undersized Holes) WEIGHT: MATERIAL: | DWG NO. | A4

DRAWN
CHK'D
APPV'D
MFG
