NxRLab/gibbot/Documentation/Reports/PCB Documentation/images/breakout.pdf

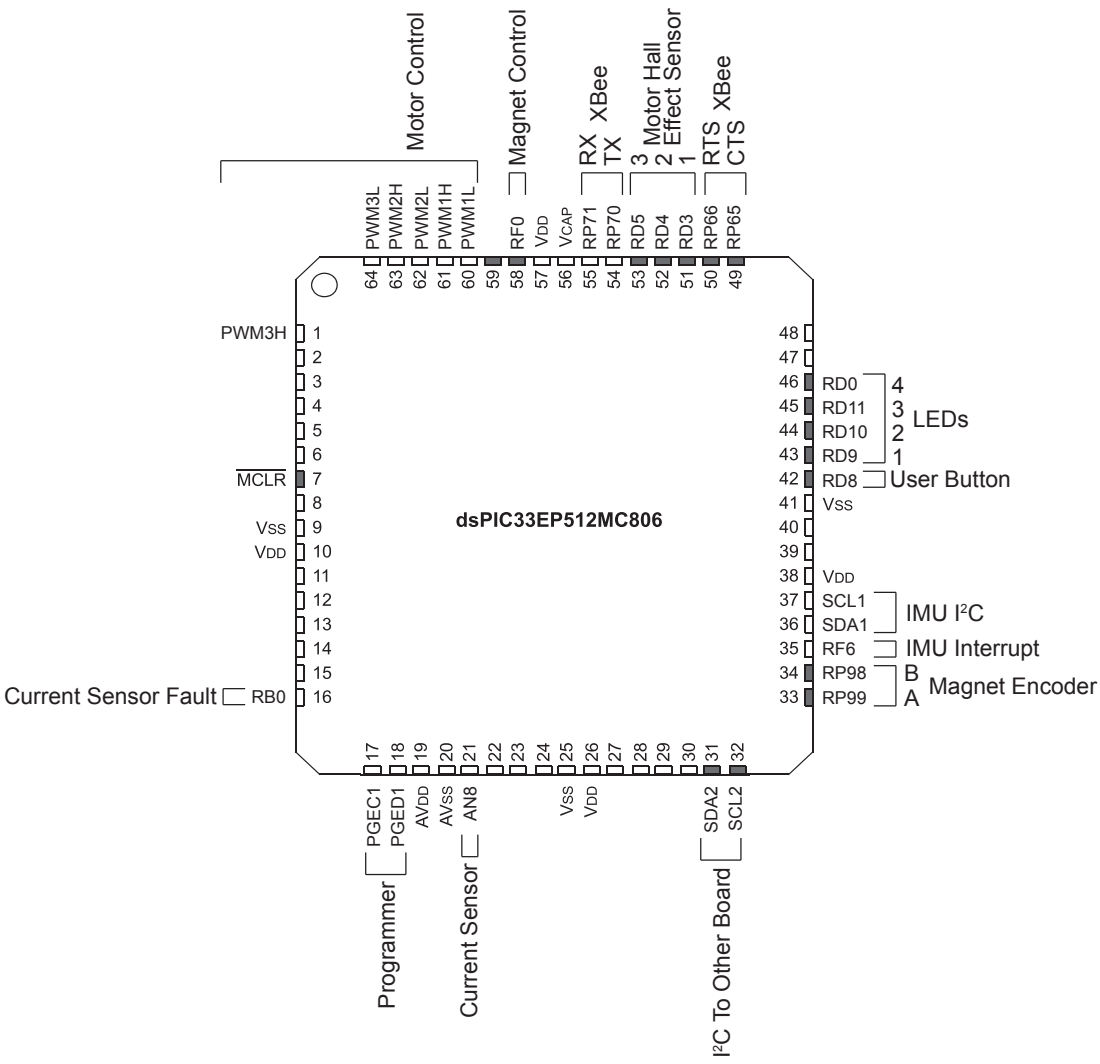
[picture p242: page 1]
SCL1 SDA1 RF6 RP98 RP99; SDA2; SCL2; PGEC1; PGED1; LEDs; User Button; IMU I²; C IMU Interrupt Magnet Encoder B A; Current Sensor; Programmer; TX XBee; RTS; CTS XBee; Motor Hall; Effect Sensor; Motor Control; Magnet Control; PWM3L; PWM2H; PWM2L; PWM1H PWM1L; PWM3H

Current Sensor Fault

2C To Other Board

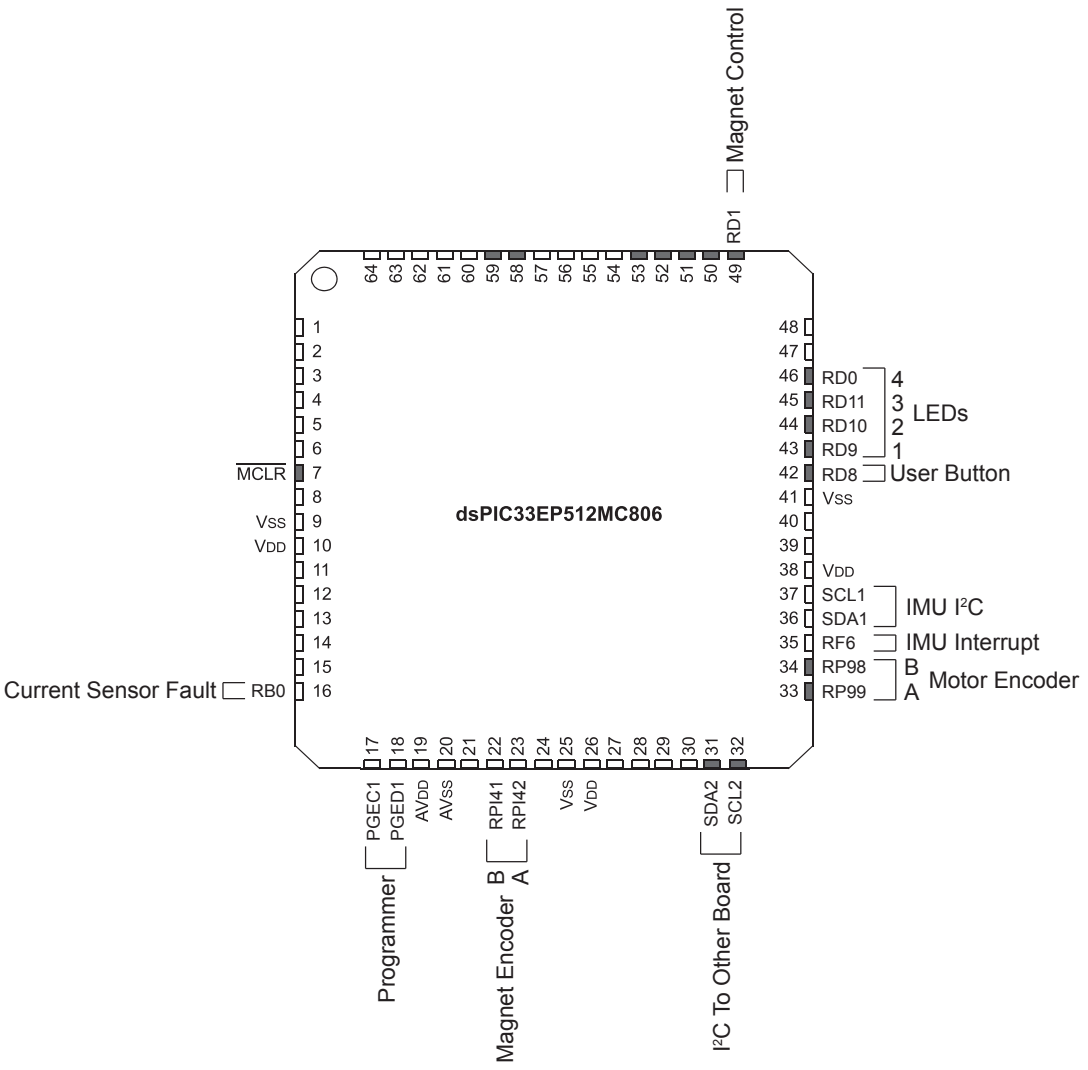
[picture p243: page 2]
SCL1 SDA1 RF6 RP98 RP99; SDA2; SCL2; PGEC1; PGED1; LEDs; User Button; IMU I 2; C IMU Interrupt Motor Encoder; Programmer; Magnet Control

Current Sensor Fault

Magnet Encoder BA RPI41 RPI42

I2C To Other Board
