NxRLab/gibbot/Frame/CAD v3/10.5in Frame/3D Printing/Motor Link Frame (Undersized Holes).PDF

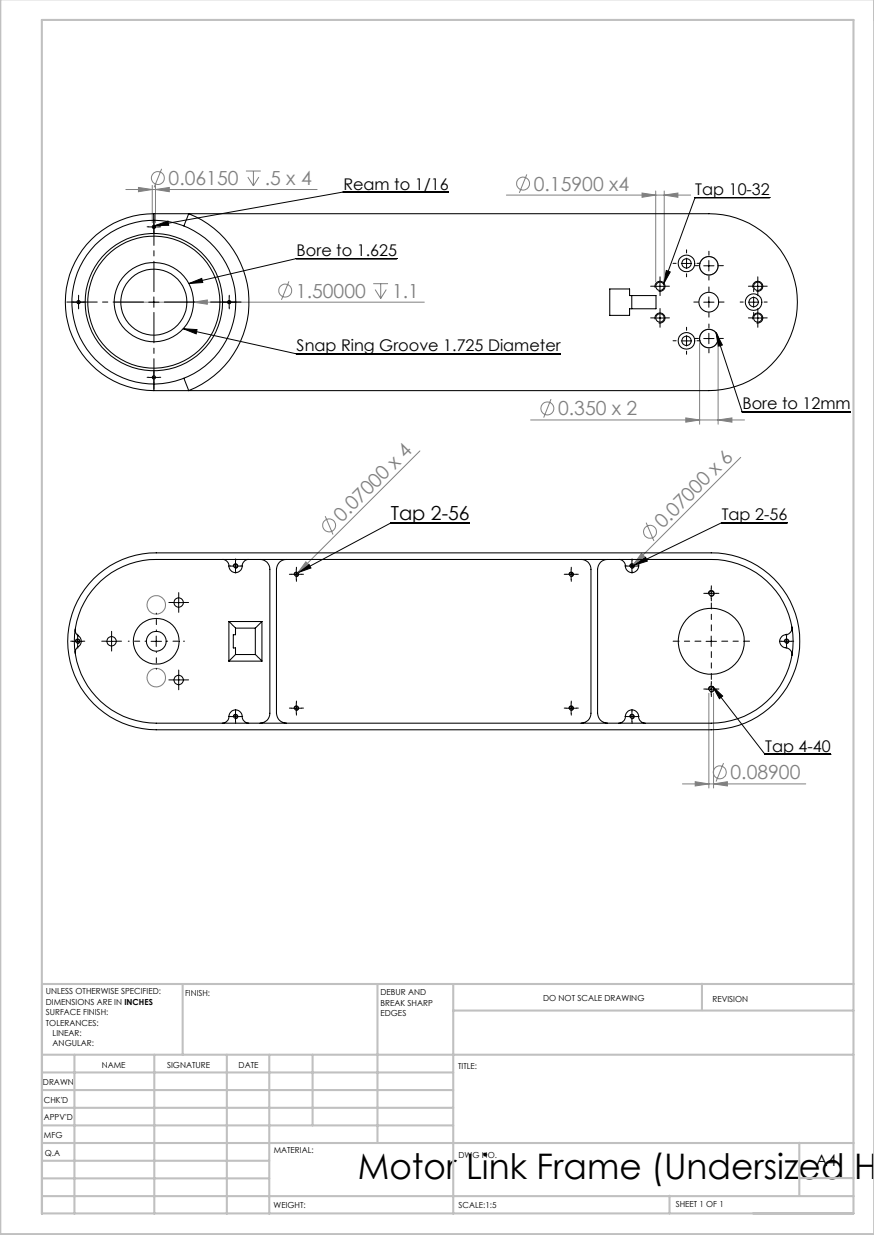
[picture p244: page 1]
Bore to 12mm; Bore to 1.625; Tap 2-56; Tap 4-40; SCALE:1:5; SHEET 1 OF 1; DO NOT SCALE DRAWING; REVISION; DEBUR AND BREAK SHARP; UNLESS OTHERWISE SPECIFIED:; FINISH:

Tap 10-32 Ream to 1/16

Snap Ring Groove 1.725 Diameter

DIMENSIONS ARE IN INCHES
SURFACE FINISH:
TOLERANCES:
LINEAR:
ANGULAR:

NAME | SIGNATURE | DATE | | | | TITLE:
Q.A | | | | Motor Link Frame (Undersized Holes) WEIGHT: MATERIAL: | DWG NO. | A4

DRAWN
CHK'D
APPV'D
MFG
