NxRLab/gibbot/Documentation/Reports/PCB Documentation/images/clamp2.pdf

Q

1

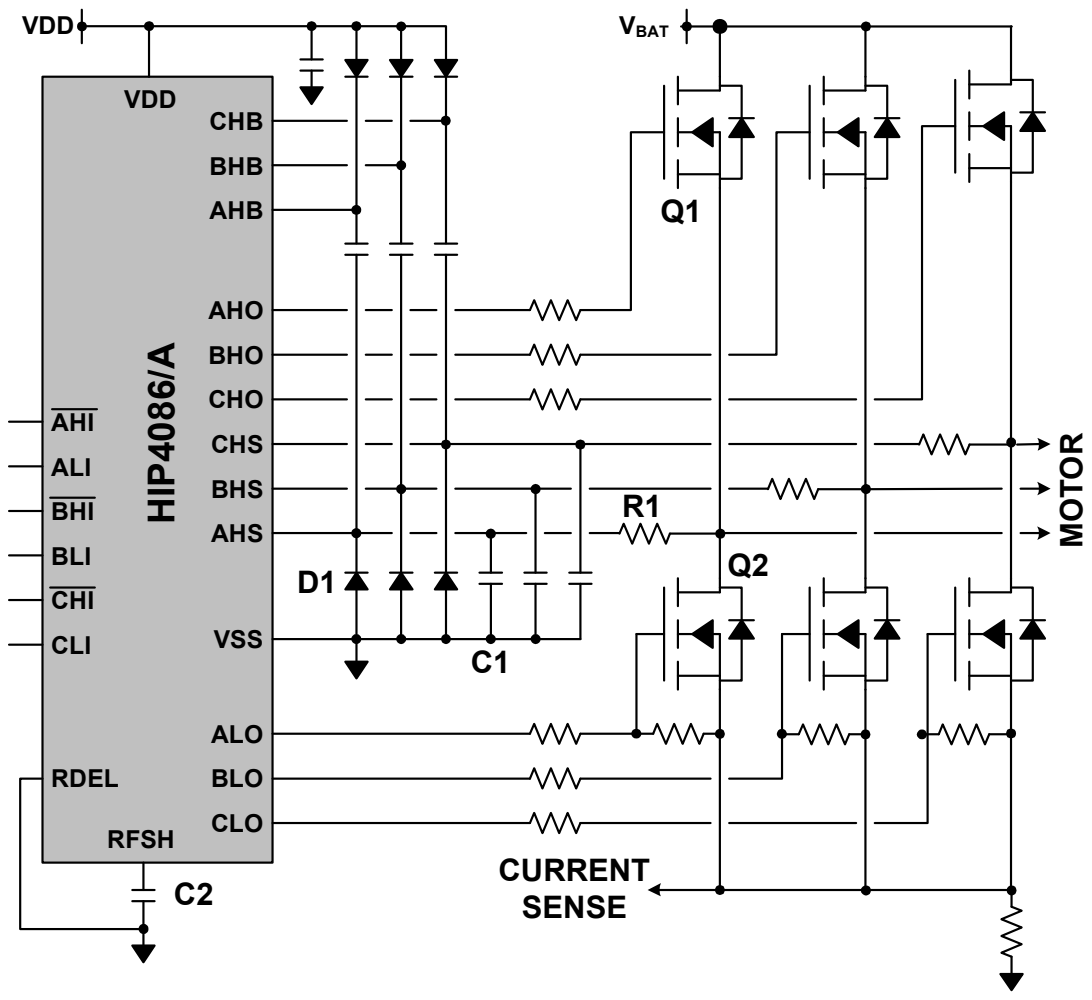
[picture p245: page 1]
CLO; BLO; RDEL; HIP4086/A; VSS; MOTOR; VBA; URREN; SENSE; FSH

ALO CHO BHO
