NxRLab/gibbot/PCB/V8/Primarymot.pdf

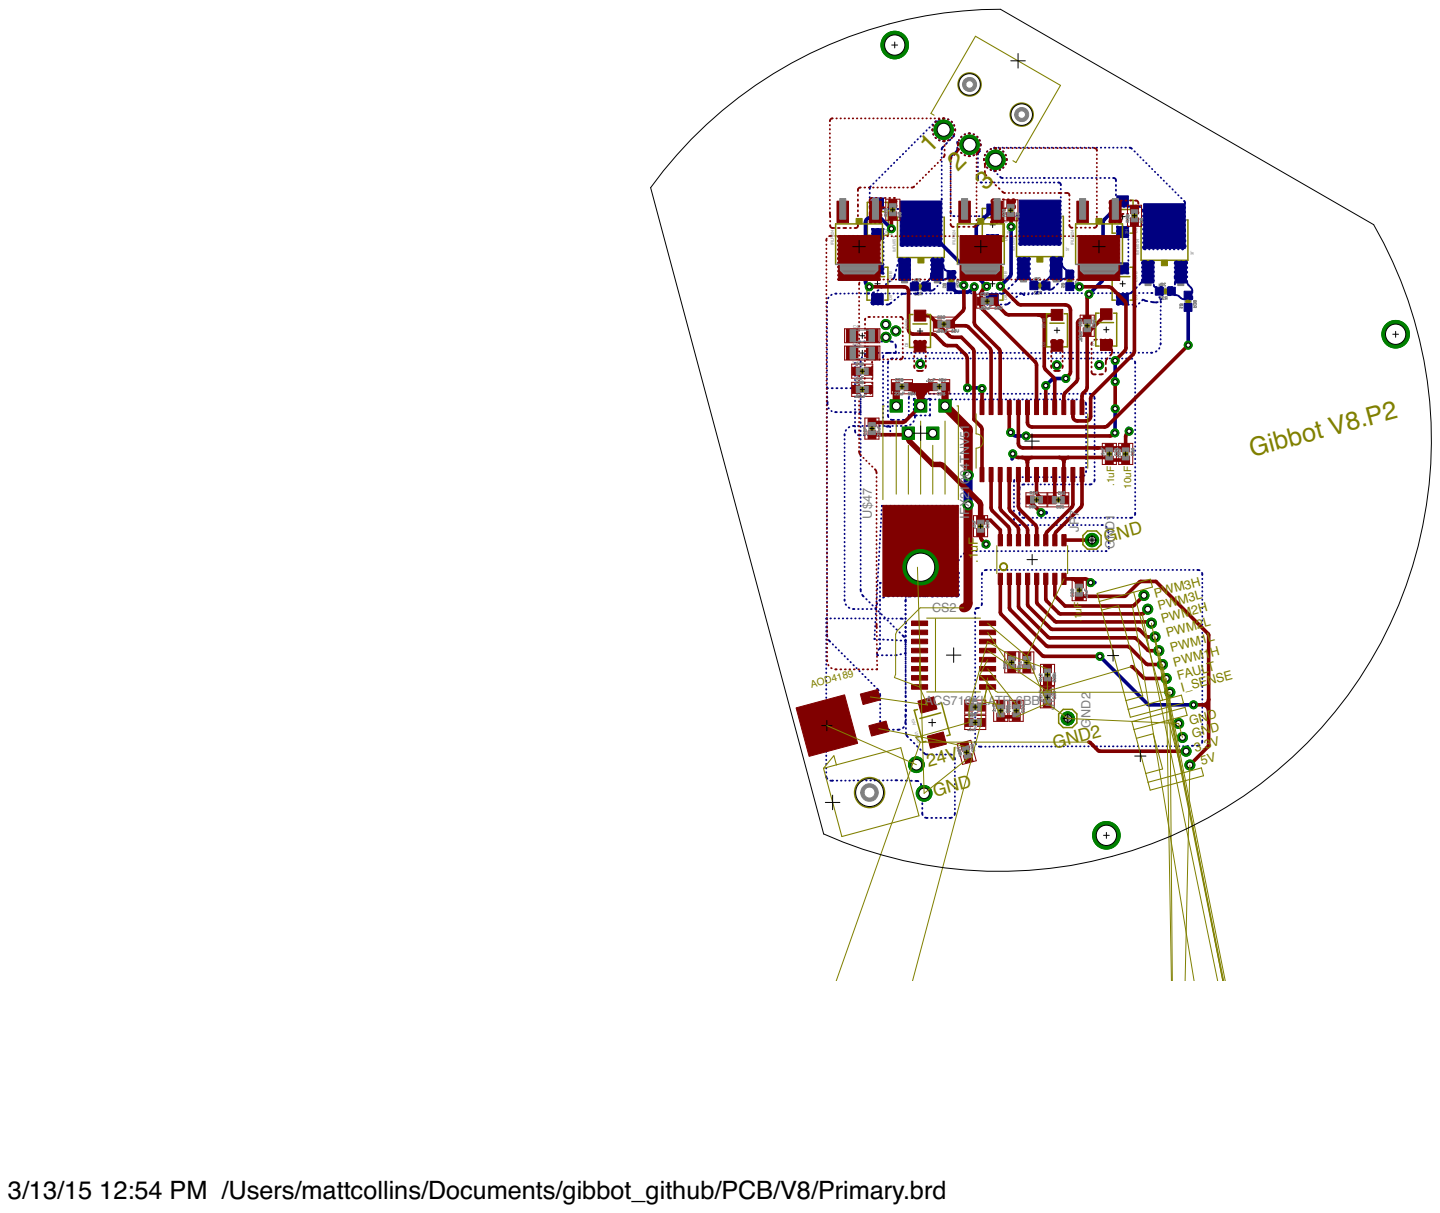
[picture p246: page 1]

3/13/15 12:54 PM /Users/mattcollins/Documents/gibbot_github/PCB/V8/Primary.brd
