NxRLab/gibbot/PCB/V8/Primary.pdf

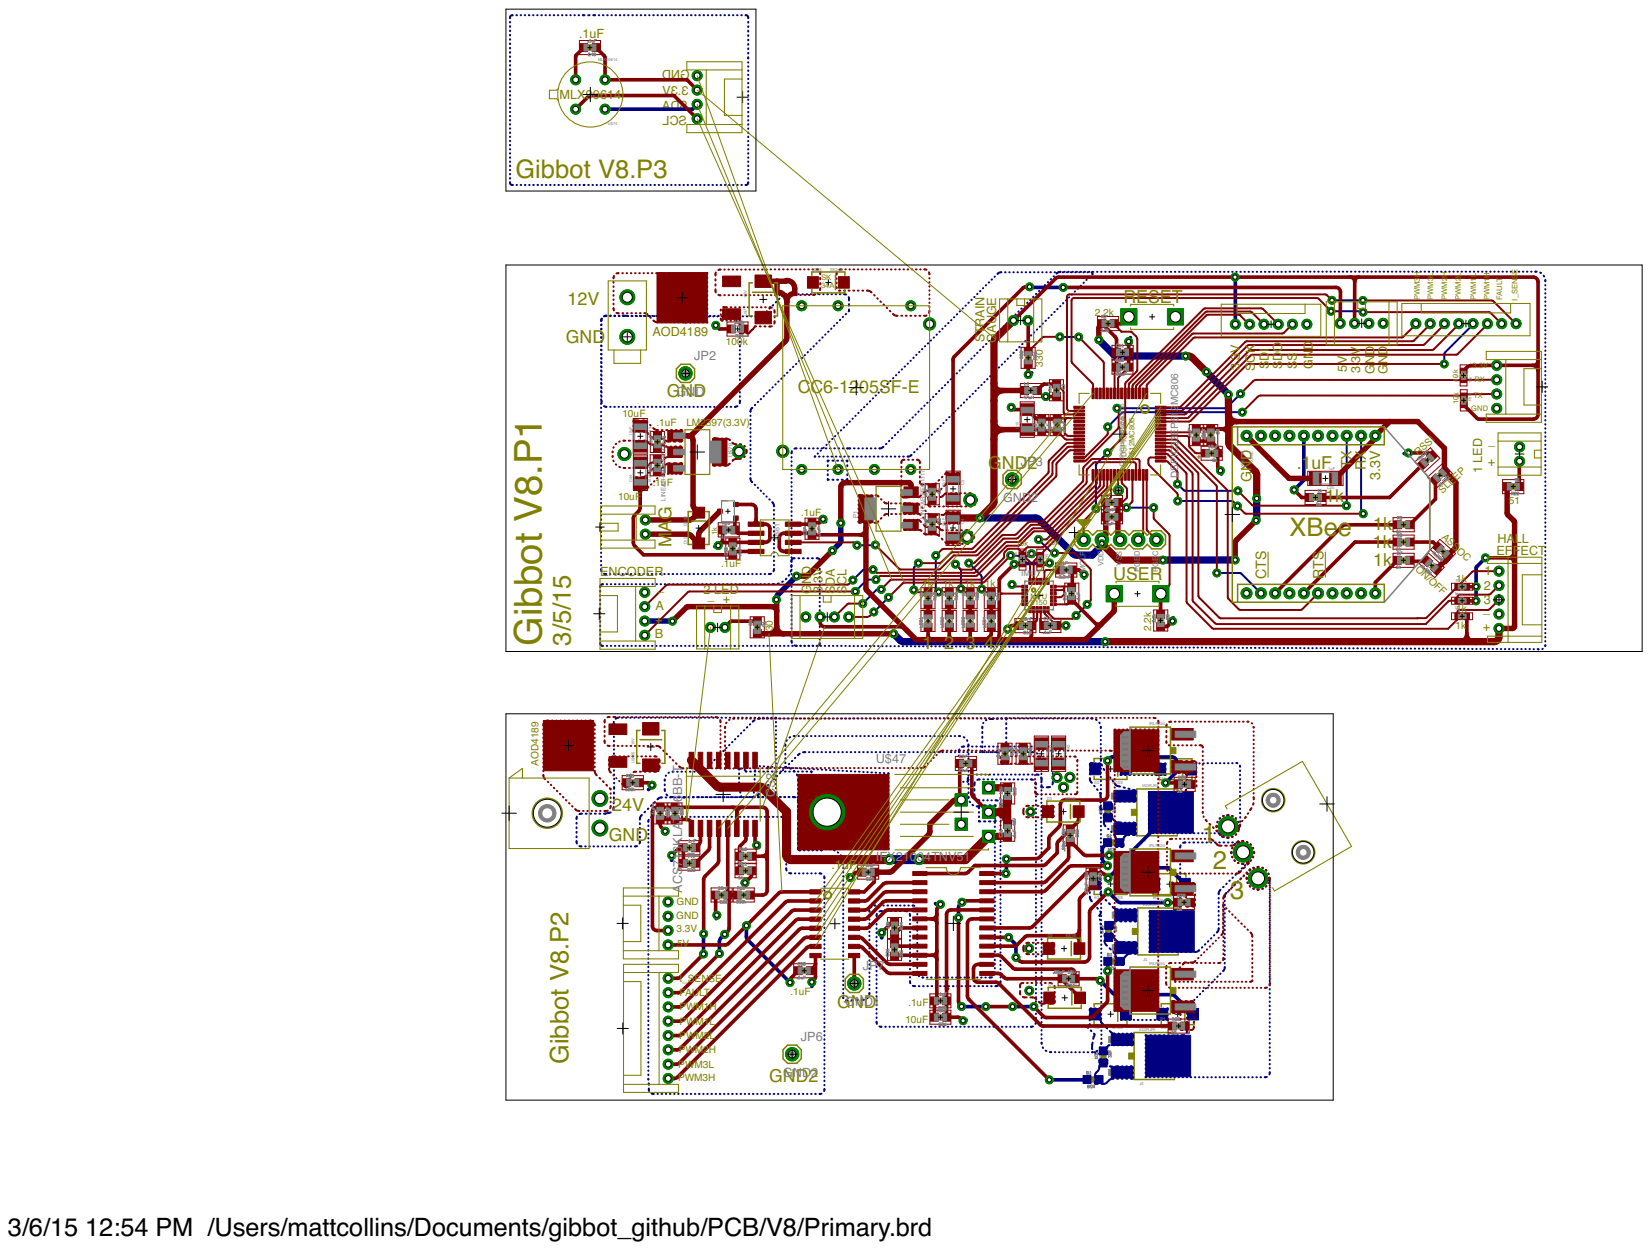
[picture p247: page 1]

3/6/15 12:54 PM /Users/mattcollins/Documents/gibbot_github/PCB/V8/Primary.brd
