NxRLab/gibbot/PCB/V8/Primary1.pdf

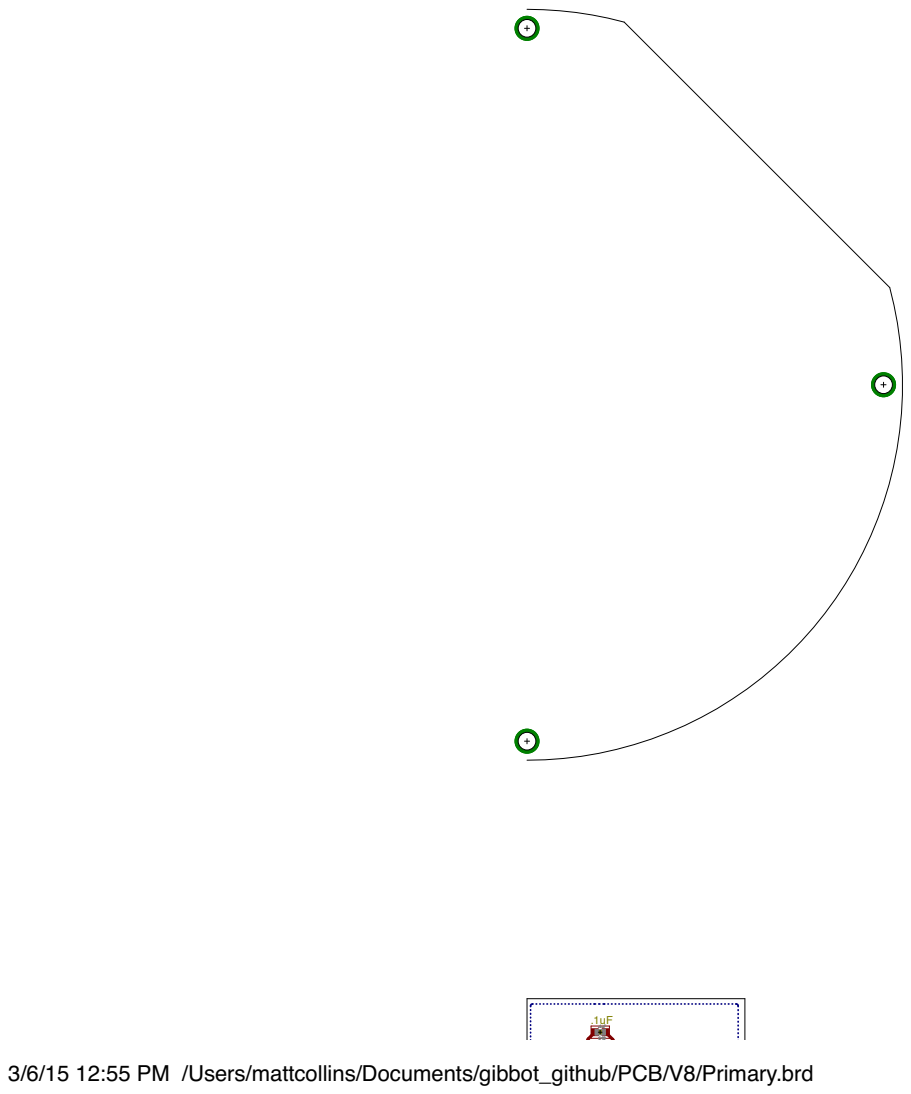
[picture p248: page 1]

3/6/15 12:55 PM /Users/mattcollins/Documents/gibbot_github/PCB/V8/Primary.brd
