NxRLab/gibbot/Frame/CAD v3/10.5in Frame/Drawings/Motor Link Frame.PDF

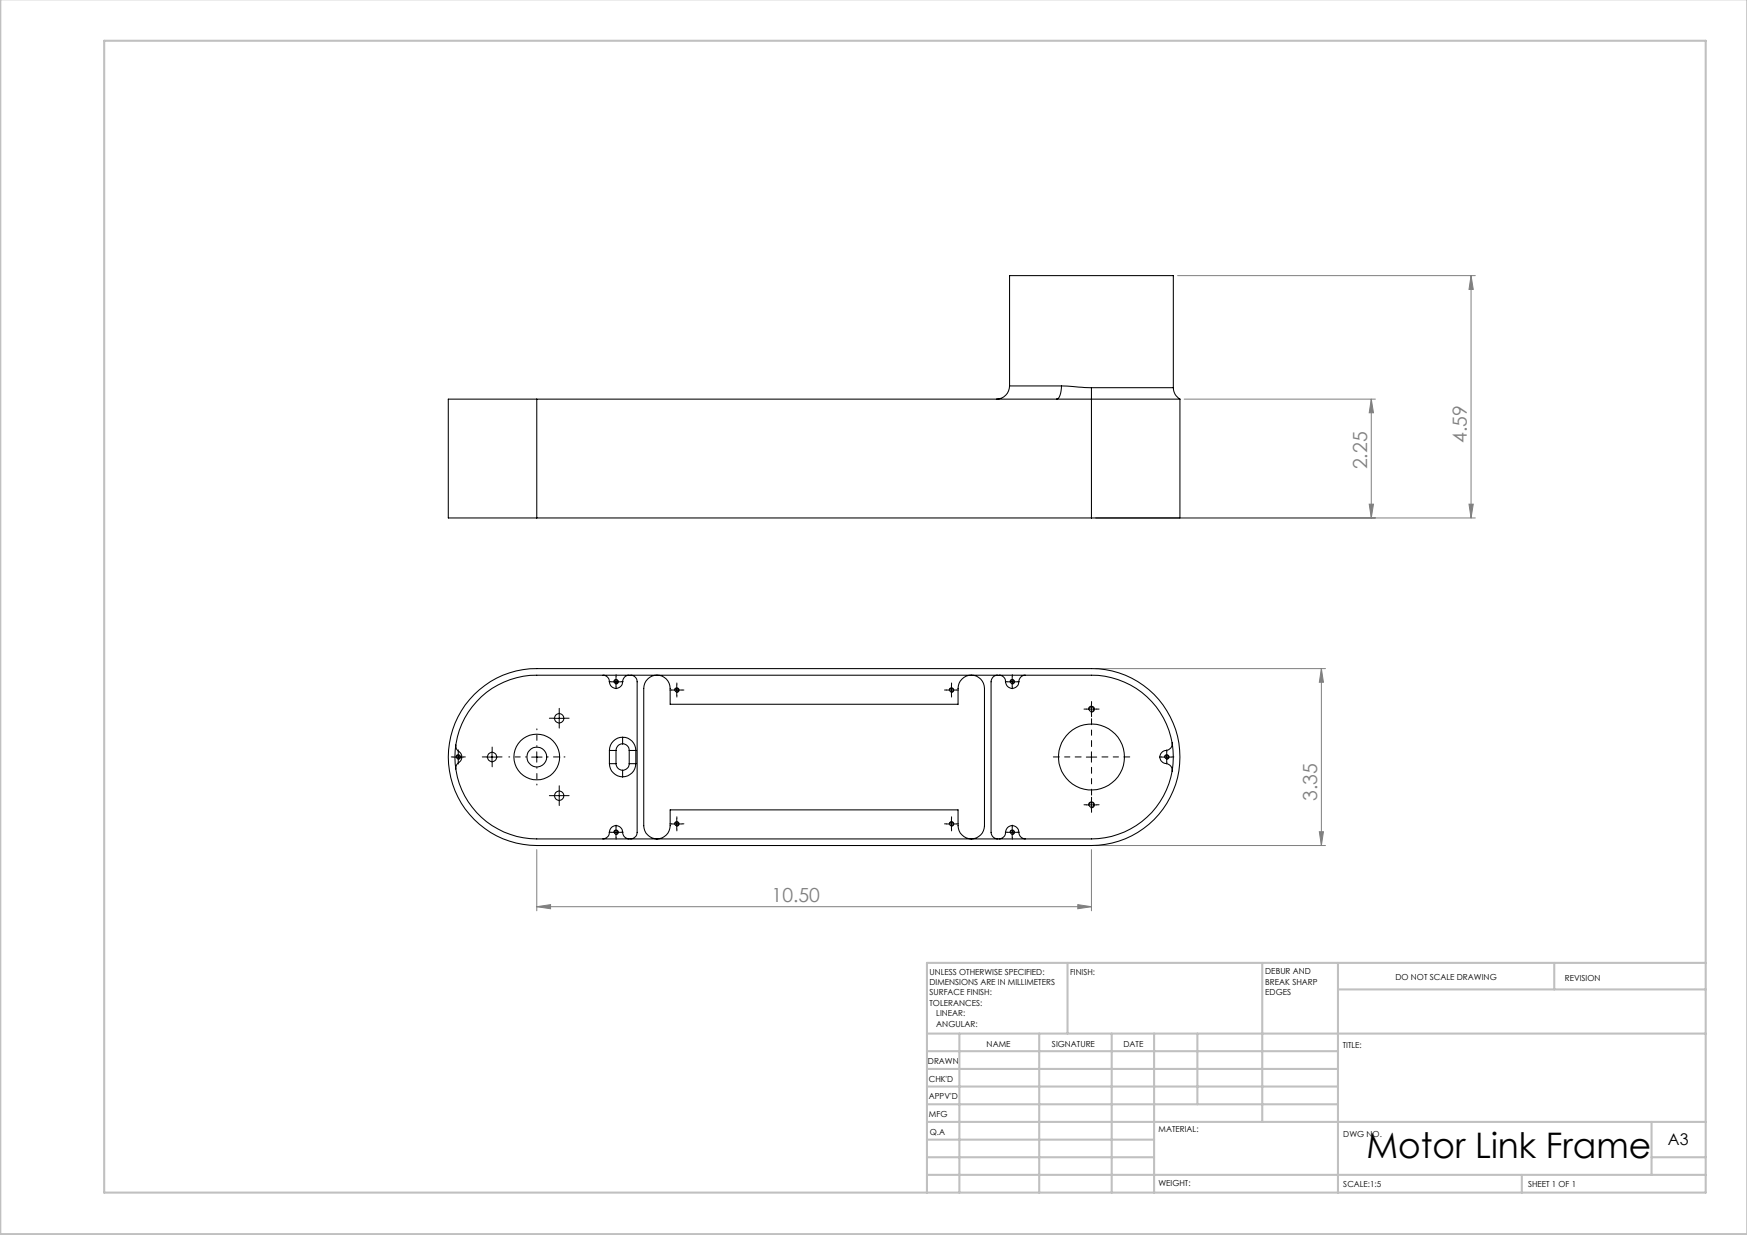
[picture p249: page 1]
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

DIMENSIONS ARE IN MILLIMETERS
SURFACE FINISH:
TOLERANCES:
LINEAR:
ANGULAR:

NAME | SIGNATURE | DATE | | | | TITLE:
Q.A | | | | MATERIAL: | Motor Link Frame WEIGHT: DWG NO. | A3

DRAWN
CHK'D
APPV'D
MFG
