NxRLab/gibbot/Frame/CAD v3/10.5in Frame/Drawings/magnet holder dimensions.PDF

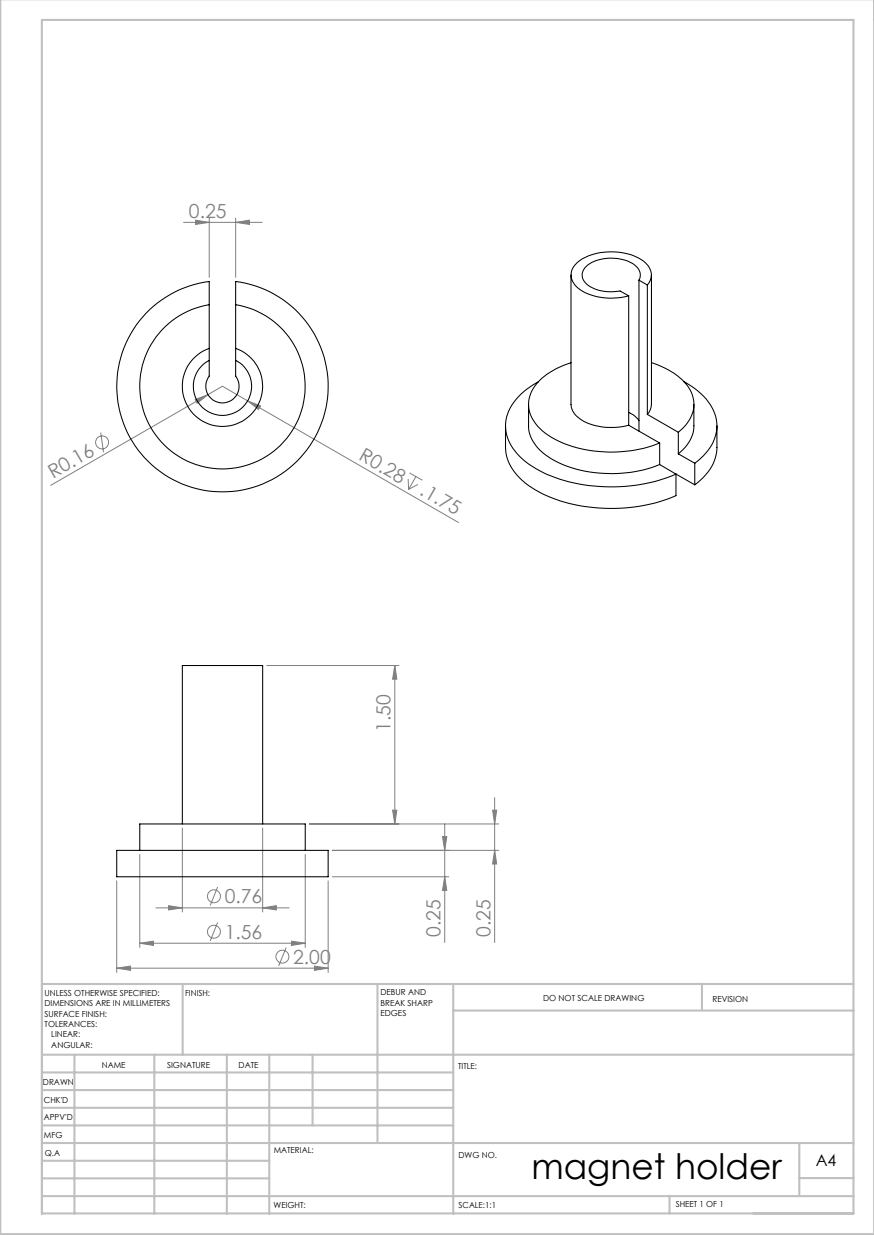
[picture p250: page 1]
SCALE:1:1; SHEET 1 OF 1; DO NOT SCALE DRAWING; REVISION; DEBUR AND BREAK SHARP; UNLESS OTHERWISE SPECIFIED:; FINISH:

DIMENSIONS ARE IN MILLIMETERS
SURFACE FINISH:
TOLERANCES:
LINEAR:
ANGULAR:

NAME | SIGNATURE | DATE | | | | TITLE:
Q.A | | | | MATERIAL: | magnet holder WEIGHT: DWG NO. | A4

DRAWN
CHK'D
APPV'D
MFG
