NxRLab/gibbot/Frame/CAD v3/10.5in Frame/Drawings/Wall Link Frame.PDF

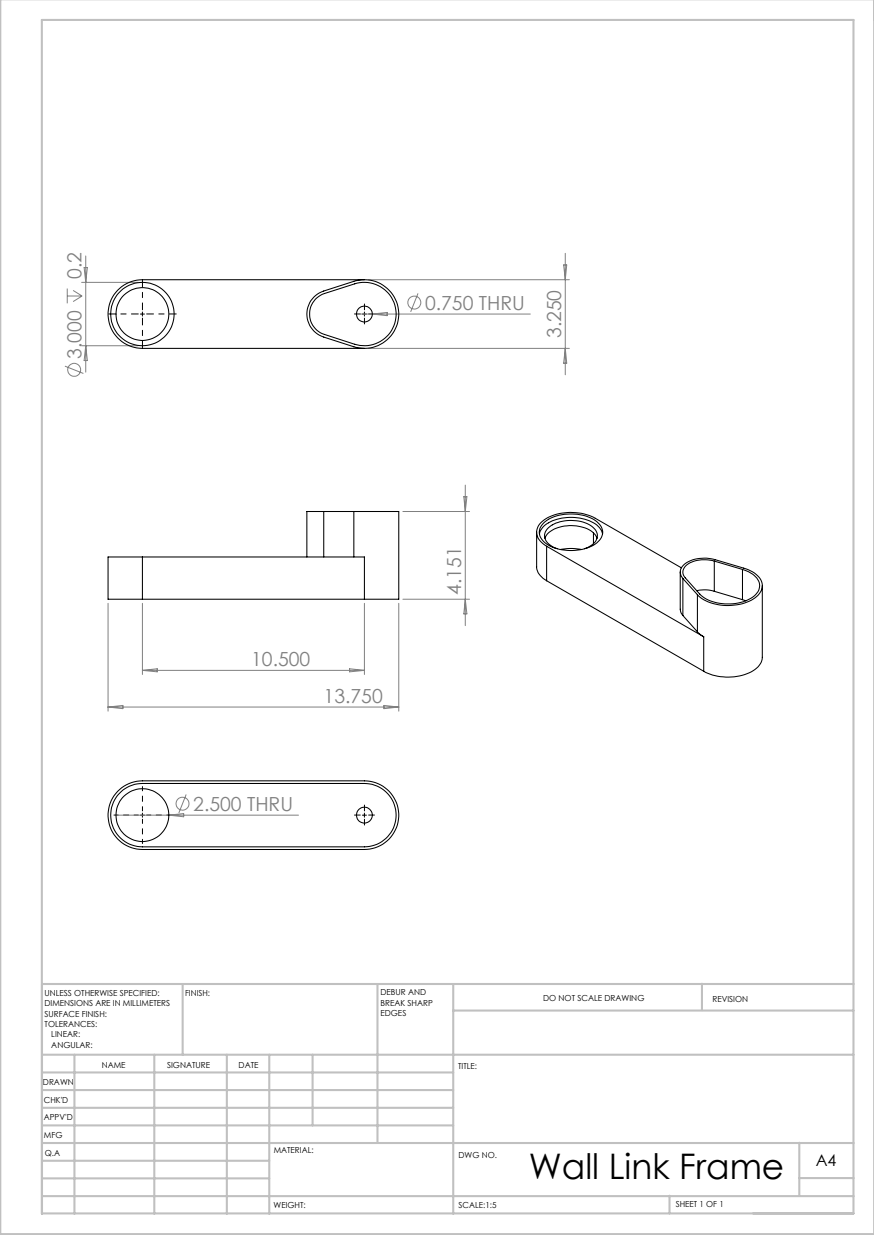
[picture p251: page 1]
0.750 THRU; 2.500 THRU; SCALE:1:5; SHEET 1 OF 1; DO NOT SCALE DRAWING; REVISION; DEBUR AND BREAK SHARP; UNLESS OTHERWISE SPECIFIED:; FINISH:

DIMENSIONS ARE IN MILLIMETERS
SURFACE FINISH:
TOLERANCES:
LINEAR:
ANGULAR:

NAME | SIGNATURE | DATE | | | | TITLE:
Q.A | | | | MATERIAL: | Wall Link Frame WEIGHT: DWG NO. | A4

DRAWN
CHK'D
APPV'D
MFG
