NxRLab/gibbot/Documentation/Reports/PCB Documentation/images/clamp1.pdf

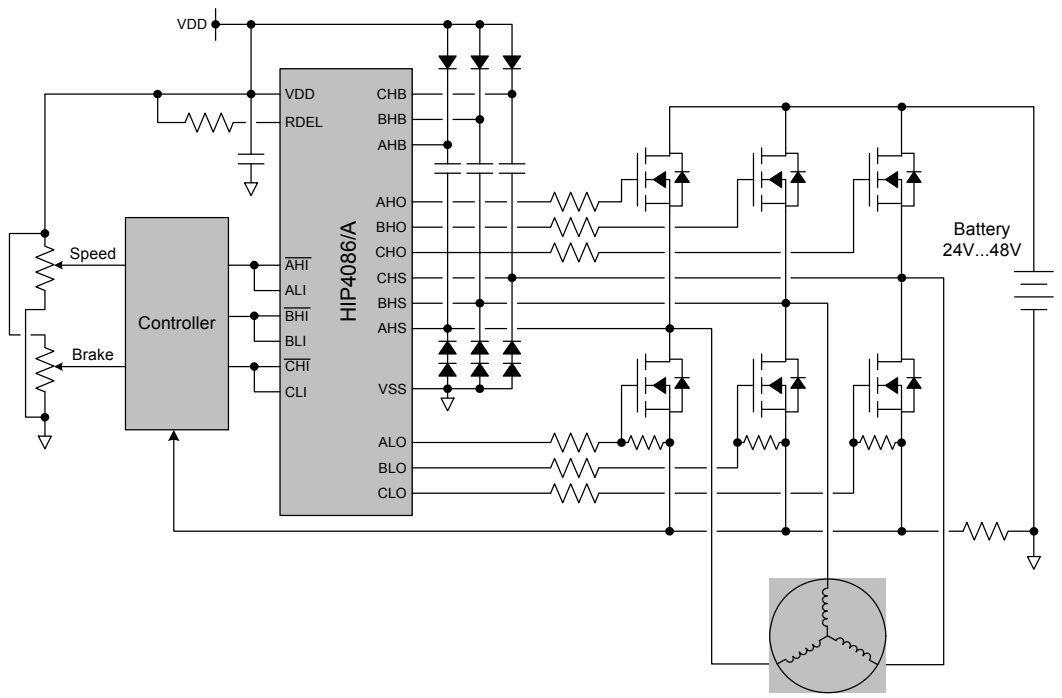
[picture p252: page 1]
Con; trolle; pee; HIP4086/A

AHO CLO BLO ALO CHO BHO
