NxRLab/gibbot/Documentation/Reports/PCB Documentation/images/hbridge.pdf

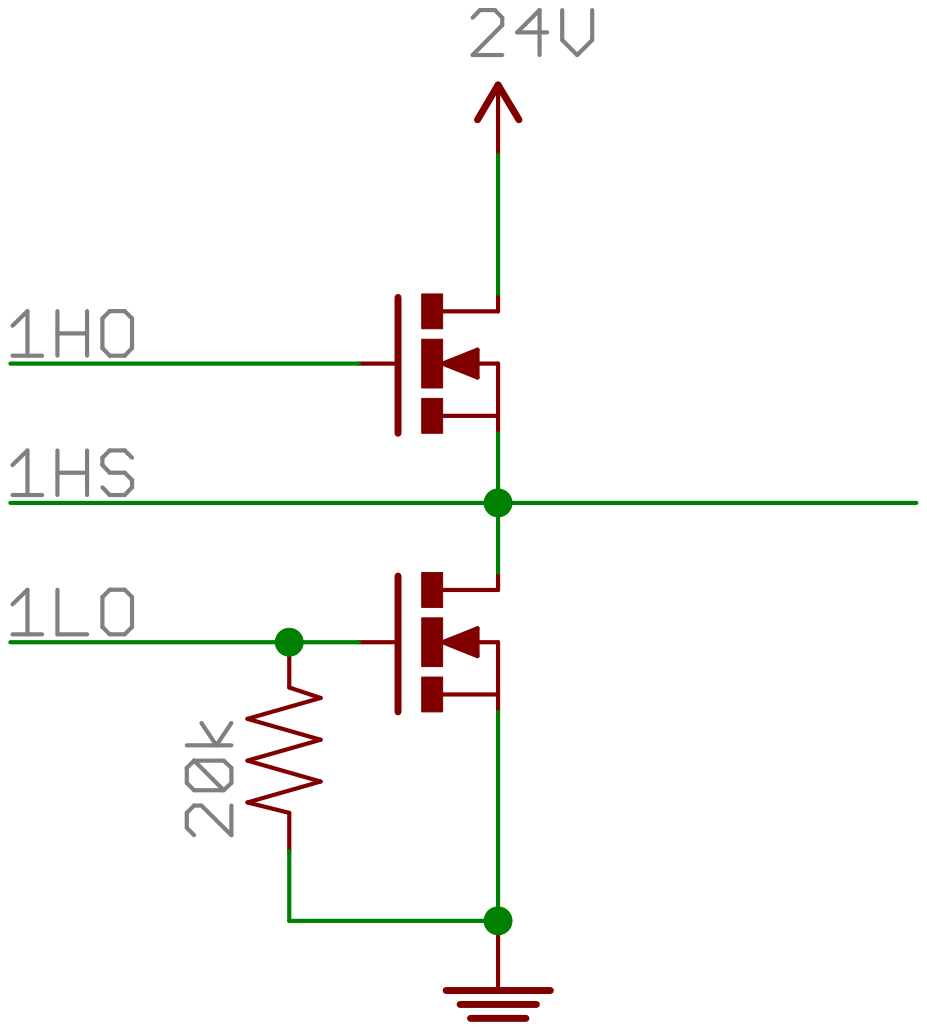
[picture p253: page 1]
