NxRLab/gibbot/PCB/Gibbot v4/Control.pdf

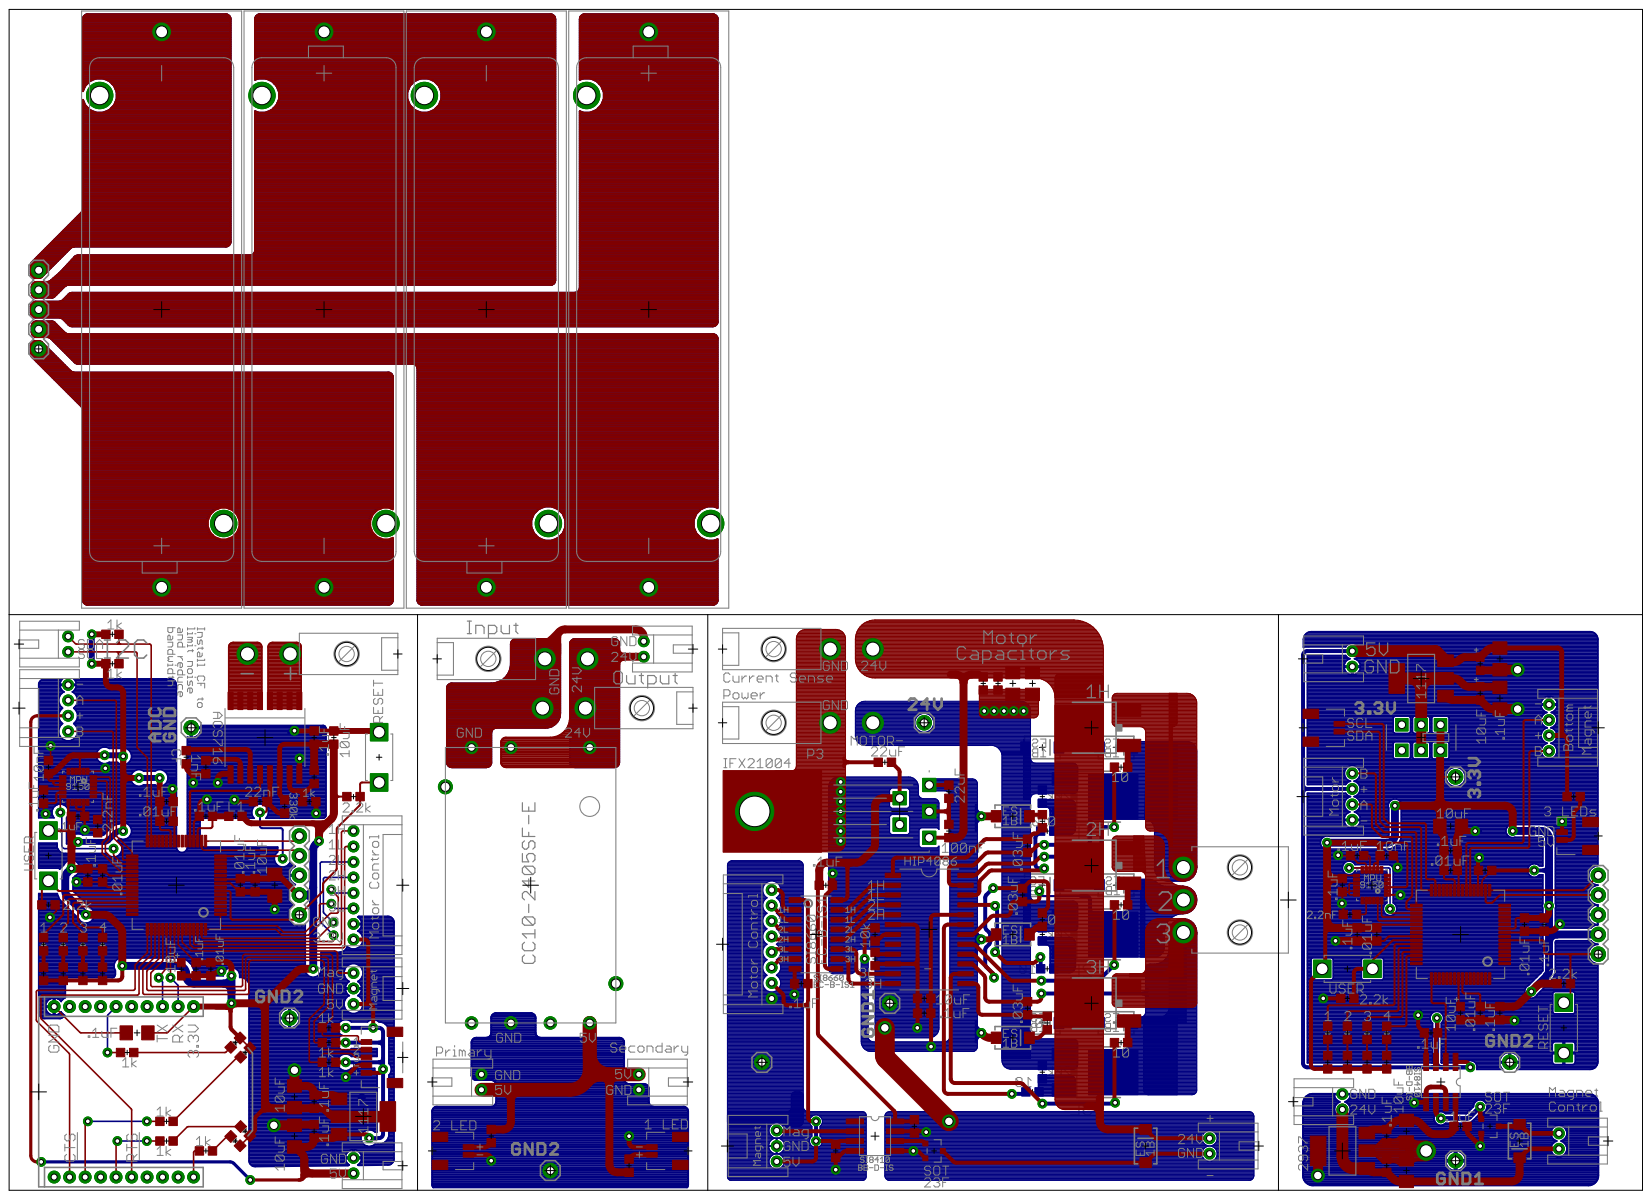
[picture p254: page 1]
