NxRLab/gibbot/PCB/Gibbot v4/Controlbrd.pdf

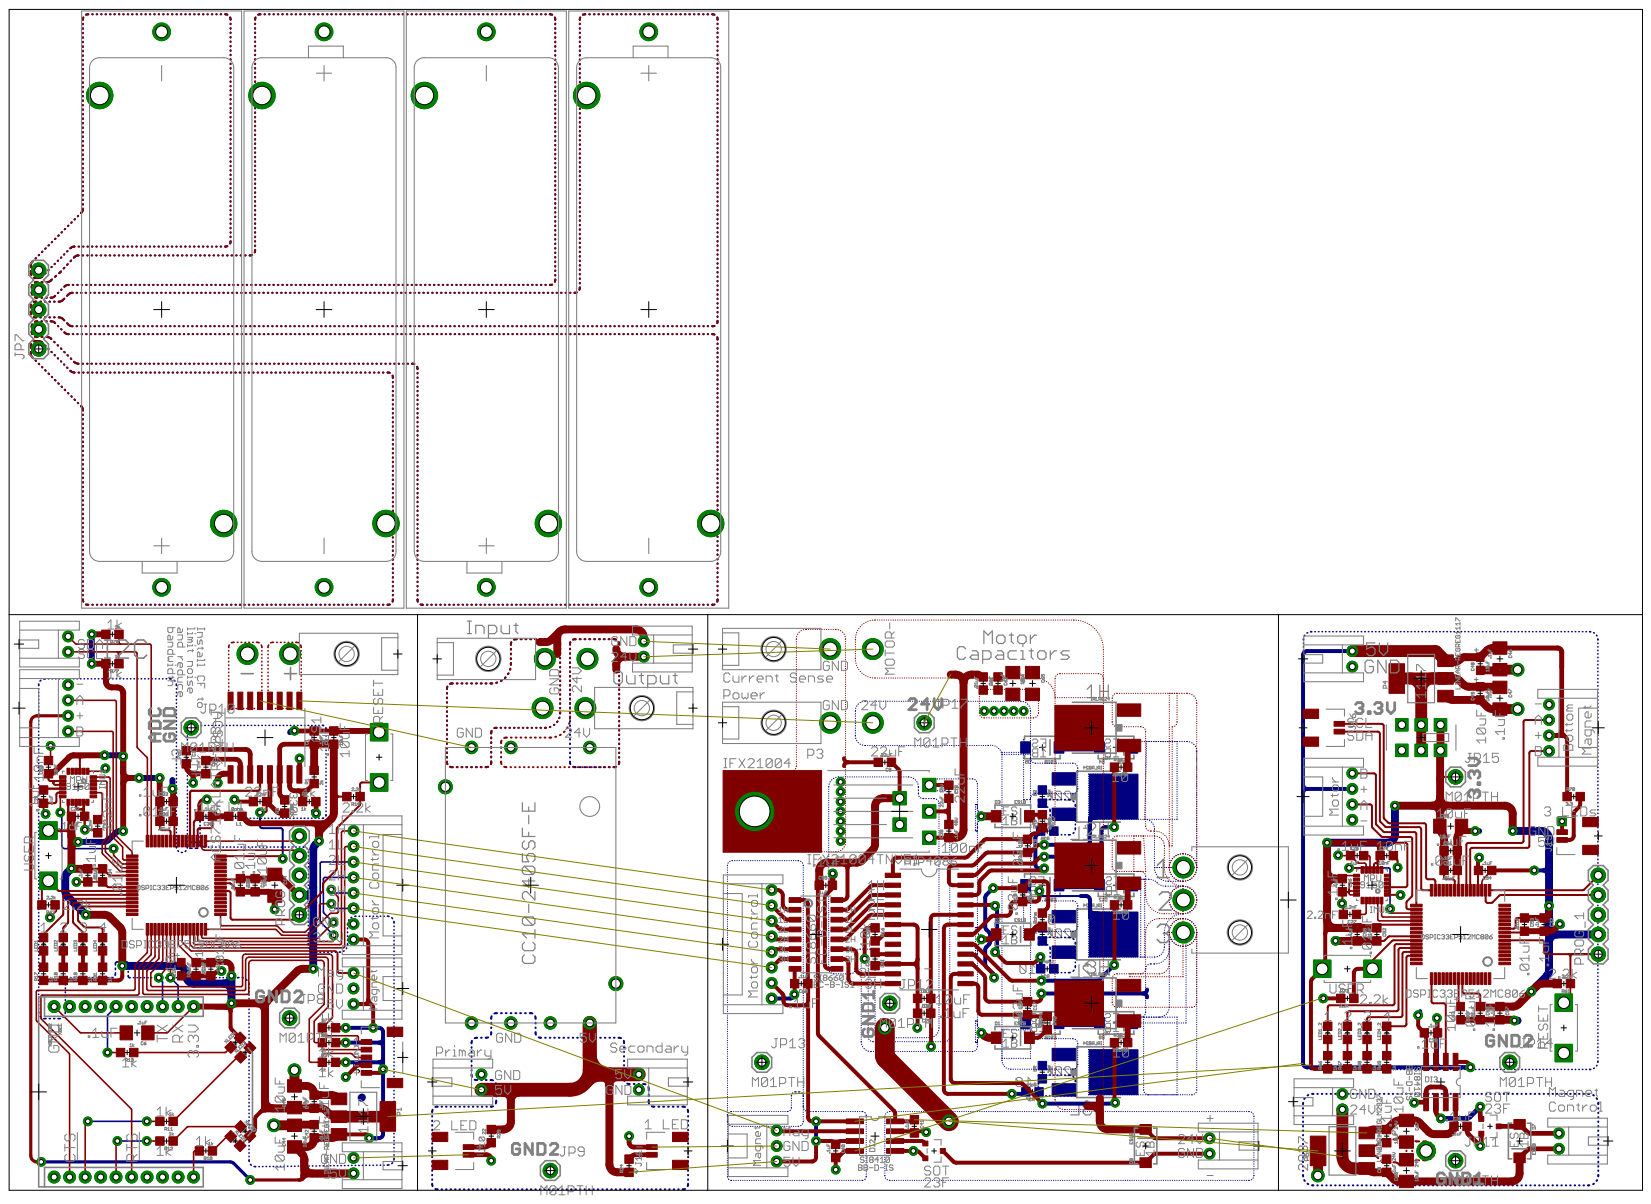
[picture p255: page 1]
