NxRLab/gibbot/Frame/CAD v1/Drawings and PDFs/PDFs/1001-0001-01 ELECTROMAGNET TEST FIXTURE.pdf

# .188 THRU ONE FACE (TYP 2 PLCS)

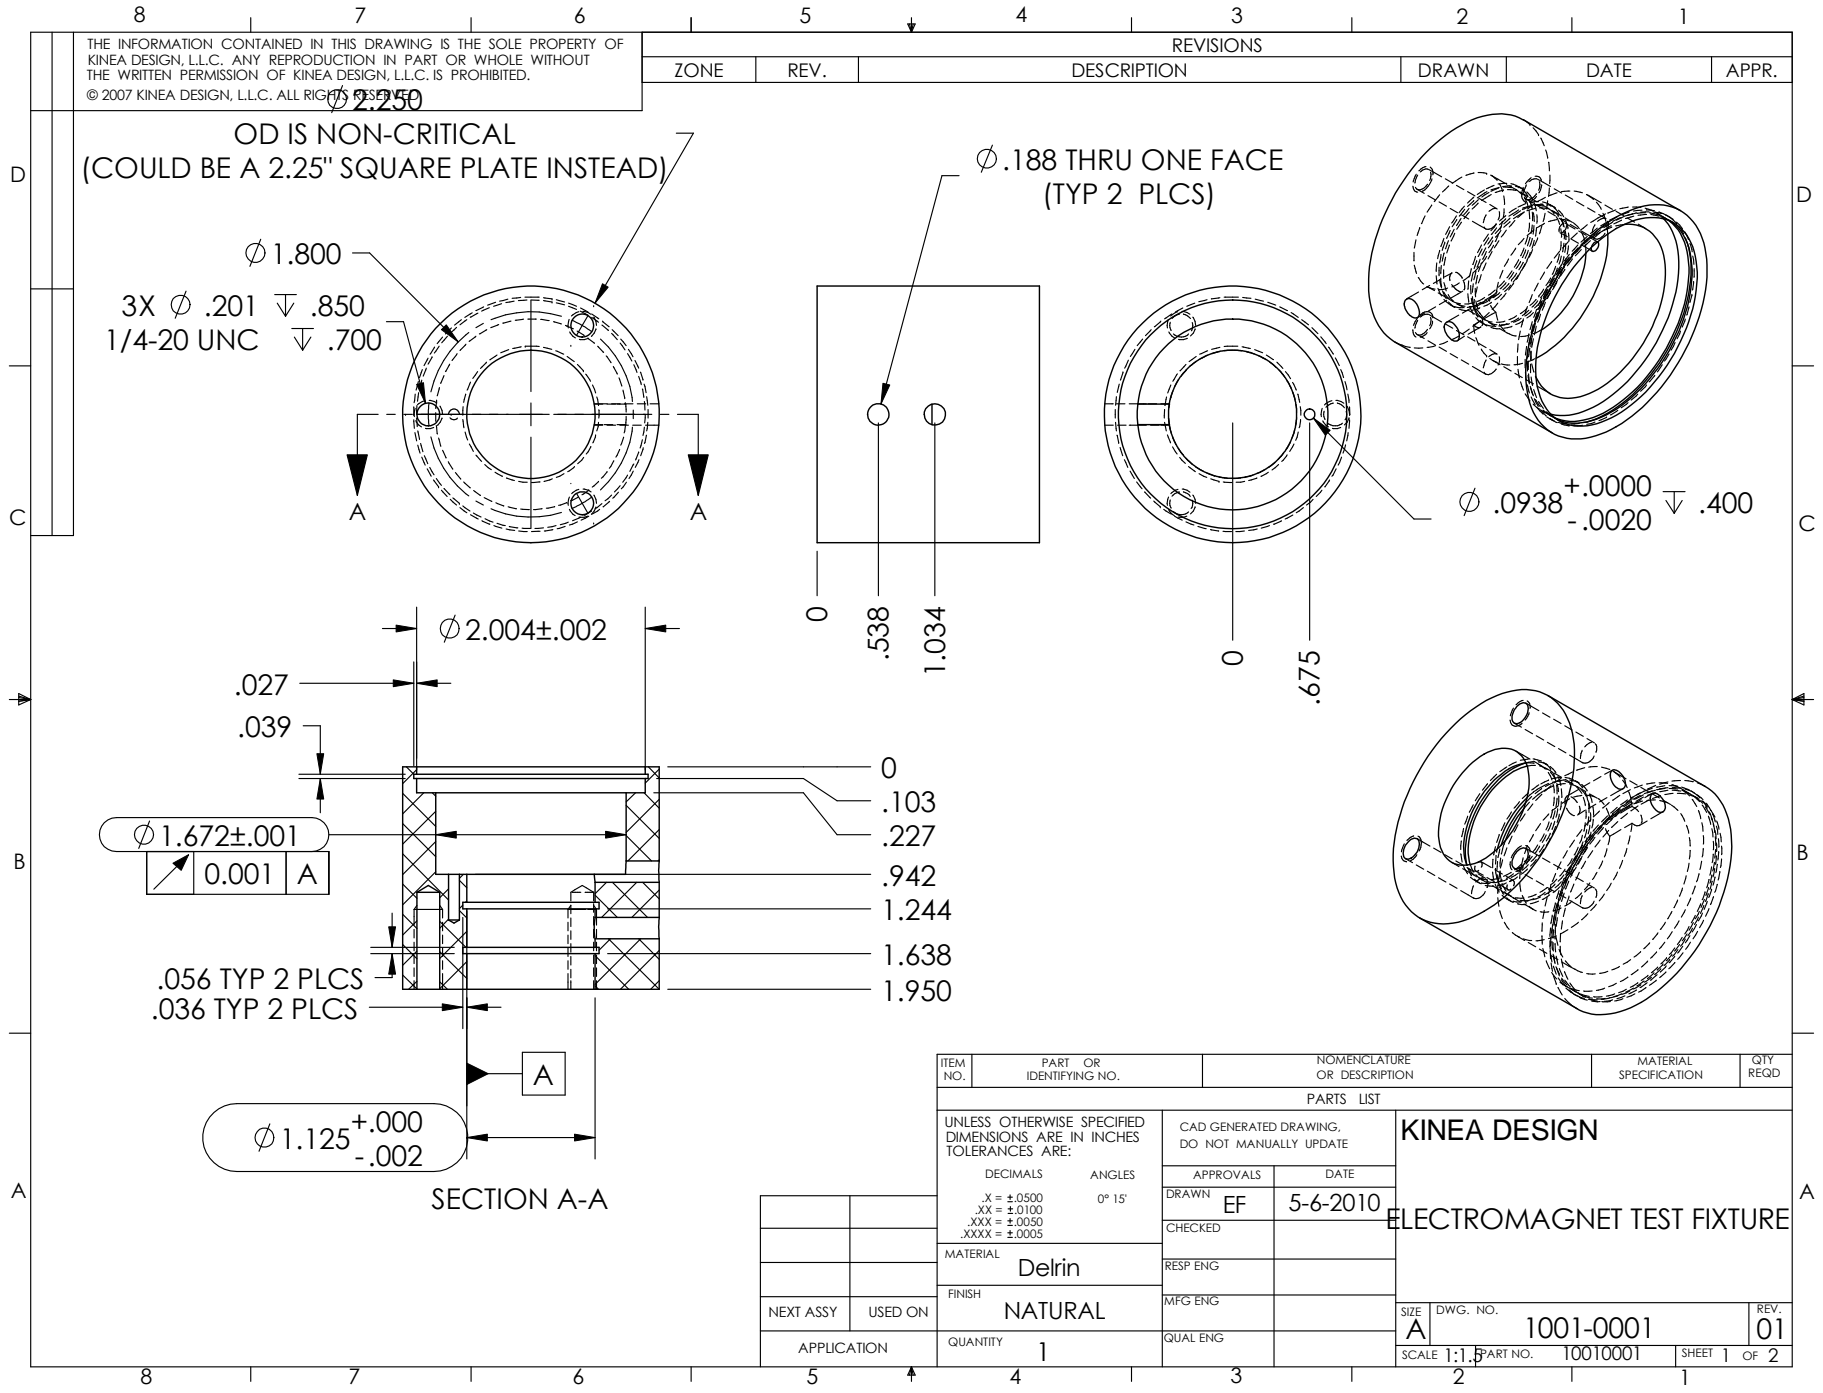
[picture p256: page 1]
SECTION A-A; .036 TYP 2 PLCS; .056 TYP 2 PLCS; 1/4-20 UNC; FINISH; 1 QUANTITY; NATURAL; MATERIAL; ITEM NO.; PART; IDENTIFYING NO.; NOMENCLATURE OR DESCRIPTION; MATERIAL SPECIFICATION; QTY REQD; PARTS LIST; Delrin

THE INFORMATION CONTAINED IN THIS DRAWING IS THE SOLE PROPERTY OF KINEA DESIGN, L.L.C. ANY REPRODUCTION IN PART OR WHOLE WITHOUT THE WRITTEN PERMISSION OF KINEA DESIGN, L.L.C. IS PROHIBITED. © 2007 KINEA DESIGN, L.L.C. ALL RIGHTS RESERVED 2.250 | REVISIONS

ZONE | REV. | DESCRIPTION | DRAWN | DATE | APPR.

OD IS NON-CRITICAL

(COULD BE A 2.25" SQUARE PLATE INSTEAD)

UNLESS OTHERWISE SPECIFIED DIMENSIONS ARE IN INCHES TOLERANCES ARE: DECIMALS ANGLES .X = .0500 0° 15' .XX = .0100 .XXX = .0050 .XXXX = .0005 | CAD GENERATED DRAWING, DO NOT MANUALLY UPDATE | KINEA DESIGN

APPROVALS | DATE
DRAWN EF | 5-6-2010

CHECKED

ELECTROMAGNET TEST FIXTURE

RESP ENG

NEXT ASSY | USED ON | | MFG ENG | SIZE | DWG. NO. 1001-0001 | REV. 01

APPLICATION | | | QUAL ENG

SCALE 1:1.5 | PART NO. 10010001 | SHEET 1 OF 2
