NxRLab/gibbot/PCB/Gibbot v2/Gibbot.pdf

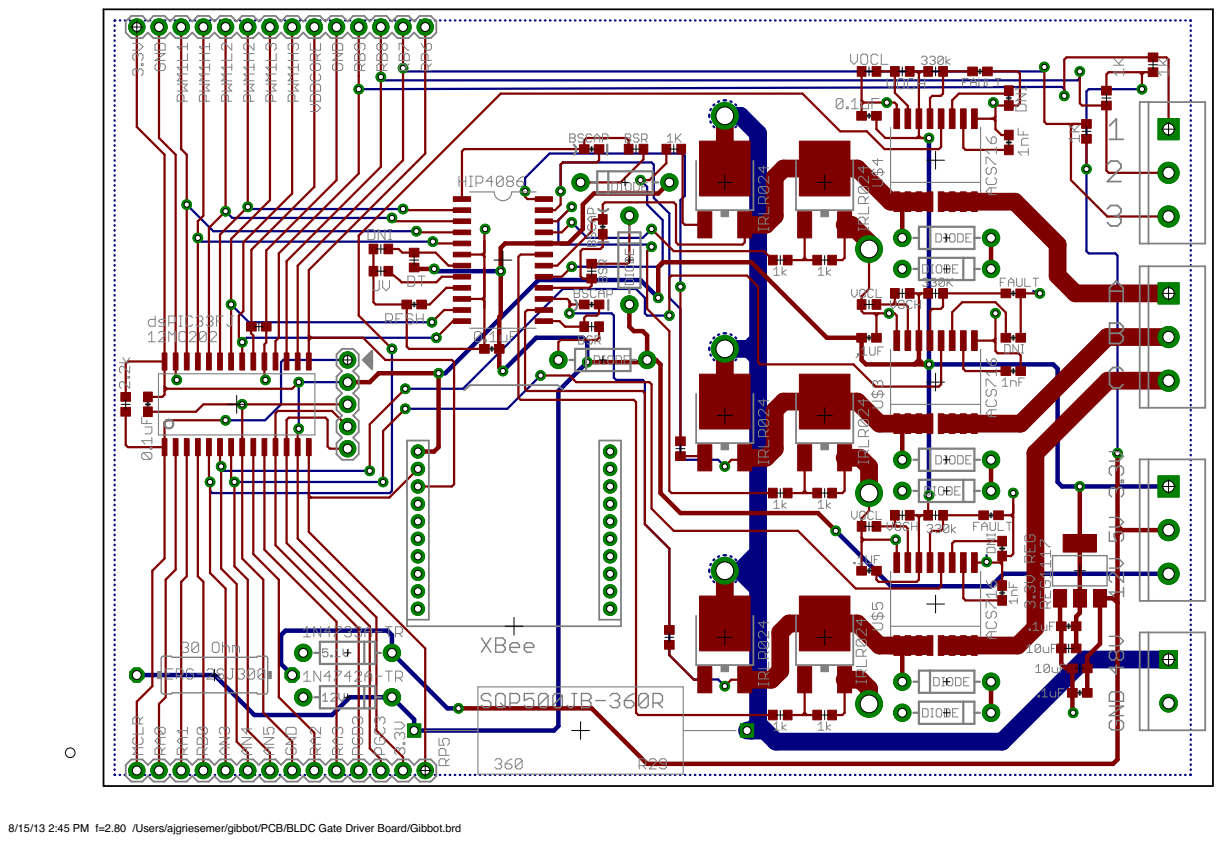
[picture p257: page 1]

8/15/13 2:45 PM f=2.80 /Users/ajgriesemer/gibbot/PCB/BLDC Gate Driver Board/Gibbot.brd
