NxRLab/gibbot/Frame/CAD v1/Drawings and PDFs/PDFs/1001-3001-03 ELECTROMAGNET STATOR.pdf

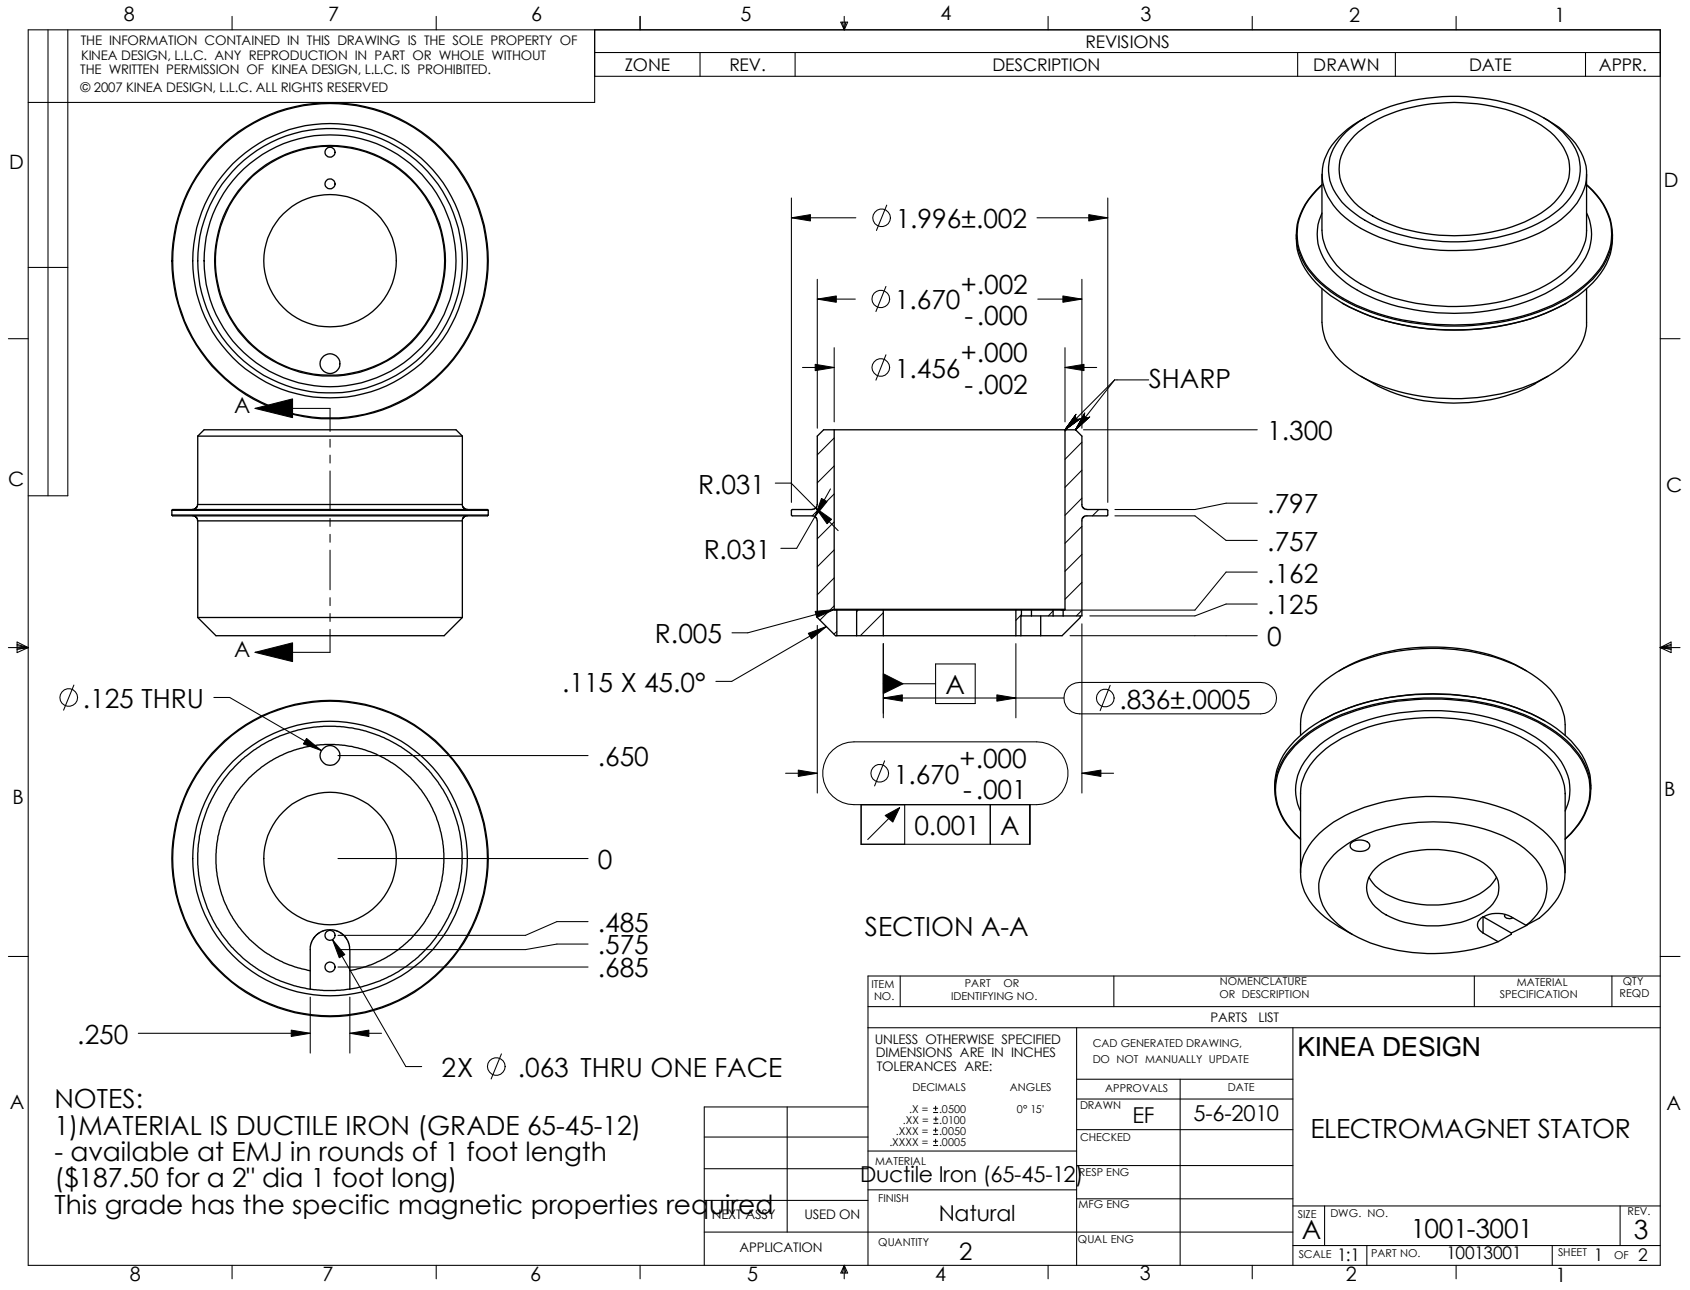
[picture p258: page 1]
SHARP; SECTION A-A; .125 THRU; .063 THRU ONE FACE; FINISH; Natural; Ductile Iron (65-45-12); MATERIAL; ITEM NO.; PART; IDENTIFYING NO.; NOMENCLATURE OR DESCRIPTION; MATERIAL SPECIFICATION; QTY REQD; PARTS LIST

THE INFORMATION CONTAINED IN THIS DRAWING IS THE SOLE PROPERTY OF KINEA DESIGN, L.L.C. ANY REPRODUCTION IN PART OR WHOLE WITHOUT THE WRITTEN PERMISSION OF KINEA DESIGN, L.L.C. IS PROHIBITED. © 2007 KINEA DESIGN, L.L.C. ALL RIGHTS RESERVED | REVISIONS

ZONE | REV. | DESCRIPTION | DRAWN | DATE | APPR.

UNLESS OTHERWISE SPECIFIED DIMENSIONS ARE IN INCHES TOLERANCES ARE: DECIMALS ANGLES .X = .0500 0° 15' .XX = .0100 .XXX = .0050 .XXXX = .0005 | CAD GENERATED DRAWING, DO NOT MANUALLY UPDATE | KINEA DESIGN ELECTROMAGNET STATOR

APPROVALS | DATE
DRAWN EF | 5-6-2010

NOTES:
1)MATERIAL IS DUCTILE IRON (GRADE 65-45-12)
- available at EMJ in rounds of 1 foot length
($187.50 for a 2" dia 1 foot long)
This grade has the specific magnetic properties required

CHECKED

RESP ENG

NEXT ASSY | USED ON | | MFG ENG | SIZE A | DWG. NO. 1001-3001 | REV. 3

APPLICATION | | QUANTITY 2 | QUAL ENG

SCALE 1:1 | 10013001 PART NO. | SHEET 1 2 OF
