NxRLab/gibbot/Frame/CAD v1/Drawings and PDFs/PDFs/1001-3006-01 MOTOR LINK HOUSING.pdf

| | THE INFORMATION CONTAINED IN THIS DRAWING IS THE SOLE PROPERTY OF KINEA DESIGN, L.L.C. ANY REPRODUCTION IN PART OR WHOLE WITHOUT THE WRITTEN PERMISSION OF KINEA DESIGN, L.L.C. IS PROHIBITED. © 2007 KINEA DESIGN, L.L.C. ALL RIGHTS RESERVED | REVISIONS
ZONE | REV. | DESCRIPTION | DRAWN | DATE | APPR.

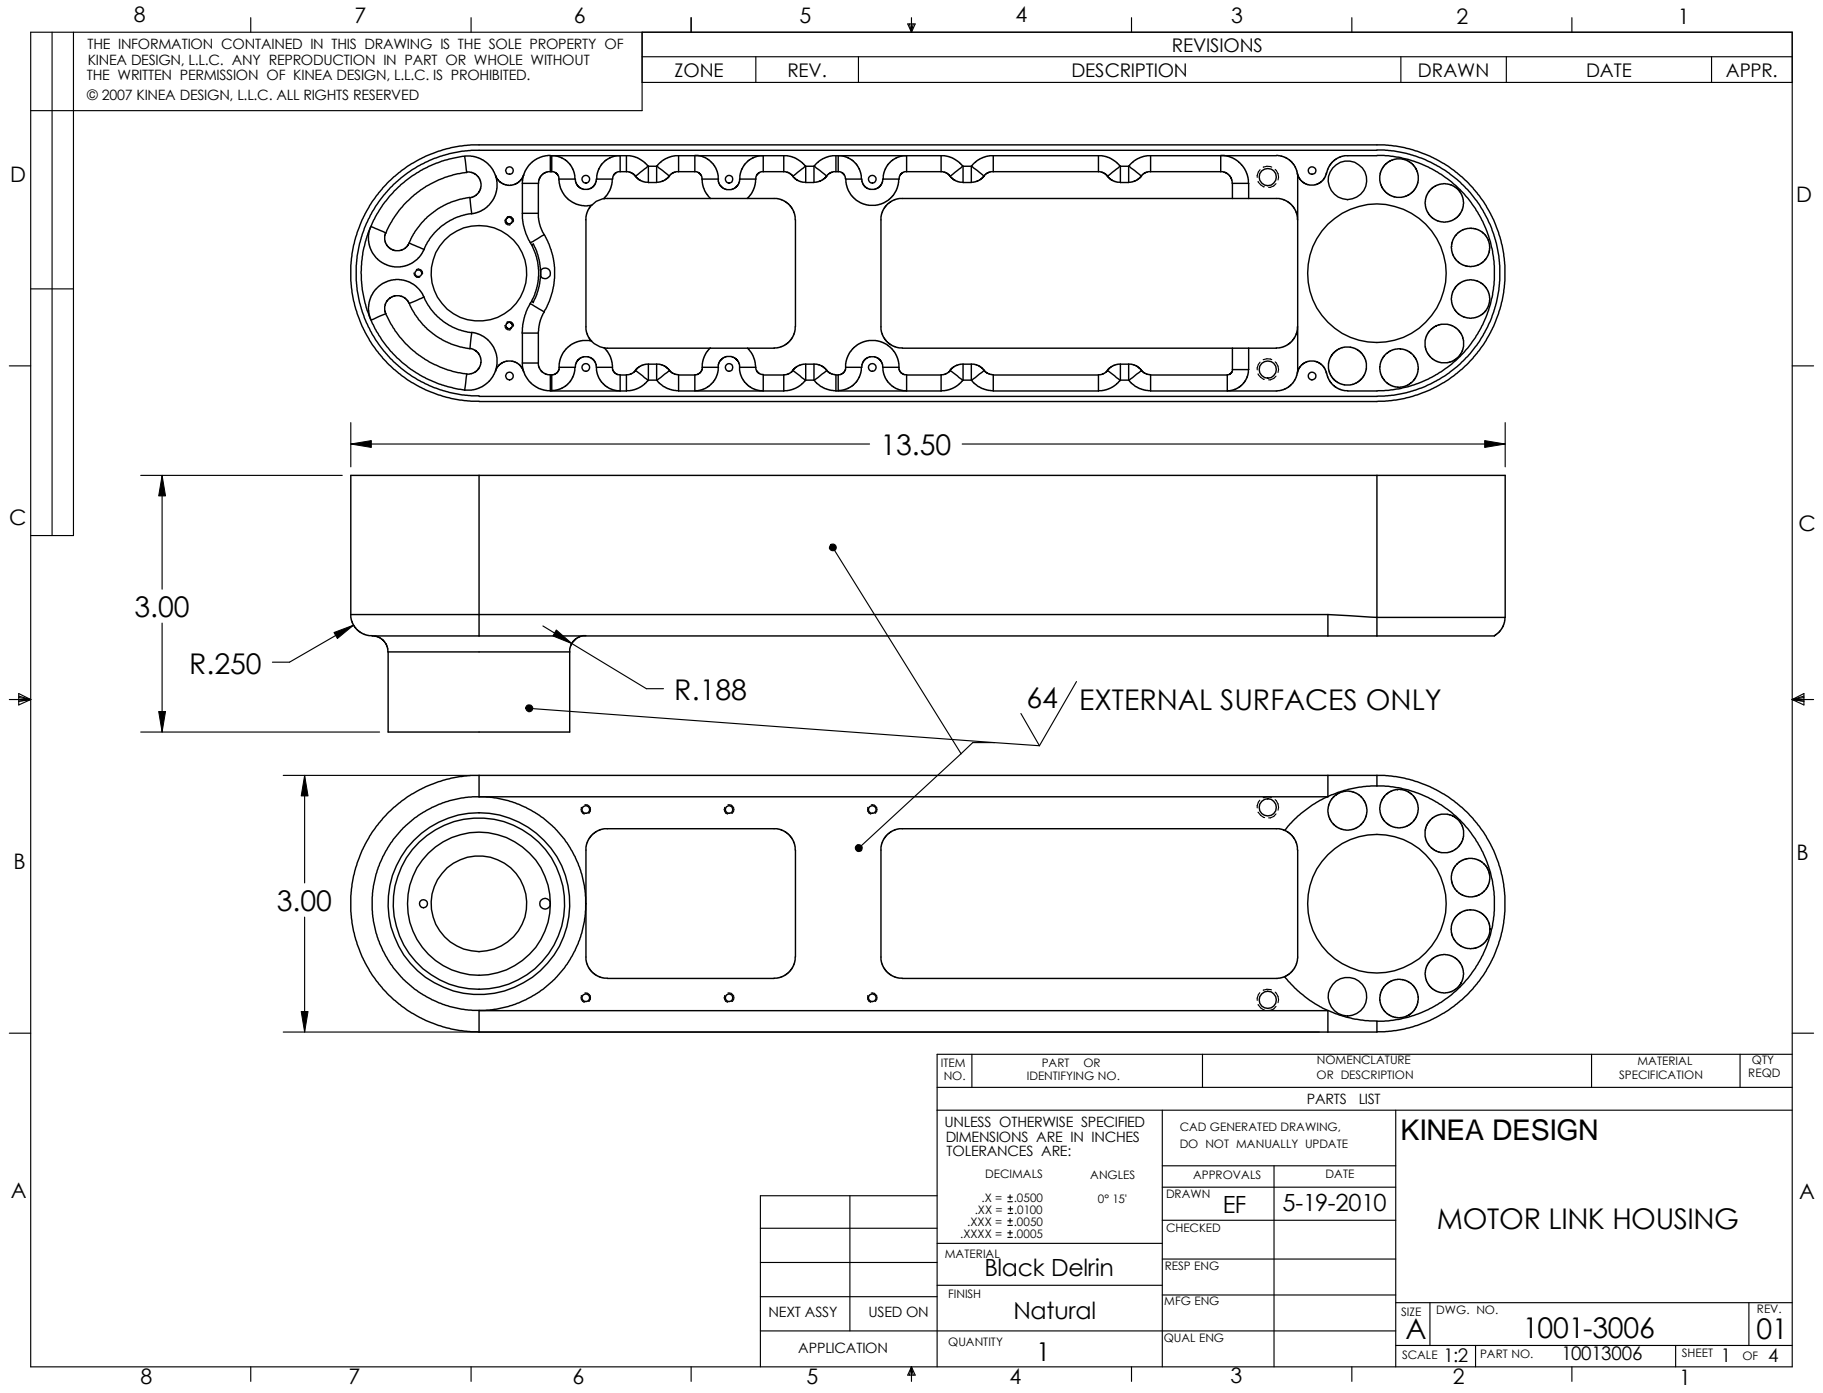
[picture p259: page 1]
FINISH; MATERIAL; ITEM NO.; PART; IDENTIFYING NO.; NOMENCLATURE; OR DESCRIPTION; MATERIAL SPECIFICATION; QTY REQD; PARTS LIST; Black Delrin

EXTERNAL SURFACES ONLY .188

UNLESS OTHERWISE SPECIFIED DIMENSIONS ARE IN INCHES TOLERANCES ARE: DECIMALS ANGLES .X = .0500 0° 15' .XX = .0100 .XXX = .0050 .XXXX = .0005 | CAD GENERATED DRAWING, DO NOT MANUALLY UPDATE | KINEA DESIGN MOTOR LINK HOUSING

APPROVALS | DATE

DRAWN EF | 5-19-2010

CHECKED

RESP ENG

NEXT ASSY | USED ON | A 01 Natural | MFG ENG | SIZE | DWG. NO. 1001-3006 | REV.

APPLICATION | | QUANTITY 1 | QUAL ENG

SCALE 1:2 | PART NO. 10013006 | SHEET 1 OF 4

1.100

1.201

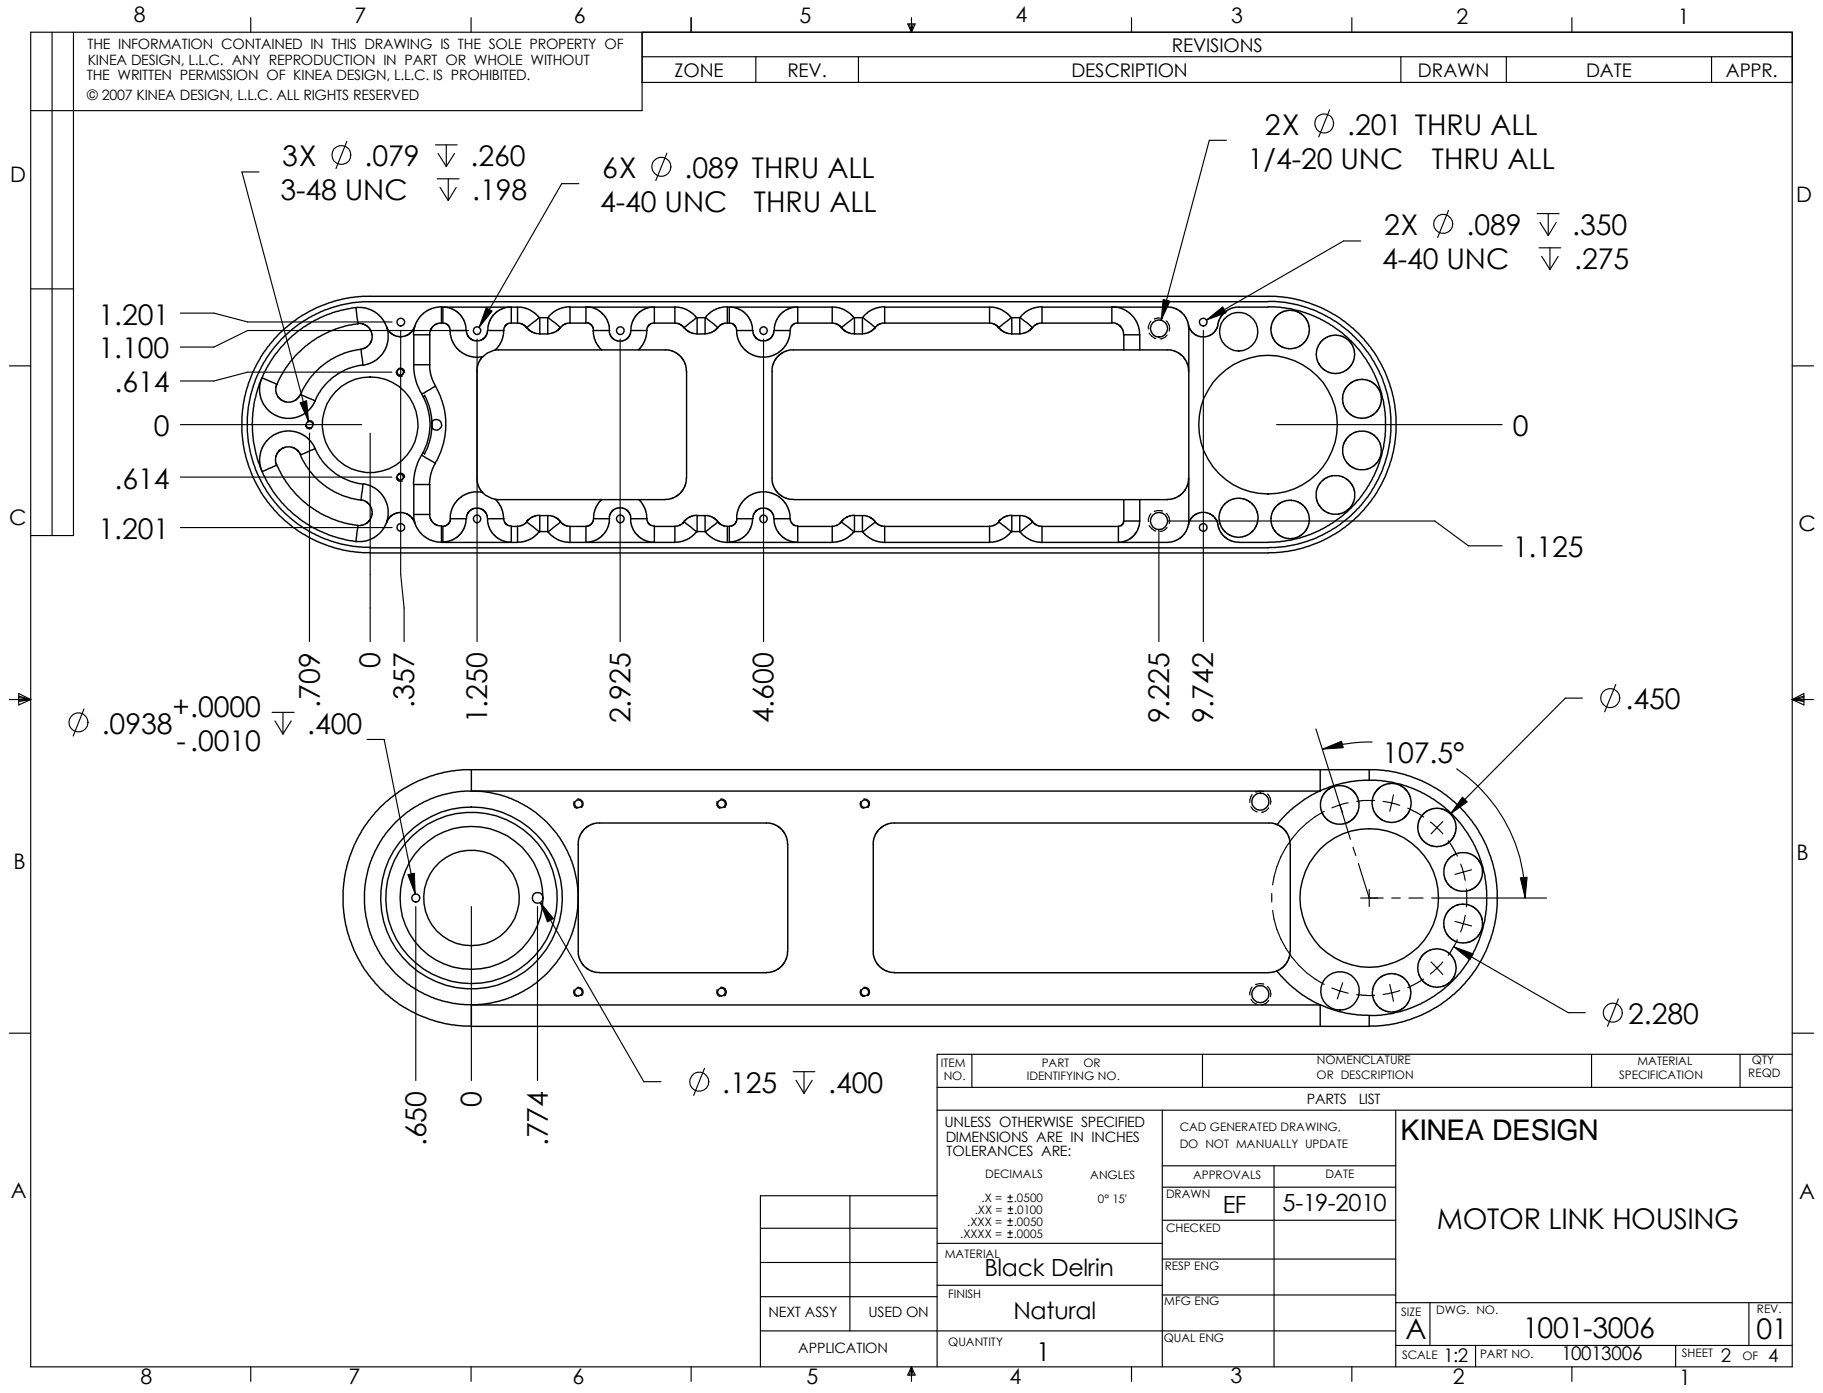
[picture p260: page 2]
3-48 UNC; .089 THRU ALL; 4-40 UNC; THRU ALL; .201 THRU ALL; 1/4-20 UNC THRU ALL; 1001-3006 Natural; QUANTITY; MATERIAL; ITEM NO.; PART; IDENTIFYING NO.; NOMENCLATURE; OR DESCRIPTION; MATERIAL SPECIFICATION; QTY REQD; PARTS LIST; Black Delrin

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

APPROVALS | DATE

DRAWN EF | 5-19-2010

CHECKED

RESP ENG

10.500
.338 | R.325 R | R.325 .125 .250

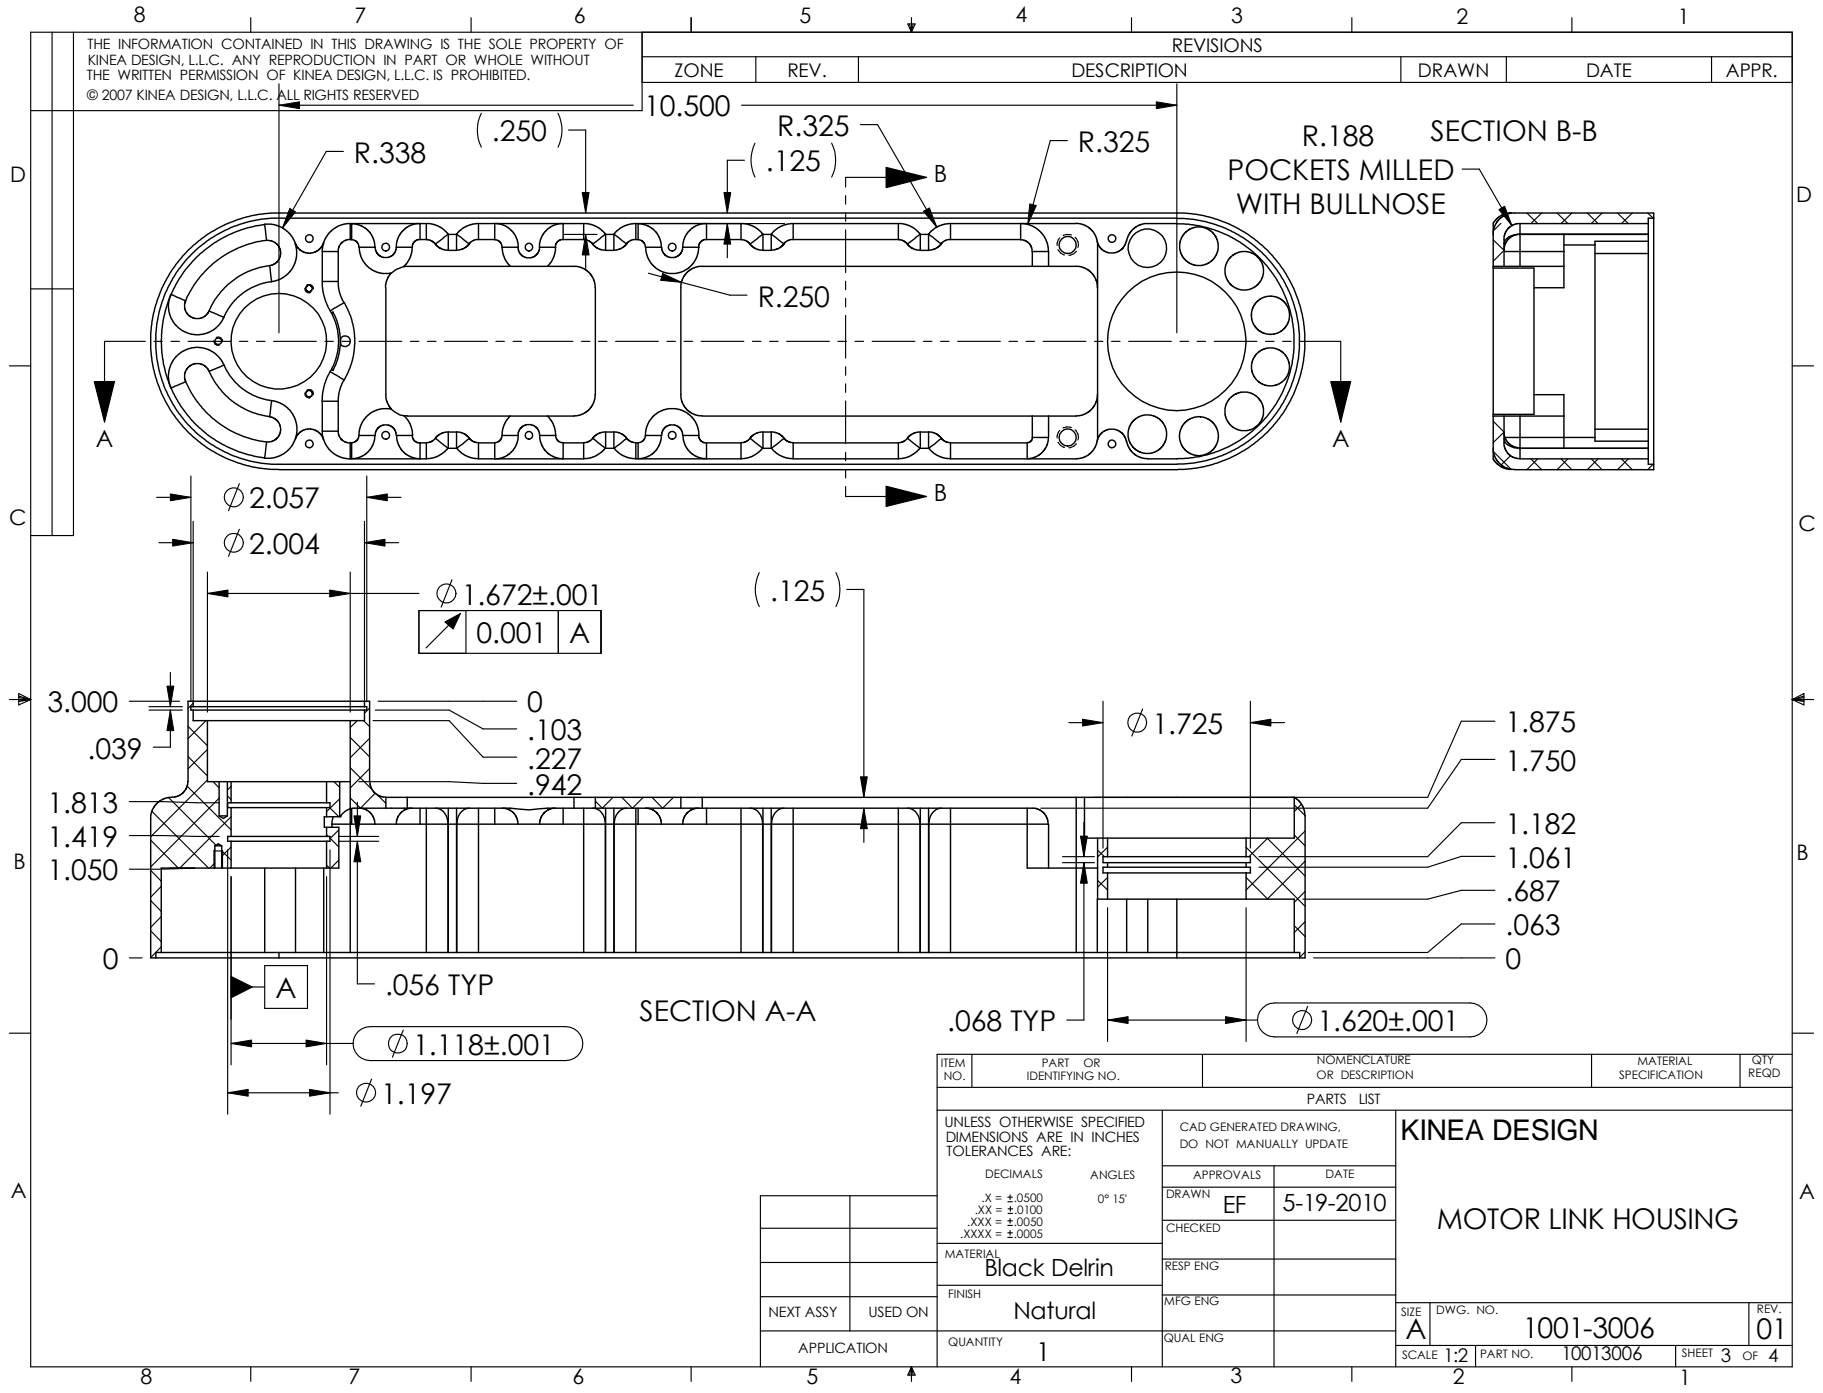
[picture p261: page 3]
1001-3006 Natural; QUANTITY; MATERIAL; ITEM NO.; PART; IDENTIFYING NO.; NOMENCLATURE; OR DESCRIPTION; MATERIAL SPECIFICATION; QTY REQD; PARTS LIST; Black Delrin; SECTION A-A; .068 TYP; TYP; SECTION B-B; POCKETS MILLED WITH BULLNOSE

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

APPROVALS | DATE

DRAWN EF | 5-19-2010

CHECKED

RESP ENG
