NxRLab/gibbot/Frame/CAD v1/Drawings and PDFs/PDFs/1001-3013-01 BATTERY LINK HOUSING.pdf

D

ZONE | REV. | DESCRIPTION | DRAWN | DATE | APPR.

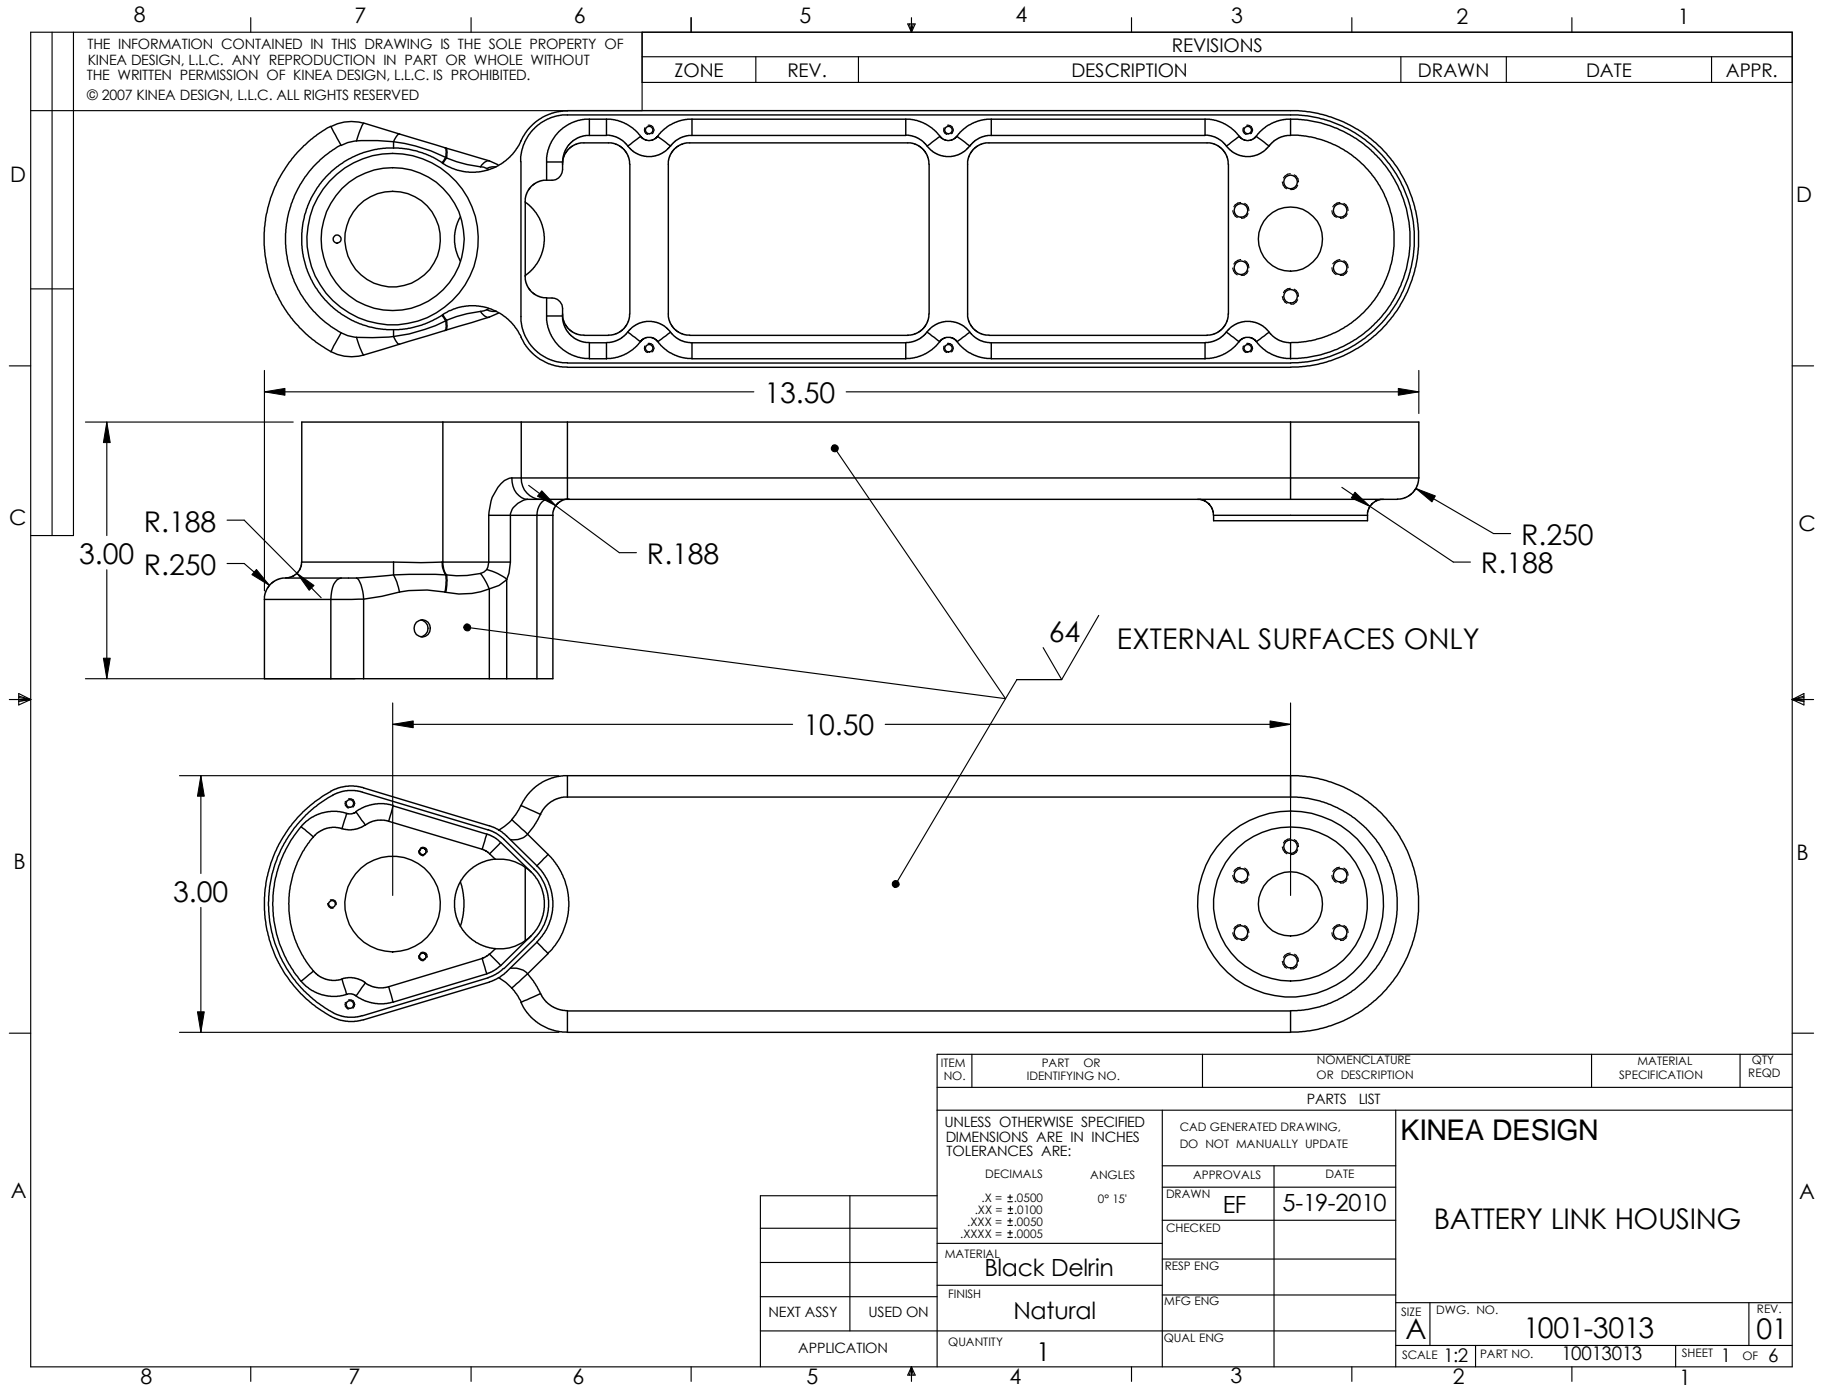
[picture p262: page 1]
SIZE; DWG. NO.; REV.; MFG ENG; MATERIAL; NEXT ASSY; USED ON; ITEM NO.; PART; IDENTIFYING NO.; NOMENCLATURE; OR DESCRIPTION; MATERIAL SPECIFICATION; QTY REQD; PARTS LIST; Black Delrin; Natural; QUANTITY; FINISH

THE INFORMATION CONTAINED IN THIS DRAWING IS THE SOLE PROPERTY OF KINEA DESIGN, L.L.C. ANY REPRODUCTION IN PART OR WHOLE WITHOUT THE WRITTEN PERMISSION OF KINEA DESIGN, L.L.C. IS PROHIBITED. © 2007 KINEA DESIGN, L.L.C. ALL RIGHTS RESERVED | REVISIONS

EXTERNAL SURFACES ONLY

UNLESS OTHERWISE SPECIFIED DIMENSIONS ARE IN INCHES TOLERANCES ARE: DECIMALS ANGLES .X = .0500 0° 15' .XX = .0100 .XXX = .0050 .XXXX = .0005 | CAD GENERATED DRAWING, DO NOT MANUALLY UPDATE | KINEA DESIGN BATTERY LINK HOUSING

APPROVALS | DATE

DRAWN EF | 5-19-2010

CHECKED

RESP ENG

APPLICATION | 1 | QUAL ENG

SCALE 1:2 | PART NO. 10013013 | SHEET 1 OF 6

# SECTION B-B

R.188

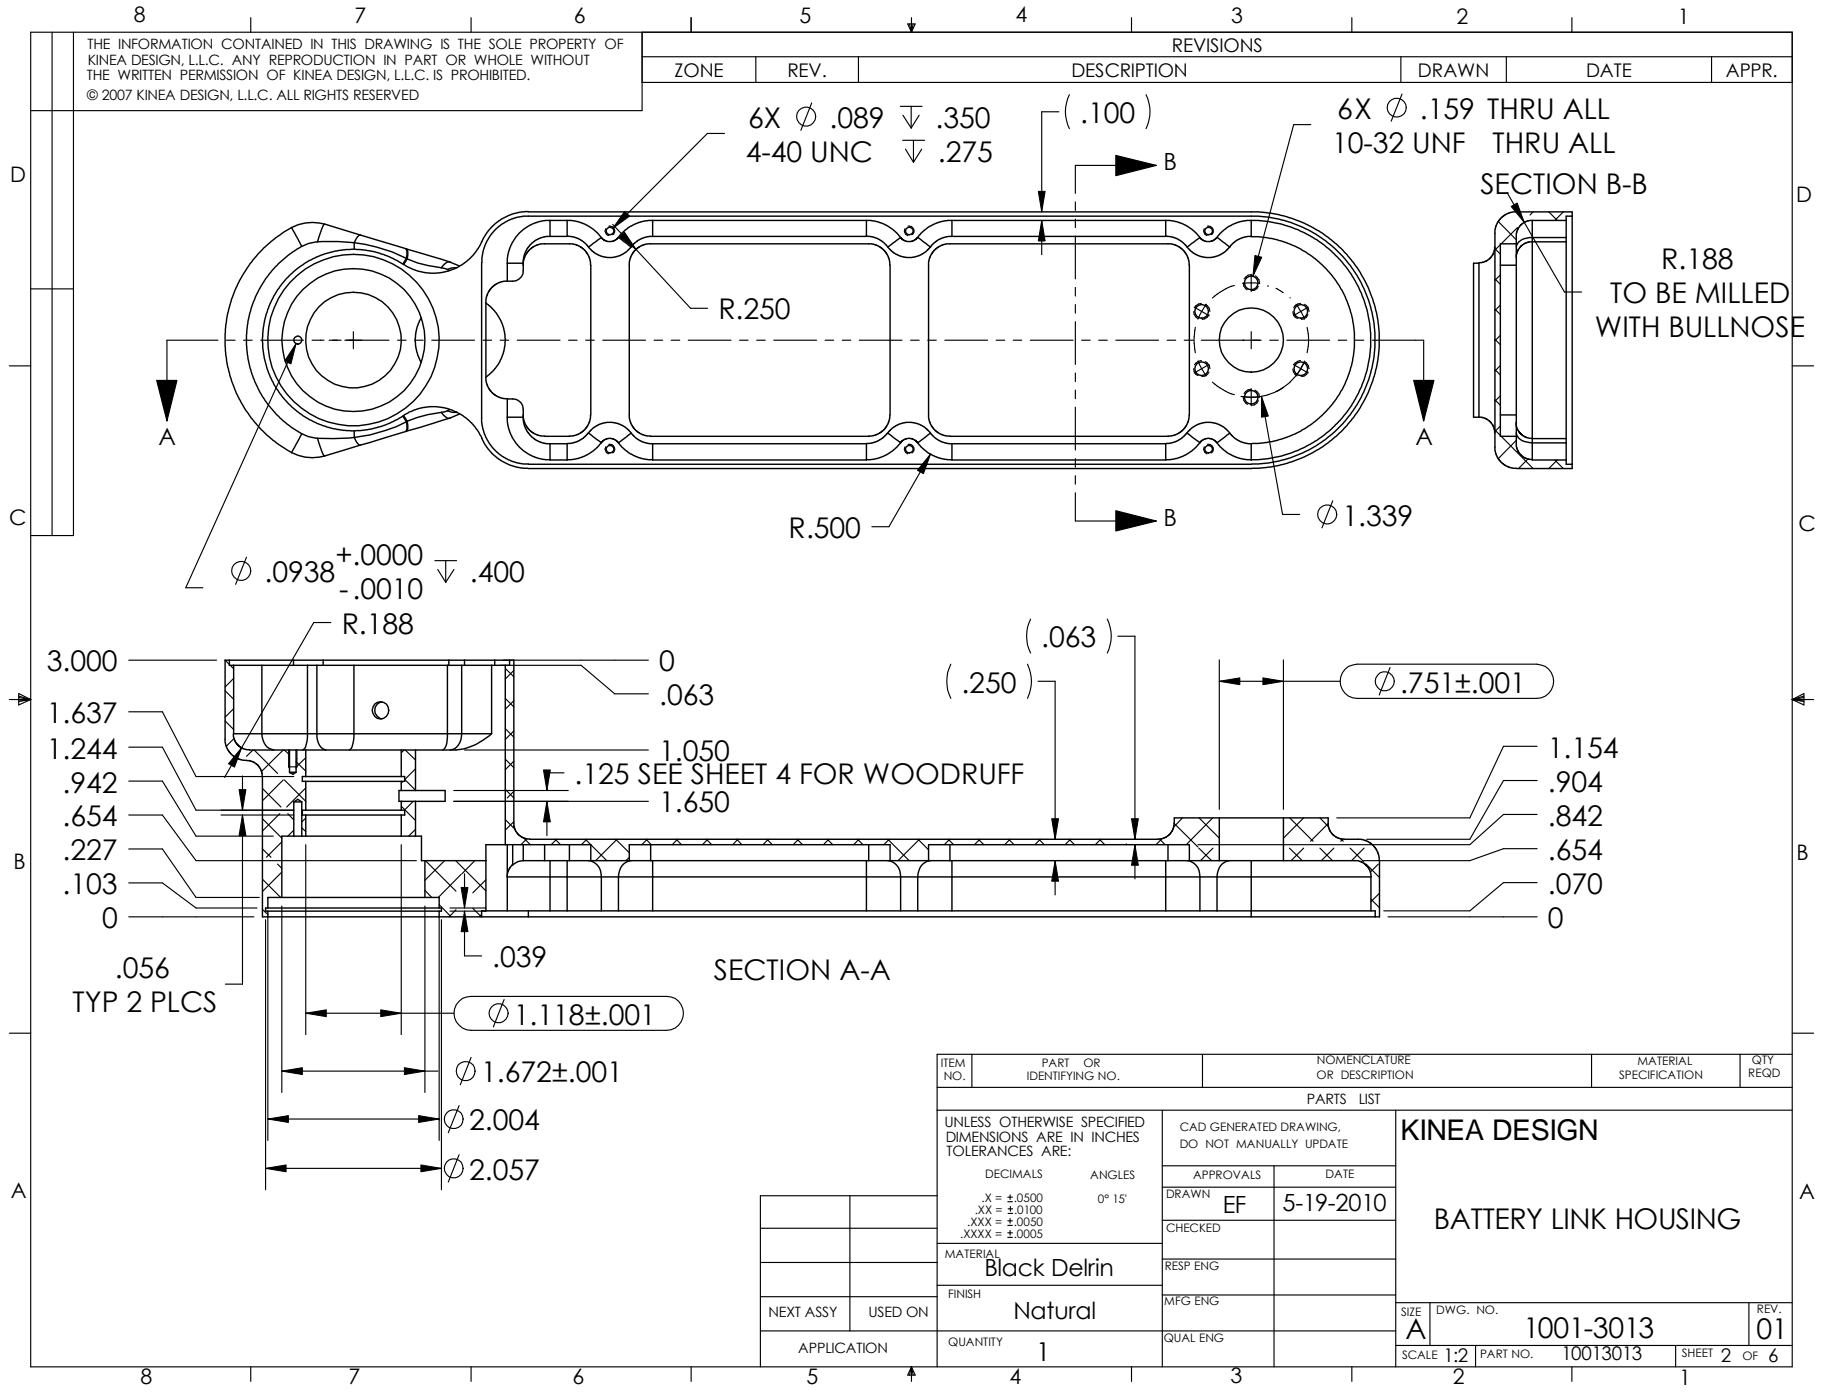
[picture p263: page 2]
MATERIAL; ITEM NO.; PART; IDENTIFYING NO.; NOMENCLATURE; OR DESCRIPTION; MATERIAL SPECIFICATION; QTY REQD; PARTS LIST; Black Delrin; .159 THRU ALL; 4-40 UNC; .056 TYP 2 PLCS

10-32 UNF THRU ALL

TO BE MILLED
WITH BULLNOSE

.125 SEE SHEET 4 FOR WOODRUFF

SECTION A-A

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

APPROVALS | DATE

DRAWN EF | 5-19-2010

CHECKED

RESP ENG

1.275

D

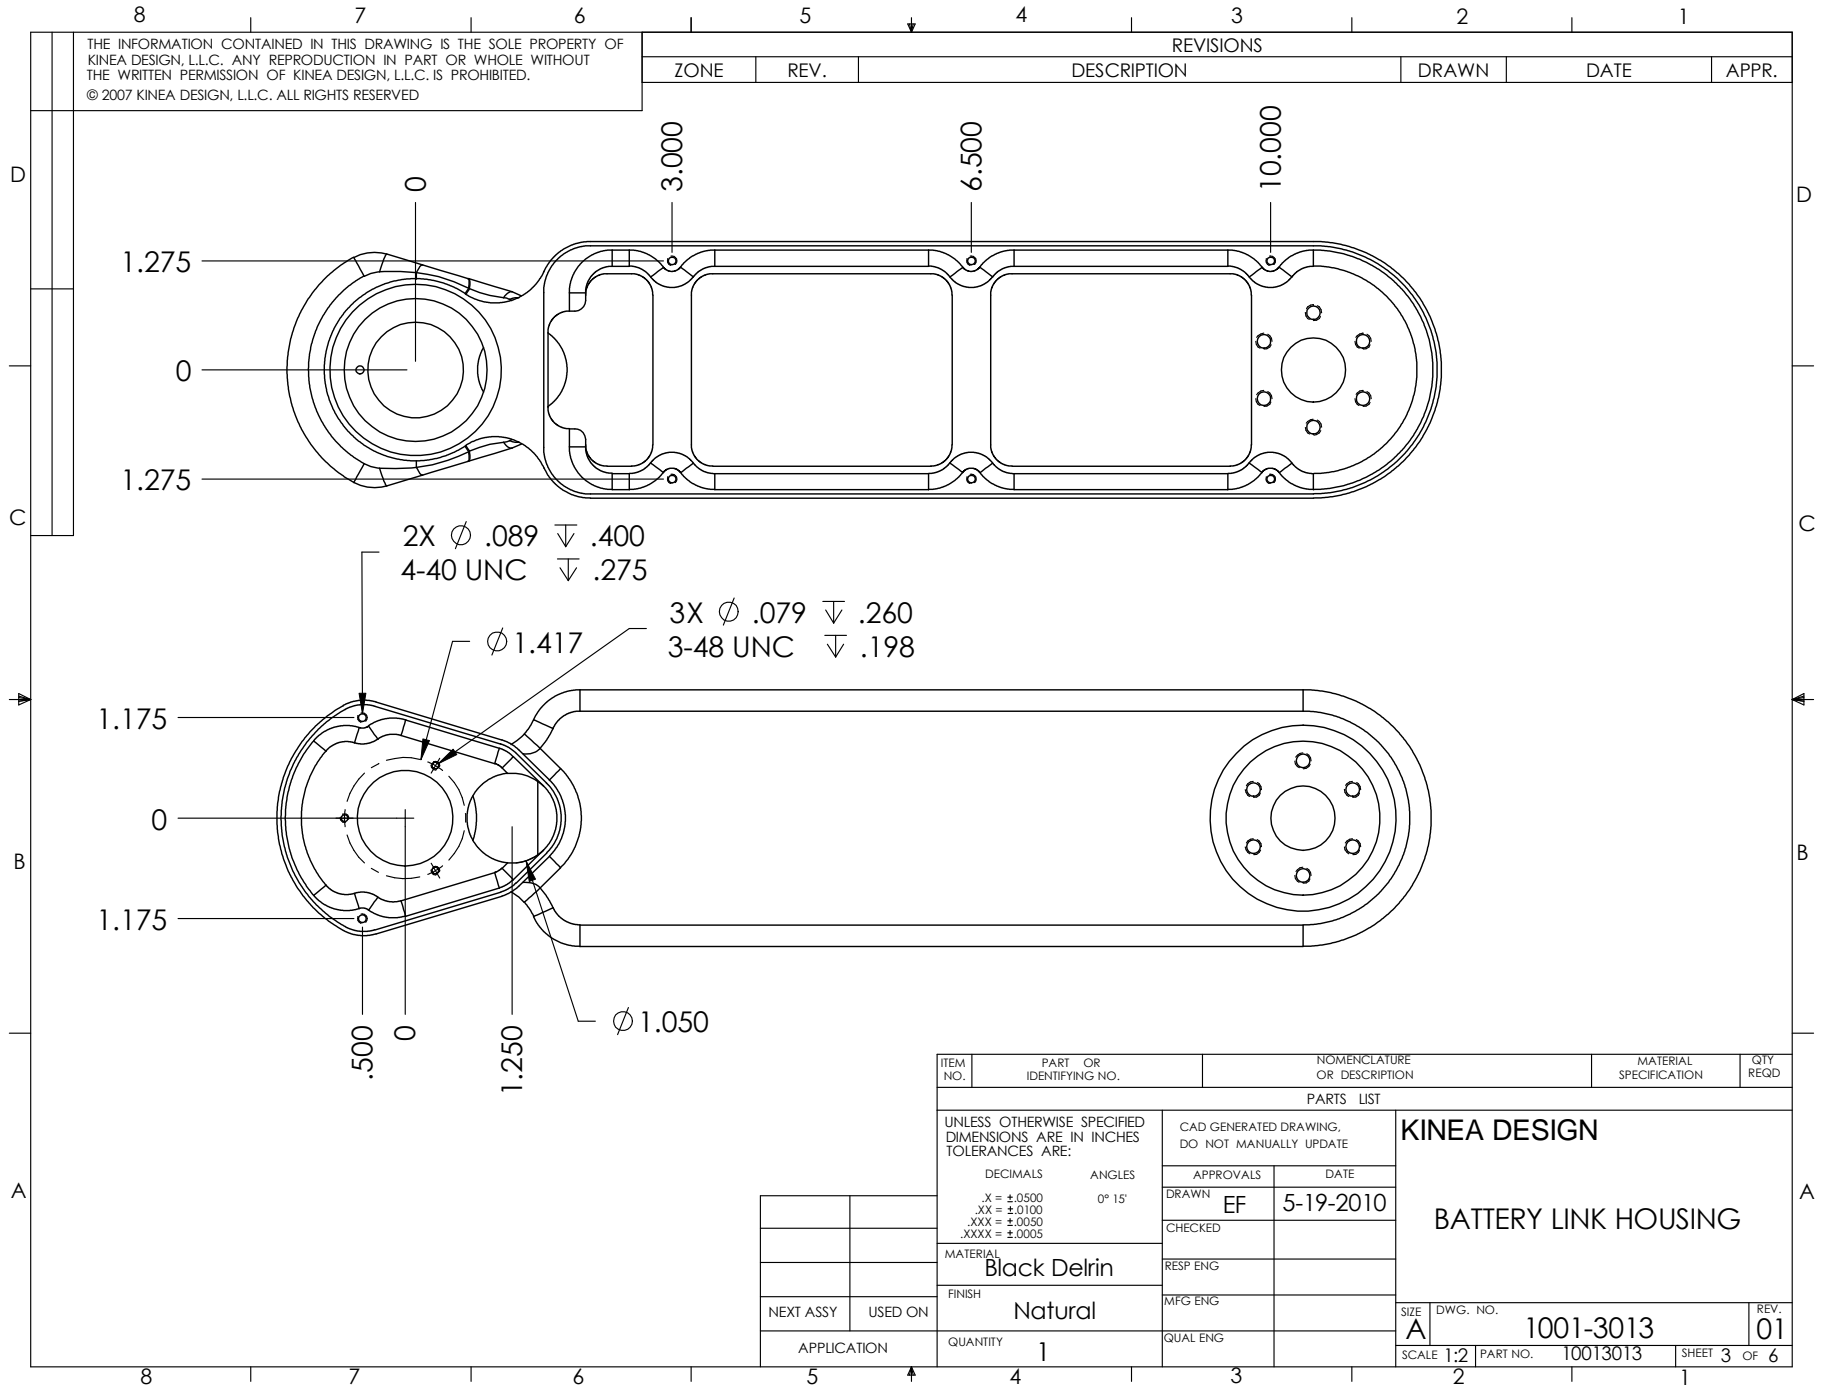
[picture p264: page 3]
MATERIAL; ITEM NO.; PART; IDENTIFYING NO.; NOMENCLATURE; OR DESCRIPTION; MATERIAL SPECIFICATION; QTY REQD; PARTS LIST; Black Delrin; 3-48 UNC; 4-40 UNC

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

APPROVALS | DATE

DRAWN EF | 5-19-2010

CHECKED

RESP ENG

D
D

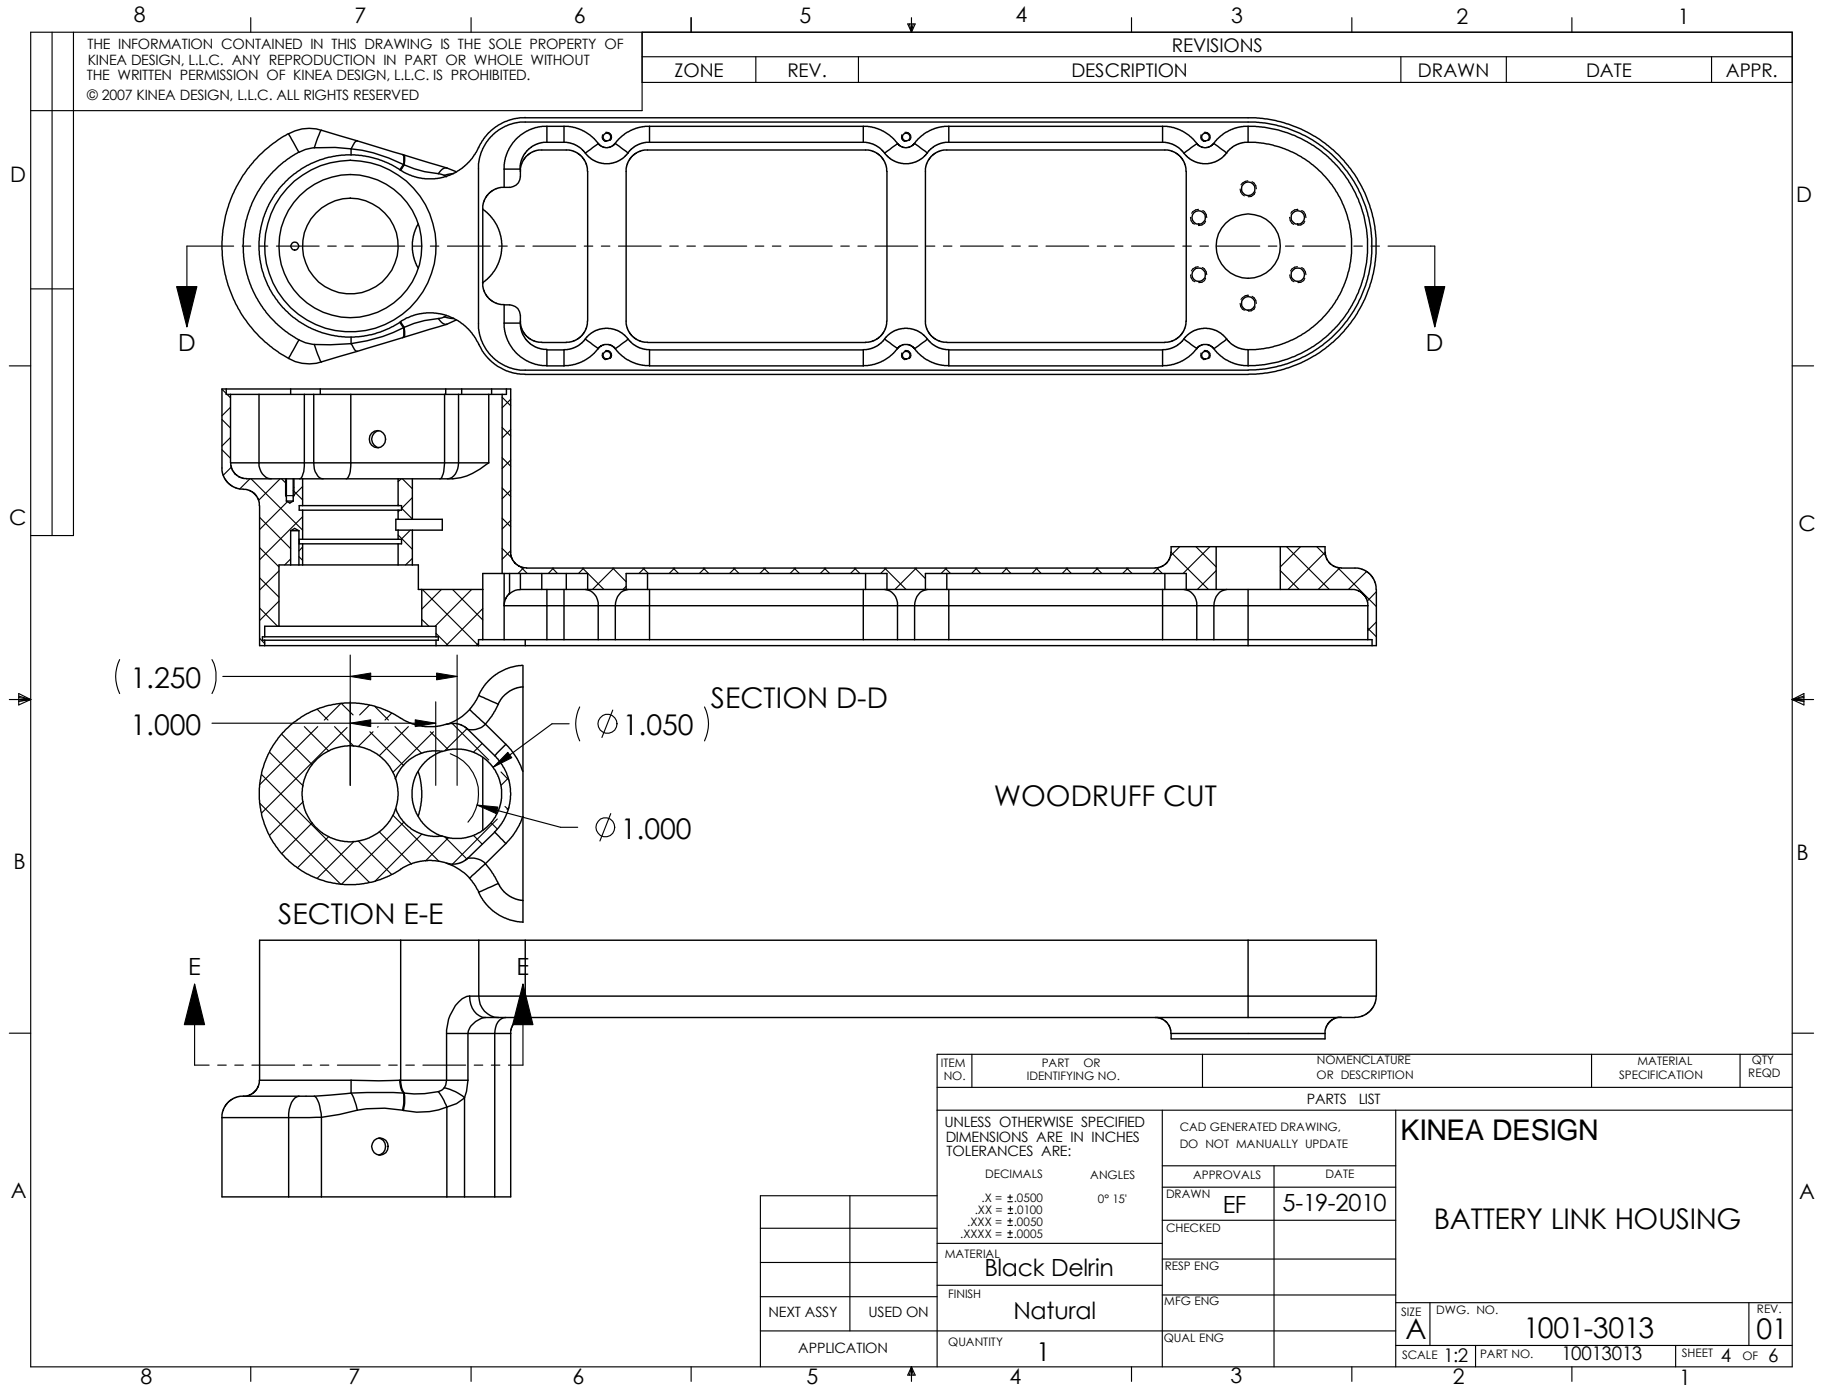
[picture p265: page 4]
SECTION E-E; 1.250 SECTION D-D; WOODRUFF CUT; MATERIAL; ITEM NO.; PART; IDENTIFYING NO.; NOMENCLATURE; OR DESCRIPTION; MATERIAL SPECIFICATION; QTY REQD; PARTS LIST; Black Delrin

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

APPROVALS | DATE

DRAWN EF | 5-19-2010

CHECKED

RESP ENG

# .588 TYP

.714

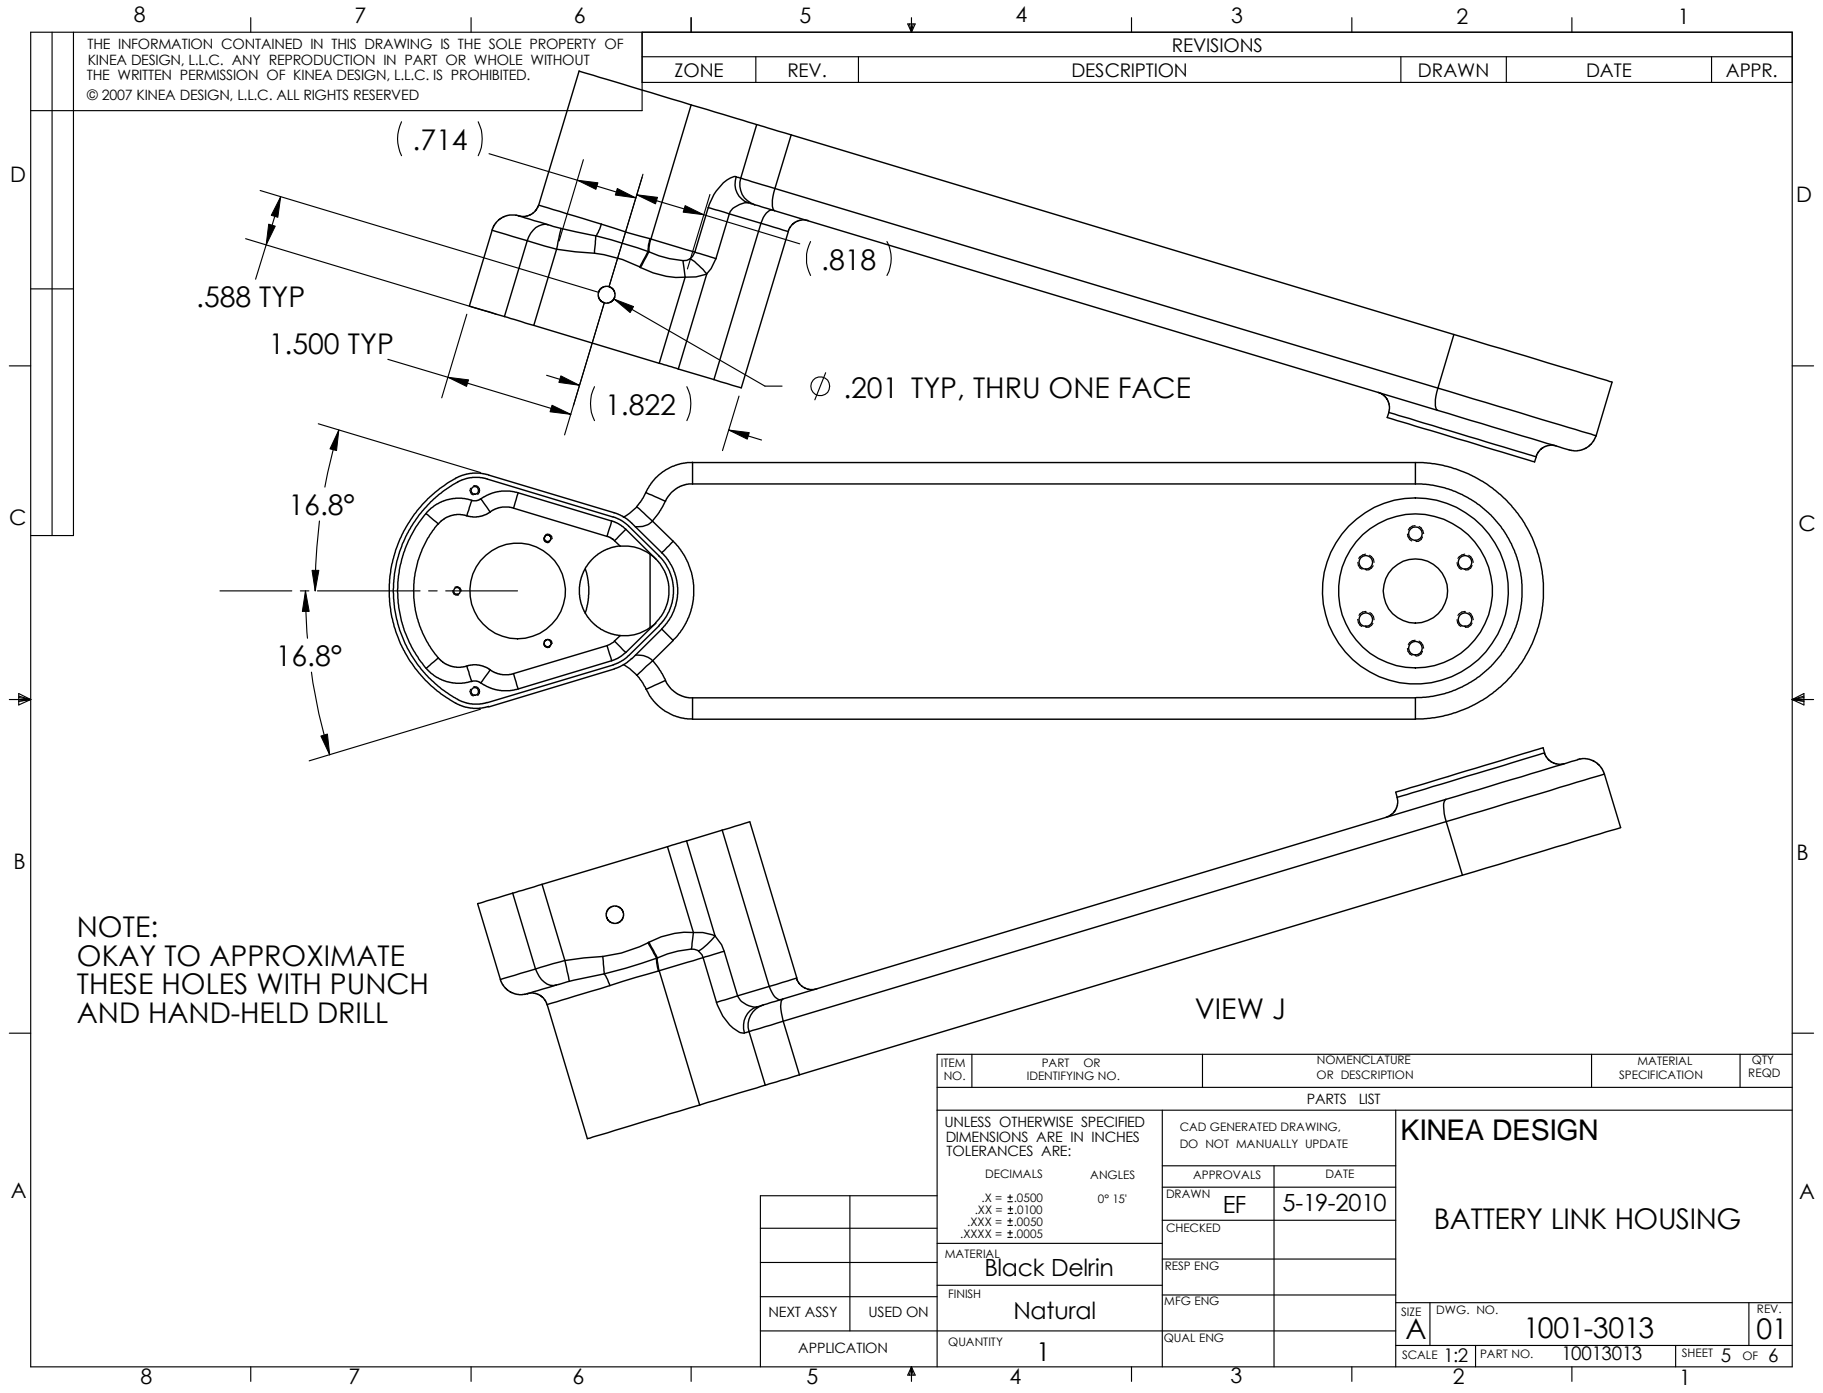
[picture p266: page 5]
1.500 TYP; MATERIAL; ITEM NO.; PART; IDENTIFYING NO.; NOMENCLATURE; OR DESCRIPTION; MATERIAL SPECIFICATION; QTY REQD; PARTS LIST; Black Delrin; VIEW J

.201 TYP, THRU ONE FACE

NOTE:
OKAY TO APPROXIMATE
THESE HOLES WITH PUNCH
AND HAND-HELD DRILL

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

APPROVALS | DATE

DRAWN EF | 5-19-2010

CHECKED

RESP ENG
