NxRLab/gibbot/PCB/Gibbot v1/Schematic Rev2_power.pdf

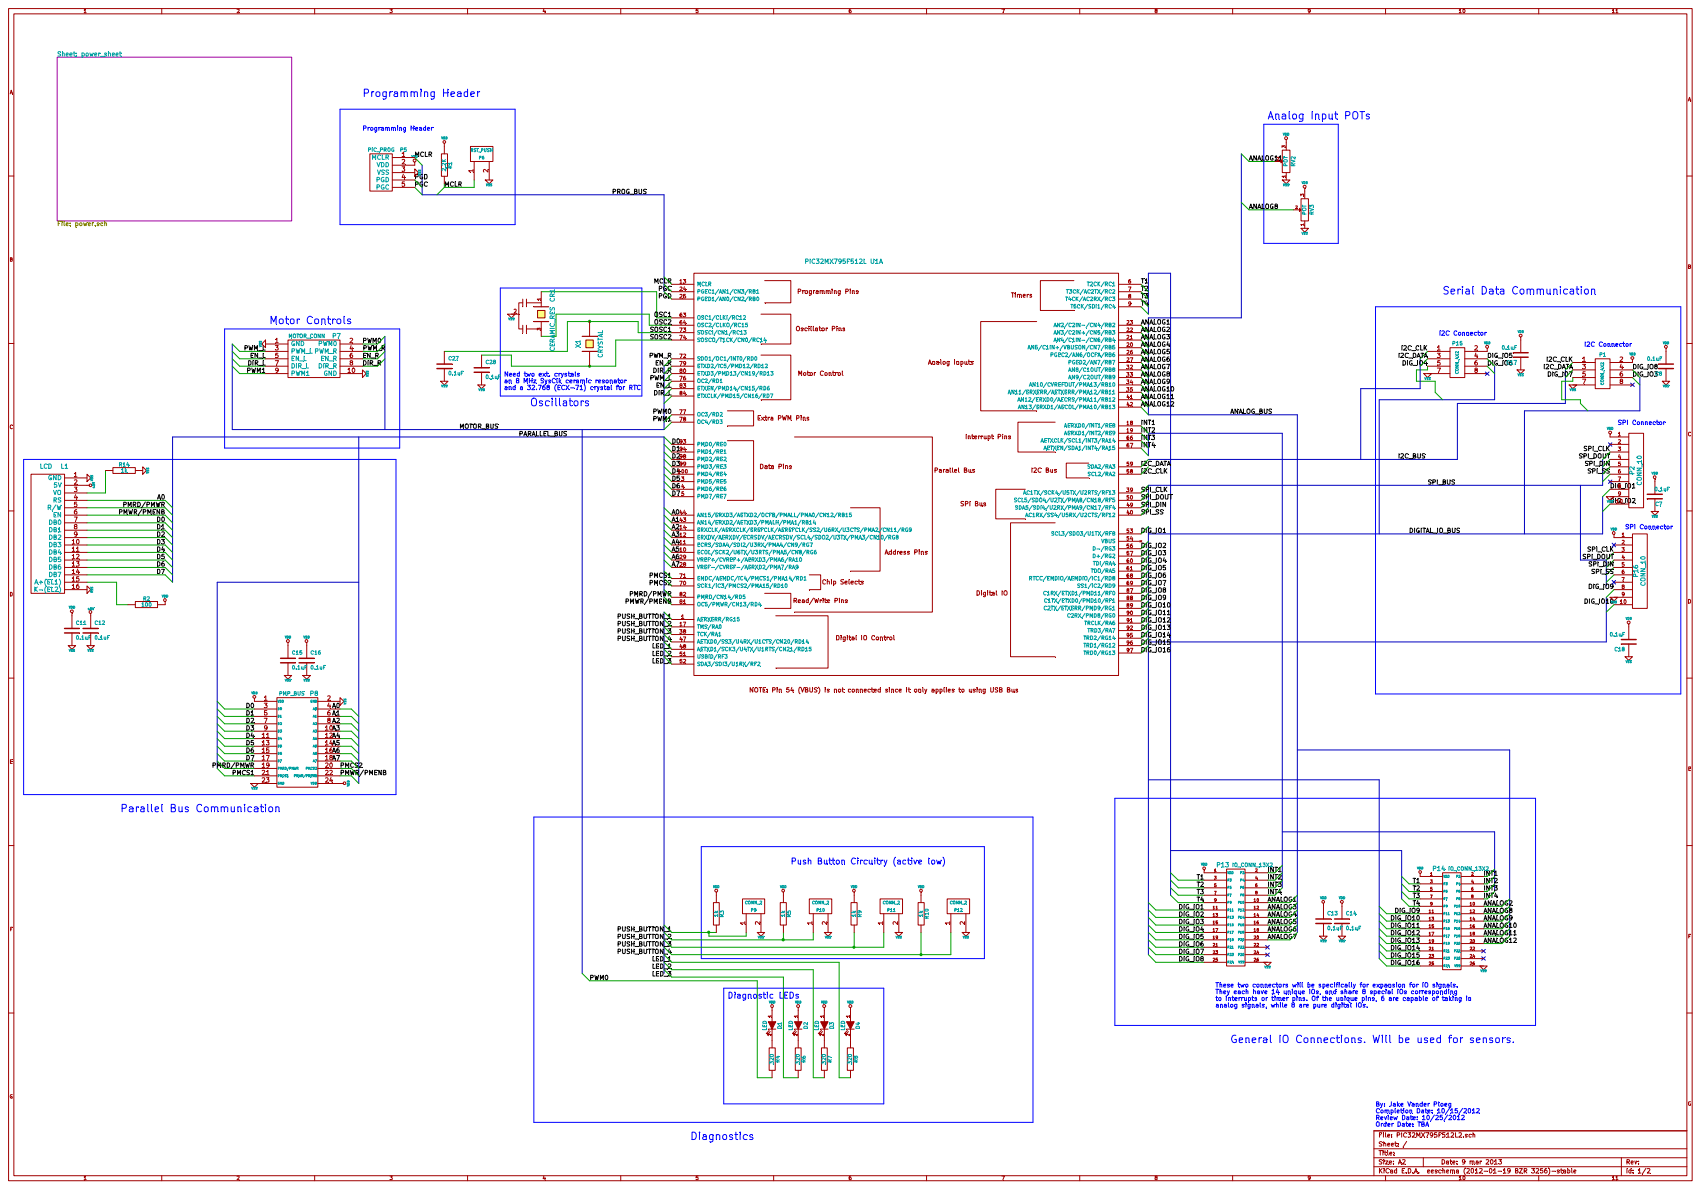
[picture p267: page 1]

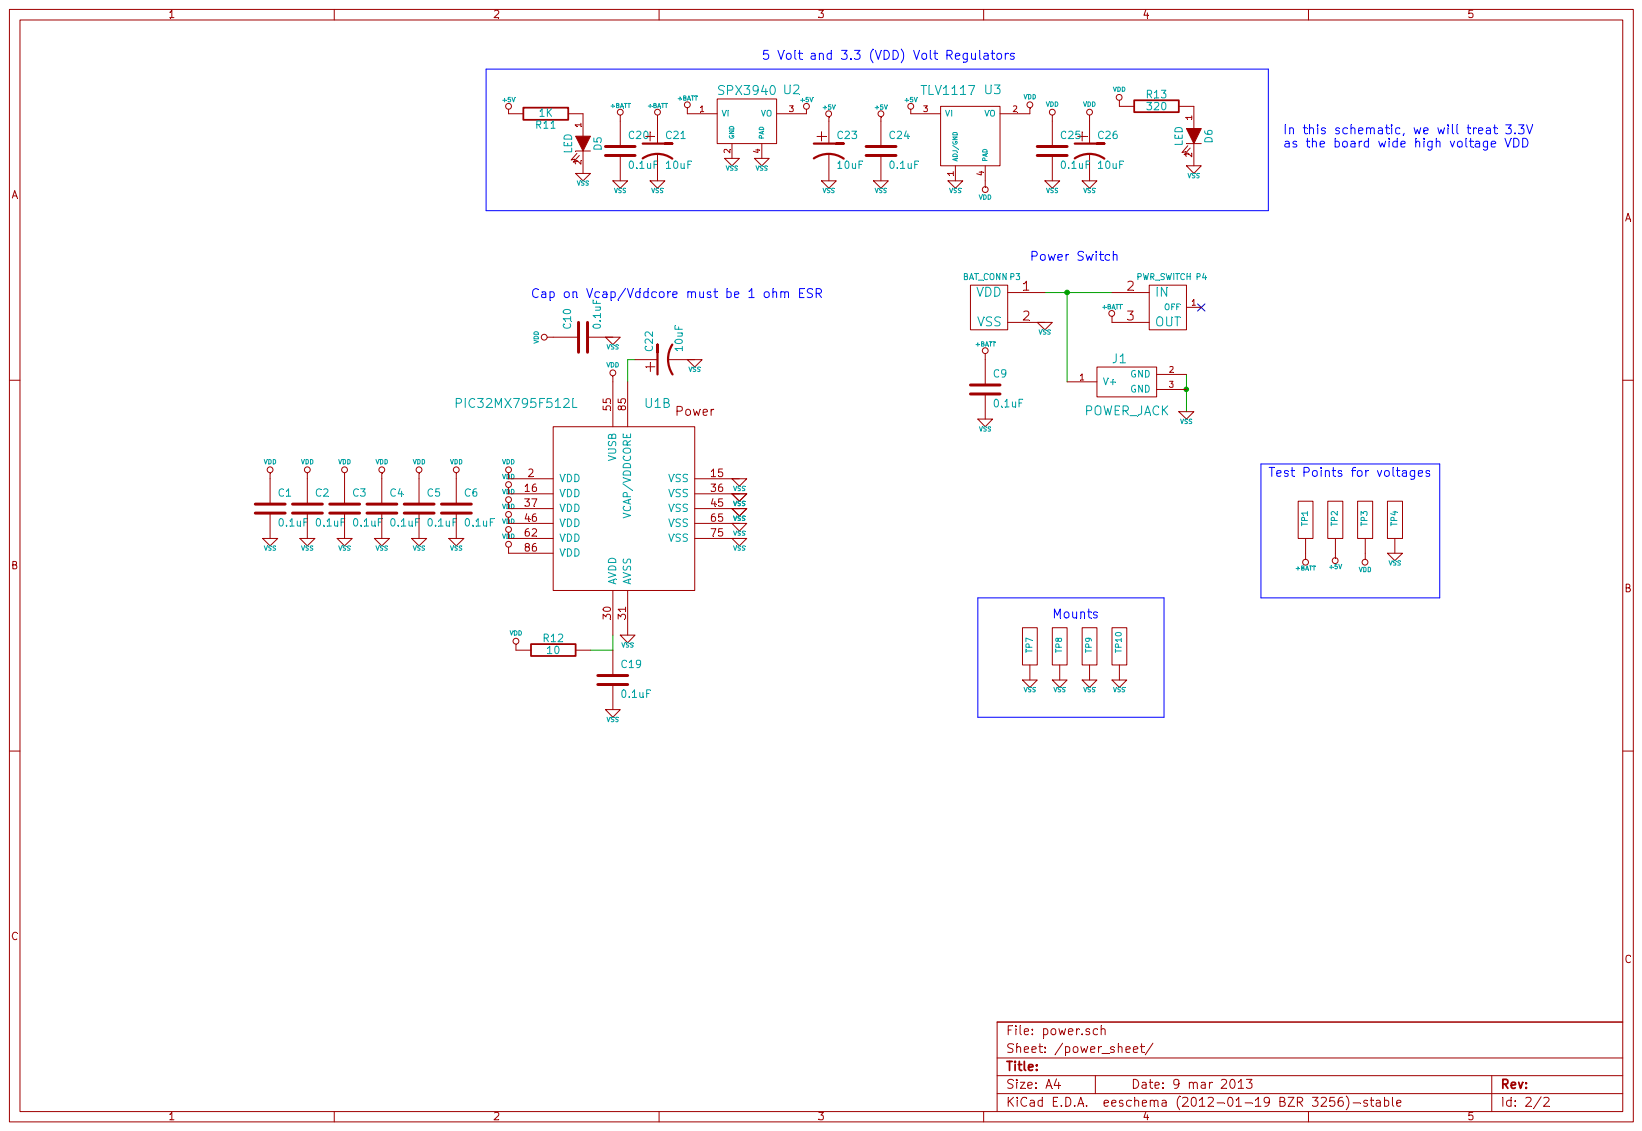
[picture p268: page 2]
