NxRLab/gibbot/Old Monkeybot - 2011/Monkeybot Eagle CAD/monkeybot_schematic.pdf

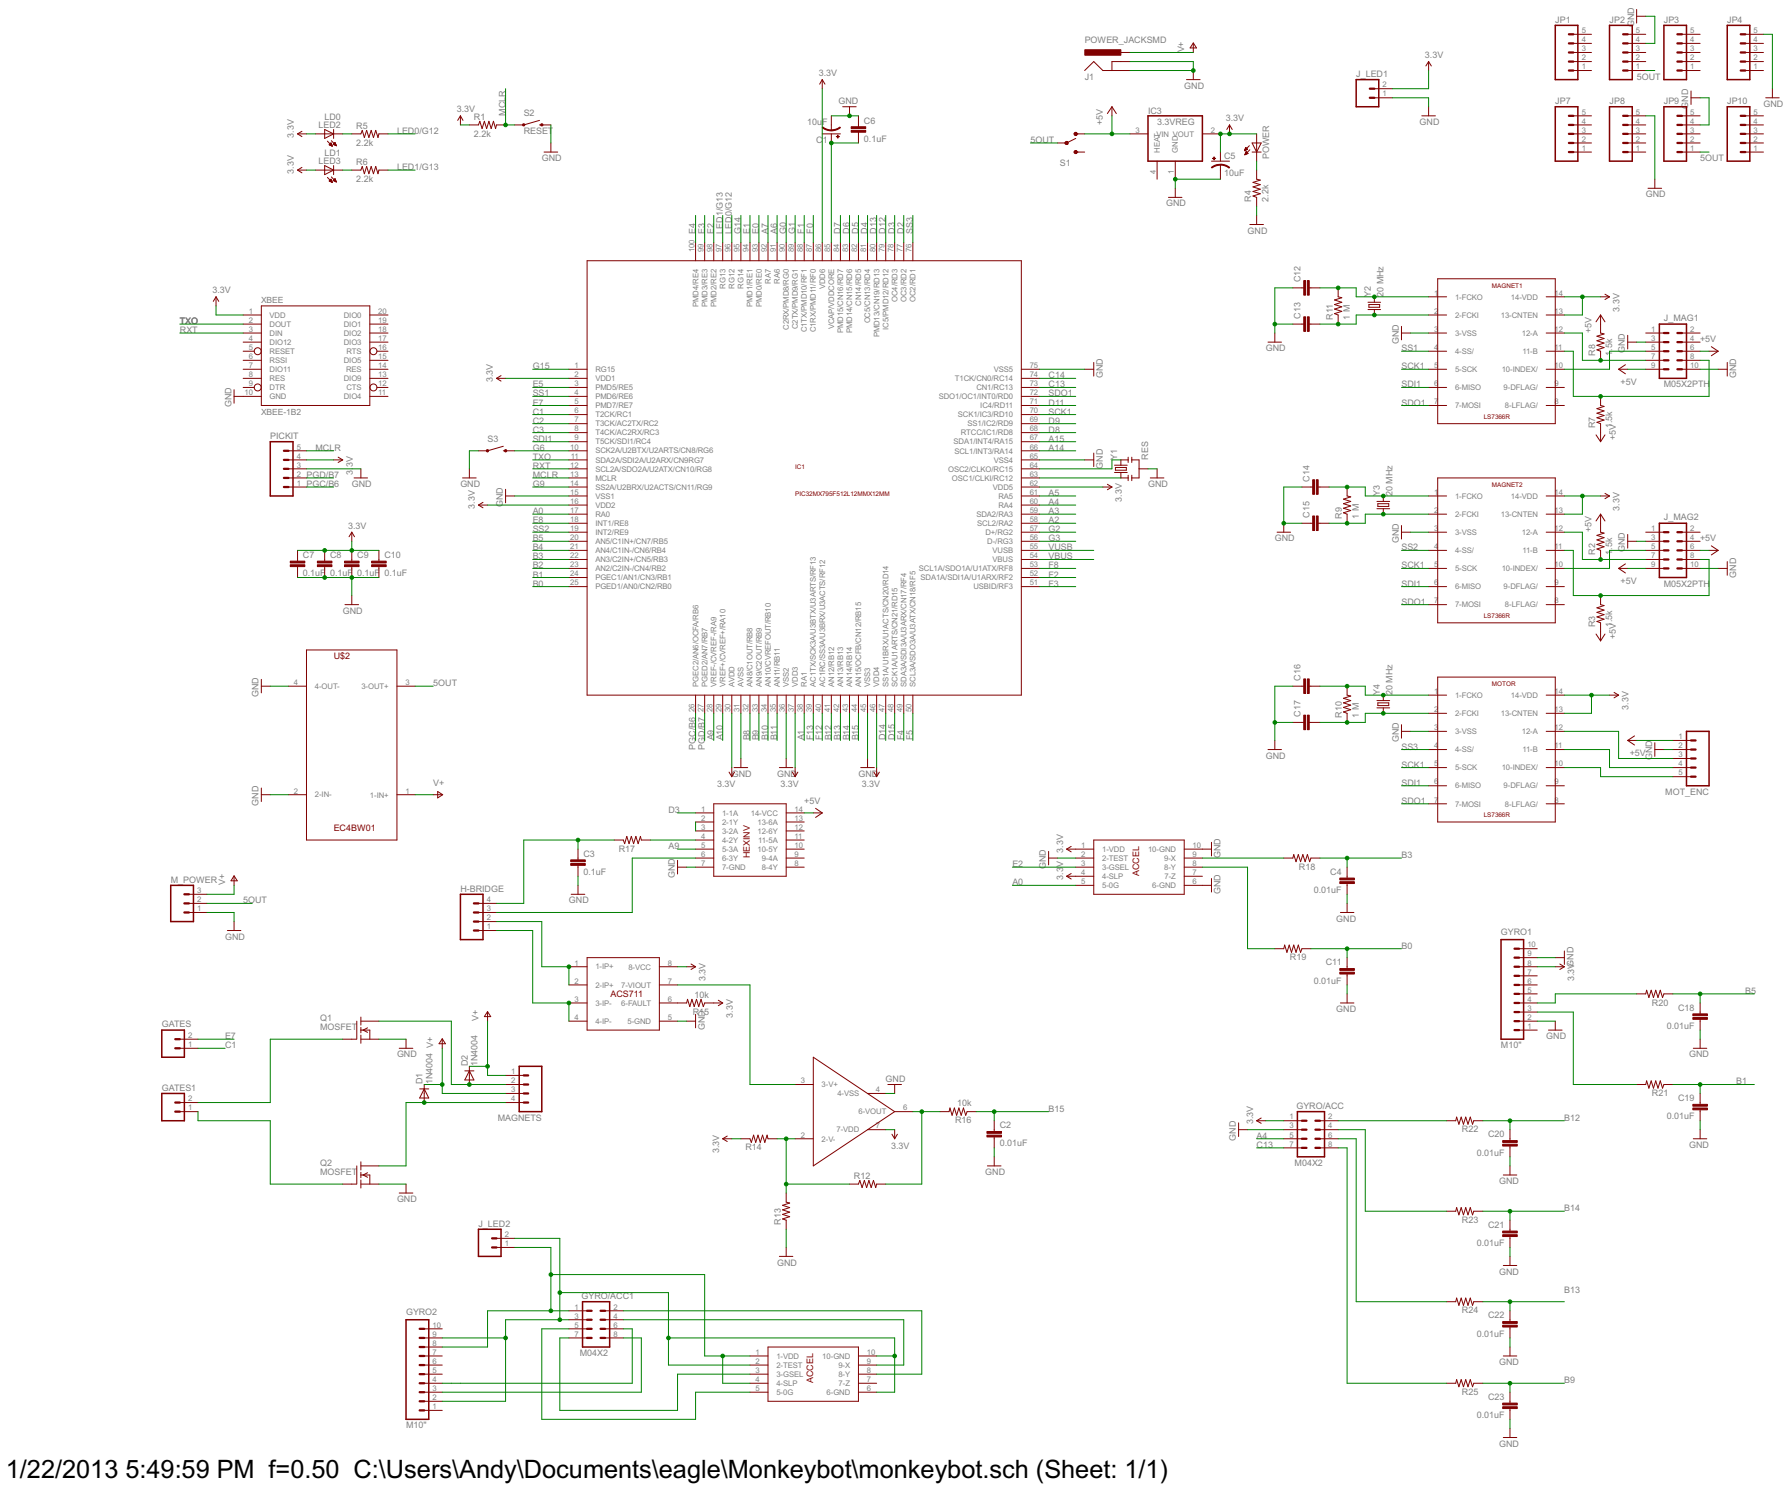
[picture p269: page 1]

1/22/2013 5:49:59 PM f=0.50 C:\Users\Andy\Documents\eagle\Monkeybot\monkeybot.sch (Sheet: 1/1)
