NxRLab/gibbot/PCB/Gibbot v4/Control copy.pdf

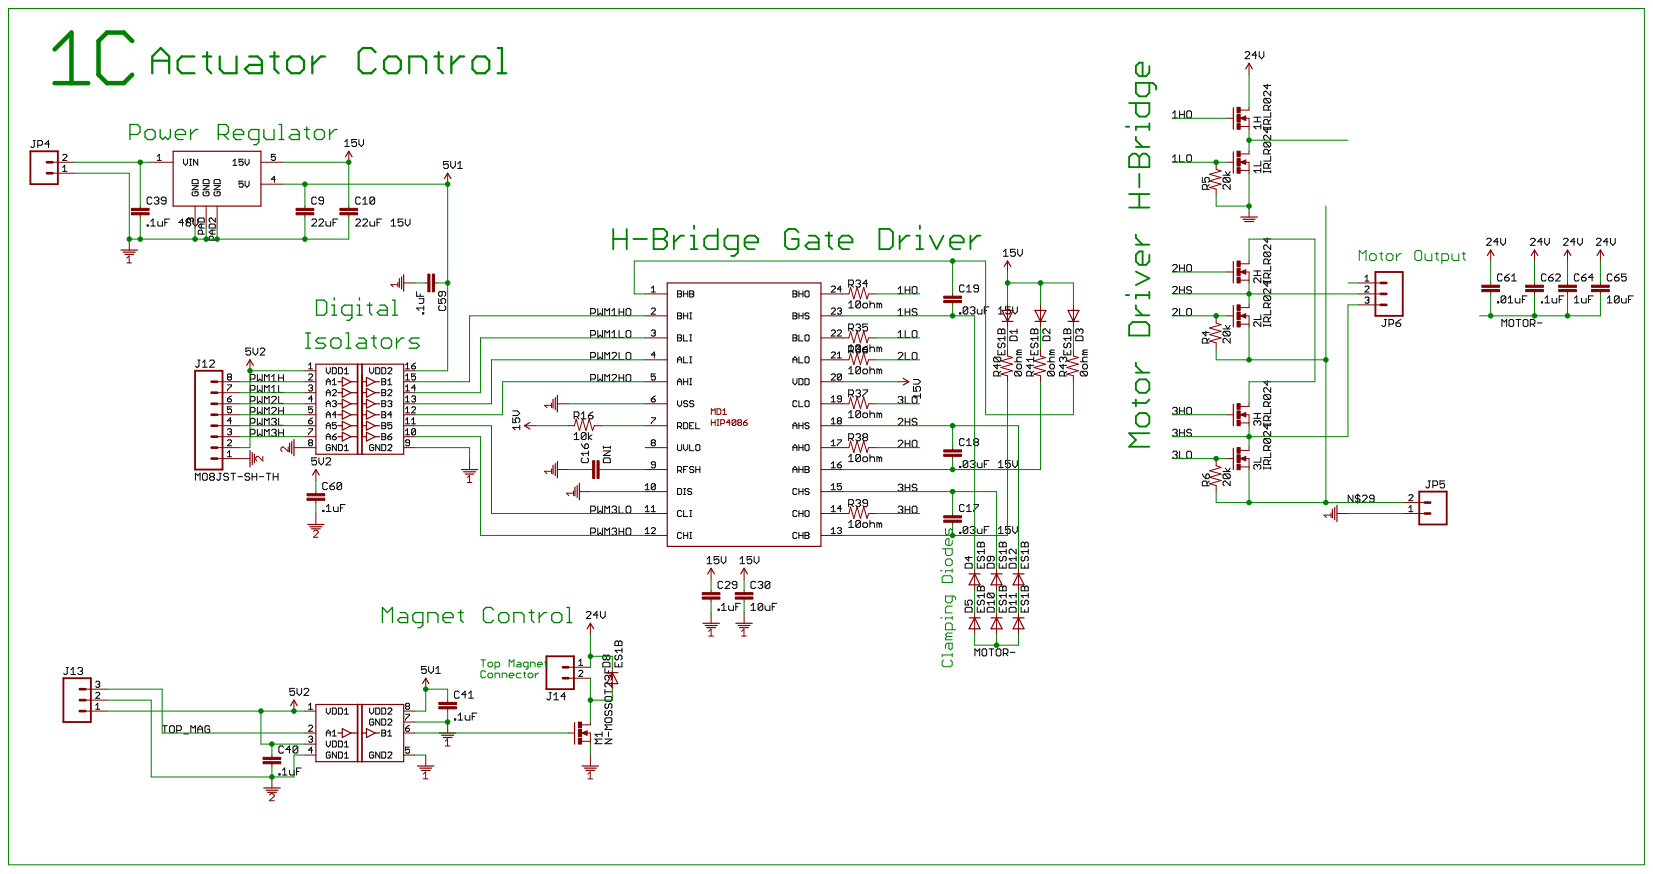
[picture p270: page 1]
