NxRLab/gibbot/PCB/Gibbot v1/BatteryManager.pdf

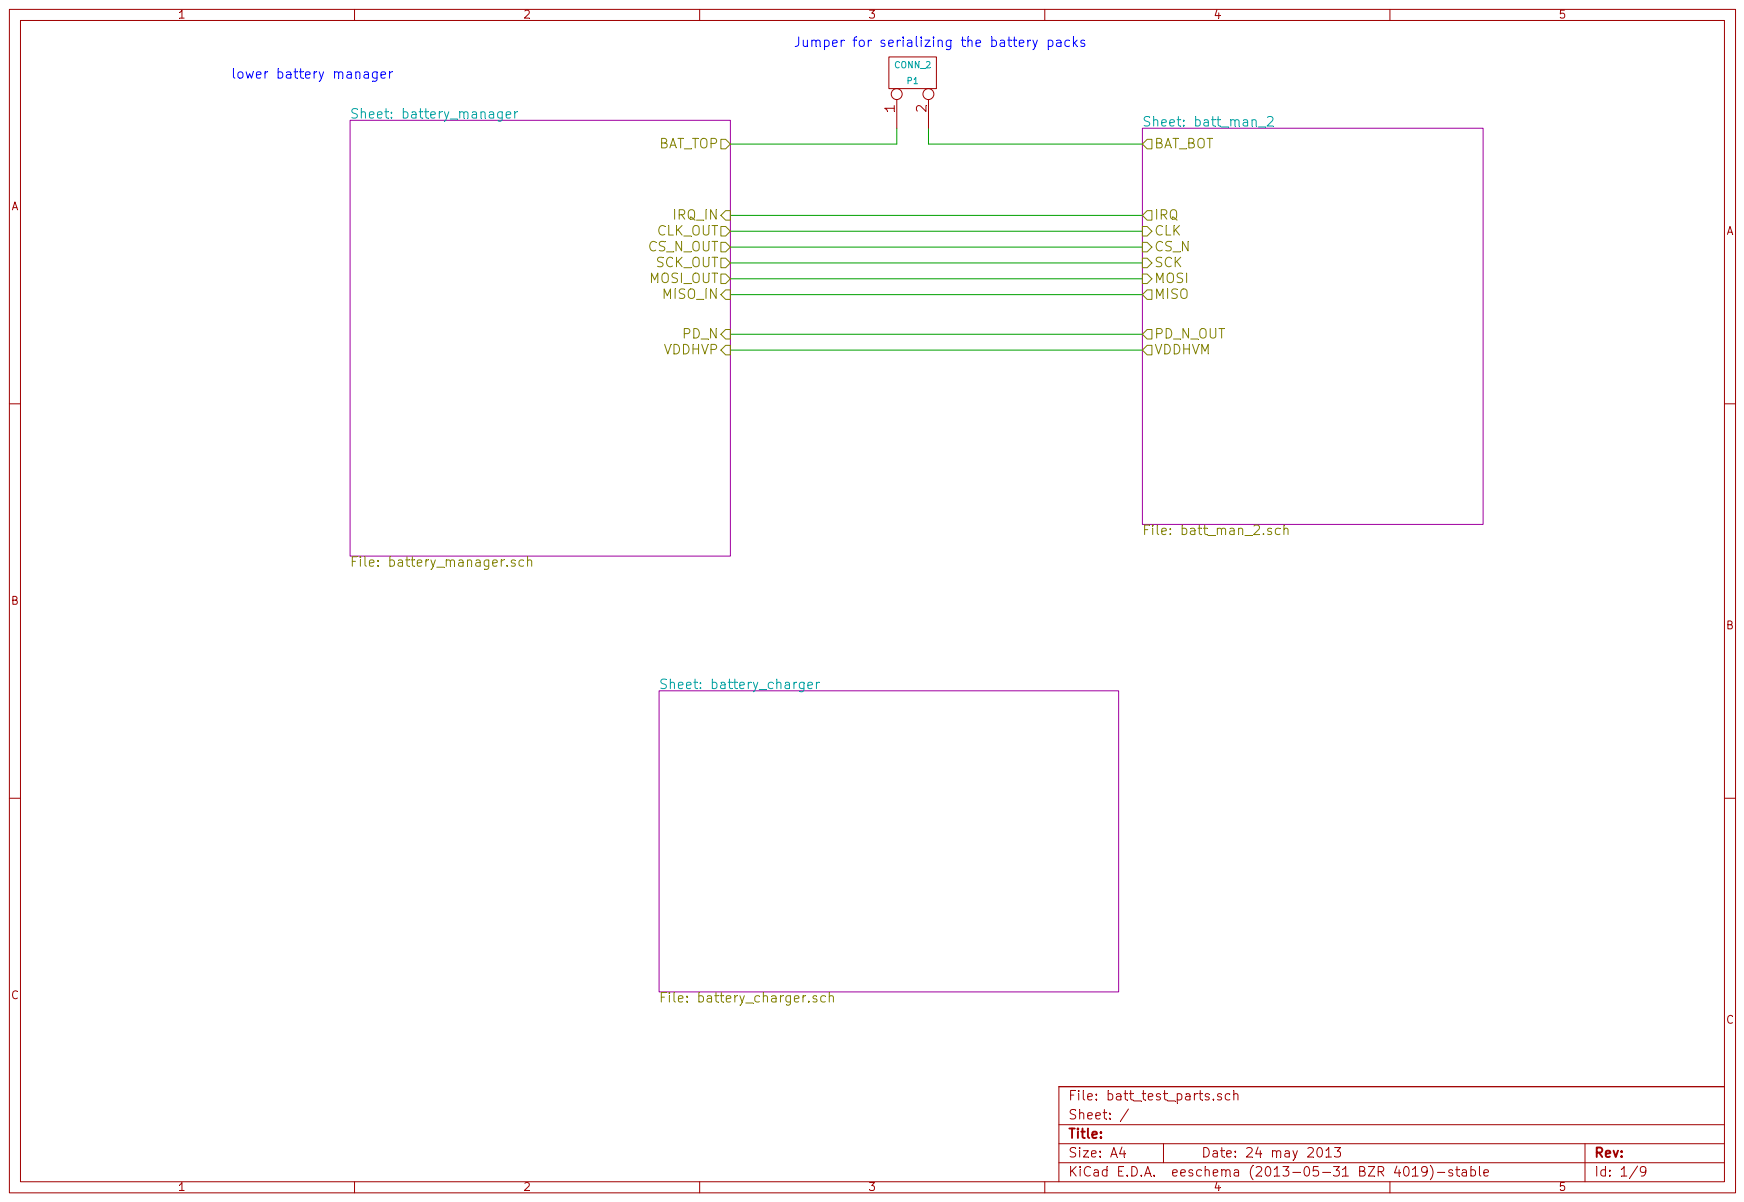
[picture p271: page 1]

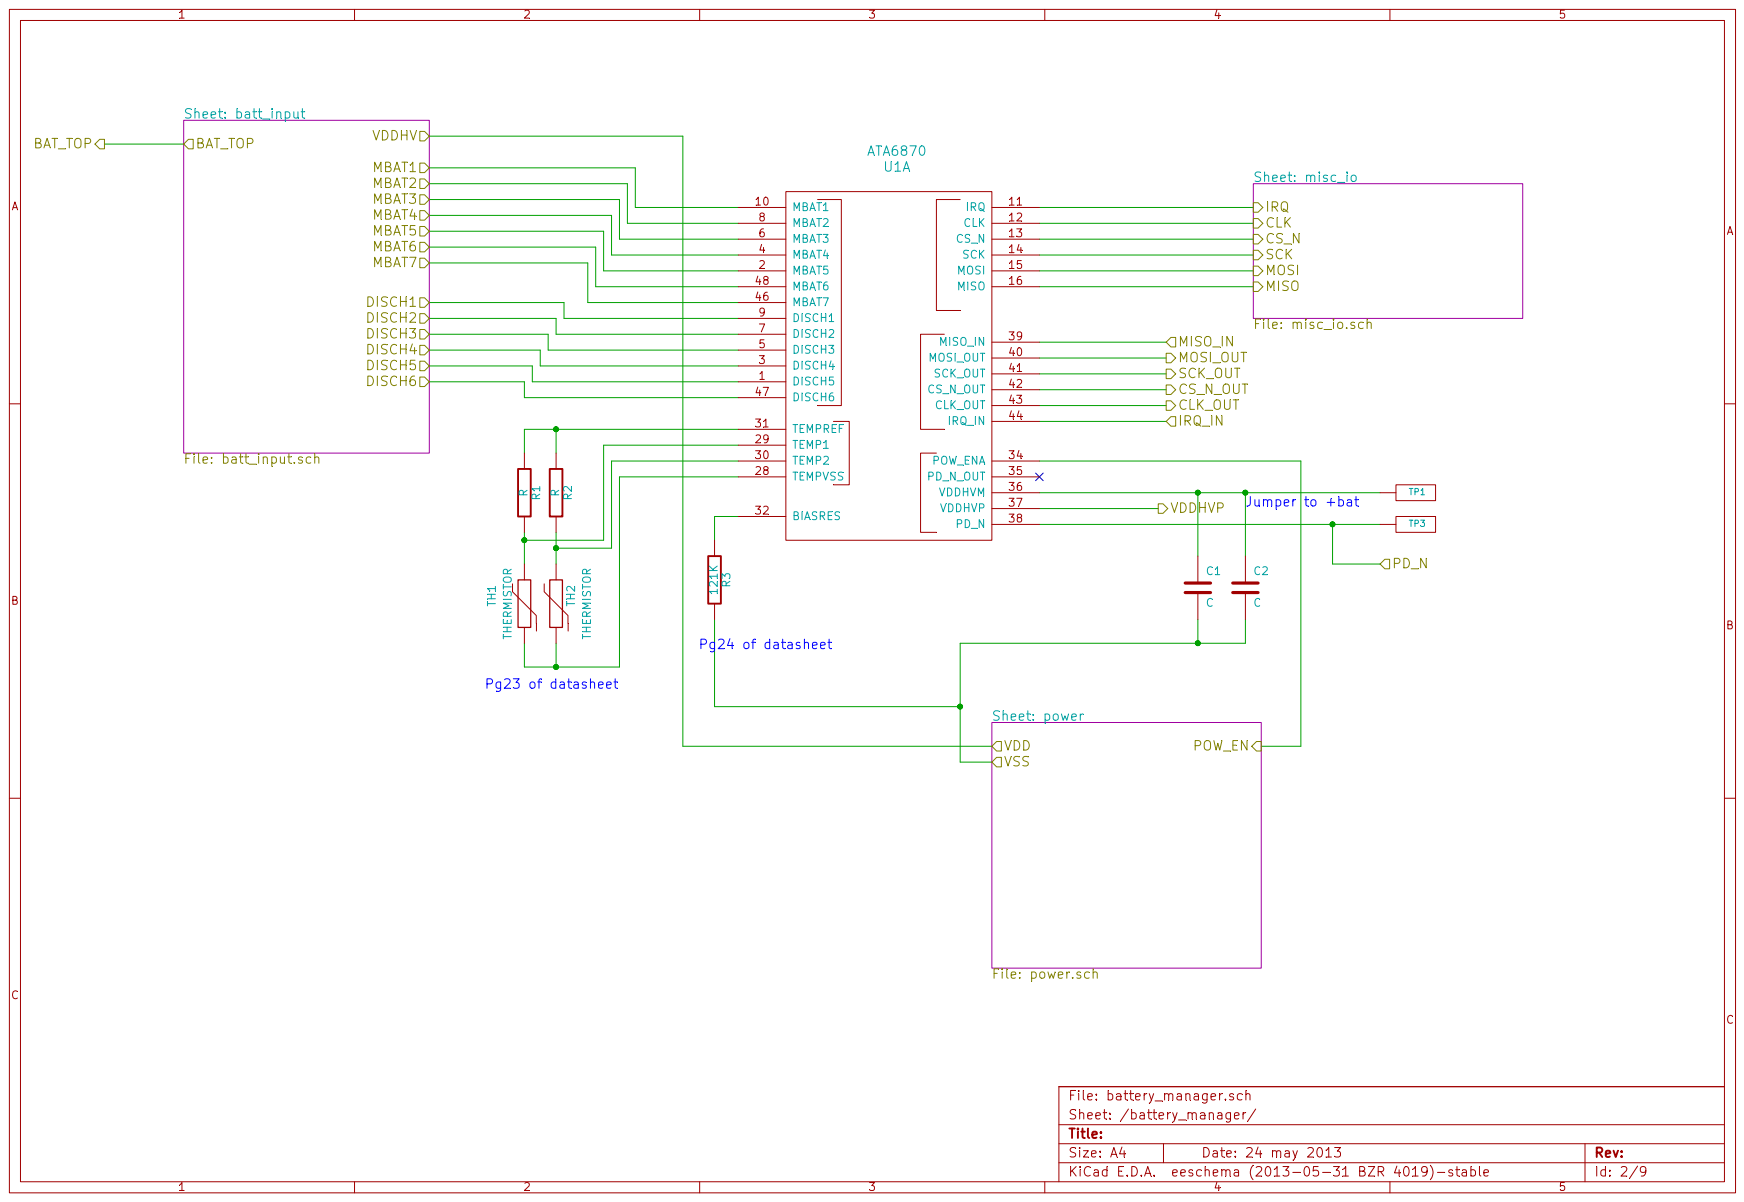
[picture p272: page 2]

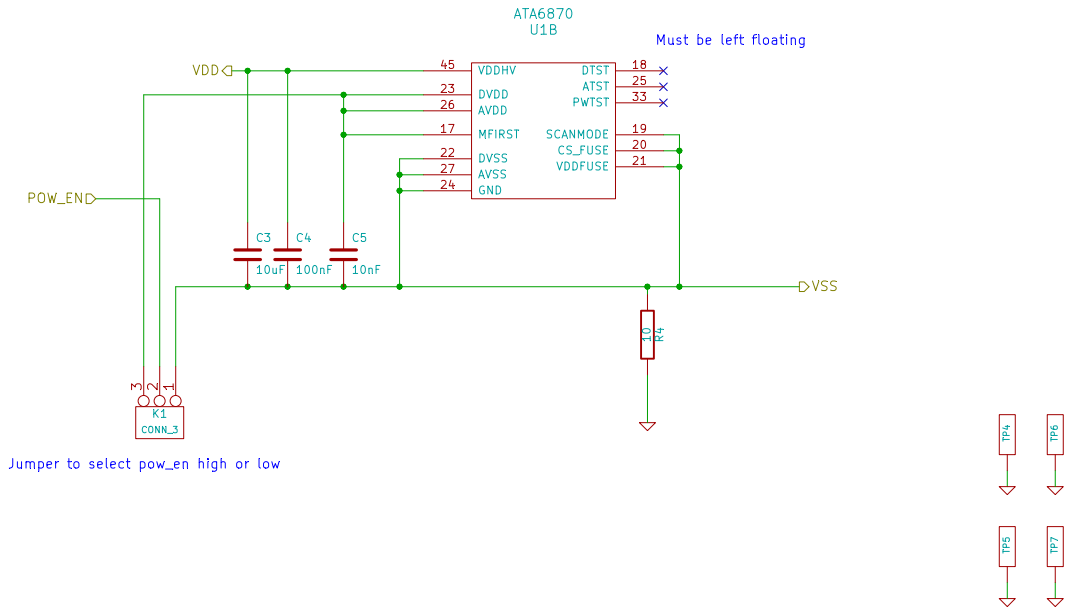
[picture p273: page 3]

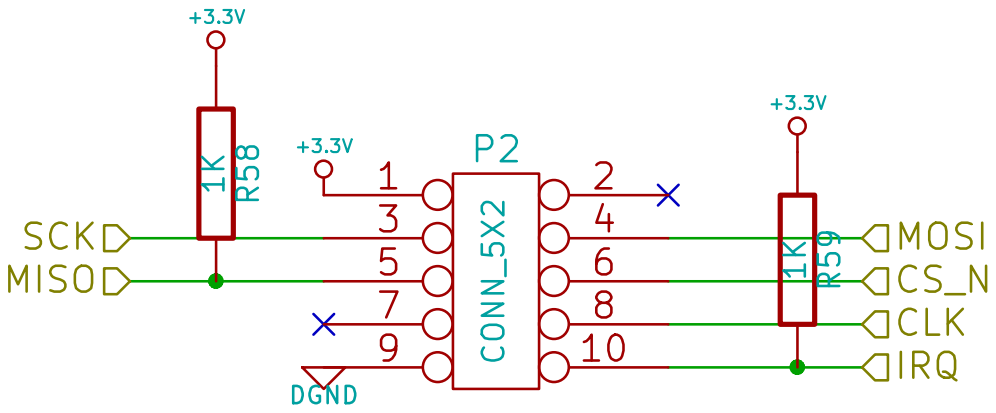
[picture p274: page 4]

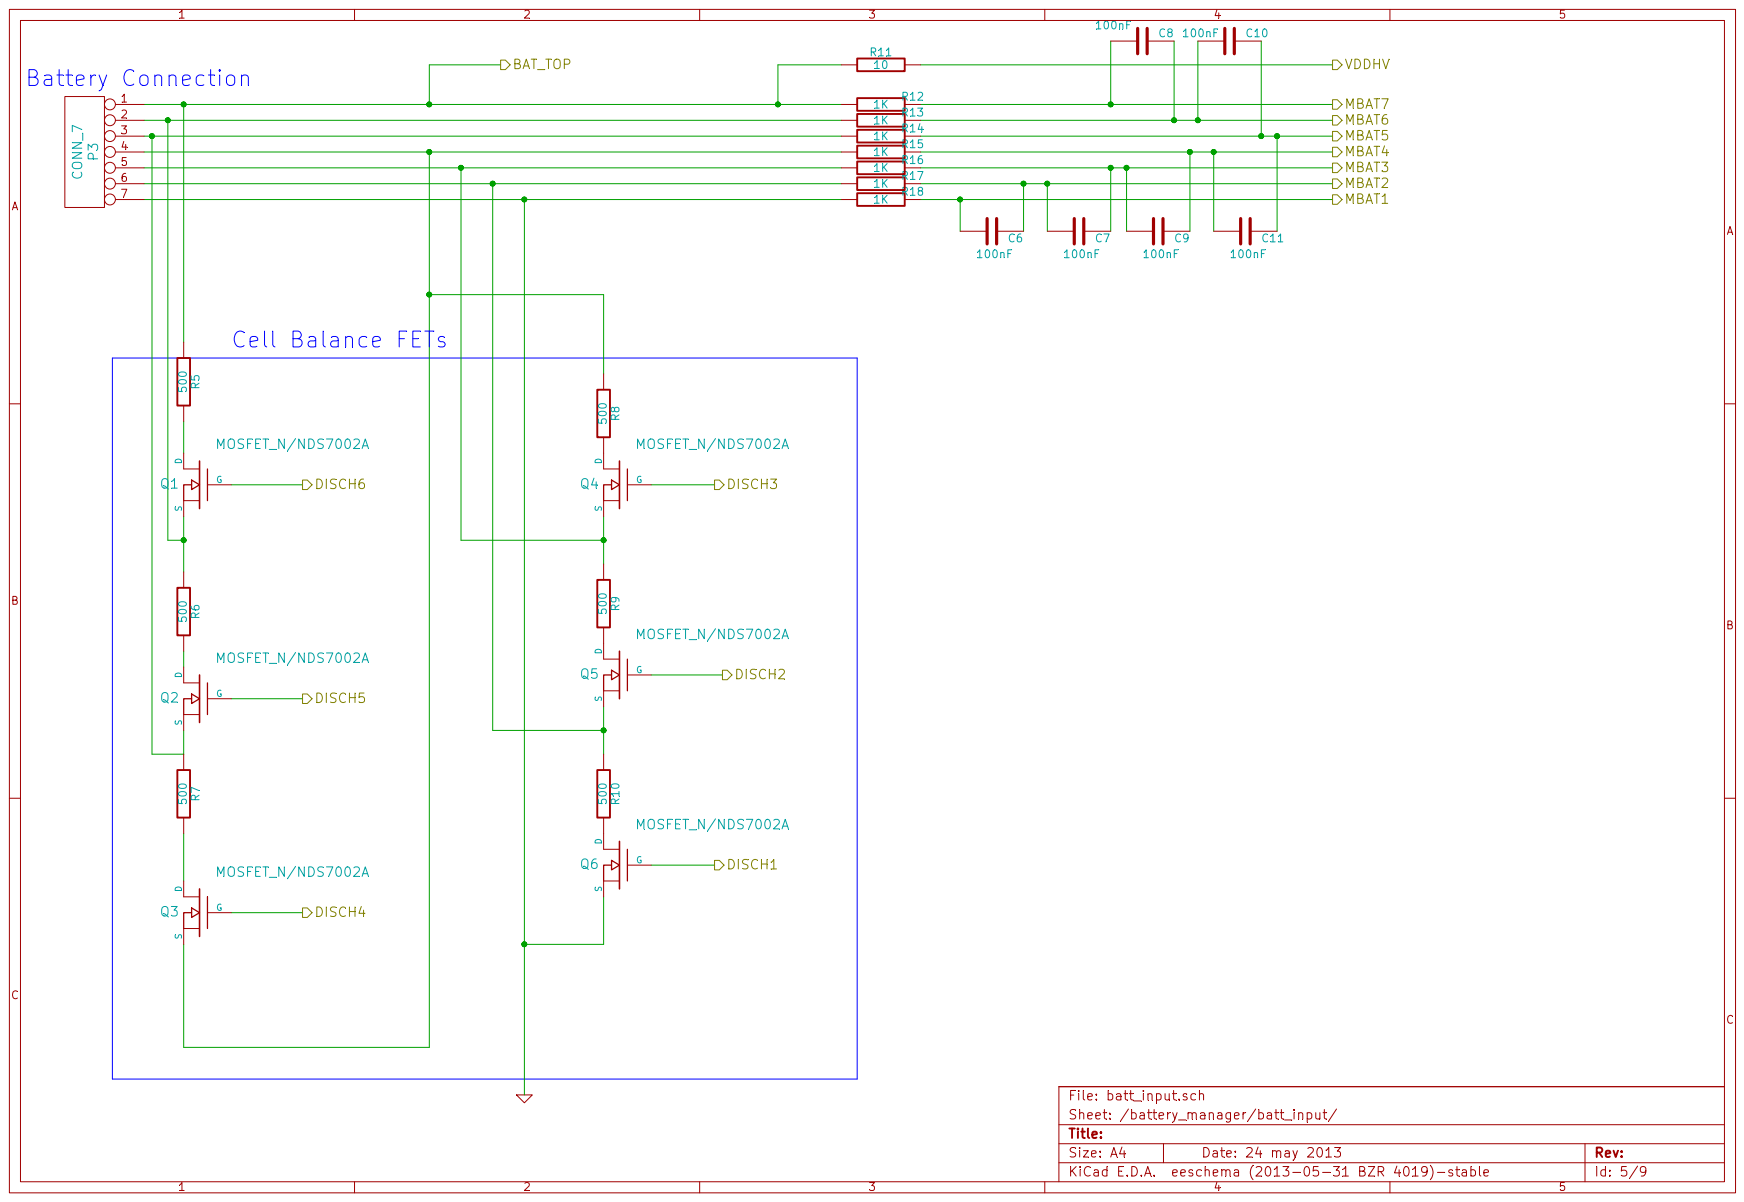
[picture p275: page 5]

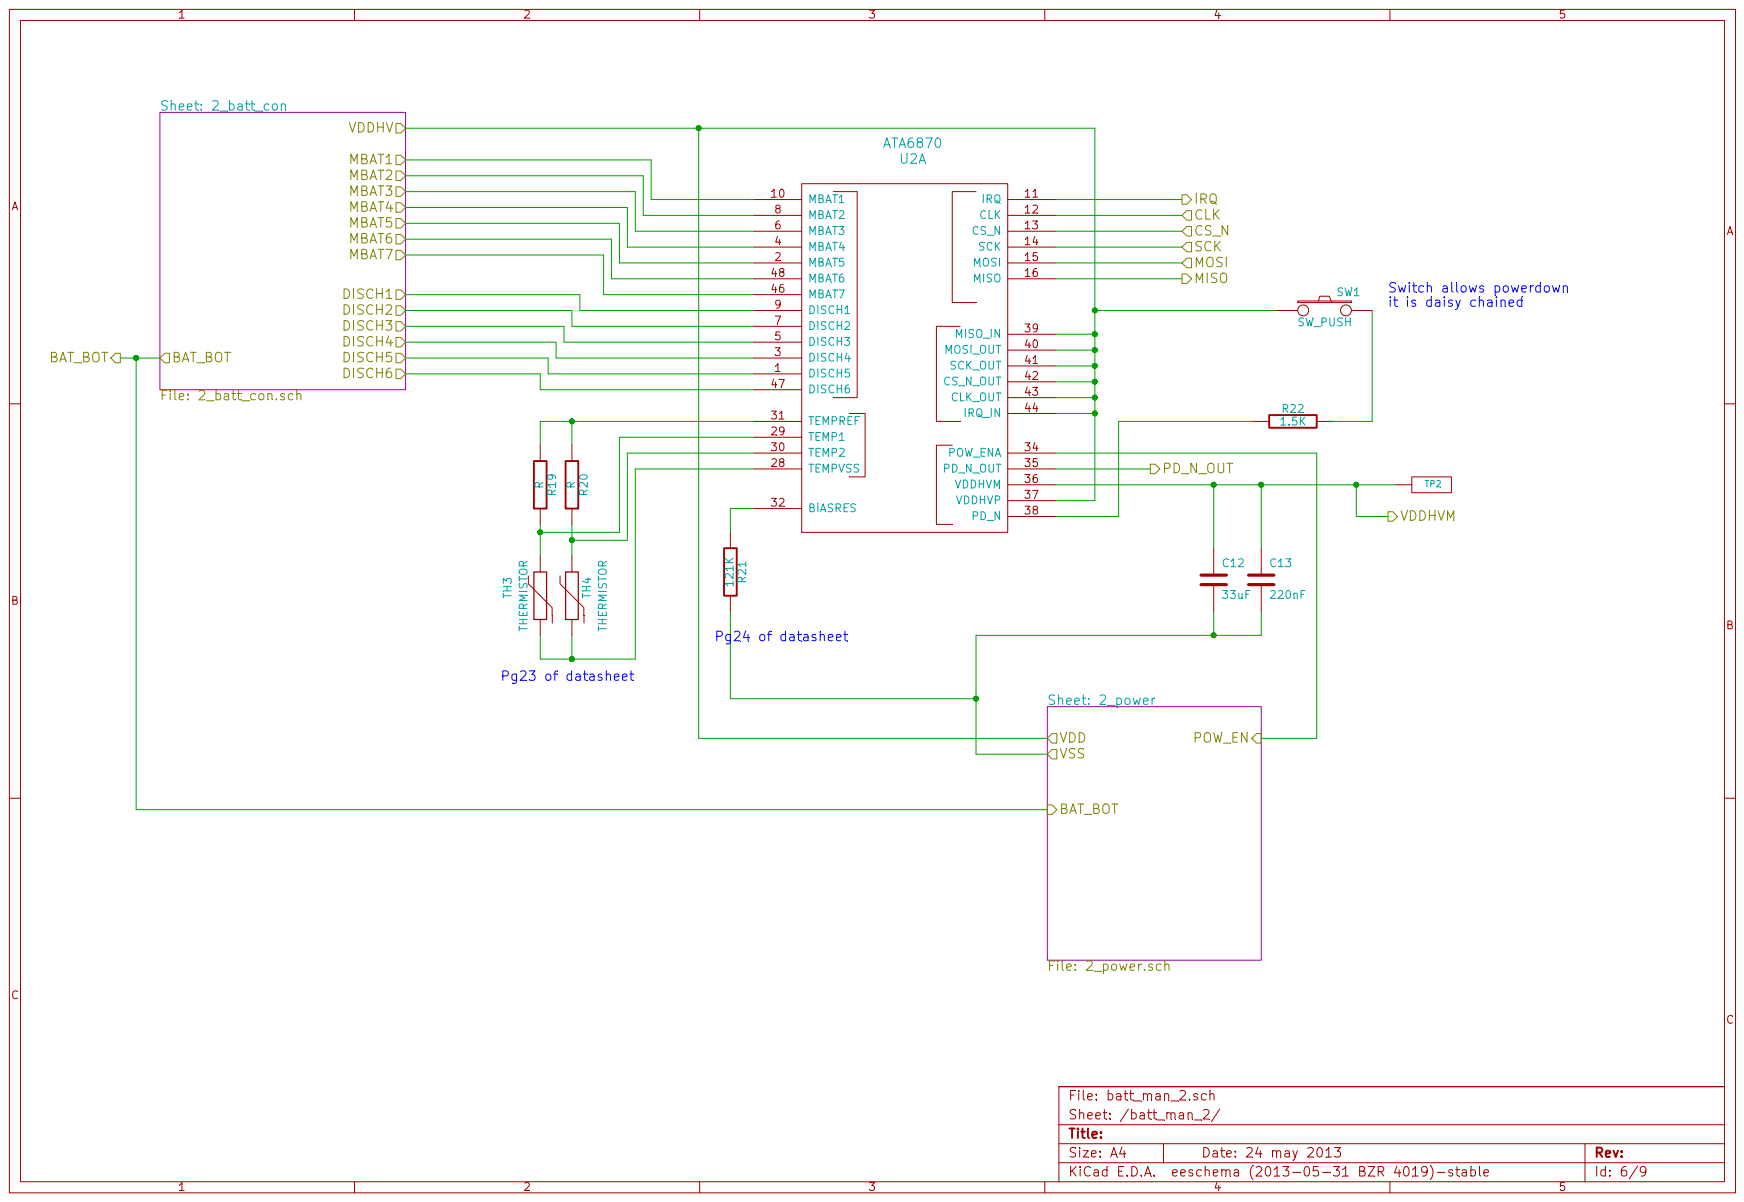
[picture p276: page 6]

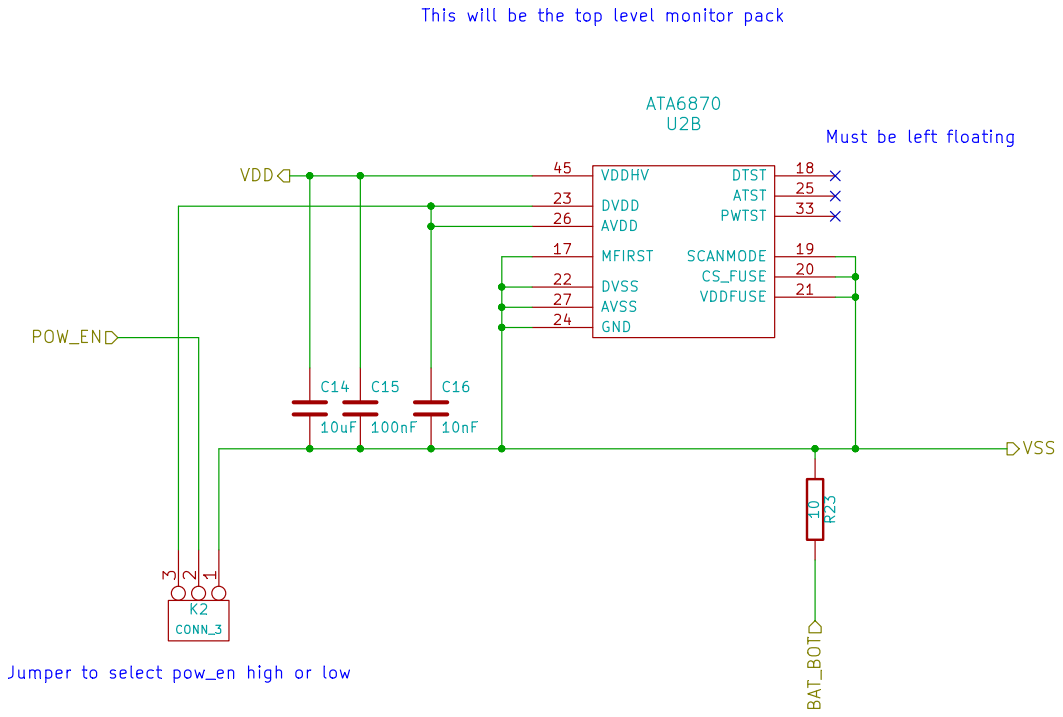
[picture p277: page 7]

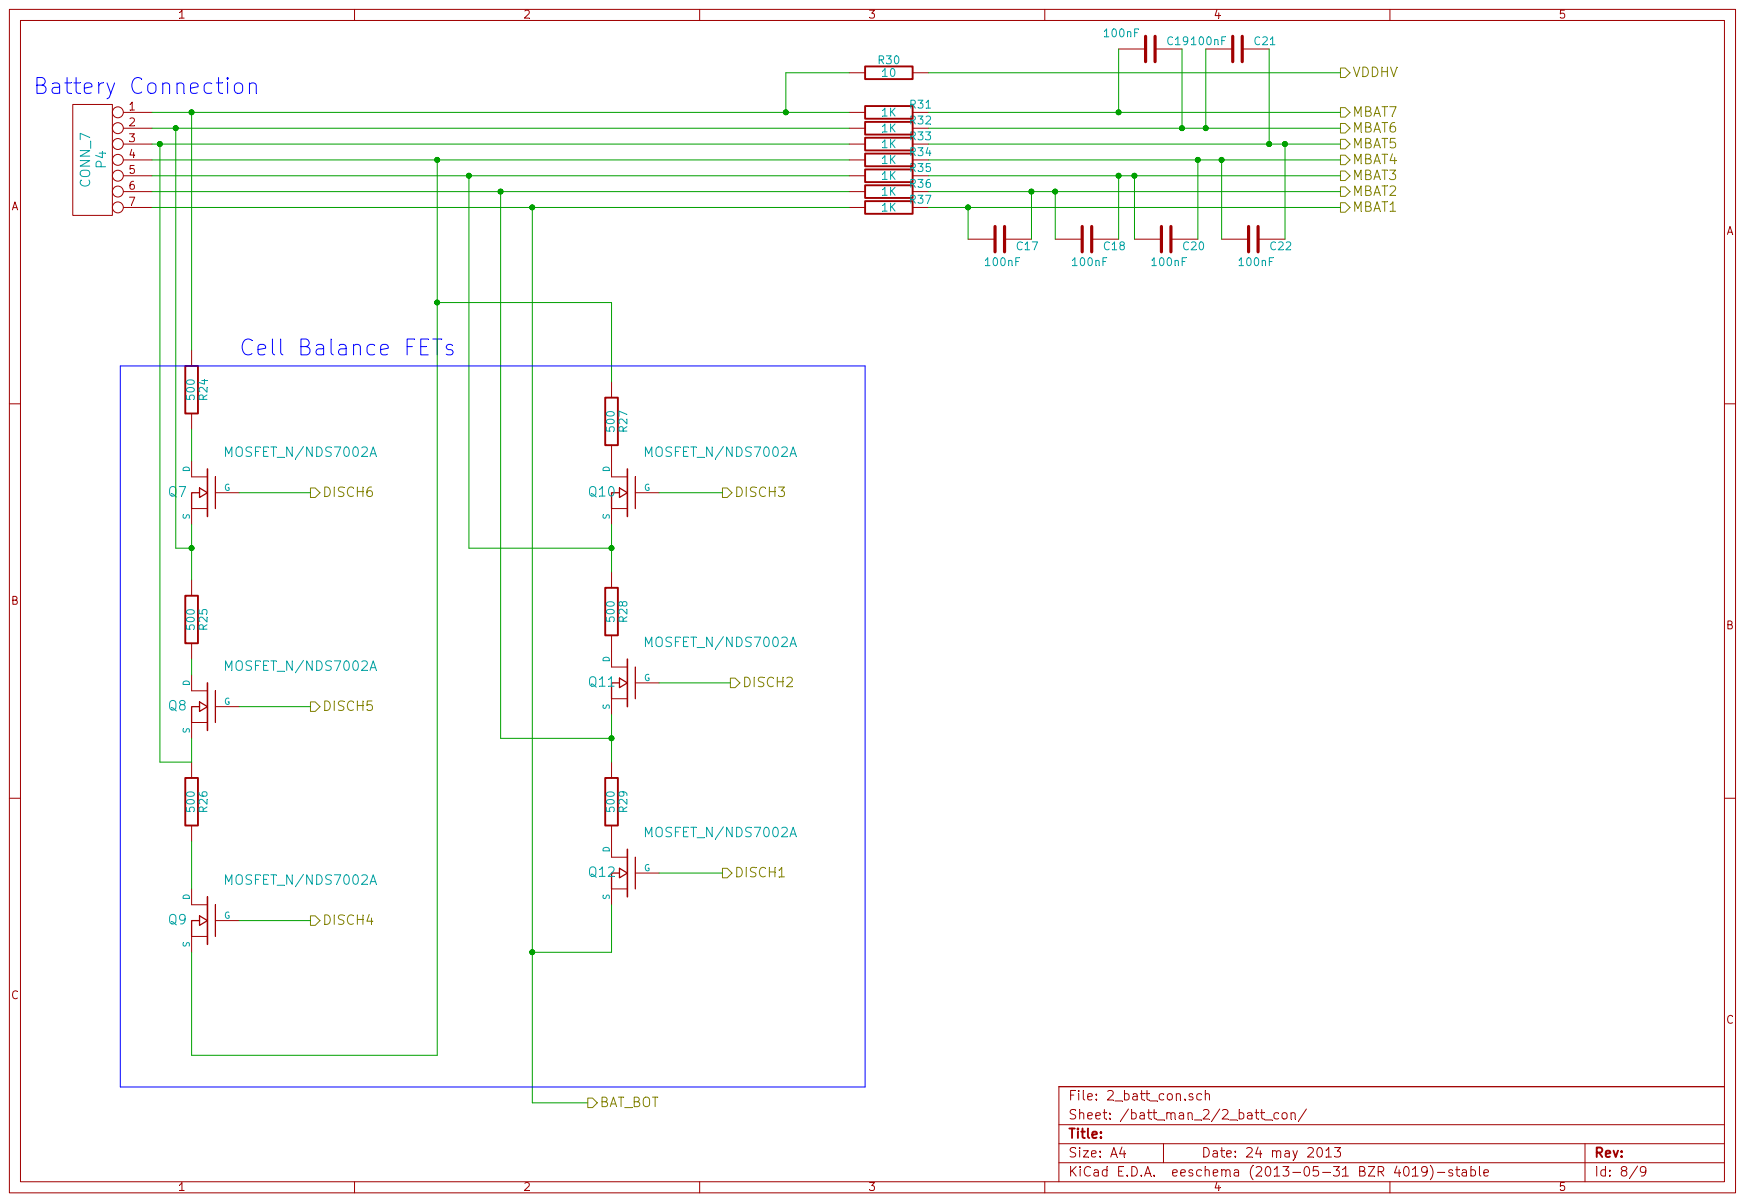
[picture p278: page 8]

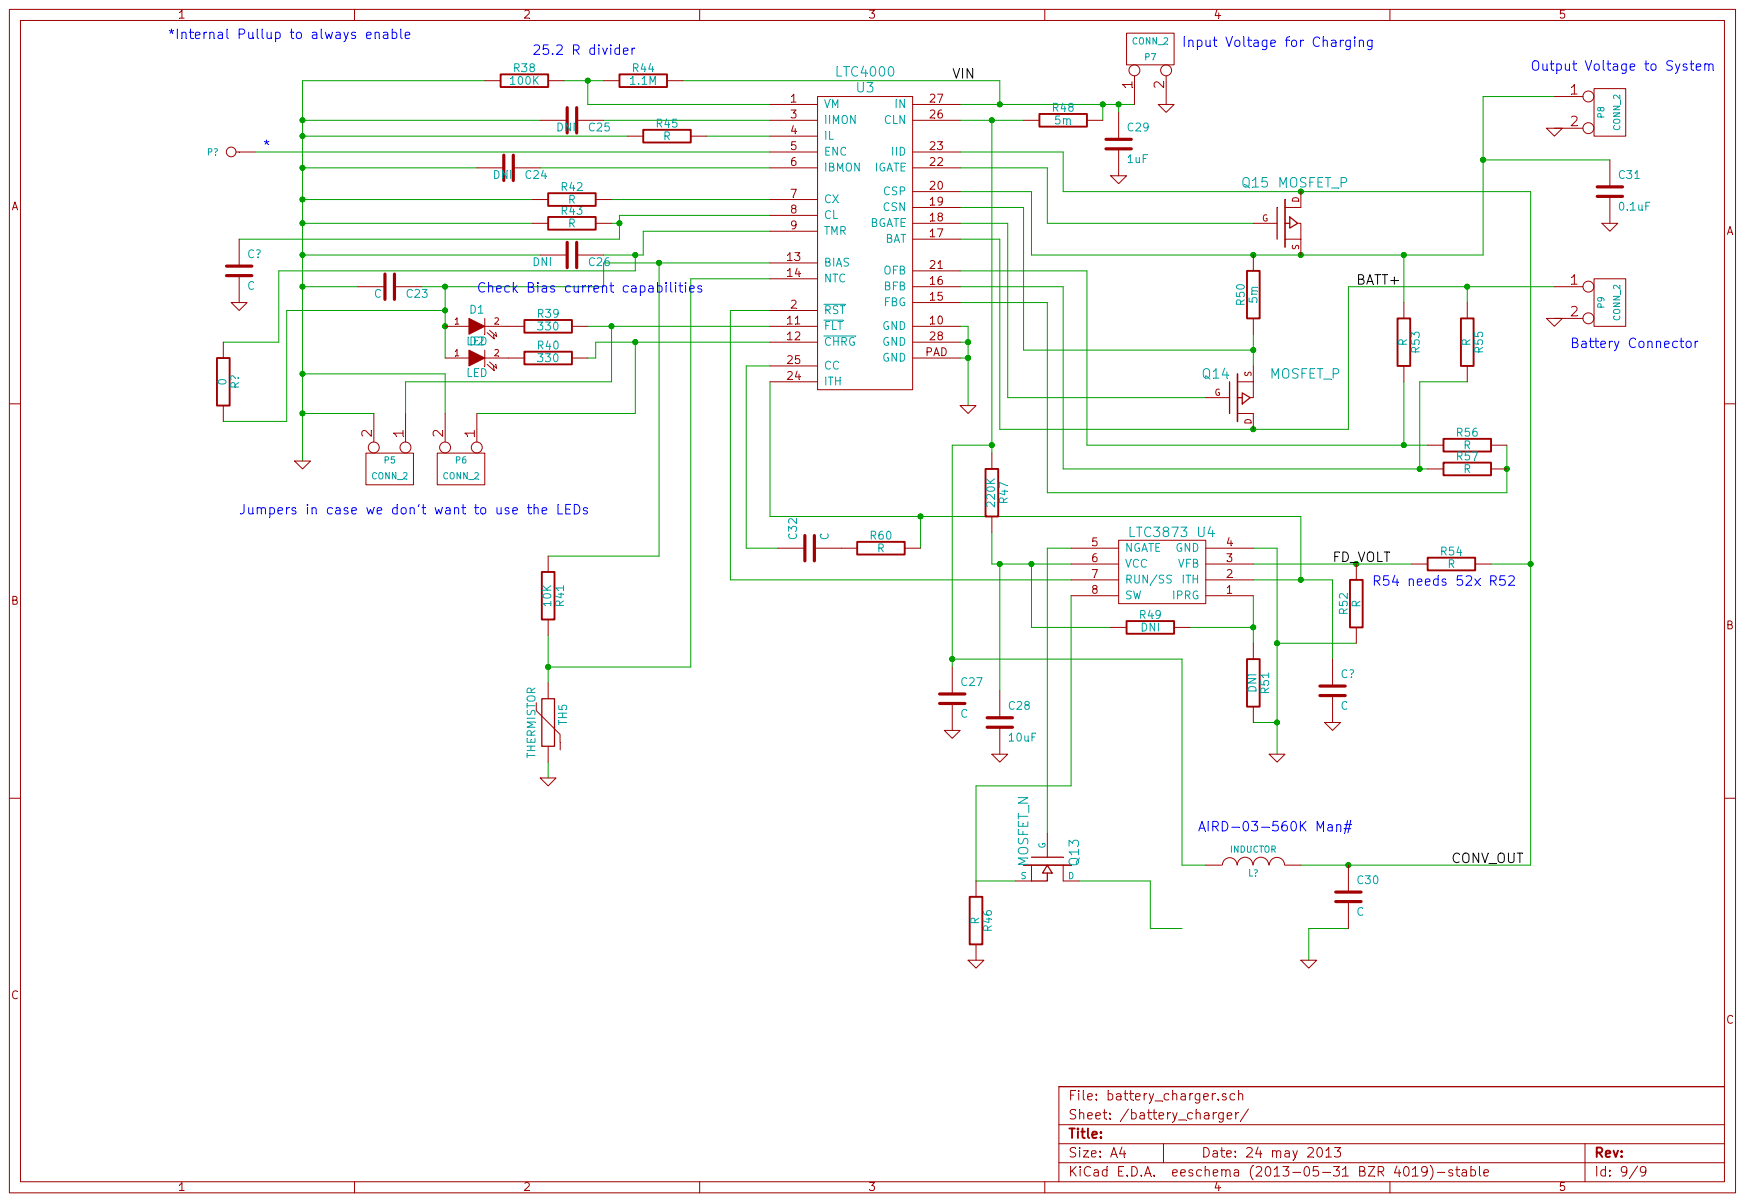
[picture p279: page 9]
