NxRLab/gibbot/PCB/Gibbot v3/Gibbot v3.pdf

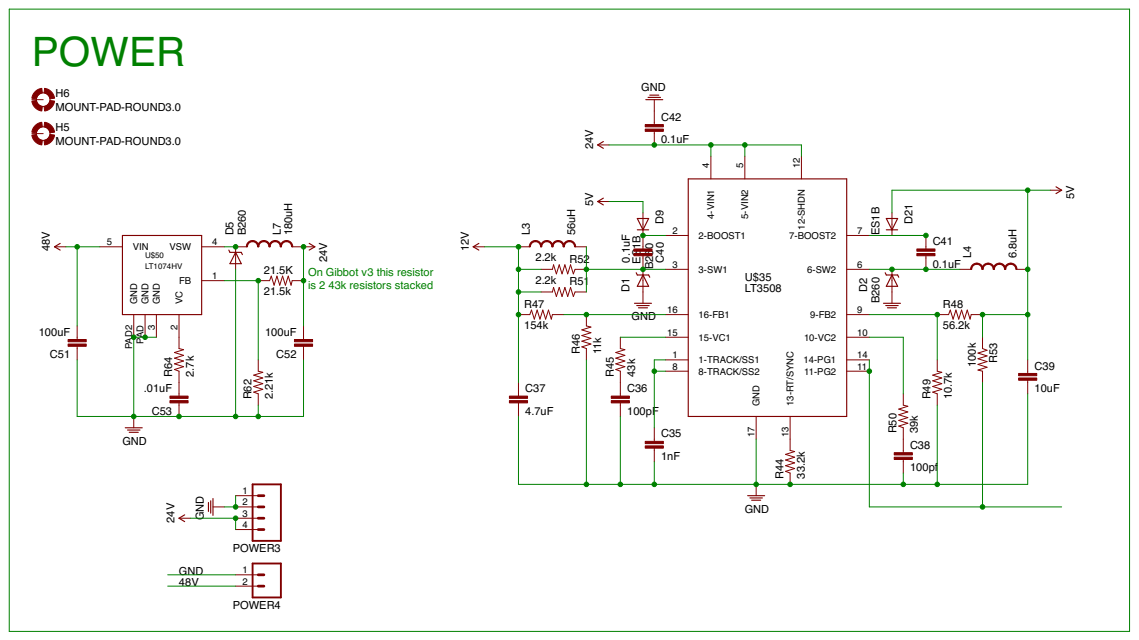
[picture p280: page 1]
