NxRLab/gibbot/Old Monkeybot - 2011/Monkeybot Eagle CAD/monkeybot_board.pdf

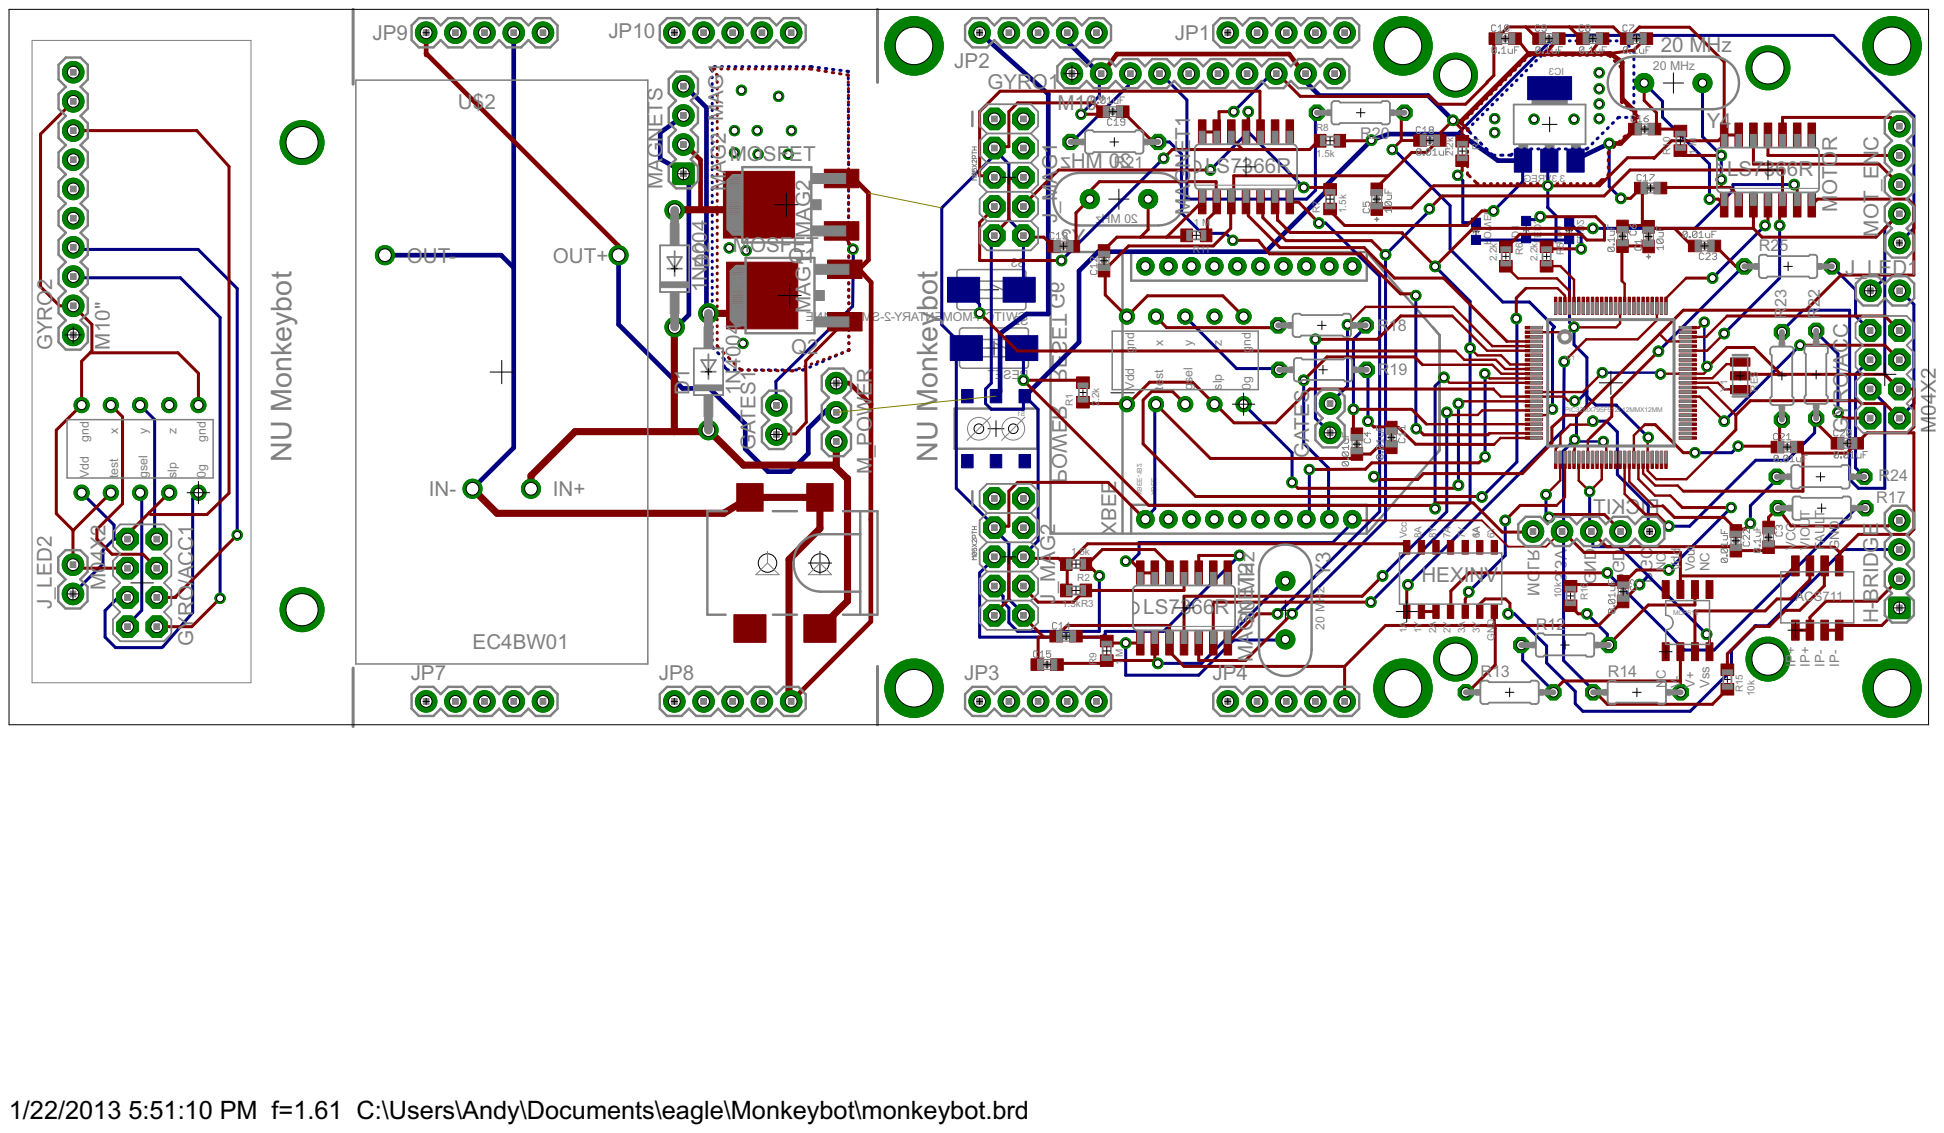
[picture p281: page 1]

1/22/2013 5:51:10 PM f=1.61 C:\Users\Andy\Documents\eagle\Monkeybot\monkeybot.brd
