NxRLab/gibbot/PCB/Gibbot v1/PCBParts/JST-1mm-2pin.pdf

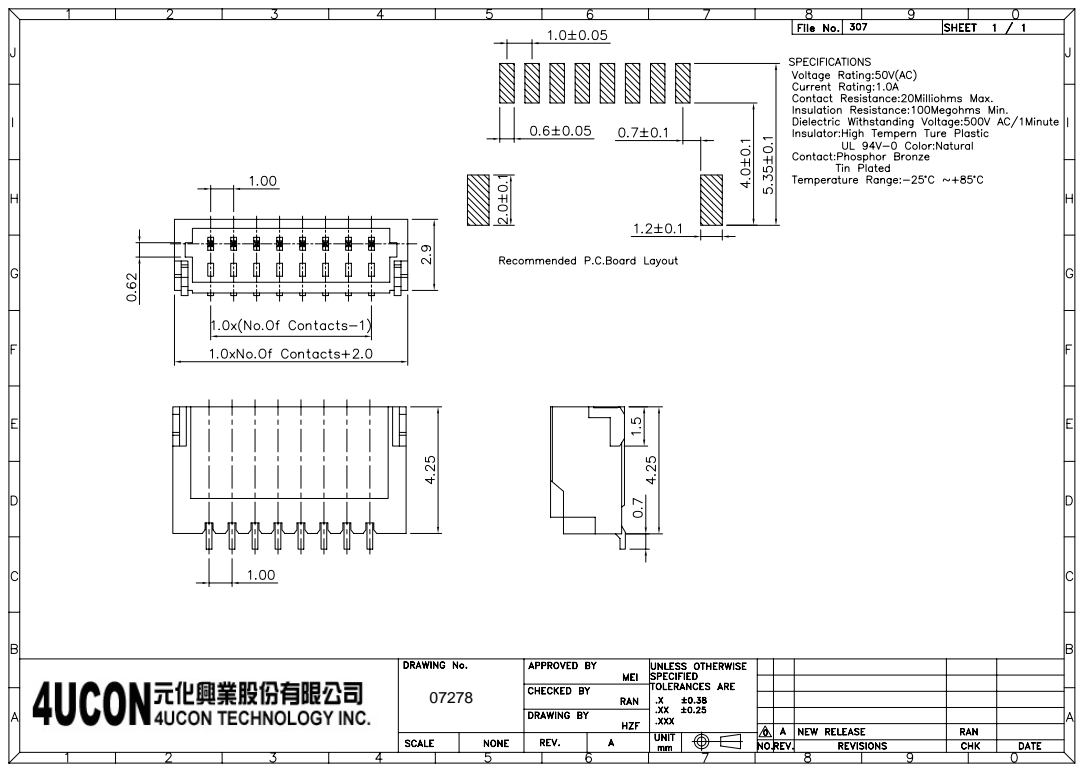
[picture p282: page 1]
