NxRLab/gibbot/(list of files, drawings)

Other design files:
PCB/Gibbot v1/Test.dsn
