NxRLab/gibbot/PCB/Gibbot v2/DsPIC Breakout/DsPIC Breakout.kicad_pcb

## KiCad design PCB/Gibbot v2/DsPIC Breakout/DsPIC Breakout.kicad_pcb (2013-07-11, an earlier design)

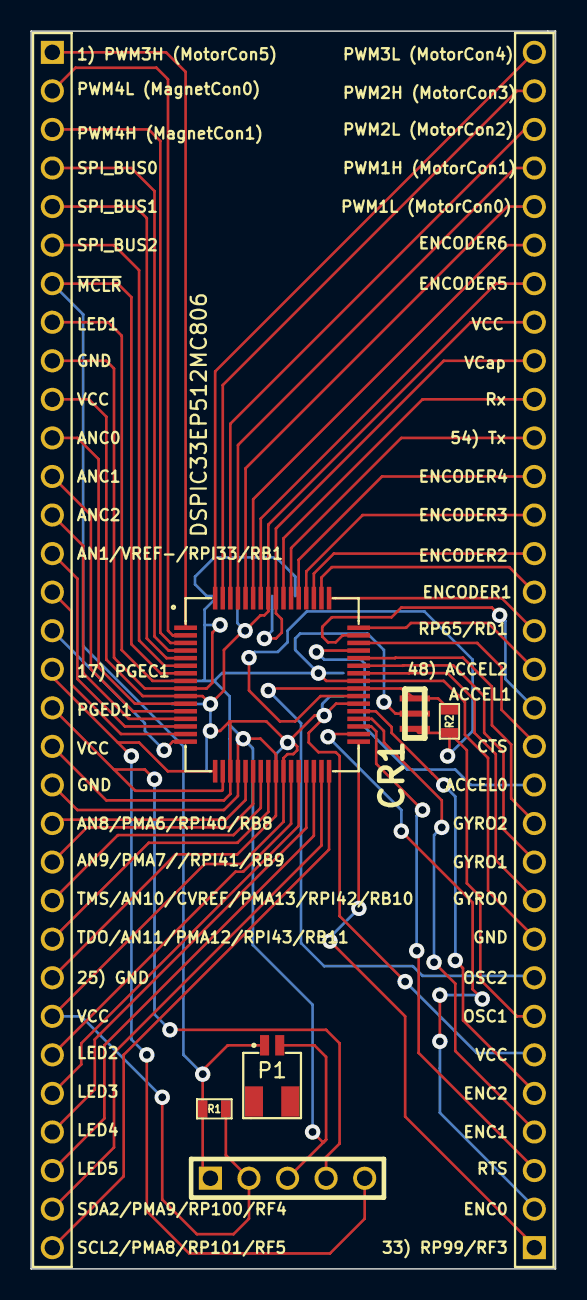
[picture p283: board DsPIC Breakout.kicad_pcb from above]

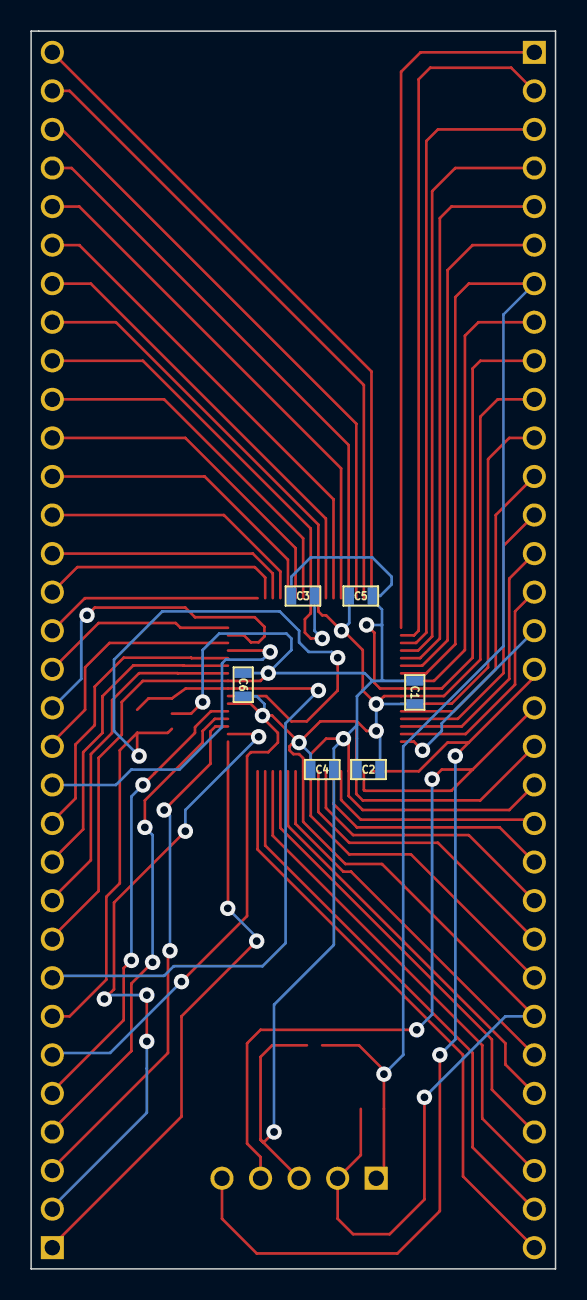
[picture p284: board DsPIC Breakout.kicad_pcb from below]

Board: 2 copper layers, 34.5 x 81.5 mm, 14 parts (6 on the bottom side), 57 nets.

Parts:
C1, C2, C4, C6: 0.1 uF; SM0603
C3: 10 uF; SM0603
C5: 0.1uF; SM0603
CR1: CERAMIC_RES; 8MHZ_CER_RES
J1: BREADBOARD_HEADER_32X1; PIN_ARRAY_32x1
J2: BREADBOARD_HEADER_32X1; PIN_ARRAY_32X1
P1: CONN_2; JST-1mm-2pin
P2: PROG_H; PIN_ARRAY_5x1
R1: 10K; SM0603
R2: 1M; SM0603
U1: DSPIC33EP512MC806; MY_TQFP_64

Connections:
GND: C1.1, C2.2, C3.1, C4.1, C5.1, C6.2, CR1.2, J1.9, J1.20, J1.25, J2.9, P1.2, P2.3, U1.9, U1.20, U1.25, U1.41
unnamed: J1.13, U1.13
unnamed: J1.14, U1.14
unnamed: J1.15, U1.15
unnamed: J1.16, U1.16
unnamed: J1.27, U1.27
unnamed: J1.28, U1.28
unnamed: J1.31, U1.31
unnamed: J1.7, P1.1, P2.1, R1.2, U1.7
unnamed: J1.8, U1.8
unnamed: J1.30, U1.30
unnamed: J2.5, U1.37
unnamed: J2.4, U1.36
unnamed: J2.3, U1.35
unnamed: J2.2, U1.34
unnamed: J2.1, U1.33
unnamed: J1.24, U1.24
unnamed: J2.10, U1.42
unnamed: J2.11, U1.43
unnamed: J2.12, U1.44
unnamed: J2.13, U1.45
unnamed: J2.14, U1.46
unnamed: J2.15, U1.47
unnamed: J2.16, U1.48
unnamed: CR1.3, J2.8, R2.2, U1.40
unnamed: CR1.1, J2.7, R2.1, U1.39
unnamed: J2.29, U1.61
unnamed: J2.27, U1.59
unnamed: J2.31, U1.63
unnamed: J2.26, U1.58
unnamed: J1.5, U1.5
unnamed: C3.2, J2.24, U1.56
unnamed: J1.1, U1.1
unnamed: J1.2, U1.2
unnamed: J1.3, U1.3
unnamed: J1.4, U1.4
unnamed: J1.6, U1.6
unnamed: J1.11, U1.11
unnamed: J1.12, U1.12
unnamed: J1.32, U1.32
unnamed: J2.17, U1.49
unnamed: J2.18, U1.50
unnamed: J2.19, U1.51
unnamed: J2.20, U1.52
unnamed: J2.21, U1.53
unnamed: J1.29, U1.29
unnamed: J2.22, U1.54
unnamed: J2.28, U1.60
unnamed: J2.30, U1.62
unnamed: J2.32, U1.64
unnamed: J2.23, U1.55
unnamed: J1.18, P2.4, U1.18
unnamed: J1.17, P2.5, U1.17
unnamed: J1.23, U1.23
unnamed: J1.21, U1.21
unnamed: J1.22, U1.22
VCC: C1.2, C2.1, C4.2, C5.2, C6.1, J1.10, J1.19, J1.26, J2.6, J2.25, P2.2, R1.1, U1.10, U1.19, U1.26, U1.38, U1.57
