NxRLab/gibbot/PCB/Gibbot v1/Test.kicad_pcb

## KiCad design PCB/Gibbot v1/Test.kicad_pcb (2013-07-09, an earlier design)

Schematic: Test.sch

Parts:
C53: 0.1uF
CR1: CERAMIC_RES
D1, D2, D3, D4, D5: LED
D9: LED
JP1, JP2: MOT_ENC
P2: PROG_H
P3, P6, P7, P8, P9, P10, P11, P19: CONN_2
P12, P13, P14, P15, P17, P18: CONN_1
P16: CONN_6
R2, R16, R17, R18, R19, R54: 1K
R15: 10K
R32: 1M
R38, R39, R40, R41, R42, R43: 330
R44, R45, R46, R47, R48, R49, R50, R51, R52: 2.2K
R53: R
XBEE1: XBEE-1B2

Connections:
+5V: JP1.1 (5V), JP2.1 (5V), P16.5; also elsewhere on the board
/CTS: XBEE1.12 (~CTS~/DIO7); also elsewhere on the board
/ENCODER1: R47.1; also elsewhere on the board
/ENCODER2: R48.1; also elsewhere on the board
/ENCODER3: R49.1; also elsewhere on the board
/ENCODER4: R50.1; also elsewhere on the board
/ENCODER5: R51.1; also elsewhere on the board
/ENCODER6: R52.1; also elsewhere on the board
/LED1: D1.2 (K); also elsewhere on the board
/LED2: D2.2 (K); also elsewhere on the board
/LED3: D3.2 (K); also elsewhere on the board
/LED4: D4.2 (K); also elsewhere on the board
/LED5: D5.2 (K); also elsewhere on the board
/RTS: XBEE1.16 (~RTS~/AD6/DIO6); also elsewhere on the board
/RX: XBEE1.2 (DOUT); also elsewhere on the board
/TX: XBEE1.3 (DIN/~CONFIG); also elsewhere on the board
GND: C53.2, CR1.2, D9.2 (K), JP1.2 (GND), JP2.2 (GND), P2.3 (VSS), P3.2 (PM), P6.1, P7.1, P8.1, P9.1, P10.1, P11.1, P16.4, P19.1, XBEE1.10 (GND); also elsewhere on the board
unnamed: P10.2 (PM), R42.2
unnamed: P11.2 (PM), R43.2
unnamed: D5.1 (A), R2.2
unnamed 48: R44.1; also elsewhere on the board
unnamed 49: R46.1; also elsewhere on the board
unnamed 50: R45.1; also elsewhere on the board
unnamed 51: CR1.3, R32.2; also elsewhere on the board
unnamed 52: P19.2 (PM), R54.2; also elsewhere on the board
unnamed: R53.1, XBEE1.4 (DIO8)
unnamed 54: CR1.1, R32.1; also elsewhere on the board
unnamed: P16.1, R46.2
unnamed: P16.2, R45.2
unnamed: P16.3, R44.2
unnamed: P7.2 (PM), R39.2
unnamed: P6.2 (PM), R38.2
unnamed: P9.2 (PM), R41.2
unnamed: P8.2 (PM), R40.2
unnamed: D9.1 (A), R53.2
unnamed 63: P2.5 (PGC); also elsewhere on the board
unnamed 64: P2.4 (PGD); also elsewhere on the board
unnamed: JP2.5 (INDEX), R52.2
unnamed: JP2.4 (B), R51.2
unnamed: JP2.3 (A), R50.2
unnamed: JP1.3 (A), R47.2
unnamed: JP1.5 (INDEX), R49.2
unnamed: JP1.4 (B), R48.2
unnamed 71: P2.1 (MCLR), P3.1, R15.2; also elsewhere on the board
unnamed: D4.1 (A), R19.2
unnamed: D3.1 (A), R18.2
unnamed: D2.1 (A), R17.2
unnamed: D1.1 (A), R16.2
VCC: C53.1, P2.2 (VDD), R2.1, R15.1, R16.1, R17.1, R18.1, R19.1, R38.1, R39.1, R40.1, R41.1, R42.1, R43.1, R54.1, XBEE1.1 (VDD); also elsewhere on the board

Notes on the sheet:
Power
Sensors
XBee Chip
Reset Switch
NOTE: Global VCC = +3.3V
Add decoupling
6 IR LEDs for Vision group
Mounting Holes
Actuators
Programming header
3 on each end of board
Status LED
Hall effect connector
Could be an issue with 5V inputs since 5V powers up first. If PIC is not on (no 3.3V supply) and 5V pins are driven, there could be a problem.
Should have test points for each voltage

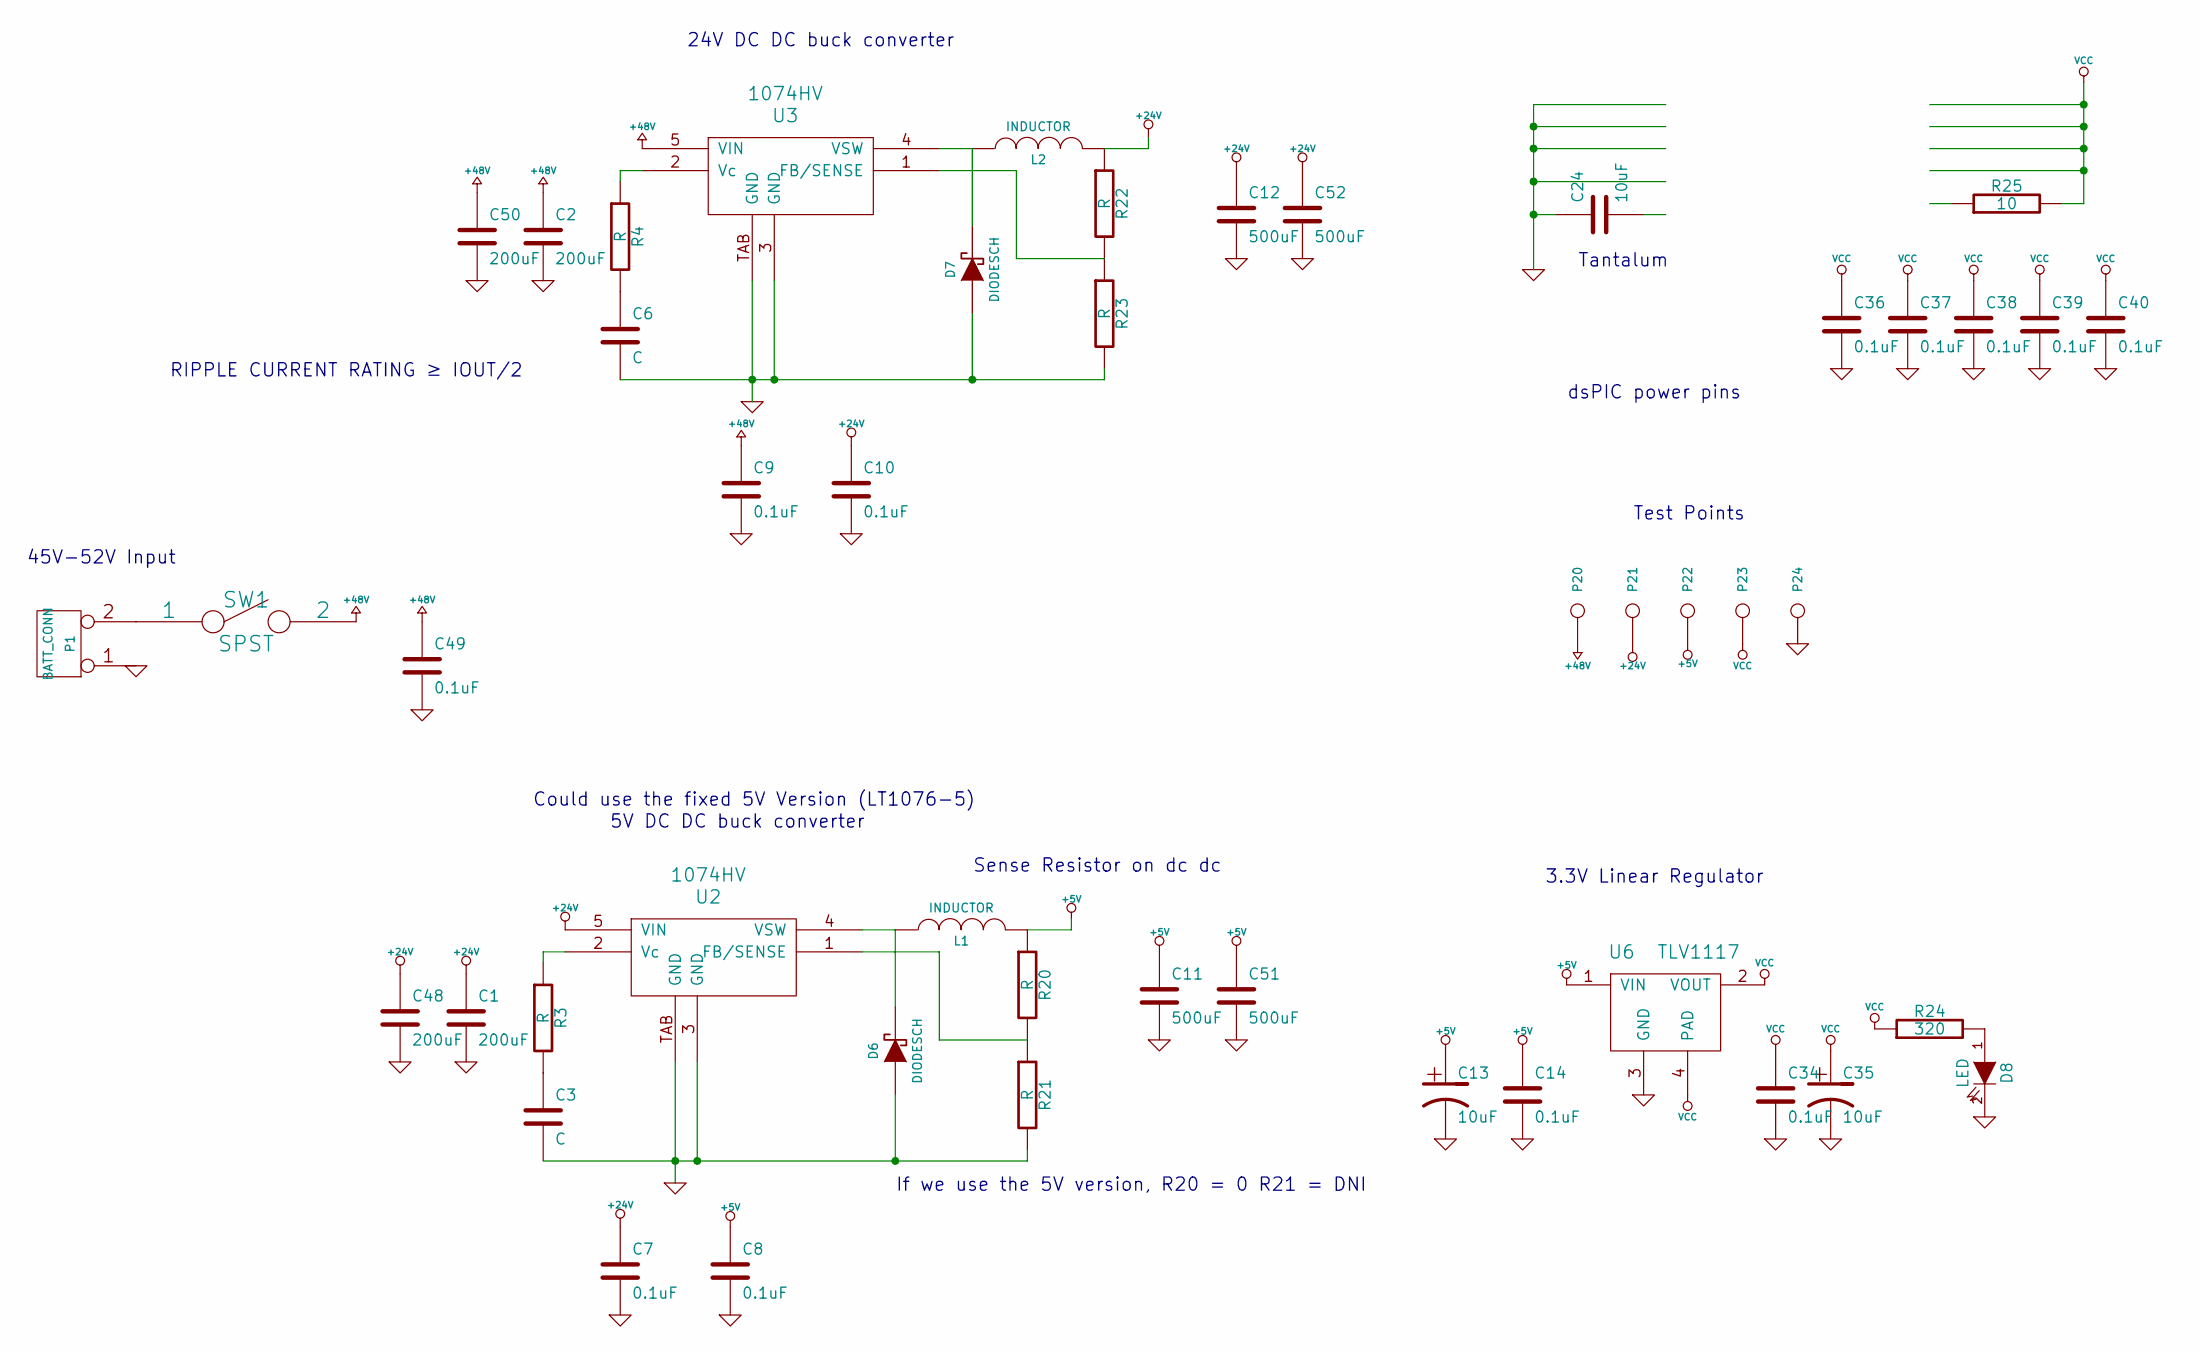
[picture p285: schematic power.sch]

Parts:
C1, C2, C48, C50: 200uF
C3, C6: C
C7, C8, C9, C10, C14, C34, C36, C37, C38, C39, C40, C49: 0.1uF
C11, C12, C51, C52: 500uF
C13, C24, C35: 10uF
D6, D7: DIODESCH
D8: LED
L1, L2: INDUCTOR
P1: BATT_CONN
P20, P21, P22, P23, P24: CONN_1
R3, R4, R20, R21, R22, R23: R
R24: 320
R25: 10
SW1: SPST
U2, U3: 1074HV
U6: TLV1117

Connections:
+5V: C8.1, C11.1, C13.1, C14.1, C51.1, L1.2, P22.1, R20.1, U6.1 (VIN); also elsewhere on the board
+24V: C1.1, C7.1, C10.1, C12.1, C48.1, C52.1, L2.2, P21.1, R22.1, U2.5 (VIN); also elsewhere on the board
+48V: C2.1, C9.1, C49.1, C50.1, P20.1, SW1.2, U3.5 (VIN); also elsewhere on the board
GND: C1.2, C2.2, C3.2, C6.2, C7.2, C8.2, C9.2, C10.2, C11.2, C12.2, C13.2, C14.2, C24.1, C34.2, C35.2, C36.2, C37.2, C38.2, C39.2, C40.2, C48.2, C49.2, C50.2, C51.2, C52.2, D6.1 (A), D7.1 (A), D8.2 (K), P1.1, P24.1, R21.2, R23.2, U2.3 (GND), U2.TAB (GND), U3.3 (GND), U3.TAB (GND), U6.3 (GND); also elsewhere on the board
unnamed: R3.1, U2.2 (Vc)
unnamed: C3.1, R3.2
unnamed: R20.2, R21.1, U2.1 (FB/SENSE)
unnamed: D6.2 (K), L1.1, U2.4 (VSW)
unnamed: R22.2, R23.1, U3.1 (FB/SENSE)
unnamed: D7.2 (K), L2.1, U3.4 (VSW)
unnamed 82: R25.1; also elsewhere on the board
unnamed 83: C24.2; also elsewhere on the board
unnamed: P1.2 (PM), SW1.1
unnamed: R4.1, U3.2 (Vc)
unnamed: C6.1, R4.2
unnamed: D8.1 (A), R24.2
VCC: C34.1, C35.1, C36.1, C37.1, C38.1, C39.1, C40.1, P23.1, R24.1, R25.2, U6.2 (VOUT), U6.4 (PAD); also elsewhere on the board

Notes on the sheet:
24V DC DC buck converter
45V-52V Input
3.3V Linear Regulator
dsPIC power pins
RIPPLE CURRENT RATING ≥ IOUT/2
5V DC DC buck converter
Could use the fixed 5V Version (LT1076-5)
Tantalum
Sense Resistor on dc dc
If we use the 5V version, R20 = 0 R21 = DNI
Test Points

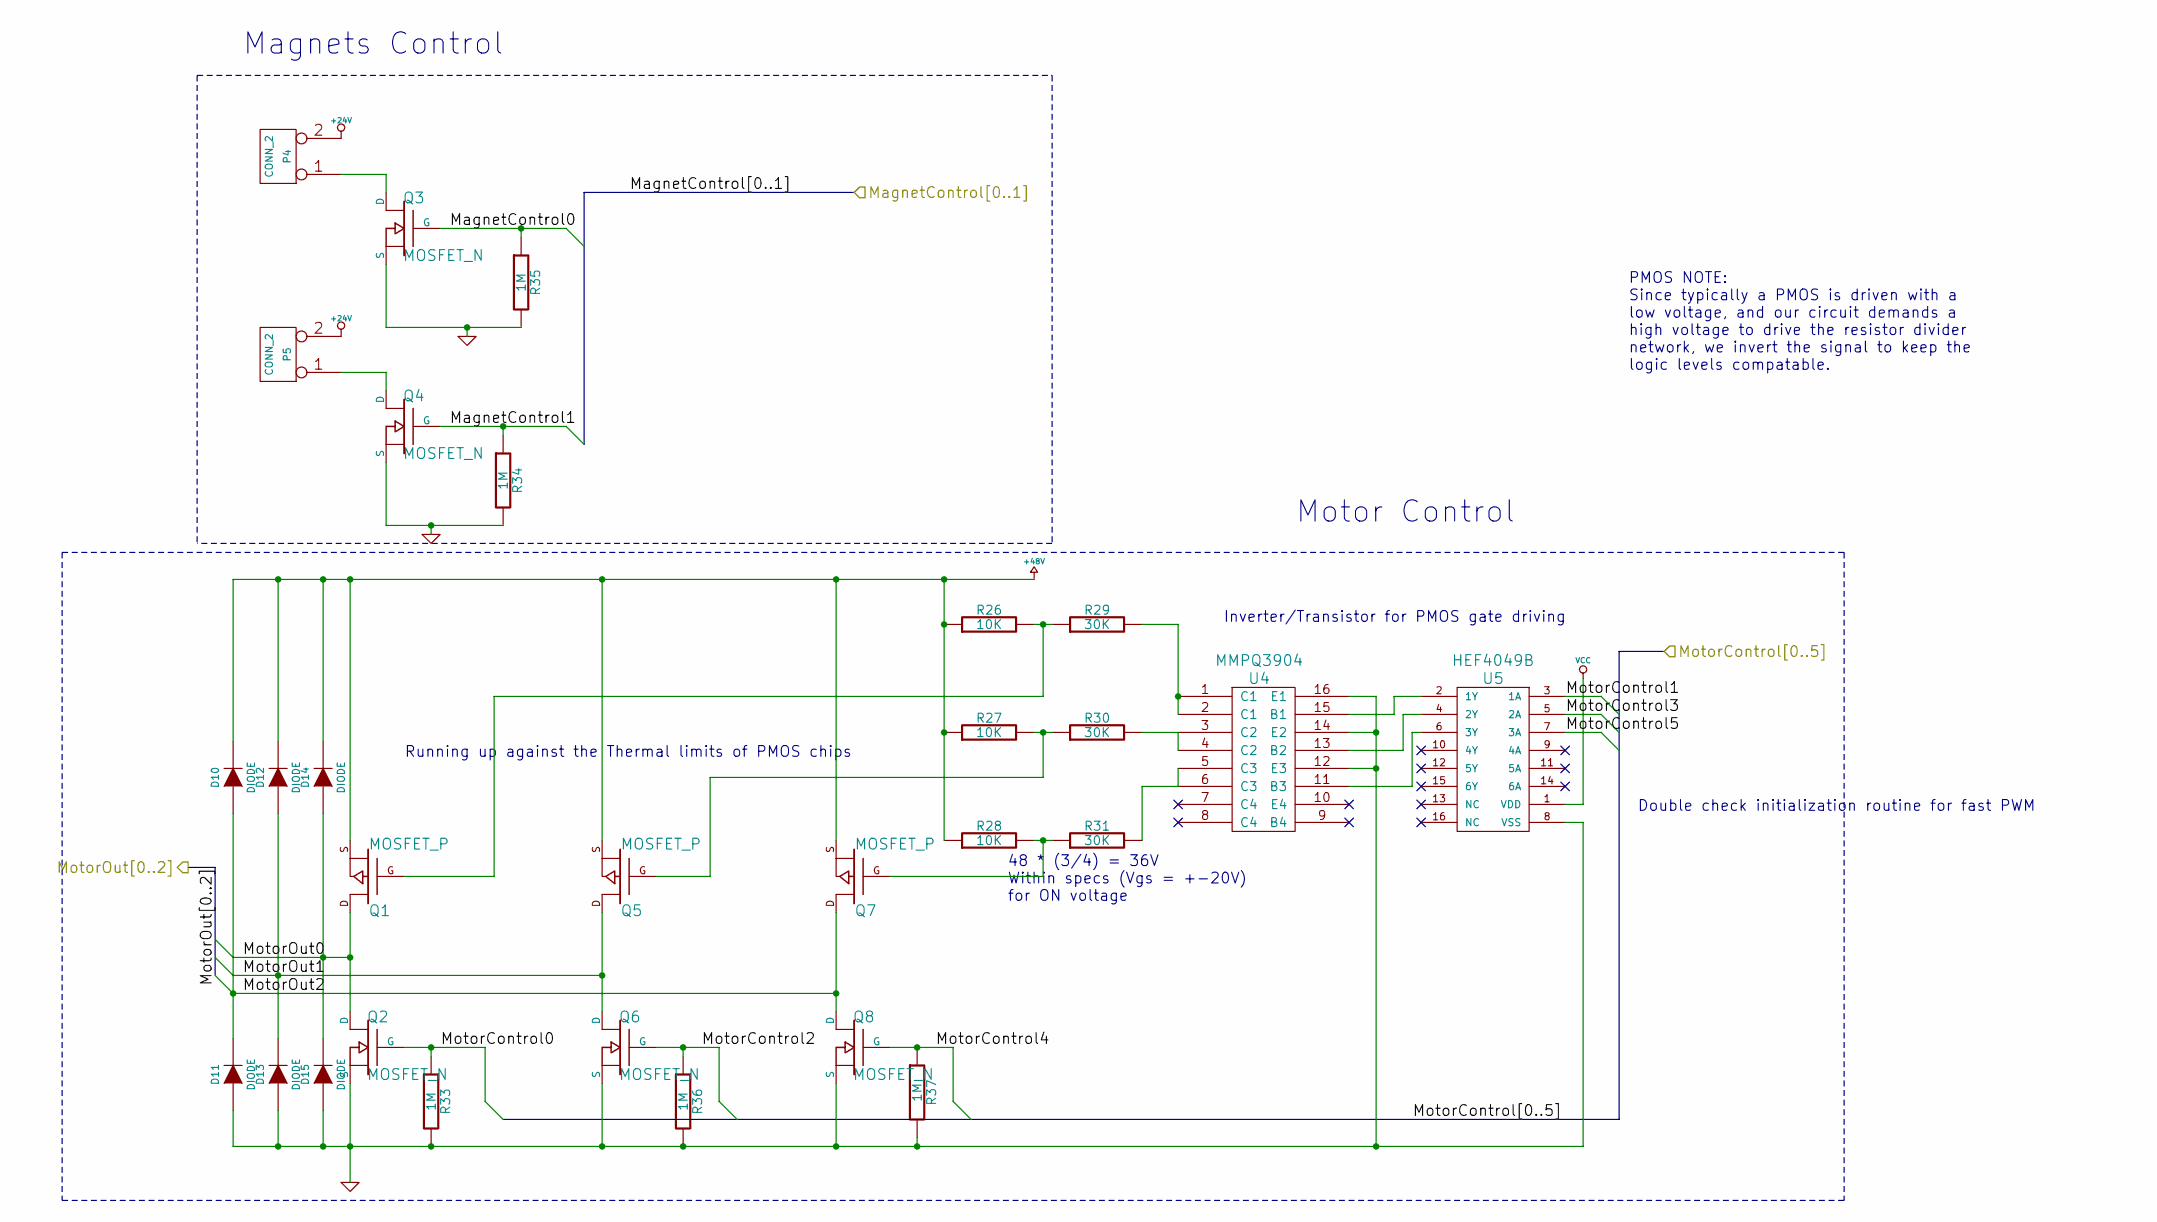
[picture p286: schematic motor_control.sch]

Parts:
D10, D11, D12, D13, D14, D15: DIODE
P4, P5: CONN_2
Q1, Q5, Q7: MOSFET_P
Q2, Q3, Q4, Q6, Q8: MOSFET_N
R26, R27, R28: 10K
R29, R30, R31: 30K
R33, R34, R35, R36, R37: 1M
U4: MMPQ3904
U5: HEF4049B

Connections:
+24V: P4.2 (PM), P5.2 (PM); also elsewhere on the board
+48V: D10.2 (K), D12.2 (K), D14.2 (K), Q1.S, Q5.S, Q7.S, R26.1, R27.1, R28.1; also elsewhere on the board
/MagnetControl0: Q3.G, R35.1; also elsewhere on the board
/MagnetControl1: Q4.G, R34.1; also elsewhere on the board
/MotorControl0: Q2.G, R33.1; also elsewhere on the board
/MotorControl1: U5.3 (1A); also elsewhere on the board
/MotorControl2: Q6.G, R36.1; also elsewhere on the board
/MotorControl3: U5.5 (2A); also elsewhere on the board
/MotorControl4: Q8.G, R37.1; also elsewhere on the board
/MotorControl5: U5.7 (3A); also elsewhere on the board
/motor_control/MotorOut0: D14.1 (A), D15.2 (K), Q1.D, Q2.D; also elsewhere on the board
/motor_control/MotorOut1: D12.1 (A), D13.2 (K), Q5.D, Q6.D; also elsewhere on the board
/motor_control/MotorOut2: D10.1 (A), D11.2 (K), Q7.D, Q8.D; also elsewhere on the board
GND: D11.1 (A), D13.1 (A), D15.1 (A), Q2.S, Q3.S, Q4.S, Q6.S, Q8.S, R33.2, R34.2, R35.2, R36.2, R37.2, U4.12 (E3), U4.14 (E2), U4.16 (E1), U5.8 (VSS); also elsewhere on the board
unnamed: Q5.G, R27.2, R30.1
unnamed: Q7.G, R28.2, R31.1
unnamed: Q1.G, R26.2, R29.1
unnamed: P5.1, Q4.D
unnamed: P4.1, Q3.D
unnamed: U4.13 (B2), U5.4 (2Y)
unnamed: U4.15 (B1), U5.2 (1Y)
unnamed: R31.2, U4.5 (C3), U4.6 (C3)
unnamed: R30.2, U4.3 (C2), U4.4 (C2)
unnamed: U4.11 (B3), U5.6 (3Y)
unnamed: R29.2, U4.1 (C1), U4.2 (C1)
VCC: U5.1 (VDD); also elsewhere on the board

Notes on the sheet:
Motor Control
Magnets Control
Inverter/Transistor for PMOS gate driving
48 * (3/4) = 36V Within specs (Vgs = +-20V) for ON voltage
PMOS NOTE: Since typically a PMOS is driven with a low voltage, and our circuit demands a high voltage to drive the resistor divider network, we invert the signal to keep the logic levels compatable.
Double check initialization routine for fast PWM
Running up against the Thermal limits of PMOS chips

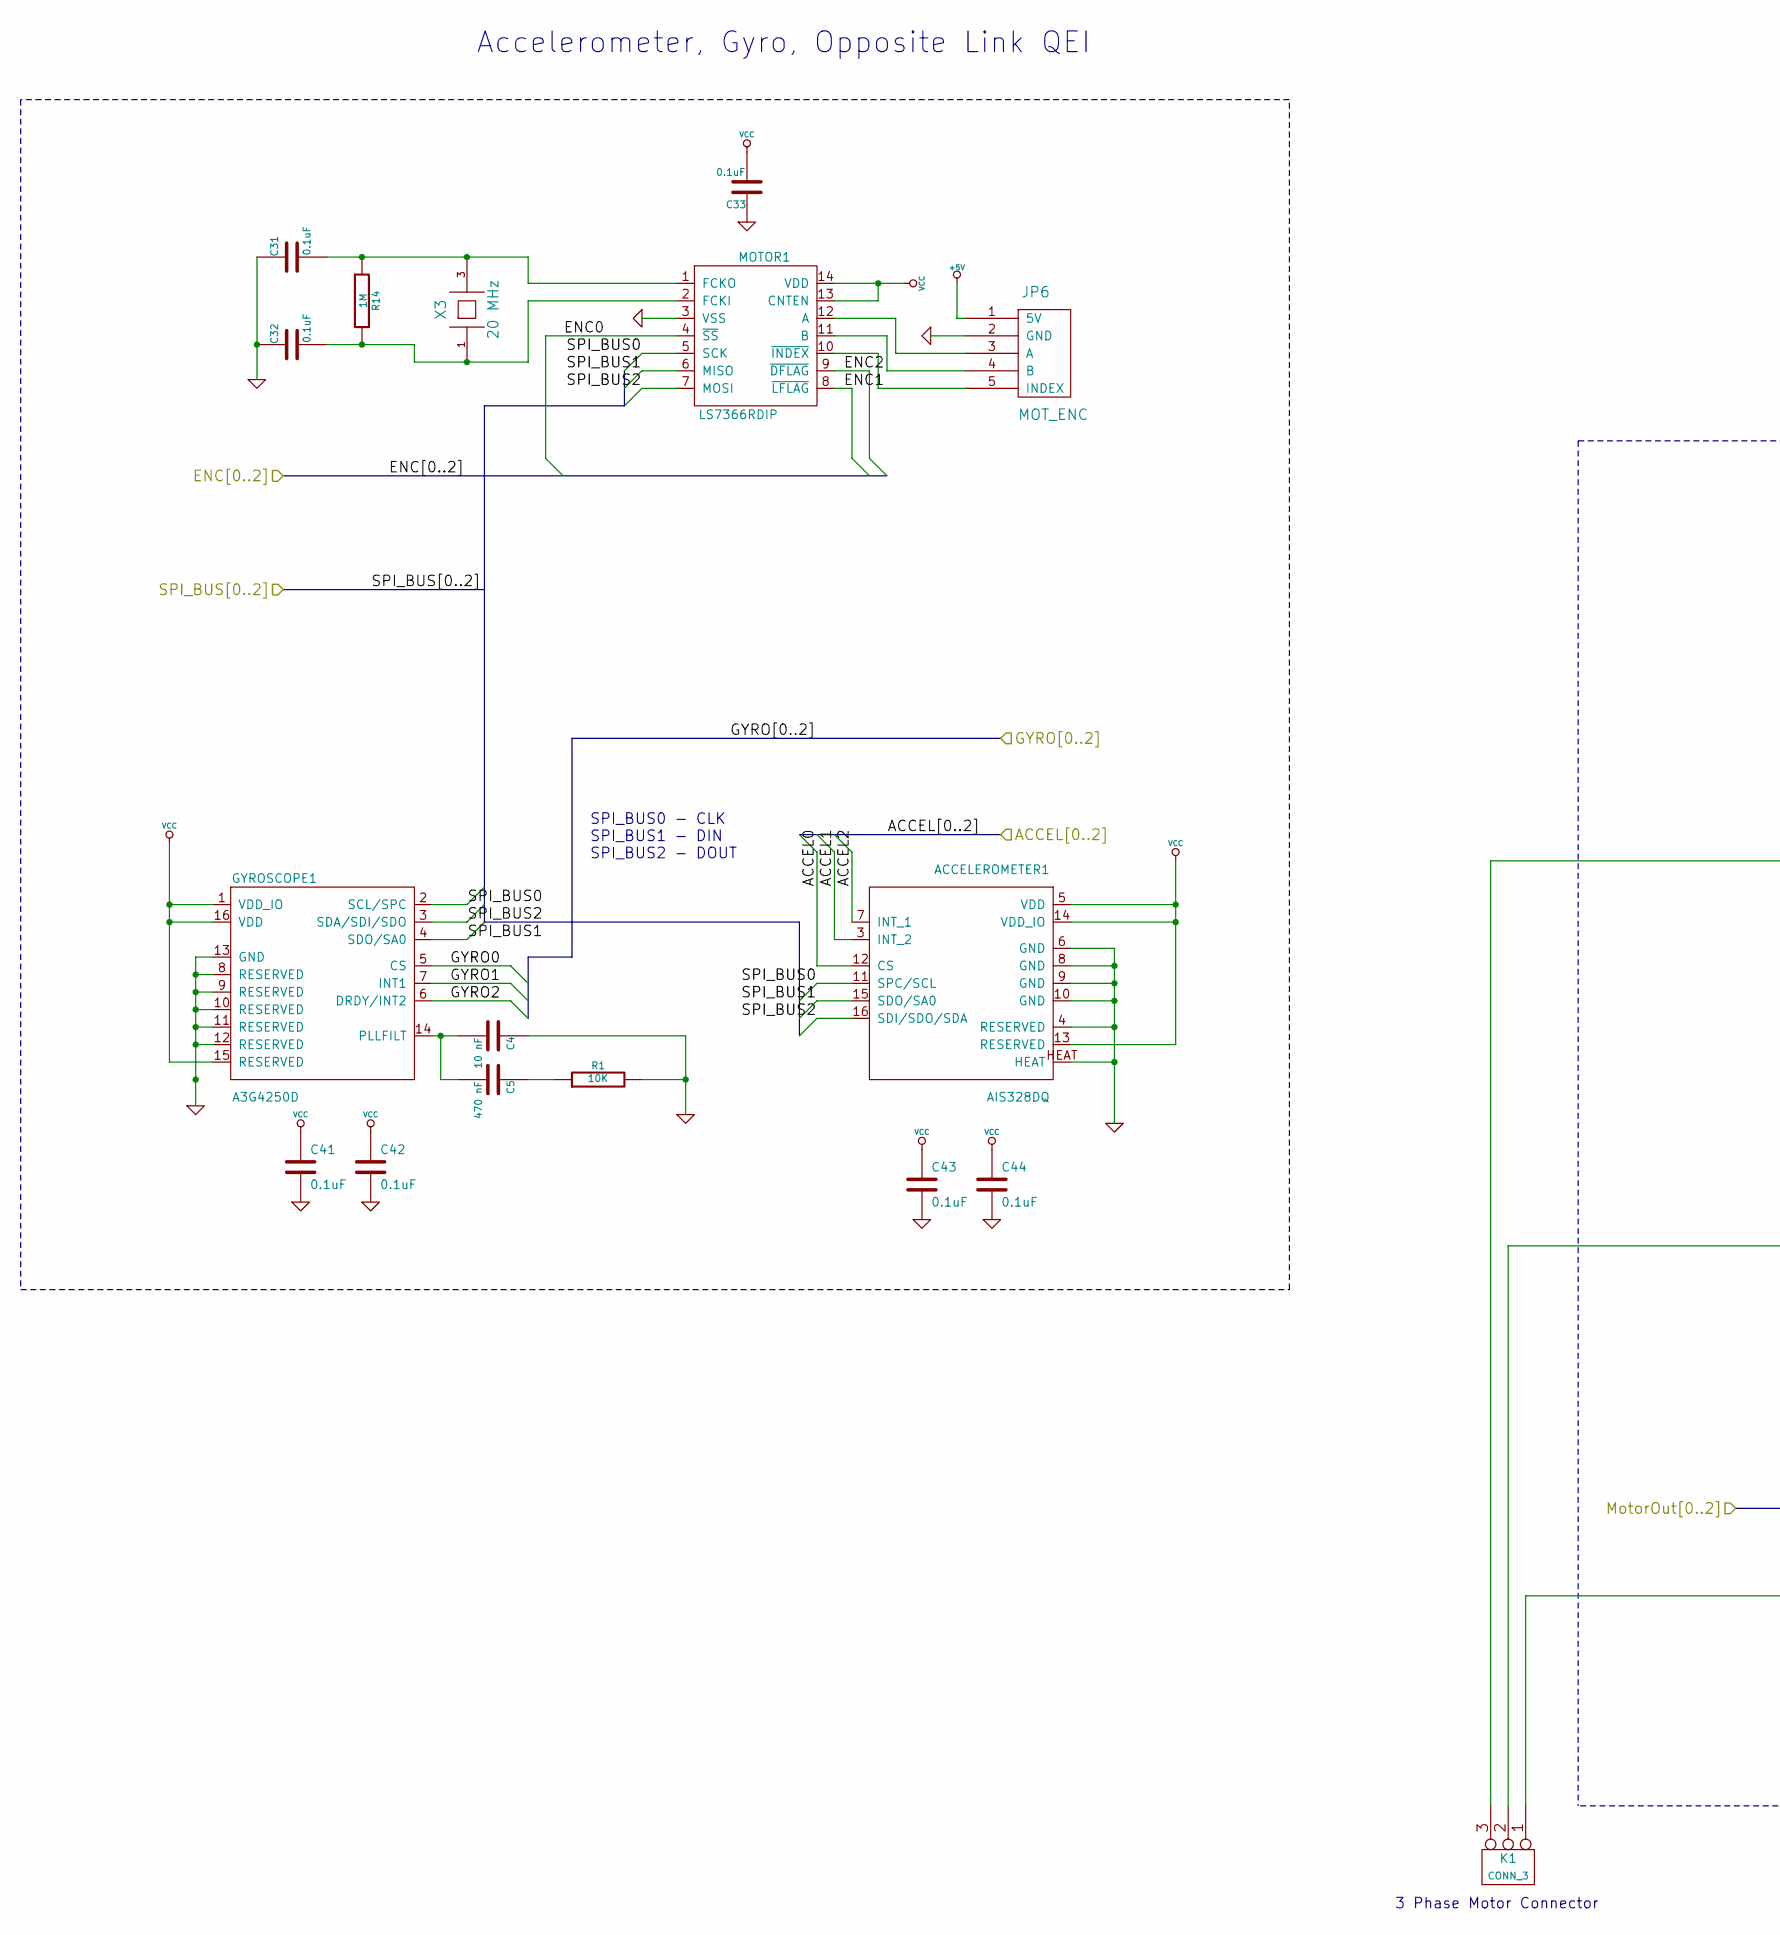
[picture p287: schematic sensors.sch, part in row 1, column 1]

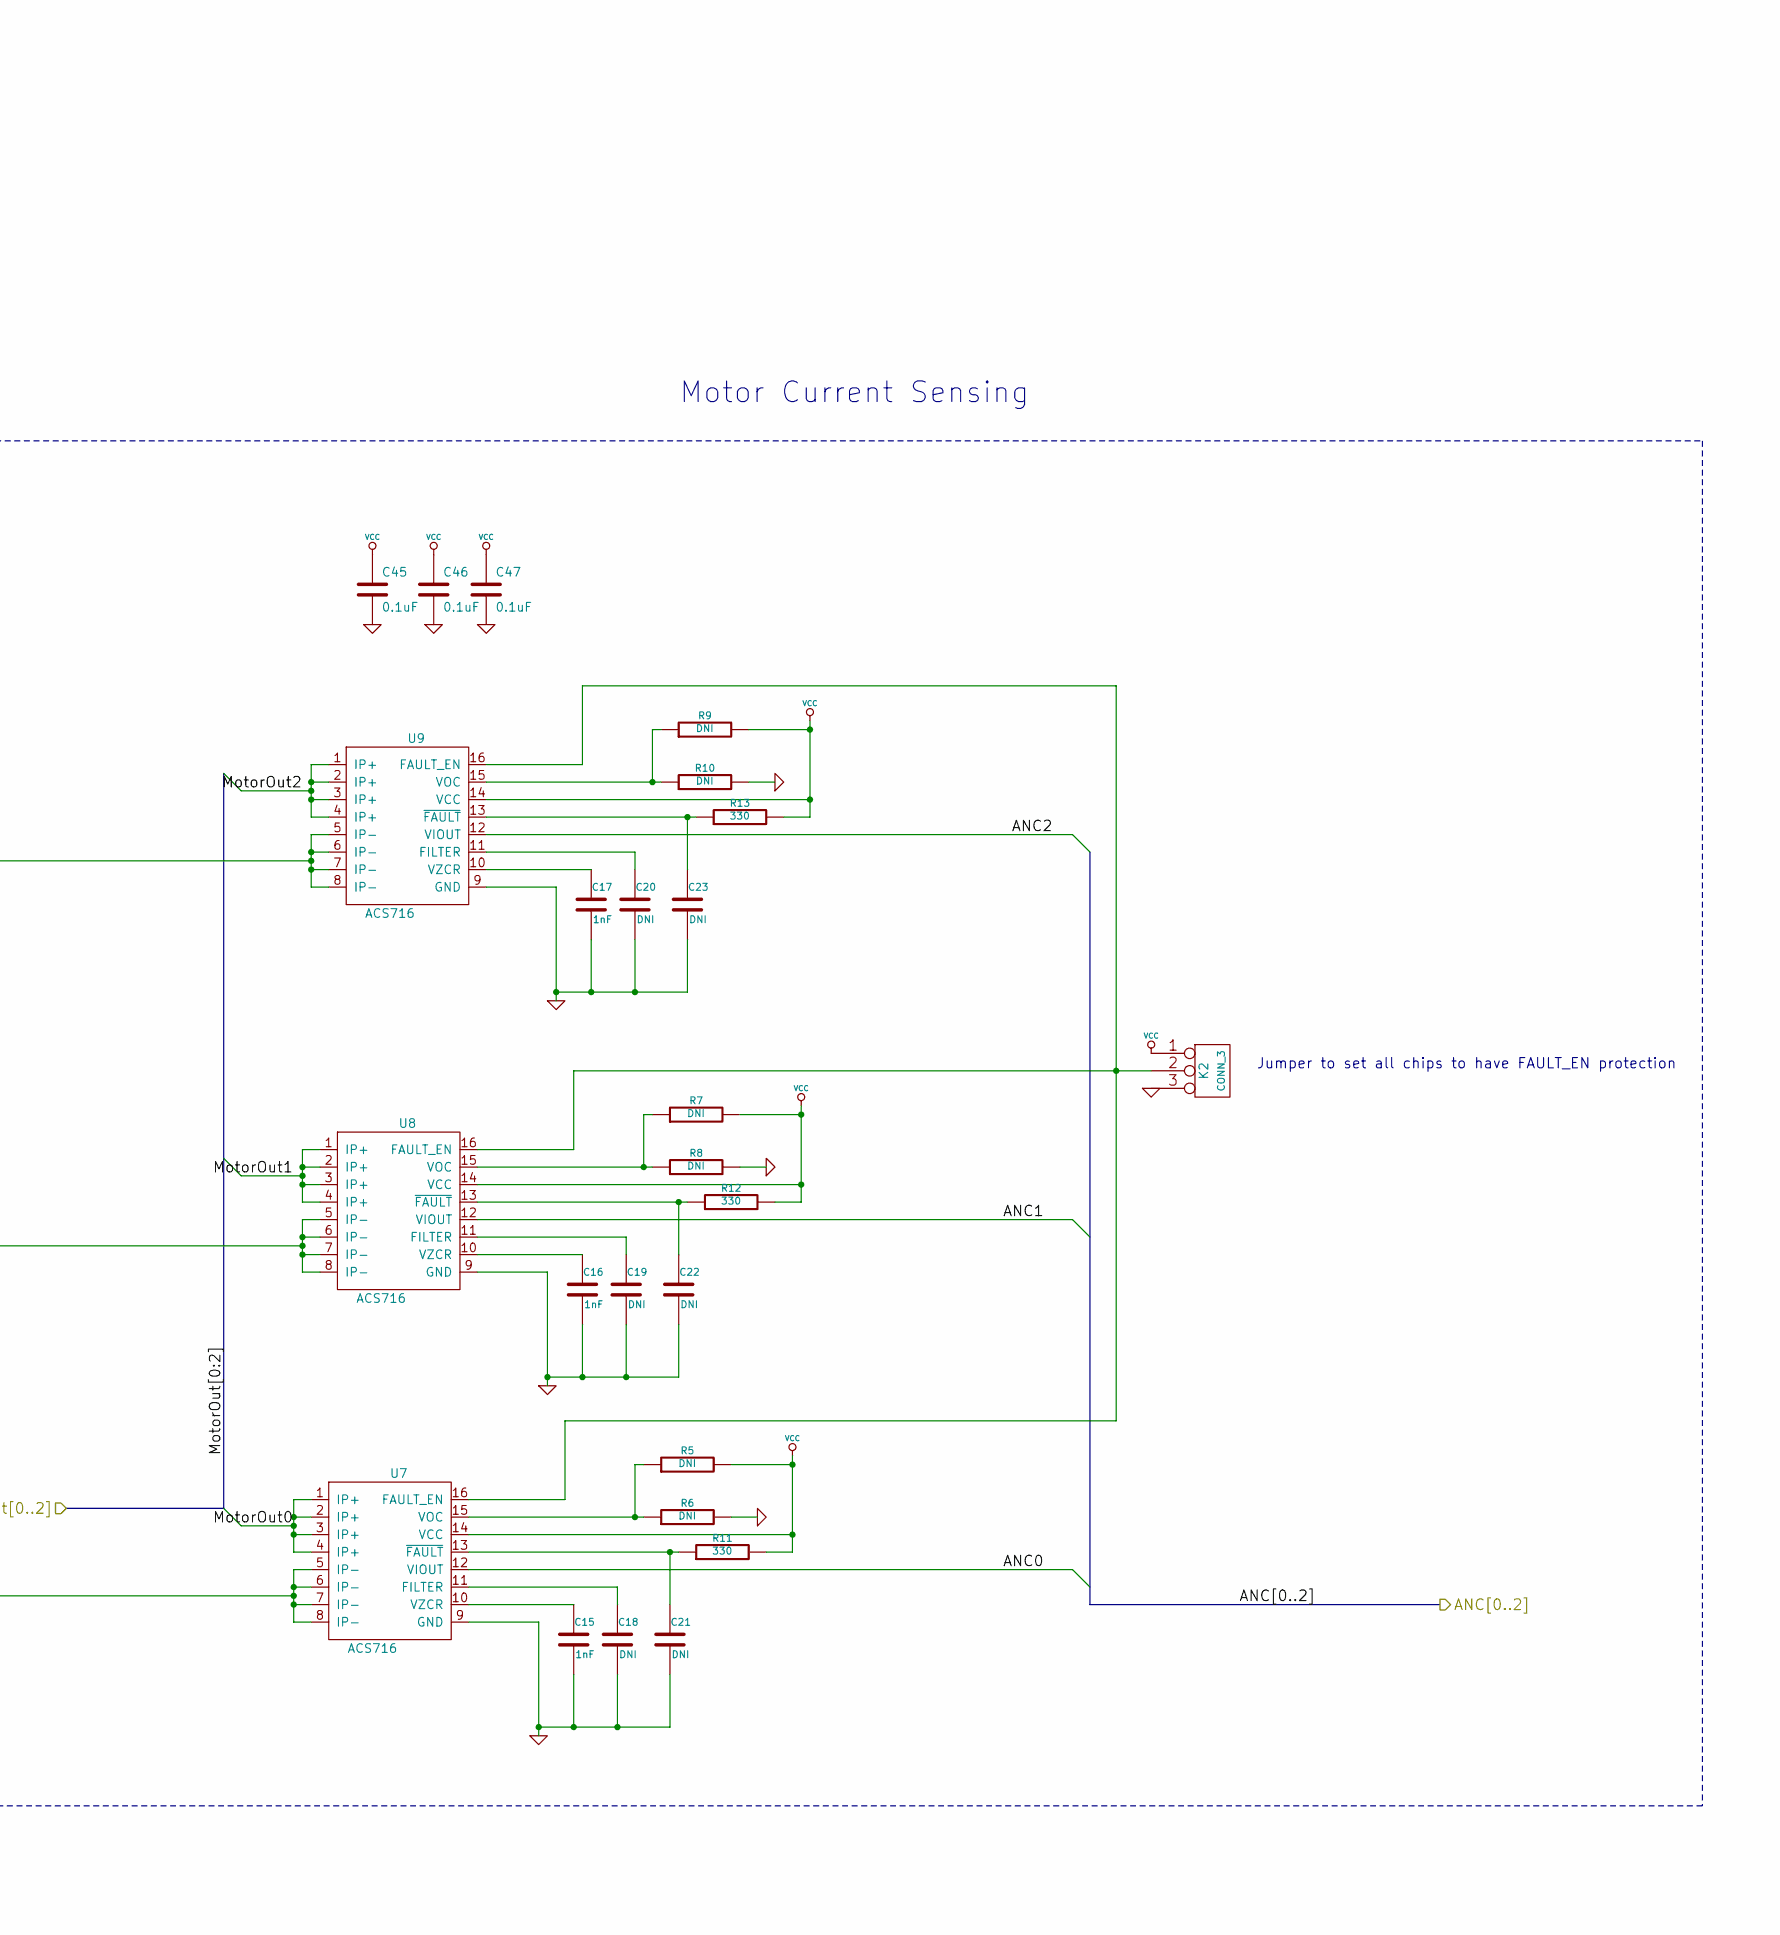
[picture p288: schematic sensors.sch, part in row 1, column 2]

Parts:
ACCELEROMETER1: AIS328DQ
C4: 10 nF
C5: 470 nF
C15, C16, C17: 1nF
C18, C19, C20, C21, C22, C23: DNI
C31, C32, C33: 0.1uF
C41, C42, C43, C44, C45, C46, C47: 0.1uF
GYROSCOPE1: A3G4250D
JP6: MOT_ENC
K1, K2: CONN_3
MOTOR1: LS7366RDIP
R1: 10K
R5, R6, R7, R8, R9, R10: DNI
R11, R12, R13: 330
R14: 1M
U7, U8, U9: ACS716
X3: 20 MHz

Connections:
+5V: JP6.1 (5V); also elsewhere on the board
/ACCEL0: ACCELEROMETER1.12 (CS); also elsewhere on the board
/ACCEL1: ACCELEROMETER1.3 (INT_2); also elsewhere on the board
/ACCEL2: ACCELEROMETER1.7 (INT_1); also elsewhere on the board
/ANC0: U7.12 (VIOUT); also elsewhere on the board
/ANC1: U8.12 (VIOUT); also elsewhere on the board
/ANC2: U9.12 (VIOUT); also elsewhere on the board
/ENC0: MOTOR1.4 (~SS); also elsewhere on the board
/ENC1: MOTOR1.8 (~LFLAG); also elsewhere on the board
/ENC2: MOTOR1.9 (~DFLAG); also elsewhere on the board
/GYRO0: GYROSCOPE1.5 (CS); also elsewhere on the board
/GYRO1: GYROSCOPE1.7 (INT1); also elsewhere on the board
/GYRO2: GYROSCOPE1.6 (DRDY/INT2); also elsewhere on the board
/SPI_BUS0: ACCELEROMETER1.11 (SPC/SCL), GYROSCOPE1.2 (SCL/SPC), MOTOR1.5 (SCK); also elsewhere on the board
/SPI_BUS1: ACCELEROMETER1.15 (SDO/SA0), GYROSCOPE1.4 (SDO/SA0), MOTOR1.6 (MISO); also elsewhere on the board
/SPI_BUS2: ACCELEROMETER1.16 (SDI/SDO/SDA), GYROSCOPE1.3 (SDA/SDI/SDO), MOTOR1.7 (MOSI); also elsewhere on the board
/motor_control/MotorOut0: U7.1 (IP+), U7.2 (IP+), U7.3 (IP+), U7.4 (IP+); also elsewhere on the board
/motor_control/MotorOut1: U8.1 (IP+), U8.2 (IP+), U8.3 (IP+), U8.4 (IP+); also elsewhere on the board
/motor_control/MotorOut2: U9.1 (IP+), U9.2 (IP+), U9.3 (IP+), U9.4 (IP+); also elsewhere on the board
GND: ACCELEROMETER1.4 (RESERVED), ACCELEROMETER1.6 (GND), ACCELEROMETER1.8 (GND), ACCELEROMETER1.9 (GND), ACCELEROMETER1.10 (GND), ACCELEROMETER1.HEAT, C4.1, C15.2, C16.2, C17.2, C18.2, C19.2, C20.2, C21.2, C22.2, C23.2, C31.1, C32.1, C33.1, C41.2, C42.2, C43.2, C44.2, C45.2, C46.2, C47.2, GYROSCOPE1.8 (RESERVED), GYROSCOPE1.9 (RESERVED), GYROSCOPE1.10 (RESERVED), GYROSCOPE1.11 (RESERVED), GYROSCOPE1.12 (RESERVED), GYROSCOPE1.13 (GND), JP6.2 (GND), K2.3, MOTOR1.3 (VSS), R1.2, R6.2, R8.2, R10.2, U7.9 (GND), U8.9 (GND), U9.9 (GND); also elsewhere on the board
unnamed: JP6.5 (INDEX), MOTOR1.10 (~INDEX)
unnamed: JP6.3 (A), MOTOR1.12 (A)
unnamed: JP6.4 (B), MOTOR1.11 (B)
unnamed: C22.1, R12.1, U8.13 (~FAULT)
unnamed: C31.2, MOTOR1.1 (FCKO), R14.1, X3.2, X3.3
unnamed: C32.2, MOTOR1.2 (FCKI), R14.2, X3.1
unnamed: C20.1, U9.11 (FILTER)
unnamed: C5.1, R1.1
unnamed: C4.2, C5.2, GYROSCOPE1.14 (PLLFILT)
unnamed: C17.1, U9.10 (VZCR)
unnamed: K1.1, U7.5 (IP-), U7.6 (IP-), U7.7 (IP-), U7.8 (IP-)
unnamed: C15.1, U7.10 (VZCR)
unnamed: C18.1, U7.11 (FILTER)
unnamed: K1.2 (PM), U8.5 (IP-), U8.6 (IP-), U8.7 (IP-), U8.8 (IP-)
unnamed: C16.1, U8.10 (VZCR)
unnamed: C19.1, U8.11 (FILTER)
unnamed: K2.2 (PM), U7.16 (FAULT_EN), U8.16 (FAULT_EN), U9.16 (FAULT_EN)
unnamed: R9.1, R10.1, U9.15 (VOC)
unnamed: K1.3, U9.5 (IP-), U9.6 (IP-), U9.7 (IP-), U9.8 (IP-)
unnamed: C23.1, R13.1, U9.13 (~FAULT)
unnamed: R5.1, R6.1, U7.15 (VOC)
unnamed: R7.1, R8.1, U8.15 (VOC)
unnamed: C21.1, R11.1, U7.13 (~FAULT)
VCC: ACCELEROMETER1.5 (VDD), ACCELEROMETER1.13 (RESERVED), ACCELEROMETER1.14 (VDD_IO), C33.2, C41.1, C42.1, C43.1, C44.1, C45.1, C46.1, C47.1, GYROSCOPE1.1 (VDD_IO), GYROSCOPE1.15 (RESERVED), GYROSCOPE1.16 (VDD), K2.1, MOTOR1.13 (CNTEN), MOTOR1.14 (VDD), R5.2, R7.2, R9.2, R11.2, R12.2, R13.2, U7.14 (VCC), U8.14 (VCC), U9.14 (VCC); also elsewhere on the board

Notes on the sheet:
3 Phase Motor Connector
Jumper to set all chips to have FAULT_EN protection
Motor Current Sensing
Accelerometer, Gyro, Opposite Link QEI
SPI_BUS0 - CLK SPI_BUS1 - DIN SPI_BUS2 - DOUT
