NxRLab/gibbot/PCB/Gibbot v1/Test.kicad_pcb

## KiCad design PCB/Gibbot v1/Test.kicad_pcb (continued)

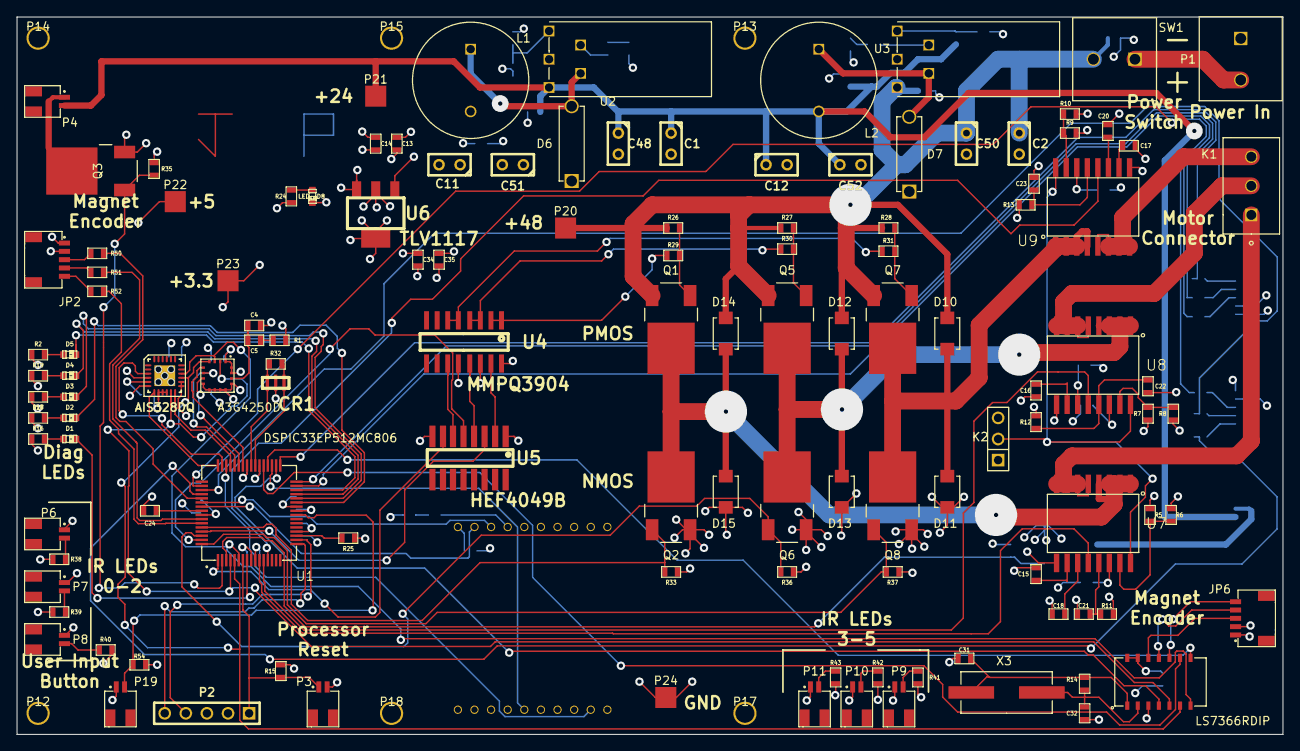
[picture p289: board Test.kicad_pcb from above]

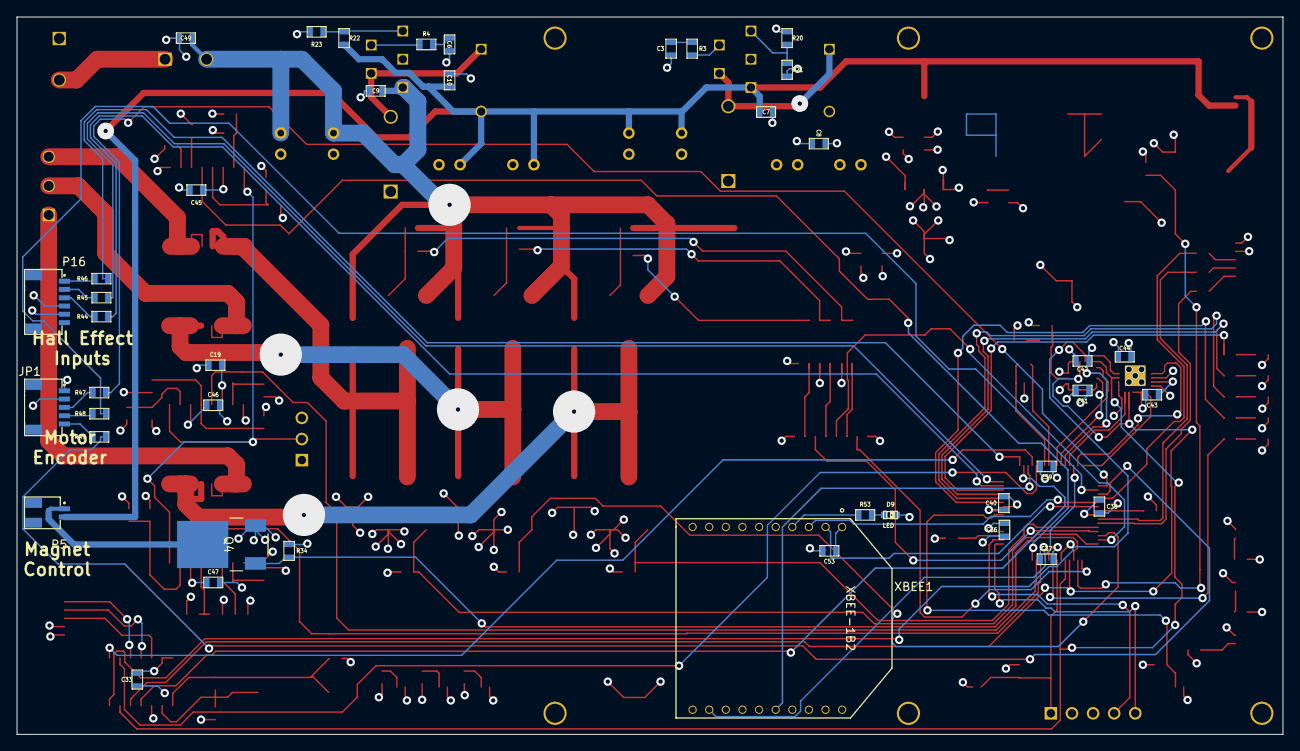
[picture p290: board Test.kicad_pcb from below]

Board: 4 copper layers, 152.4 x 86.4 mm, 171 parts (42 on the bottom side), 123 nets.

Other parts of the board:
U1: DSPIC33EP512MC806; MY_TQFP_64

Their connections:
/ACCEL0: U1.45; also elsewhere on the board
/ACCEL1: U1.47; also elsewhere on the board
/ACCEL2: U1.48; also elsewhere on the board
/ANC0: U1.11; also elsewhere on the board
/ANC1: U1.12; also elsewhere on the board
/ANC2: U1.13; also elsewhere on the board
/CTS: U1.46; also elsewhere on the board
/ENC0: U1.34; also elsewhere on the board
/ENC1: U1.36; also elsewhere on the board
/ENC2: U1.37; also elsewhere on the board
/ENCODER1: U1.50; also elsewhere on the board
/ENCODER2: U1.51; also elsewhere on the board
/ENCODER3: U1.52; also elsewhere on the board
/ENCODER4: U1.53; also elsewhere on the board
/ENCODER5: U1.58; also elsewhere on the board
/ENCODER6: U1.59; also elsewhere on the board
/GYRO0: U1.42; also elsewhere on the board
/GYRO1: U1.43; also elsewhere on the board
/GYRO2: U1.44; also elsewhere on the board
/LED1: U1.8; also elsewhere on the board
/LED2: U1.27; also elsewhere on the board
/LED3: U1.28; also elsewhere on the board
/LED4: U1.29; also elsewhere on the board
/LED5: U1.30; also elsewhere on the board
/MagnetControl0: U1.2; also elsewhere on the board
/MagnetControl1: U1.3; also elsewhere on the board
/MotorControl0: U1.60; also elsewhere on the board
/MotorControl1: U1.61; also elsewhere on the board
/MotorControl2: U1.62; also elsewhere on the board
/MotorControl3: U1.63; also elsewhere on the board
/MotorControl4: U1.64; also elsewhere on the board
/MotorControl5: U1.1; also elsewhere on the board
/RTS: U1.35; also elsewhere on the board
/RX: U1.55; also elsewhere on the board
/SPI_BUS0: U1.4; also elsewhere on the board
/SPI_BUS1: U1.5; also elsewhere on the board
/SPI_BUS2: U1.6; also elsewhere on the board
/TX: U1.54; also elsewhere on the board
GND: U1.9, U1.20, U1.25, U1.41; also elsewhere on the board
unnamed 48: U1.31; also elsewhere on the board
unnamed 49: U1.33; also elsewhere on the board
unnamed 50: U1.32; also elsewhere on the board
unnamed 51: U1.40; also elsewhere on the board
unnamed 52: U1.24; also elsewhere on the board
unnamed 54: U1.39; also elsewhere on the board
unnamed 63: U1.17; also elsewhere on the board
unnamed 64: U1.18; also elsewhere on the board
unnamed 71: U1.7; also elsewhere on the board
unnamed 82: U1.19; also elsewhere on the board
unnamed 83: U1.56; also elsewhere on the board
VCC: U1.10, U1.26, U1.38, U1.57; also elsewhere on the board
