NxRLab/gibbot/PCB/Gibbot v1/Motor & Magnet PCB/MotorMagnet.kicad_pcb

## KiCad design PCB/Gibbot v1/Motor & Magnet PCB/MotorMagnet.kicad_pcb (2013-07-05, an earlier design)

Schematic: MotorMagnet PCB.sch

Parts:
C2: 10uF
C5: 0.1uF
C15, C16, C17: 1nF
C18, C19, C20, C21, C22, C23: DNI
C45, C46, C47: 0.1nF
Current1, Current2, Current3: ACS716
D1: ZENER 24V
D2: ZENER 12V
D3: ZENER 5.1V
J1: BREADBOARD_HEADER_L
J2: JP5
J3: BREADBOARD_HEADER_R
K1, K2: CONN_3
LED1: D
P1: CONN_6
R1: 2.2k
R2, R17: R
R3: 360
R4: 30
R5, R6, R7, R8, R9, R10: DNI
R11, R12, R13: 330
R14, R15, R16: 2.2K
U$11: DSPIC33FJ12MC202
XBEE1: XBEE-1B2

Connections:
+5V: P1.5, R14.2, R15.2, R16.1
/MotorOut0: Current1.1 (IP+), Current1.2 (IP+), Current1.3 (IP+), Current1.4 (IP+), Current2.1 (IP+), Current2.2 (IP+), Current2.3 (IP+), Current2.4 (IP+), Current3.1 (IP+), Current3.2 (IP+), Current3.3 (IP+), Current3.4 (IP+)
/PGC: J1.12, J2.5, U$11.12
/PGD: J1.11, J2.4, U$11.11
/PMCLR: J1.1, J2.1, R1.1, U$11.1
/PVCAP: C2.1, J3.6, U$11.20
/PVDD: C5.1, J1.13, J2.2, R1.2, U$11.13
/PVSS: C2.2, C5.2, J1.8, J2.3, J3.5, U$11.8, U$11.19
GND: C15.2, C16.2, C17.2, C18.2, C19.2, C20.2, C21.2, C22.2, C23.2, C45.2, C46.2, C47.2, Current1.9 (GND), Current2.9 (GND), Current3.9 (GND), D1.1 (A), D2.1 (A), D3.1 (A), K2.3, LED1.2 (K), P1.4, R6.1, R8.1, R10.1, XBEE1.10 (GND)
unnamed: J1.2, U$11.2
unnamed: J1.3, U$11.3
unnamed: J1.4, U$11.4
unnamed: R17.2, XBEE1.4 (DIO8)
unnamed: J1.10, U$11.10
unnamed: J1.9, U$11.9
unnamed: Current3.5 (IP-), Current3.6 (IP-), Current3.7 (IP-), Current3.8 (IP-), K1.1
unnamed: LED1.1 (A), R17.1
unnamed: J3.10, U$11.24
unnamed: J3.11, U$11.25
unnamed: J3.12, U$11.26
unnamed: J3.13, U$11.27
unnamed: J3.14, U$11.28
unnamed: J1.14, U$11.14, XBEE1.3 (DIN/~CONFIG)
unnamed: J3.1, U$11.15, XBEE1.2 (DOUT)
unnamed: J3.7, U$11.21
unnamed: J3.8, U$11.22
unnamed: J3.9, U$11.23
unnamed: J3.4, P1.1, R16.2, U$11.18
unnamed: Current1.15 (VOC), R7.2, R8.2
unnamed: C22.1, Current1.13 (~FAULT), R12.2
unnamed: Current1.16 (FAULT_EN), Current2.16 (FAULT_EN), Current3.16 (FAULT_EN), K2.2 (PM)
unnamed: C15.1, Current2.10 (VZCR)
unnamed: C18.1, Current2.11 (FILTER)
unnamed: C21.1, Current2.13 (~FAULT), R11.2
unnamed: Current1.5 (IP-), Current1.6 (IP-), Current1.7 (IP-), Current1.8 (IP-), K1.2 (PM)
unnamed: Current2.5 (IP-), Current2.6 (IP-), Current2.7 (IP-), Current2.8 (IP-), K1.3
unnamed: C23.1, Current3.13 (~FAULT), R13.2
unnamed: Current3.12 (VIOUT), J1.5, U$11.5
unnamed: C16.1, Current1.10 (VZCR)
unnamed: C19.1, Current1.11 (FILTER)
unnamed: C20.1, Current3.11 (FILTER)
unnamed: Current2.15 (VOC), R5.2, R6.2
unnamed: C17.1, Current3.10 (VZCR)
unnamed: D3.2 (K), R4.2
unnamed: J3.3, P1.2, R15.1, U$11.17
unnamed: D1.2 (K), R2.2
unnamed: D2.2 (K), R3.2
unnamed: Current1.12 (VIOUT), J1.6, U$11.6
unnamed: Current2.12 (VIOUT), J1.7, U$11.7
unnamed: J3.2, P1.3, R14.1, U$11.16
unnamed: Current3.15 (VOC), R9.2, R10.2
VCC: C45.1, C46.1, C47.1, Current1.14 (VCC), Current2.14 (VCC), Current3.14 (VCC), K2.1, R5.1, R7.1, R9.1, R11.1, R12.1, R13.1, XBEE1.1 (VDD)

Notes on the sheet:
Status LED
Hall Effect Connector
MotorOut[0..2]
3 Phase Motor Connector
Jumper to set all chips to have FAULT_EN protection
5.1V
12V
24V

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
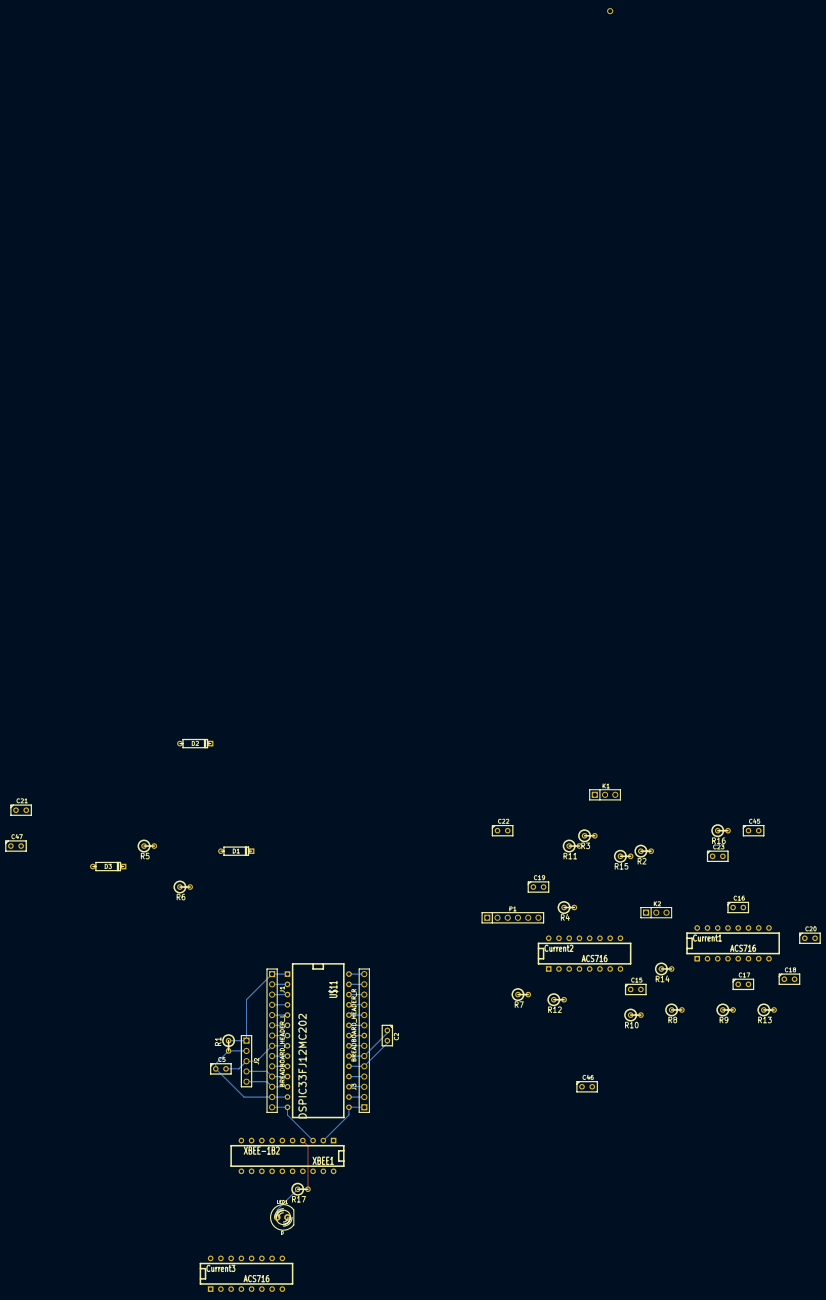
[picture p291: board MotorMagnet.kicad_pcb from above]

Board: 2 copper layers, 46 parts (0 on the bottom side), 53 nets.
