NxRLab/gibbot/PCB/Gibbot v1/Test Parts PCB/test_parts.brd

## EAGLE design PCB/Gibbot v1/Test Parts PCB/test_parts.brd (2013-04-03, an earlier design)

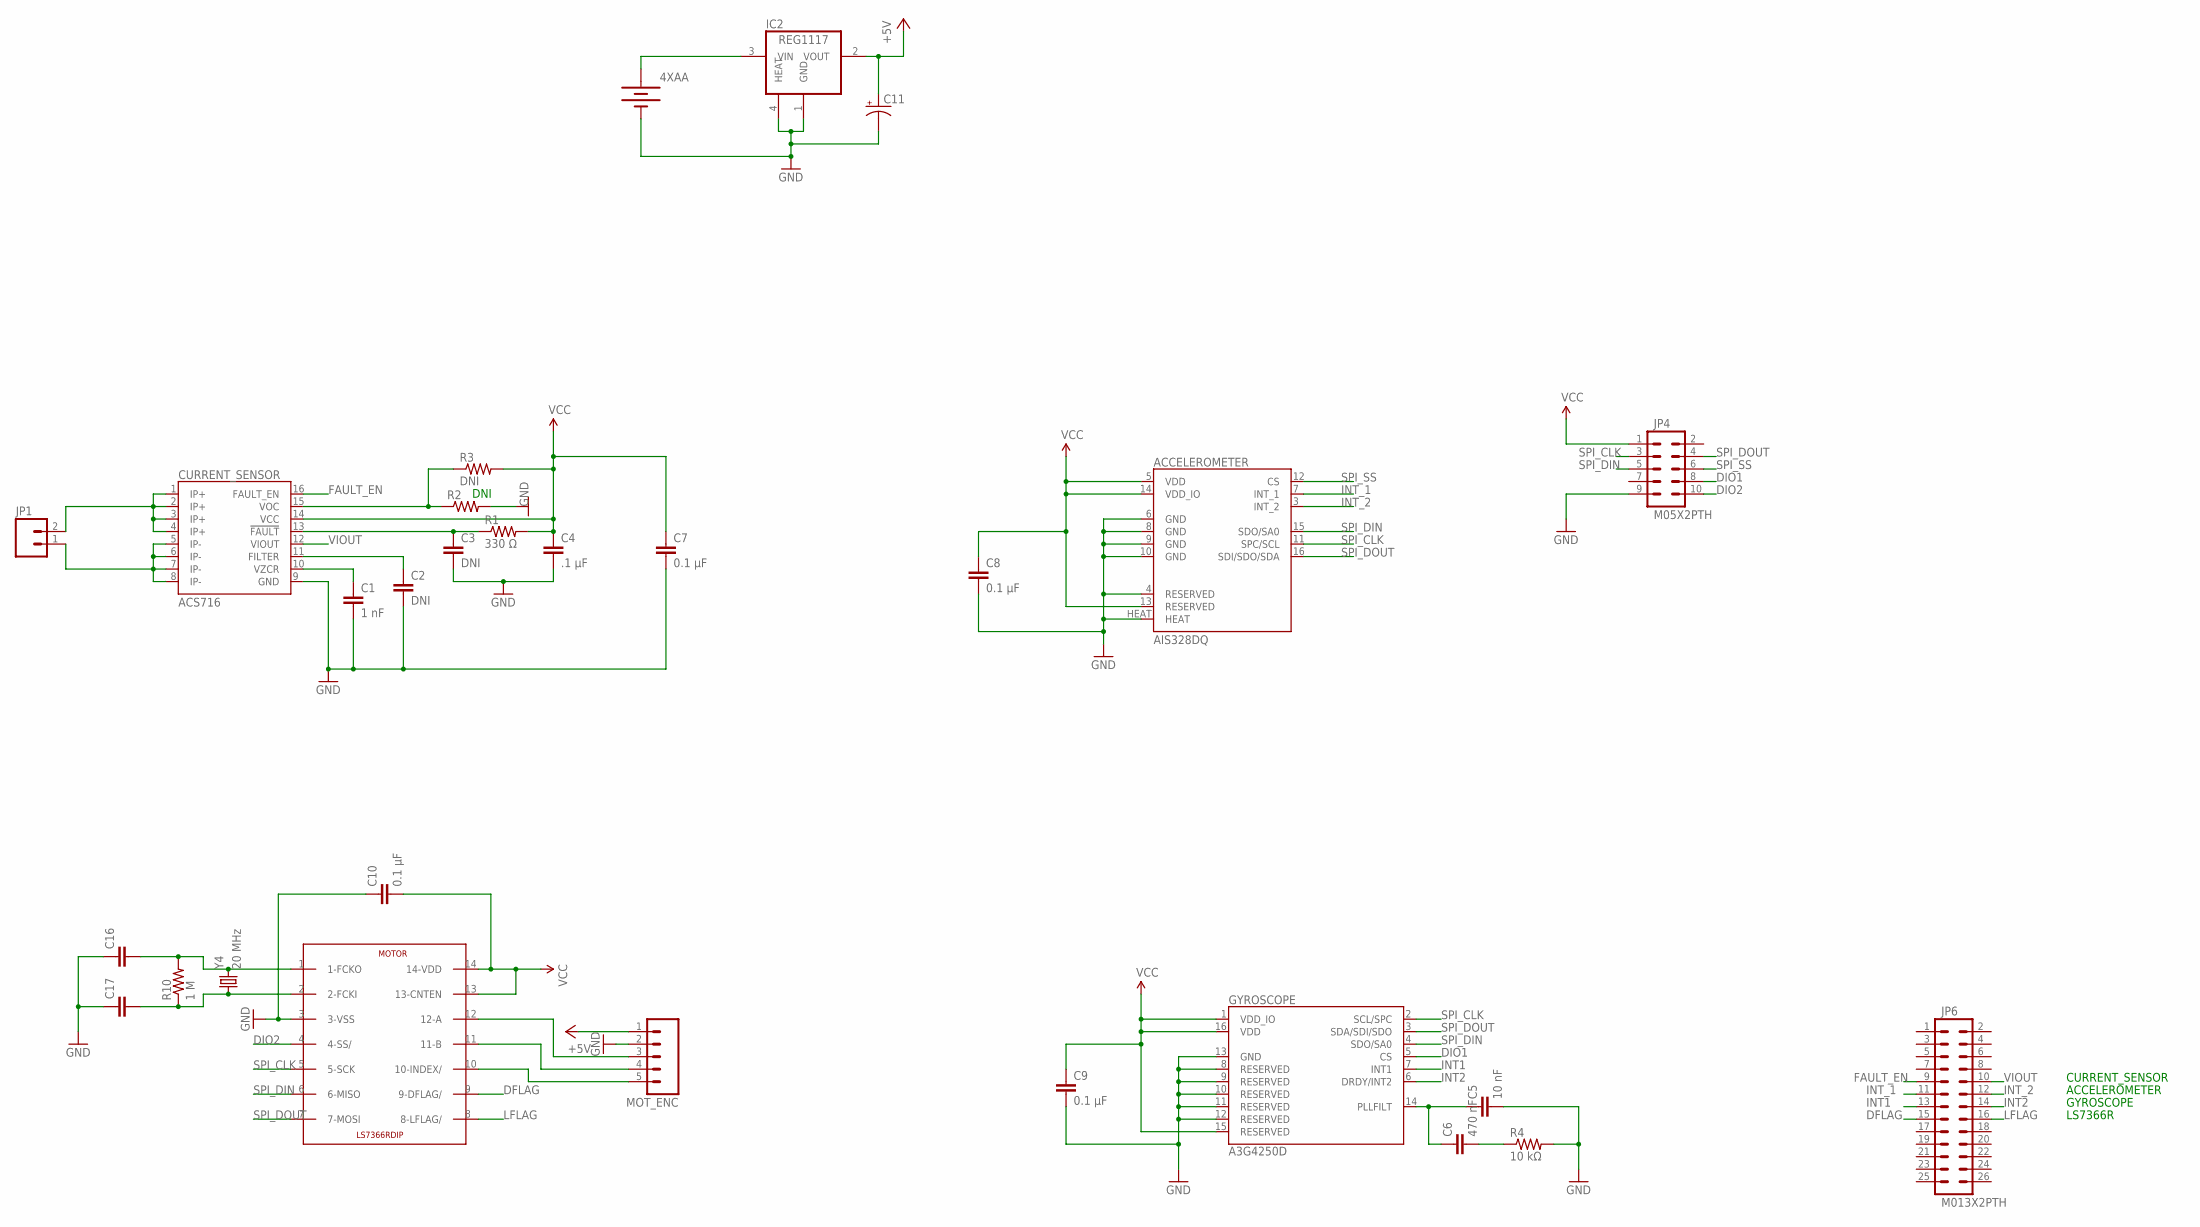
[picture p292: schematic test_parts.sch]

Parts:
4XAA: BATTERYTOP; BH4AA-PC
ACCELEROMETER: AIS328DQ; QFPN-24
C1: 1 nF; 0603-CAP
C2, C3: DNI; 0603-CAP
C4: .1 µF; 0603-CAP
C5: 10 nF; 0603-CAP
C6: 470 nF; 0603-CAP
C7, C8, C9, C10: 0.1 µF; 0603-CAP
C11: CAP_POL0603; 0603-CAP
C16, C17: CAP0603-CAP; 0603-CAP
CURRENT_SENSOR: ACS716; SOICW
GYROSCOPE: A3G4250D; LGA-16
IC2: REG1117; SOT223
JP1: M02PTH; 1X02
JP4: M05X2PTH; AVR_ICSP
JP6: M013X2PTH; AVR_ICSP
MOTOR: LS7366RDIP; DIL14
MOT_ENC: M05PTH; 1X05
R1: 330 Ω; 0603-RES
R2, R3: DNI; 0603-RES
R4: 10 kΩ; 0603-RES
R10: 1 M; R0603
Y4: 20 MHz; HC49US

Connections:
+5V: C11.1 (+), IC2.2 (VOUT), MOT_ENC.1
DFLAG: JP6.15, MOTOR.9 (9-DFLAG/)
DIO1: GYROSCOPE.5 (CS), JP4.8
DIO2: JP4.10, MOTOR.4 (4-SS/)
FAULT_EN: CURRENT_SENSOR.16 (FAULT_EN), JP6.9
GND: 4XAA.-, ACCELEROMETER.4 (RESERVED), ACCELEROMETER.6 (GND), ACCELEROMETER.8 (GND), ACCELEROMETER.9 (GND), ACCELEROMETER.10 (GND), ACCELEROMETER.HEAT, C1.2, C2.2, C3.2, C4.2, C5.2, C7.2, C8.2, C9.2, C10.1, C11.2 (-), C16.1, C17.1, CURRENT_SENSOR.9 (GND), GYROSCOPE.8 (RESERVED), GYROSCOPE.9 (RESERVED), GYROSCOPE.10 (RESERVED), GYROSCOPE.11 (RESERVED), GYROSCOPE.12 (RESERVED), GYROSCOPE.13 (GND), IC2.1 (GND), IC2.4 (HEAT), JP4.9, MOTOR.3 (3-VSS), MOT_ENC.2, R2.2, R4.2
INT1: GYROSCOPE.7 (INT1), JP6.13
INT2: GYROSCOPE.6 (DRDY/INT2), JP6.14
INT_1: ACCELEROMETER.7 (INT_1), JP6.11
INT_2: ACCELEROMETER.3 (INT_2), JP6.12
LFLAG: JP6.16, MOTOR.8 (8-LFLAG/)
unnamed: CURRENT_SENSOR.1 (IP+), CURRENT_SENSOR.2 (IP+), CURRENT_SENSOR.3 (IP+), CURRENT_SENSOR.4 (IP+), JP1.2
unnamed: CURRENT_SENSOR.5 (IP-), CURRENT_SENSOR.6 (IP-), CURRENT_SENSOR.7 (IP-), CURRENT_SENSOR.8 (IP-), JP1.1
unnamed: C3.1, CURRENT_SENSOR.13 (!FAULT), R1.1
unnamed: C1.1, CURRENT_SENSOR.10 (VZCR)
unnamed: C2.1, CURRENT_SENSOR.11 (FILTER)
unnamed: 4XAA.+, IC2.3 (VIN)
unnamed: CURRENT_SENSOR.15 (VOC), R2.1, R3.1
unnamed: C5.1, C6.1, GYROSCOPE.14 (PLLFILT)
unnamed: C6.2, R4.1
unnamed: C16.2, MOTOR.1 (1-FCKO), R10.2, Y4.2
unnamed: C17.2, MOTOR.2 (2-FCKI), R10.1, Y4.1
unnamed: MOTOR.12 (12-A), MOT_ENC.3
unnamed: MOTOR.11 (11-B), MOT_ENC.4
unnamed: MOTOR.10 (10-INDEX/), MOT_ENC.5
SPI_CLK: ACCELEROMETER.11 (SPC/SCL), GYROSCOPE.2 (SCL/SPC), JP4.3, MOTOR.5 (5-SCK)
SPI_DIN: ACCELEROMETER.15 (SDO/SA0), GYROSCOPE.4 (SDO/SA0), JP4.5, MOTOR.6 (6-MISO)
SPI_DOUT: ACCELEROMETER.16 (SDI/SDO/SDA), GYROSCOPE.3 (SDA/SDI/SDO), JP4.4, MOTOR.7 (7-MOSI)
SPI_SS: ACCELEROMETER.12 (CS), JP4.6
VCC: ACCELEROMETER.5 (VDD), ACCELEROMETER.13 (RESERVED), ACCELEROMETER.14 (VDD_IO), C4.1, C7.1, C8.1, C9.1, C10.2, CURRENT_SENSOR.14 (VCC), GYROSCOPE.1 (VDD_IO), GYROSCOPE.15 (RESERVED), GYROSCOPE.16 (VDD), JP4.1, MOTOR.13 (13-CNTEN), MOTOR.14 (14-VDD), R1.2, R3.2
VIOUT: CURRENT_SENSOR.12 (VIOUT), JP6.10

Notes on the sheet:
CURRENT_SENSOR
ACCELEROMETER
GYROSCOPE
LS7366R

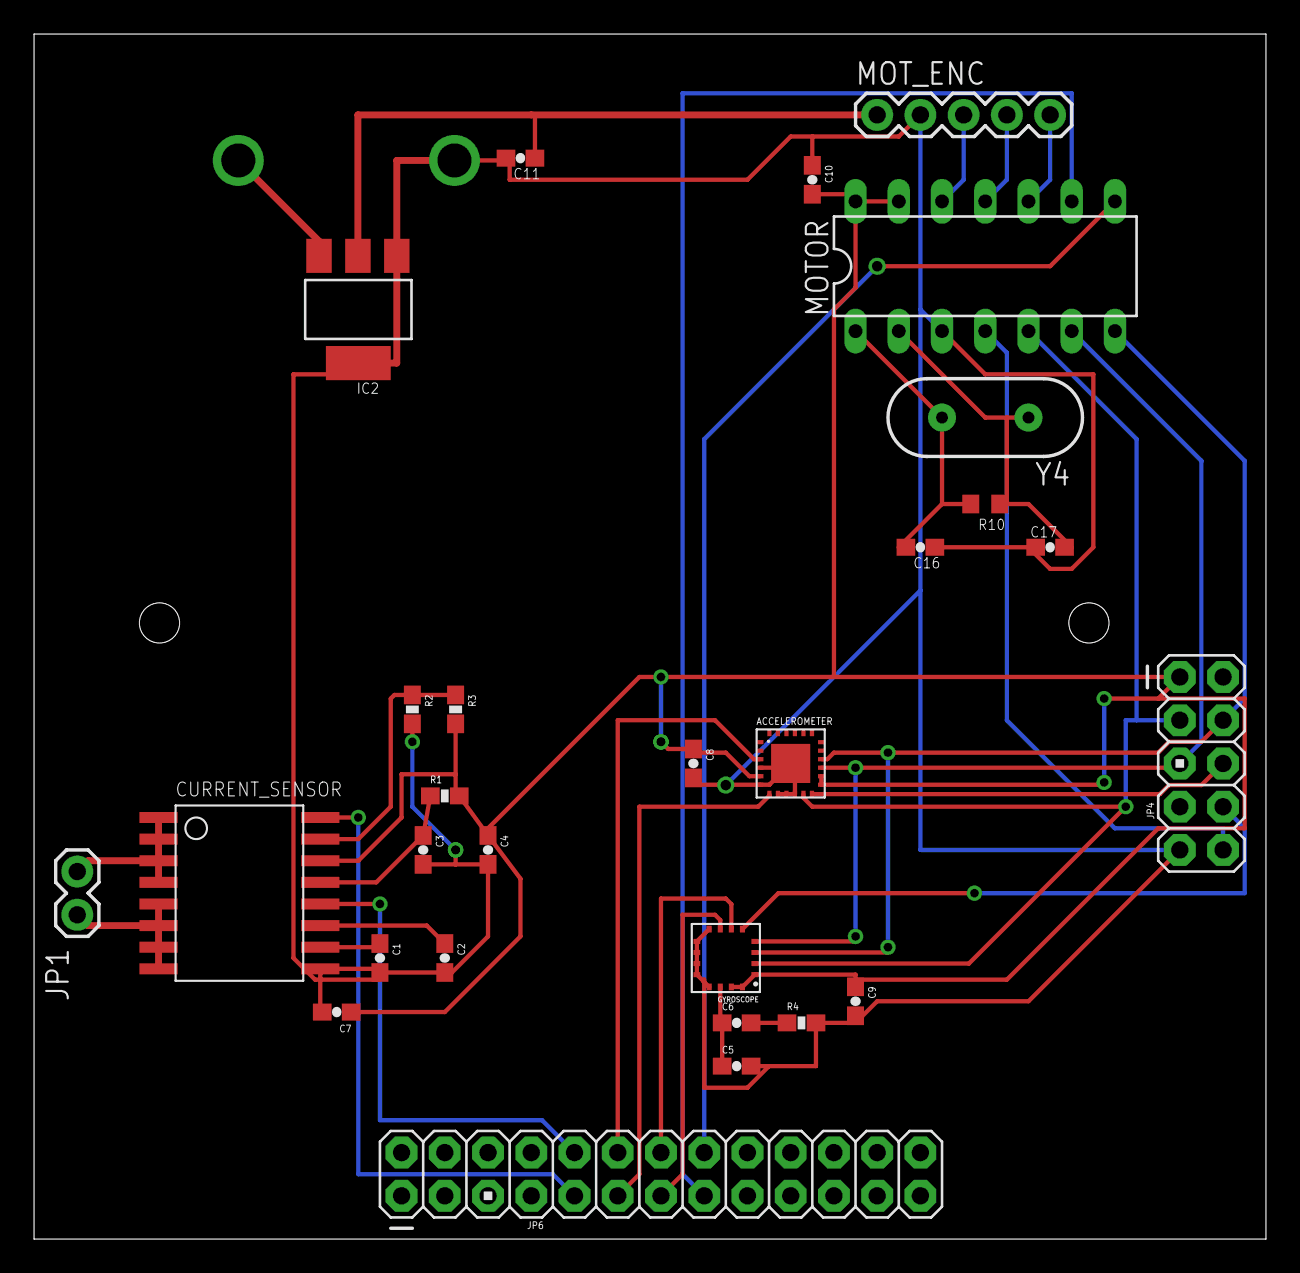
[picture p293: board test_parts.brd from above]

Board: 2 copper layers, 72.4 x 70.8 mm, 29 parts (1 on the bottom side), 31 nets.
