NxRLab/gibbot/PCB/Battery Manager/Battery Manager.X/main.c

/* 
 * File:   main.c
 * Author: ryanyu
 *
 * Created on June 8, 2015, 5:05 PM
 */

#include <stdio.h>
#include <stdlib.h>
#include<xc.h>
#include<sys/attribs.h>
#include "BMspi.h"


#pragma config DEBUG = OFF // no debugging
#pragma config JTAGEN = OFF // no jtag
#pragma config ICESEL = ICS_PGx1 // use PGED1 and PGEC1
#pragma config PWP = OFF // no write protect
#pragma config BWP = OFF // not boot write protect
#pragma config CP = OFF // no code protect

// DEVCFG1
#pragma config FNOSC = PRIPLL // use primary oscillator with pll
#pragma config FSOSCEN = OFF // turn off secondary oscillator
#pragma config IESO = OFF // no switching clocks
#pragma config POSCMOD = HS // high speed crystal mode
#pragma config OSCIOFNC = OFF // free up secondary osc pins
#pragma config FPBDIV = DIV_1 // divide CPU freq by 1 for peripheral bus clock
#pragma config FCKSM = CSDCMD // do not enable clock switch
#pragma config WDTPS = PS1048576 // slowest wdt
#pragma config WINDIS = OFF // no wdt window
#pragma config FWDTEN = OFF // wdt off by default
#pragma config FWDTWINSZ = WISZ_25 // wdt window at 25%

// DEVCFG2 - get the CPU clock to 40MHz
#pragma config FPLLIDIV = DIV_2 // divide input clock to be in range 4-5MHz
#pragma config FPLLMUL = MUL_20 // multiply clock after FPLLIDIV
#pragma config FPLLODIV = DIV_2 // divide clock after FPLLMUL to get 40MHz
#pragma config UPLLIDIV = DIV_2 // divide 8MHz input clock, then multiply by 12 to get 48MHz for USB
#pragma config UPLLEN = ON // USB clock on

// DEVCFG3
#pragma config USERID = 0 // some 16bit userid
#pragma config PMDL1WAY = ON // not multiple reconfiguration, check this
#pragma config IOL1WAY = ON // not multimple reconfiguration, check this
#pragma config FUSBIDIO = ON // USB pins controlled by USB module
#pragma config FVBUSONIO = ON // controlled by USB module
/*
 * 
 */

int oledprint(int printcol, int printrow, char asciimessage[]);

short reg;

char message[100];

char buff[500];

// lookup table for all of the ascii characters
static const char ASCII[96][5] = {
 {0x00, 0x00, 0x00, 0x00, 0x00} // 20  (space)
,{0x00, 0x00, 0x5f, 0x00, 0x00} // 21 !
,{0x00, 0x07, 0x00, 0x07, 0x00} // 22 "
,{0x14, 0x7f, 0x14, 0x7f, 0x14} // 23 #
,{0x24, 0x2a, 0x7f, 0x2a, 0x12} // 24 $
,{0x23, 0x13, 0x08, 0x64, 0x62} // 25 %
,{0x36, 0x49, 0x55, 0x22, 0x50} // 26 &
,{0x00, 0x05, 0x03, 0x00, 0x00} // 27 '
,{0x00, 0x1c, 0x22, 0x41, 0x00} // 28 (
,{0x00, 0x41, 0x22, 0x1c, 0x00} // 29 )
,{0x14, 0x08, 0x3e, 0x08, 0x14} // 2a *
,{0x08, 0x08, 0x3e, 0x08, 0x08} // 2b +
,{0x00, 0x50, 0x30, 0x00, 0x00} // 2c ,
,{0x08, 0x08, 0x08, 0x08, 0x08} // 2d -
,{0x00, 0x60, 0x60, 0x00, 0x00} // 2e .
,{0x20, 0x10, 0x08, 0x04, 0x02} // 2f /
,{0x3e, 0x51, 0x49, 0x45, 0x3e} // 30 0
,{0x00, 0x42, 0x7f, 0x40, 0x00} // 31 1
,{0x42, 0x61, 0x51, 0x49, 0x46} // 32 2
,{0x21, 0x41, 0x45, 0x4b, 0x31} // 33 3
,{0x18, 0x14, 0x12, 0x7f, 0x10} // 34 4
,{0x27, 0x45, 0x45, 0x45, 0x39} // 35 5
,{0x3c, 0x4a, 0x49, 0x49, 0x30} // 36 6
,{0x01, 0x71, 0x09, 0x05, 0x03} // 37 7
,{0x36, 0x49, 0x49, 0x49, 0x36} // 38 8
,{0x06, 0x49, 0x49, 0x29, 0x1e} // 39 9
,{0x00, 0x36, 0x36, 0x00, 0x00} // 3a :
,{0x00, 0x56, 0x36, 0x00, 0x00} // 3b ;
,{0x08, 0x14, 0x22, 0x41, 0x00} // 3c <
,{0x14, 0x14, 0x14, 0x14, 0x14} // 3d =
,{0x00, 0x41, 0x22, 0x14, 0x08} // 3e >
,{0x02, 0x01, 0x51, 0x09, 0x06} // 3f ?
,{0x32, 0x49, 0x79, 0x41, 0x3e} // 40 @
,{0x7e, 0x11, 0x11, 0x11, 0x7e} // 41 A
,{0x7f, 0x49, 0x49, 0x49, 0x36} // 42 B
,{0x3e, 0x41, 0x41, 0x41, 0x22} // 43 C
,{0x7f, 0x41, 0x41, 0x22, 0x1c} // 44 D
,{0x7f, 0x49, 0x49, 0x49, 0x41} // 45 E
,{0x7f, 0x09, 0x09, 0x09, 0x01} // 46 F
,{0x3e, 0x41, 0x49, 0x49, 0x7a} // 47 G
,{0x7f, 0x08, 0x08, 0x08, 0x7f} // 48 H
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
}; // end char ASCII[96][5]

int main() {

    BM_setup();

    display_clear();
    acc_write_register(0x00,0x04,(unsigned char *) buff,2);
    sprintf(message,"%d%d",buff[1],buff[2]);
    oledprint(1,10,message);
    display_draw();

//    while (1) {
//
//        display_clear();
//
//        acc_write_register(RDCVA, buff);
//
//        sprintf(buff,"Message: ",data);
//
//        oledprint(1,10,buff);
//        display_draw();
//    }
}

int oledprint(int printcol, int printrow, char asciimessage[]) {
    int i = 0;
    int asciicol;
    int asciirow;
    int bitnum;
    while (asciimessage[i]) {
        asciirow = asciimessage[i] - 0x20;
        for (asciicol=0; asciicol<5; asciicol++) {
            int asciibyte = ASCII[asciirow][asciicol];
            for (bitnum=0; bitnum<8; bitnum++) {
                int asciibit = asciibyte >> bitnum;
                int onoff = asciibit & 0b1;
                display_pixel_set(printrow+bitnum, printcol, onoff);
            }
            printcol = printcol+1;
        }
        i++;
    }
}
