NxRLab/gibbot/Code/PIC_Projects/dsPIC/dsPIC33MotorCharacterization.X/main.c

#include <stdio.h>
#include <stdlib.h>
#include <p33Fxxxx.h>
#include "gibbot.h"

/* Configuration Bit Settings */
_FOSCSEL(FNOSC_FRCPLL) //Use internal FRC Oscillator at 7.37 MHz no PLL

_FOSC(FCKSM_CSECMD & OSCIOFNC_OFF)
//Clock switching is enabled, Fail-Safe Clock Monitor is disabled
//OSC2 pin has digital I/O function
_FWDT(FWDTEN_OFF)
//Watchdog timer enabled/disabled by user software
_FPOR(FPWRT_PWR128 & LPOL_ON & HPOL_OFF)
//Power on Reset Timer is enabled for 128ms to allow system power to stablize
//PWM module low side output pins have active-high output polarity
//PWM module high side output pins have active-low output polarity
_FICD(ICS_PGD2 & JTAGEN_OFF)
//Communicate on PGC1/EMUC1 and PGD1/EMUD1
//JTAG is Disabled

char store;
char array[100];
char direction = 1;
int turncount = 0;

int main(void) {
    // Fcy = Fin *( M / (N1 * N2))
    // Fin = 7.37 MHz
    //
    CLKDIVbits.PLLPRE = 0; //N1 = 2
    PLLFBDbits.PLLDIV = 0b000100000; //M = 34
    CLKDIVbits.PLLPOST = 0b00; // N2 = 2
    //Fcy = 62.645 MHz


    TRISAbits.TRISA2 = 0;
    init_pwm();
    init_ADC();
    init_timer1();
    //init_timer2();
    init_cn();
    init_uart();
    init_qei();
    commutate(0);
    while (1) {
    }
    return 0;
}
