NxRLab/gibbot/Controls/Code/ControlLib.X/ControlLib.h

/* 
 * File:   ControlLib.h
 * Author: harntson
 *
 * Created on February 25, 2015, 11:57 AM
 */

#ifndef CONTROLLIB_H
#define	CONTROLLIB_H

#include "ADC.h"
#include "ControlLib.h"
#include "I2CMaster.h"
#include "MPU.h"
#include "Temperature.h"
#include "UART.h"
#include "debug.h"
#include "encoder.h"
#include "initializeV6.h"
#include "linkedlist.h"
#include "motor.h"
#include "test.h"
#include "timing.h"

#endif	/* CONTROLLIB_H */
