NxRLab/gibbot/Code/PIC_Projects/dsPIC/GibbotV3.1.X/interrupts.c

#include <stdio.h>
#include <stdlib.h>
#include <p33EP512MC806.h>
#include "gibbot.h"
#include "motorcontrol.h"
#include "peripherals.h"

int senddata = 1;
int lowmagon = 0;
char motoron = 0;
char state = 0;

struct {
    short topmagenc, motorenc, lowmagenc, current;
    char state;
} data;
 
//Interrupt vector names are in Table 7-4 p101 of the MPLAB C30 User's Guide
//This interrupt triggers when the motor encoder changes state.
void __attribute__((interrupt, no_auto_psv)) _CNInterrupt(void) {
    state = (S3 << 2) | (S2 << 1) | S1; //Read encoders
    if((MOTCNT > 4000) || (MOTCNT < -800)){
        motoron = 0;
    }
    if(motoron == 1){//If the motor has been turned on
        commutate(state);//Change outputs based on inputs
        //Change LEDS
        LED1 = 0;
    } else {
        commutate(0);
    }
    LED4 = !LED4;
    // clear mismatch condition
    PORTD;
    IFS1bits.CNIF = 0; //Clear int flag
    return;
}

void __attribute__((interrupt, no_auto_psv)) _U1RXInterrupt(void) {
    while (U1STAbits.URXDA){ // If there is data in the recieve register
        unsigned char data = U1RXREG; //save data
        int torque;
        if(data & 0b10000000){
            torque = (int)data-192; // torque [-63, +63]
            if(torque < 0){
                direction = 1;
                torque = -torque;
            } else {
                direction = 0;
            }
            MDC = torque*7.9;
        } else {
            if (data == 'o'){
                senddata = 1;
            } else if (data == 'p'){
                motoron = 0;
            } else if (data == 'w'){
                lowmagon = 1;
            } else if (data == 'q'){
                lowmagon = 0;
            } else if (data == 'm'){
                motoron = 1;
                kick();
            } else if (data == 'a'){
                printf("a\r");
            } else if (data == '1'){
                commutate(1);
                printf("qw");
            } else if (data == '0'){
                commutate(0);
                printf("qw");
            }
        }
//        //Execute command from python control
//
    }
	IFS0bits.U1RXIF = 0;
}
/* Timer 1 Interrupt - Triggers every 1ms.
 * The interrupt executes and updates most controls.
 */
void __attribute__((interrupt, no_auto_psv)) _T1Interrupt(void) {
    int j = 0;
    static int slowlastCNT = 0;
    static int lastCNT = 0;
    if (senddata == 1){
        LED2 = 0;
        data.topmagenc = POS1CNTL;
        data.motorenc = MOTCNT;
        data.lowmagenc = LOWMAGCNT;
        data.current = ADC_Read();
        data.state = 0x00;
        char *s = (char *) &data;
        int j;
        for (j = 0; j < 9; j++) {
            while (U1STAbits.UTXBF); // wait until tx buffer isn't full            
            U1TXREG = s[j];
        }
        senddata = 0; //Only send data once when the python code asks for it
        LED2 = 1;
    }
//    if ((POS1CNTL-lastCNT) > 0){
//        direction = 0;
//    } else {
//        direction = 1;
//    }
//    lastCNT = POS1CNTL;
//    if(j >= 20){
//        if ((slowlastCNT-POS1CNTL < 5) || (slowlastCNT-POS1CNTL > -5)){
//            commutate(0);
//        }
//        slowlastCNT = POS1CNTL;
//        j=0;
//    } else {
//        j++;
//    }
    
    
    if(USER){
        // When the user button is pressed, clear the upper magnet encoder
        // and send a message to the other board to clear the motor and lower
        // magnet encoders. Turn off manget so that the gibbot can be removed
        // from the board.
        POS1CNTL = 0;
        TOPMAG = 0;
//        if(I2C_CONTROL.state == 0){//If the I2C interrupt routine is not sending
//            if(lowmagon){
//                I2C_Write(READ_MOTOR | READ_LOWMAG | MAGNET_ON);
//            } else {
//                I2C_Write(READ_MOTOR | READ_LOWMAG);
//            }
//        }
    } else {
        // If user button is not pressed read motor and magnet values.
        TOPMAG = 1;
        I2C_Read(READ_MOTOR | READ_LOWMAG | MAGNET_ON);
//        if(I2C_CONTROL.state == 0){//If the I2C interrupt routine is not sending
//            if(lowmagon){
//                I2C_Read(READ_MOTOR | READ_LOWMAG | MAGNET_ON);
//            } else {
//                I2C_Read(READ_MOTOR | READ_LOWMAG);
//            }
//        }
    }

    IFS0bits.T1IF = 0;
}

/* Master I2C interrupt - controls the sending/receiveing of I2C messages
 * between the main and secondary boards. The code stesp through a series of
 * states, relying on the I2C module to call the interrupt after each stage of
 * the transmission sequence has completed.
 * State
 *   0  | Initiate start event
 *   1  | Check for start event completion, Send address byte
 *   2  | Check that byte was acknowledged, Write data byte
 *   3  | Check that byte was acknowledged, Enable recieve
 *   4  | Check that byte was acknowledged, Initiate Stop event
 *   5  | Message sent, clear state variables
 *   6  | Read data byte
 *   7  | Initiate stop event
 *   8  | Message sent, clear state variables
 */
/*
void __attribute__((interrupt, no_auto_psv)) _MI2C2Interrupt(void) {
    int switchexit = 0;
    while(switchexit < 1){
        switch(I2C_CONTROL.state){
            case 0:
                //Change Transmission state to signify sending start event
                I2C_CONTROL.state= 1;
                //Initiate start event
                I2C2CONbits.SEN = 1;
                switchexit = 1;
                break;
            case 1:
                //If start has completed
                if(I2C2STATbits.S && !I2C2CONbits.SEN){
                    //If transmission buffer is not already full
                    if(!I2C2STATbits.TBF){
                        //Change State depending on reading or writing status;
                        I2C_CONTROL.state = 2 + I2C_CONTROL.cmd;
                        //Transmit slave address + R/W bit
                        I2C2TRN = ((I2C_CONTROL.slaveaddr)<<1) | I2C_CONTROL.cmd;
                        switchexit = 1;
                        error = 0;
                    } else {
                        //Generate an error and repeat
                        error = 1;
                    }

                } else{
                    //If start event has not completed return to
                    //start condition and generate an error
                    I2C_CONTROL.state = 0;
                    error = 1;
                }
                break;
            case 2: //Writing data
                //If address not acknowledged try again
                if(0){//if(I2C2STATbits.ACKSTAT){
                    //If more than three attempts exit with an error
                    if(I2C_CONTROL.repeatcount >= 3){
                        I2C_CONTROL.state = 0;
                        error = 1;
                        LED3 = 1;
                        switchexit = 1;
                    }
                    //Try sending address again
                    I2C_CONTROL.repeatcount++;
                    I2C_CONTROL.state = 1;
                    //If address was acknowledged send data
                } else {
                    I2C_CONTROL.repeatcount = 0;
                    //If no data remaining in a write operation, move to stop condition
                    if(I2C_CONTROL.numbytes == 0){
                        //Move to stop condition
                        I2C_CONTROL.state = 4;
                        //If transmission buffer is not already full
                    } else if(!I2C2STATbits.TBF){
                        //Transmit last data byte
                        I2C_CONTROL.numbytes--;
                        I2C2TRN = I2C_CONTROL.trndata[I2C_CONTROL.numbytes];
                        LED3 = 0;
                        error = 0;
                        //repeat until no data remaining
                    } else {
                        //Generate an error and repeat
                        LED3 = 1;
                        error = 1;
                    }
                }
                break;
            case 3: //Reading Data
                //If address not acknowledged try again
                if(I2C2STATbits.ACKSTAT && !I2C2STATbits.D_A){
                    //If more than three attempts exit with an error
                    if(I2C_CONTROL.repeatcount >= 3){
                        I2C_CONTROL.state = 0;
                        LED3 = 1;
                        error = 1;
                        switchexit = 1;
                    }
                    //Try sending address again
                    I2C_CONTROL.repeatcount++;
                    I2C_CONTROL.state = 1;
                    //If address was acknowledged send data
                } else {
                    I2C_CONTROL.state = 6;
                    switchexit = 1;
                    I2C2CONbits.RCEN = 1;
                    break;
                }
            case 4:
                //If data was not acknowledged exit with an error
                if(0){//if(I2C2STATbits.ACKSTAT){
                    I2C_CONTROL.state = 0;
                    LED3 = 1;
                    error = 1;
                    break;
                }
                //Stop Condition
                //Change Transmission state to signify end of message
                I2C_CONTROL.state= 5;
                //Initiate stop event
                I2C2CONbits.PEN = 1;
                switchexit = 1;
                break;
            case 5:
                //Message sent clear variables
                I2C_CONTROL.cmd = I2C_IDLE;
                I2C_CONTROL.repeatcount = 0;
                I2C_CONTROL.state= 0;
                switchexit = 1;
                break;
            //Reading data
            case 6:
                //If the data recive buffer is full read data
                if(I2C2STATbits.RBF){
                    //Store recieved data in recieve buffer
                    I2C_CONTROL.numbytes--;
                    I2C_CONTROL.rcvdata[I2C_CONTROL.numbytes] = I2C2RCV;
                    I2C2CONbits.ACKDT = 0;
                    I2C_CONTROL.state = 3;
                    if(I2C_CONTROL.numbytes==0){
                        if((I2C_CONTROL.slaveaddr & 0b0000011) == 3){
                            MOTCNT = (I2C_CONTROL.rcvdata[5]<<8) + I2C_CONTROL.rcvdata[4];
                            LOWMAGCNT = (I2C_CONTROL.rcvdata[3]<<8) + (I2C_CONTROL.rcvdata[2]);
                            LOWMAGCNT = (LOWMAGCNT<<16) + (I2C_CONTROL.rcvdata[1]<<8)
                                + I2C_CONTROL.rcvdata[0];
                        } else if(I2C_CONTROL.slaveaddr & 0b0000010){
                            MOTCNT = (I2C_CONTROL.rcvdata[1]<<8) + I2C_CONTROL.rcvdata[0];
                        } else if(I2C_CONTROL.slaveaddr & 0b0000001){
                            LOWMAGCNT = (I2C_CONTROL.rcvdata[3]<<8) + (I2C_CONTROL.rcvdata[2]);
                            LOWMAGCNT = (LOWMAGCNT<<16) + (I2C_CONTROL.rcvdata[1]<<8) + I2C_CONTROL.rcvdata[0];
                        }
                        I2C_CONTROL.state = 7;
                        //Send Nack to indicate all data has been recieved
                        I2C2CONbits.ACKDT = 1;
                    }
                    switchexit = 1;
                    //Acknowledge data
                    I2C2CONbits.ACKEN = 1;
                    break;
                //Otherwise no data was sent, set error and exit
                } else {
                    switchexit = 1;
                    I2C_CONTROL.state = 0;
                    LED3 = 1;
                    error = 1;
                    break;
                }
            case 7:
                //Stop Condition
                //Change Transmission state to signify end of message
                I2C_CONTROL.state= 8;
                //Initiate stop event
                I2C2CONbits.PEN = 1;
                switchexit = 1;
                break;
            case 8:
                //Message sent clear variables
                I2C_CONTROL.cmd = I2C_IDLE;
                I2C_CONTROL.repeatcount = 0;
                I2C_CONTROL.state= 0;
                switchexit = 1;
                break;
        }
    }
    IFS3bits.MI2C2IF = 0;
}
*/
