NxRLab/gibbot/Code/PIC_Projects/Vince/Current Control/Main files/MPU.h

#ifndef MPU_H
#define	MPU_H

void initialize_MPU(void);
void write_MPU();
void read_Accel(unsigned char *data);
void read_Gyro(unsigned char *data);
void read_MPU_test(unsigned char *data);
double Accel_convert(unsigned char *data,int i,int j);
double Gyro_convert(unsigned char *data,int i,int j);
void read_Accel_Secondary(unsigned char *data);
void read_Gyro_Secondary(unsigned char *data);

#endif	/* MPU_H */
