NxRLab/gibbot/Code/Python_Projects/GibbotModel.py

from math import *
import numpy as np

"""
The GibbotModel is a single object to represent the state of a Gibbot.

The state variables are:
(x1,y1) - fixed pivot point
q1 - angle of first link (0 is down)
q2 - angle of second link (0 is straight with respect to first link)
q1d, q2d - angular velocities

Other points on the robot:
(m1x,m1y) - center of mass 1
(x2,y2) - torque joint point
(m2x,m2y) - center of mass 2
(x3,y3) - distant point

Variables ending in 'd' are derivatives with respect to time.
For example, m1xd, is the derivative of m1x with respect to time.
"""

class GibbotModel:
    def __init__(self, x1, y1, q1, q2, q1d=0., q2d=0.):
        # State
        self.x1 = float(x1)
        self.y1 = float(y1)
        self.q1 = float(q1)
        self.q2 = float(q2)
        self.q1d = float(q1d)
        self.q2d = float(q2d)

        # Currently our gibbot guesstimated parameters
        # Link Masses (Kg)
        poundToKg = 0.453
        self.m1 = 4.875 * poundToKg
        self.m2 = 4.125 * poundToKg
        # Link Lengths (m)
        inchToMeter = 0.0254
        self.l1 = 13.0625 * inchToMeter
        self.l2 = 13.0625 * inchToMeter
        # Length to Link's Center of Mass (m)
        self.r1 = 5.469 * inchToMeter # measured from (x1,y1)
        self.r2 = 8.969 * inchToMeter # measured from (x2,y2)
        # Link Moment of Inertia (Kg*m^2 - assume thin rectangular plate about its end)
        width = 4.0 * inchToMeter
        self.I1 = self.m1 * (self.l1**2 / 3 + width**2 / 12)
        self.I2 = self.m2 * (self.l2**2 / 3 + width**2 / 12)
        # Gravity
        self.g = 9.81
        # Torque (Newton*meter)
        self.maxTorque = 2.0

    @property
    def x2(self):
        return self.x1 - self.l1*sin(self.q1)
    @property
    def y2(self):
        return self.y1 - self.l1*cos(self.q1)
    @property
    def x2d(self):
        return self.q1d*self.l1*cos(self.q1 - pi)
    @property
    def y2d(self):
        return self.q1d*self.l1*sin(self.q1 - pi)

    @property
    def x3(self):
        return self.x2 - self.l2*sin(self.q1 + self.q2)
    @property
    def y3(self):
        return self.y2 - self.l2*cos(self.q1 + self.q2)

    @property
    def m1x(self):
        return self.x1 - self.r1*sin(self.q1)
    @property
    def m1y(self):
        return self.y1 - self.r1*cos(self.q1)

    @property
    def m2x(self):
        return self.x2 - self.r2*sin(self.q1 + self.q2)
    @property
    def m2y(self):
        return self.y2 - self.r2*cos(self.q1 + self.q2)
    @property
    def m2xd(self):
        return self.x2d + self.q2d*self.r2*cos(self.q1 + self.q2)
    @property
    def m2yd(self):
        return self.y2d + self.q2d*self.r2*sin(self.q1 + self.q2)

    @property
    def energy(self):
        # Potential Energy: m * g * h
        pe1 = self.m1 * self.g * (self.m1y - self.y1)
        pe2 = self.m2 * self.g * (self.m2y - self.y1)

        # Kinetic Energy: 1/2 * mass * (tangential velocity)^2
        v1sq = (self.q1d * self.r1)**2
        v2sq = self.m2xd**2 + self.m2yd**2
        ke1 = 0.5 * self.m1 * v1sq + 0.5 * self.I1 * self.q1d**2
        ke2 = 0.5 * self.m2 * v2sq + 0.5 * self.I2 * (self.q1d + self.q2d)**2

        #print 'pe1={:.3f}, pe2={:.3f}, ke1={:.3f}, ke2={:.3f}'.format(pe1, pe2, ke1, ke2)
        #print 'm1=({:.3f}, {:.3f}); m2=({:.3f}, {:.3f})'.format(self.m1x, self.m1y, self.m2x, self.m2y)
        return pe1 + pe2 + ke1 + ke2

    def __repr__(self):
        params = (self.x1, self.y1, self.q1, self.q2, self.q1d, self.q2d)
        return '(x1={}, y1={}, q1={}, q2={}, q1d={}, q2d={})'.format(*params)

    def switch(self):
        x = self.x3
        y = self.y3
        q1 = self.q1 + self.q2 + pi
        q2 = -self.q2

        self.x1 = x
        self.y1 = y
        self.q1 = q1
        self.q2 = q2
        self.q1d = 0
        self.q2d = 0
        self.normalizeAngles()

    def advanceState(self, controlTorque, dt):
        # second order
        (q1dd, q2dd) = self.getAccelerations(controlTorque)

        # first order
        self.q1d += q1dd * dt
        self.q2d += q2dd * dt

        # zeroth order
        self.q1 += self.q1d * dt
        self.q2 += self.q2d * dt
        self.normalizeAngles()


    def normalizeAngles(self):
        # constrain to [-pi, +pi]
        self.q1 = self.q1 % (pi*2)
        if self.q1 > pi:
            self.q1 -= 2*pi
        self.q2 = self.q2 % (pi*2)
        if self.q2 > pi:
            self.q2 -= 2*pi


    def getAccelerations(self, controlTorque):
        '''Initialize Parameters'''
        # Link Masses
        m1 = self.m1
        m2 = self.m2
        # Link Lengths
        l1 = self.l1
        l2 = self.l2
        # Length to Link's Center of Mass
        r1 = self.r1
        r2 = self.r2
        # Moments of Inertia
        I1 = self.I1
        I2 = self.I2
        # Gravity
        g = self.g

        # Scaling
        dx = l1+l2
        dt = sqrt((l1+l2)/g)
        du = g*m2*r2


        '''Simplified Variables'''
        B = (m1*r1 + m2*l1)/(m2*r2)         # Beta

        G = (g*dt**2)/dx                    # Gamma = 1

        K1 = (1./dx)*(I2/(m2*r2)+r2)

        K2 = (1./dx)*((I1+m1*r1**2)/(m2*r2) + (l1**2)/r2)

        D = l1/dx                           # Delta


        '''State Updates'''

        q1 = self.q1
        q2 = self.q2
        q1d = self.q1d
        q2d = self.q2d
        qd = np.mat([[q1d],
                     [q2d]])
        s1 = sin(q1)
        c1 = cos(q1)
        s2 = sin(q2)
        c2 = cos(q2)
        s12 = sin(q1+q2)
        c12 = cos(q1+q2)

        U = controlTorque
        if U > self.maxTorque:
            print U, '>', self.maxTorque
            U = self.maxTorque
        elif U < -self.maxTorque:
            print U, '<', -self.maxTorque
            U = -self.maxTorque
        u = np.mat([[0],
                    [U]])

        M = dt * np.mat([[K1+K2+2*D*c2, D*c2+K1],
                    [K1+D*c2, K1]])


        C = dt * np.mat([[-D*s2*q2d, -D*s2*(q1d+q2d)],
                    [D*s2*q1d, 0]])

        g = G * np.mat([[B*s1+s12],
                        [s12]])


        M2 = np.linalg.inv(M)*(u-C*qd-g)

        q1dd = M2[0,0]
        q2dd = M2[1,0]

        return (q1dd, q2dd)
