NxRLab/gibbot/Code/Python_Projects/DataPlotterForNewPic.py

import serial
import struct
import re
import time
import numpy as np
from matplotlib.lines import Line2D
from matplotlib.widgets import CheckButtons, Button, Slider
import matplotlib.gridspec as gridspec
import matplotlib.pyplot as plt
import matplotlib.animation as animation
j =0
k =0
class Scope:
    def __init__(self, ax, dt=0.1):
        self.ax = ax[1]
        self.ax2 = ax[0]
        self.ax3 = ax[2]
        self.dt = dt
        self.arm1x = [0 , .5]
        self.arm1y = [0 , .5]
        self.arm2x = [0 , 0]
        self.arm2y = [0 , 0]
        self.tdata = [0]
        self.ydata1 = [0]
        self.ydata2 = [0]
        self.ydata3 = [0]  
        self.arm1 = Line2D(self.arm1x, self.arm1y, color="purple", lw="18", solid_capstyle="round", marker="o", markerfacecolor="black", markersize=20)
        self.arm2 = Line2D(self.arm2x, self.arm2y, color="purple", lw="18", solid_capstyle="round", marker="o", markerfacecolor="black", markersize=20)
        self.ax2.add_line(self.arm1)
        self.ax2.add_line(self.arm2)
        self.line1 = Line2D(self.tdata, self.ydata1, color="red", label="Data1")
        self.line2 = Line2D(self.tdata, self.ydata2, color="blue", label="Data2")
        self.line3 = Line2D(self.tdata, self.ydata2, color="green", label="Data3")
        self.ax.add_line(self.line1)
        self.ax.add_line(self.line2)
        self.ax3.add_line(self.line3)  
        
    def update(self, y):
        global k
        t = self.tdata[-1] + self.dt
        
        if k<99:
            k=k+1
        else:
            self.tdata.pop(0)       #remove the first element
            self.ydata1.pop(0)
            self.ydata2.pop(0)             #remove the first element
            self.ydata3.pop(0)
            self.ax.set_xlim(self.tdata[0], self.tdata[-1]) #adjust the x-axis
        self.arm1x = np.sin(((y[0])*3.14)/3600)*.5
        self.arm1y = -np.cos(((y[0])*3.14)/3600)*.5
        self.arm1.set_data([0, self.arm1x],[0, self.arm1y])
        self.arm2.set_data([self.arm1x, self.arm1x + np.sin(((y[0]+y[1]-1800)*3.14)/3600)*.5],[self.arm1y, self.arm1y-np.cos(((y[0]+y[1]-1800)*3.14)/3600)*.5])
        self.tdata.append(t)    #add to the end
        self.ydata1.append(y[0])
        self.ydata2.append(y[1]-1800)
        self.ydata3.append((y[3]-2048)/124.1)
        self.line1.set_data(self.tdata, self.ydata1)
        self.line2.set_data(self.tdata, self.ydata2)
        self.line3.set_data(self.tdata, self.ydata3)
        return self.line1, self.line2, self.line3, self.arm1, self.arm2
    
    def comm1(self, event):
        ser.write("o")
        print "o"
    def comm2(self, event):
        storque.set_val(0)
        ser.write("p")
        print 'p'
    def comm3(self, event):
        ser.write("w")
        print 'w'
    def comm4(self, event):
        ser.write("q")
        print 'q'
        
    def sendTorque(self, val):
        num = int(round(val))
        cmd = 'm'+chr(num+192)  # Encode slider value [-63,+63] as a byte [129, 255]
        ser.write(cmd)
        print 'm'+str(num)

    def init(self):
        self.line1.set_data([], [])
        self.line2.set_data([], [])
        self.line3.set_data([], [])
        self.arm1.set_data([], [])
        self.arm2.set_data([], [])
        return self.line1, self.line2, self.line3, self.arm1, self.arm2
    def close(self, event):
        plt.close()
        
def emitter():
    """Read the encoder, i1, i2, i3 and state from the dsPIC
    To read the encoder: leftbit takes received[1], rightbit takes received[0]
    To read i1: leftbit takes received[3], rightbit takes received[2]
    To read i2: leftbit takes received[5], rightbit takes received[4]
    To read i3: leftbit takes received[7], rightbit takes received[6]
    The state is in received[8]
    """
    output = [0,0,0,0]
    ser.write("o")              #instruct the gibbot to start sending
    time.sleep(0.05)
    if ser.inWaiting() == 9:
        received = ser.read(ser.inWaiting())
        output=struct.unpack( "hhhhx", received )
    else :
        print 'invalid response:', (ser.inWaiting() or '<empty>')
        received = ser.read(ser.inWaiting())      
    yield output

def func(label):
    if label == 'Encoder1': scope.line1.set_visible(not scope.line1.get_visible())
    elif label == 'Encoder2': scope.line2.set_visible(not scope.line2.get_visible())
    elif label == 'Current': scope.line3.set_visible(not scope.line3.get_visible())

#Create Figure 1
plt.close('all')                    #Close existing plots
fig = plt.figure()                  #Create figure
mng = plt.get_current_fig_manager() #Resize to fullscreen
#mng.resize(*mng.window.maxsize())

#Create axes
ax = [0]*3  #define array that contains the names of each axes
#Create axis for gibbot animation using gridspec for more layout flexibility
gs1 = gridspec.GridSpec(1,1)                            
gs1.update(left=0.0, right=0.4, bottom=0, top=1)
ax[0] = plt.subplot(gs1[0, 0], aspect="equal", axisbg='.75', frameon=False)

#Create axes for current and encoder plots
gs2 = gridspec.GridSpec(2,1)
gs2.update(left=0.4, right=0.85, bottom=.12, hspace=0.01)
ax[1] = plt.subplot(gs2[0, 0])
ax[2] = plt.subplot(gs2[1, 0], sharex=ax[1])
ax[2].grid(1, 'both')

#Format gibbot animation axis
ax[0].set_xlim(-1.4, 1,4)
ax[0].set_ylim(-1.4, 1.4)
ax[0].get_xaxis().set_visible(False)
ax[0].get_yaxis().set_visible(False)

#Format current and encoder axes
ax[1].set_ylim(-1800,1800)
ax[1].set_xlim(0, 10)
ax[2].set_ylim(-10, 10)

#Create scope object
scope = Scope(ax)

#Draw legend
fig.legend([scope.line1, scope.line2, scope.line3], ['Encoder1', 'Encoder2', 'Current'])

#Draw torque slider
axtorque = plt.axes([0.25, 0.07, 0.65, 0.03])
storque = Slider(axtorque, 'Torque', -63, 63, valinit=0)
storque.on_changed(scope.sendTorque)

#Draw buttons
checkax = plt.axes([0.9, 0.4, 0.1, 0.15])
check = CheckButtons(checkax, ('Encoder1', 'Encoder2', 'Current'), (True, True, True))
check.lines[0][0].set_color("Red")
check.lines[0][1].set_color("Red")
check.lines[1][0].set_color("Blue")
check.lines[1][1].set_color("Blue")
check.lines[2][0].set_color("Green")
check.lines[2][1].set_color("Green")
check.on_clicked(func)

closeax = plt.axes([0.9, 0.25, 0.1, 0.1])
close = Button(closeax, 'Close')
close.on_clicked(scope.close)

comm1ax = plt.axes([0.1, 0.01, 0.1, 0.05])
comm1 = Button(comm1ax, 'Data On')
comm1.on_clicked(scope.comm1)
comm2ax = plt.axes([0.2, 0.01, 0.1, 0.05])
comm2 = Button(comm2ax, 'Motor off')
comm2.on_clicked(scope.comm2)
comm3ax = plt.axes([0.3, 0.01, 0.1, 0.05])
comm3 = Button(comm3ax, 'Bottom Magnet On')
comm3.on_clicked(scope.comm3)
comm4ax = plt.axes([0.4, 0.01, 0.1, 0.05])
comm4 = Button(comm4ax, 'Bottom Magnet Off')
comm4.on_clicked(scope.comm4)

#Open serial port
ser = serial.Serial(2) #COM 3       7 -> COM 8
ser.baudrate = 115200  #set the baud rate
ser.timeout = 10        #1s timeout

# pass a generator in "emitter" to produce data for the update func
ani = animation.FuncAnimation(fig, scope.update, emitter, scope.init, interval=10,
    blit=True)

plt.show()
