NxRLab/gibbot/Code/PIC_Projects/dsPIC/dsPIC33MotorCharacterization.X/interrupts.c

#include <stdio.h>
#include <stdlib.h>
#include <p33Fxxxx.h>
#include "gibbot.h"

int lastADC = 0; //variable to store last ADC result
int index1 = 0;
int index2 = 0;
int senddata = 0;
int swing = 0;
char bufferfull = 0;
int pause = 0;

struct {
    short encoder, i1, i2, i3;
    char state;
} data;

void __attribute__((interrupt, no_auto_psv)) _U1RXInterrupt(void) {
    while (U1STAbits.URXDA) { // If there is data in the recieve register
        char echo = U1RXREG;
        if (echo == 'a') { //half on direction 1
            duty(186); //186
            kick();
            direction = 1;
            turncount = 42;
            index2 = 1; 
        }
        if (echo == 's') { //half on direction 1
            duty(372); //186
            kick();
            direction = 1;
            index2=1;
            turncount = 42;
        }
        if (echo == 'd') { //half on direction 1
            duty(558); //186
            kick();
            direction = 1;
            index2=1;
            turncount = 42;
        }
        if (echo == 'f') { //half on direction 1
            duty(791); //186
            kick();
            direction = 1;
            index2=1;
            turncount = 42;
        }
        if (echo =='w'){
            duty(372);
            kick();
            swing = 1;
        }
        if (echo =='q'){
            duty(0);
            swing = 0;
            index2 = 0;
        }
        if (echo =='o'){
            senddata = 1;
        }
        if (echo =='p'){
            senddata = 0;
        }
    }
    IFS0bits.U1RXIF = 0;
}

void __attribute__((interrupt, no_auto_psv)) _T1Interrupt(void) {
    static int prevencoder = 0;


    if ((POS1CNT > 2700) | (POS1CNT < 900)){
        swing = 0;
    } else {
        if (prevencoder > POS1CNT){
            direction = 1;
        } else {
            direction = 0;
        }
    }
    prevencoder = POS1CNT;
    if (senddata == 1){    //was turncount?
        Read_ADC();
        data.encoder = POS1CNT;
        data.i1 = ADResultAN3;
        data.i2 = ADResultAN4;
        data.i3 = ADResultAN5;
        data.state = 1;
        //printf("%d \n",data.encoder);

        char *s = (char *) &data;
        int j;
        for (j = 0; j < 10; j++) {
            while (U1STAbits.UTXBF); // wait until tx buffer isn't full
            U1TXREG = s[j];
        }
    }
        IFS0bits.T1IF = 0;
}

void __attribute__((interrupt, no_auto_psv)) _T2Interrupt(void) {
    IFS0bits.T2IF = 0;
}

void __attribute__((interrupt, no_auto_psv)) _QEIInterrupt(void) {
    IFS3bits.QEIIF = 0; //We don't care about a qei interrupt
}

void __attribute__((interrupt, no_auto_psv)) _CNInterrupt(void) {
    char state = 0;
    static char laststate;
    // Is this a CN interrupt?
    if (IFS1bits.CNIF) {
        if ((turncount > 0) | (swing == 1)) {
            state = (!S3 << 2) | (!S2 << 1) | !S1;
            commutate(state);
            if (laststate != state) {
                turncount = turncount - 1;
            }

            laststate = state;
        } else {
            commutate(0);
        }
        // clear mismatch condition
        PORTA;
        PORTB;
        IFS1bits.CNIF = 0; //Clear int flag
    }
    return;
}
