NxRLab/gibbot/Controls/Code/ControlLib.X/timing.h

/* 
 * File:   time.h
 * Author: Hannah Arntson
 *
 * Created on February 1, 2015
 */

 #ifndef TIME_H
 #define TIME_H

 void timer1_on(void);
 void timer1_off(void);
 void delay_ms(int x);
 void delay_us(int x);

 #endif /*TIME_H*/
