NxRLab/gibbot/Code/PIC_Projects/dsPIC/dsPIC806 Code Porting.X/peripherals.h

#ifndef PERIPHERALS_H
#define	PERIPHERALS_H

void initialize_cn(void);
void startup(void);
void initialize_pwm(void);
void initialize_uart (void);
void initialize_qei(void);
void initialize_timer1(void);
void initialize_adc(void);
short Read_ADC(void);

#endif	/* PERIPHERALS_H */
