NxRLab/gibbot/Code/PIC_Projects/dsPIC/dsPIC33MotorCharacterization2.X/changenotification.h

/* 
 * File:   changenotification.h
 * Author: ajgriesemer
 *
 * Created on July 30, 2013, 10:32 AM
 */

#ifndef CHANGENOTIFICATION_H
#define	CHANGENOTIFICATION_H



#endif

#endif	/* CHANGENOTIFICATION_H */
