NxRLab/gibbot/(commit log)

2013-01-23 added prior documentation
    documents from 2011 ME433 monkeybot design
    [monkeybot.brd, monkeybot.sch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]
2013-02-12 Added Datasheets
    Datasheets for the sensors that will go on the new PCB
2013-02-18 Created folder for PCB group
    Added working files for Test Parts PCB, moved Datasheets into new folder
    [test_parts.brd, test_parts.sch]
2013-02-21 Finished the test PCB
    [test_parts.brd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]
2013-03-10 add OptiTrack SDK / pyoptitrack project / sample
2013-03-14 Switched cameras from poll-based to event-based
2013-03-14 Fixed output orientation/layout and labelled cameras
    [pyoptitrack.cpp]
2013-04-02 added CAD model of frame, brushless motor code, and battery charging data sheets.
    [1393671.sldprt, 1393804.sldprt, 1393805.sldprt, 1393806_ASM.sldasm, 1393835_ASM.sldasm, 1393836.sldprt, 1393837.sldprt, 60355K509_bearing_1in_ID_mcmaster.SLDPRT]
2013-04-03 changed the resistor values for current sensor
    [test_parts.brd, test_parts.sch]
2013-04-05 added a simplified version of old gibbot so that old Gibbot can be actuated by kewboard
    [top_arm_assm.SLDASM]
2013-04-05 update of schematic
    [batt_test_parts.sch, power.sch]
2013-04-06 first draft schematic complete for bat mon
    [batt_input.sch, batt_test_parts.sch, misc_io.sch, power.sch]
2013-04-09 added PIC32 eval board schematics
    [batt_input.sch, batt_test_parts.sch, misc_io.sch, power.sch]
2013-04-20 library for st gyro. spi has been tested on pic32. the test code uses spi4 as master and spi2 as slave. tried using spi4 as master with gyro and MISO pin (SDI4 on the PIC) is not getting a clean sign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
2013-04-26 adding robot frame cam files
    [Bottom_Arm_Blank.prt, Bottom_Arm_Mfg.prt, Top_Arm_Blank.prt, Top_Arm_Mfg.prt, frame_bottom.prt, frame_top.prt]
2013-04-26 updating cad files
    [1393671.sldprt, 1393804.sldprt, 1393805.sldprt, 1393806_ASM.sldasm, 1393835_ASM.sldasm, 1393836.sldprt, 1393837.sldprt, 60355K509_bearing_1in_ID_mcmaster.SLDPRT]
2013-04-30 finished schematic with new battery monitor
    [2_batt_con.sch, 2_power.sch, batt_input.sch, batt_man_2.sch, batt_test_parts.sch, battery_charger.sch, battery_manager.sch, battery_manager1.sch]
2013-05-08 Fixed tiny DT bug / stored parameters on GibbotModel / display unequal link lengths correctly
    [GibbotModel.py]
2013-05-08 updated schematic
    [2_batt_con.sch, 2_power.sch, batt_input.sch, batt_man_2.sch, batt_test_parts.brd, batt_test_parts.sch, battery_charger.sch, battery_manager.sch]
2013-05-14 added actual mosfet to ckt for ltc4000
2013-05-14 added switches so that it simulates a little faster.
2013-05-15 ported ltspice circuit to kicad
    [Battery Charger.sch]
2013-05-17 Updated SolveForKMatrix.py to print K matrix, still buggy
    [SolveForKMatrix.py]
2013-05-17 code works, but modified control law so that its based on error in the signal. try a small pertubation, a good looking one is q1 = -3.137 q2 = 0.04.
    [Battery Charger.sch]
2013-05-21 New PCB Schematic in KiCAD
    [Test.kicad_pcb, Test.sch, TestPCB.sch]
2013-05-21 Adding Calibration Project
2013-05-24 modified charger circuit. works pretty well now. still need to choose suitable cap values.
2013-05-27 update of new pcb and power supply design
    [2_batt_con.sch, 2_power.sch, Test.sch, batt_input.sch, batt_man_2.sch, batt_test_parts.sch, battery_charger.sch, battery_manager.sch]
2013-05-27 Updating Schematic for New PCB
    [Test.sch, power.sch, sensors.sch]
2013-05-28 Added UserApp and position/switching to GibbotModel
2013-05-29 found optitrack camera parameters
2013-05-29 more updates
    [Test.sch, motor_control.sch, power.sch, sensors.sch]
2013-05-29 updated battery charger sim
2013-06-02 Test code for DsPIC PWM
2013-06-02 correct version of PWM code
    [main.c]
2013-06-02 deleted some files
    [Test.brd]
2013-06-02 added notes to schematic
    [Test.sch, motor_control.sch, power.sch, sensors.sch]
2013-06-03 updated schematic and netlist, added flyback diodes
    [Test.sch, motor_control.sch, power.sch, sensors.sch]
2013-06-03 updated cad files
    [1393806_ASM.sldasm, 1393835_ASM.sldasm, EC60_motor_12_198_IP00.sldasm, batt_assm_6612_10.SLDASM, batt_assm_6612_5.SLDASM, frame_bottom.SLDPRT, frame_top.SLDPRT, magnet_mount_for_top_arm.SLDDRW]
2013-06-03 Specs sheet
    excel file containing all the specs of the current gibbot
    [Inertia Calcs.xlsx]
2013-06-04 updating dspic pwm code
2013-06-05 order has been placed and confirmed, receipt in project folder
    [Test-B_Cu.gbl, Test-B_Mask.gbs, Test-B_SilkS.gbo, Test-Edge_Cuts.gbr, Test-F_Cu.gtl, Test-F_Mask.gts, Test-F_SilkS.gto, Test-Ground.gbr]
2013-06-07 parts for the pcb
2013-06-10 Updated print statements
2013-06-11 Y axis is now up; renamed robot points to 1,2,3 (not 1,c,2)
2013-06-13 new bldc driver code for dspic
2013-06-13 Renamed SimulatorApp to FixedPointSimulatorApp
    [FixedPointGibbotFrame.py, FixedPointInputFrame.py, FixedPointSimulatorApp.py]
2013-06-18 added calculations for resistor values for dcdc converters
    [DCDC Vfb resistor calculations.xls]
2013-06-18 adjusted spreadsheet + 5v fixed dcdc datasheet
    [DCDC Vfb resistor calculations.xls]
2013-06-28 Motor and Magnet PCB
    [$Test.sch, MotorMagnet PCB.sch]
2013-06-28 Updated Motor/Magnet PCB
    [$Test.sch, MotorMagnet PCB.sch]
2013-07-01 Motor/Magnet PCB (KiCad)
    [$MotorMagnet PCB.sch, $Test.sch, MotorMagnet.kicad_pcb, Test.sch, motor_control.sch, power.sch, sensors.sch]
2013-07-05 Motor/Magnet updates
    (from earlier in the week)
    [$MotorMagnet PCB.sch, MotorMagnet.kicad_pcb]
2013-07-08 KICad BreakOut Board (64 pin DSPic)
    [$MotorMagnet PCB.sch, DsPIC Breakout.sch, MotorMagnet PCB.sch, MotorMagnet.kicad_pcb, Test.sch, motor_control.sch, power.sch, sensors.sch]
2013-07-09 KICad BreakOut Board (64 pin dsPIC)
    Schematic and Layout
    [DsPIC Breakout.kicad_pcb, DsPIC Breakout.sch]
2013-07-10 Updated Breakout Board 64pin dsPIC
    [DsPIC Breakout.kicad_pcb, DsPIC Breakout.sch, MotorMagnet PCB.sch]
2013-07-10 BreakoutBoard 64pin dsPIC
    [DsPIC Breakout.kicad_pcb, Test.kicad_pcb]
2013-07-10 BreakoutBoard 64pin dsPIC
    Gerbers added
    [DsPIC Breakout-B_Cu.gbl, DsPIC Breakout-B_Mask.gbs, DsPIC Breakout-B_Paste.gbp, DsPIC Breakout-B_SilkS.gbo, DsPIC Breakout-Edge_Cuts.gbr, DsPIC Breakout-F_Cu.gtl, DsPIC Breakout-F_Mask.gts, DsPIC Breakout-F_Paste.gtp]
2013-07-11 BreakoutBoard dsPIC64 PCB
    Including final gerber files
    [DsPIC Breakout-B_Cu.gbl, DsPIC Breakout-B_Mask.gbs, DsPIC Breakout-B_Paste.gbp, DsPIC Breakout-B_SilkS.gbo, DsPIC Breakout-Edge_Cuts.gbr, DsPIC Breakout-F_Cu.gtl, DsPIC Breakout-F_Mask.gts, DsPIC Breakout-F_Paste.gtp]
2013-07-15 Fixes to Schematics
    [Test.sch, motor_control.sch, power.sch, sensors.sch]
2013-07-26 H-Bridge and Pic32 XBee code
    [$power.sch]
2013-07-26 Added gate driver circuit schematic and layout as well as BLDC gate driver code for dsPIC33...202 for motor characterization.
    [Gibbot.brd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]
2013-07-26 Adding Jason's Commit
    [$power.sch]
2013-07-26 ADC test code
2013-07-29 ADC code
2013-07-29 ADC Code
    minor change
2013-07-30 Updated BLDC motor controller program. QEI not yet working, UART not working consistently, commutation works, PWM works. Code has been broken into multiple files.
    [main.c]
2013-07-30 Working ADC Code
2013-07-30 Updated BLDC motor controller. Split main.c file into multiple files.
2013-07-31 Modified BLDC driver code. Previous version did not work because of an error with the PWM interrupt. Also simplified the state functions to a single commutate function. Experimented with some fixed c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
    [gibbot.h, interrupts.c, main.c, motorcontrol.c, peripherals.c]
2013-07-31 Integrated BLDC Code with ADC
2013-08-01 Updated Gibbot Code
    [$power.sch, power.sch]
2013-08-06 Jason and Andrew Motor Characterization setup
    Debugging issues with ADC, UART and commands
2013-08-06 Jason and Andrew Motor Characterization Corrections
2013-08-06 Motor Characterization Edits
    Third time because of github issues
    [gibbot.h, interrupts.c, main.c, peripherals.c]
2013-08-06 Changes to the BLDC characterization code
    I modified the ADC code so that the end of sampling is triggered
    automatically after 1us. I also removed the code that read CH0. Adding
    a 10uF decoupling capacitor eliminated the noise on the ADC lines.
    However, when the PWM is running there is a 40kHz ripple voltage on the
    UART TX line. I also added and clarified comments.
    [gibbot.h, interrupts.c, main.c, peripherals.c]
2013-08-08 Complete python strip chart code
    Major Addition: DataPlotter.py
    1)Working python code that reads in encoder, current and state
    information from the gibbot and graphs it in a strip chart
    Next steps: create a gui through which one can select which information
    to graph and send commands to the dsPIC. Also, there is a minor
    aesthetic bug during the section before the graph translates to the
    left.
    Minor Edits to BLDC interrupt code: 1) fixed while loop in interrupts.c
    2) added code that transmits encoder, current and state readings in hex
    [DataPlotter.py, Serial.py, interrupts.c, main.c]
2013-08-15 Added initial designs of Gibbot v3 board.
    [Gibbot v3.brd, Gibbot v3.sch]
2013-08-20 Made changes on the Gibbot v3 board. The majority of the main board is layed out. Still remaining is the buck converter board and the tertiary board.
    [Gibbot v3.brd, Gibbot v3.sch]
2013-08-20 More changes to the gibbot v3 board. Started the layout for the auxilary control board. Added buttons and holes to the main board and improved layout
    [Gibbot v3.brd, Gibbot v3.sch]
2013-08-22 Additional changes to the gibbot v3 board. Layout for the main board is mostly completed. The schematic for the 24V to 12V and 5V buck converter is laid out.
    [Gibbot v3.brd, Gibbot v3.sch]
2013-08-26 Additional changes to the Gibbot v3 board. Finished a preliminary layout of all three boards, added power connector ports and assigned values to some of the components.
    [Gibbot v3.brd, Gibbot v3.sch]
2013-08-27 Worked on the Gibbot v3 board. Added component values and names, replaced some diodes to line up with what is available on Digikey.
2013-08-28 Finishing up the design of the gibbot v3 board. All that remains is adding labels and double checking footprints against the datasheet.
    [Gibbot v3.brd, Gibbot v3.sch]
2013-09-03 Final revisions to the Gibbot v3 board. This version of the board was ordered from Advanced Circuits on Friday, August 30th.
    [Gibbot v3.brd, Gibbot v3.sch]
2013-09-03 Rearranged the file structure. The board files for each board are now in a folder designated with the version name of the board that matches with the documentation on the wiki. All programs were move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
    [DCDC Vfb resistor calculations.xls, Gibbot v3.brd, Gibbot v3.sch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]
2013-09-03 Added in files that were missing from the last commit.
    [DCDC Vfb resistor calculations.xls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]
2013-09-03 Created dsPIC806 Code Porting. This project now runs the dsPIC33EP512MC806. I got change notification up and running for the hall effecto sensor pins. I confirmed that digital I/O works on the USER, 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
2013-09-06 Created the first version of code for porting the functionality of the gibbot v2 board over to the gibbot v3 board. I was able to get the following functionality working: 12 bit ACD, change notificat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
2013-09-09 Added serial communication to data plotter code
    Code is fully functioning, taking one encoder input and one current
    sensor input.
2013-10-08 Changes to Gibbot V3.1
    [Gibbot v3.brd, Gibbot v3.sch]
2013-10-10 Changes to GibbotV3.1 to develop functionality for an I2C commmunication library that uses interrupts. The code is not yet complete and does not yet work.
2013-10-21 Started Gibbot v4 board and added gibbot.lbr which contains all of the footprints for the boards to the repository. Lots of changes to the Gibbotv3.1 code. The code now sends the encoder readings to 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
    [Gibbot v4.brd, Gibbot v4.sch]
2013-10-21 Adding initial components to CAD v3 folder
    [PG_B_8mm_7804K115_igs.prt, Spacer_92321A009_igs.prt, St_BB_5-8mm_6383K470_igs.prt, bearing_1inID_60355K509_igs.prt, buttonhead_screw_10-32x375_92949A263.IGS, flathead_screw_m4x10_91698A428_igs.prt, flathead_socket_cap_m4x10_screw_ 91294A190_igs.prt, screw2-56_90272A080_igs.prt]
2013-10-23 Modifications to the Gibbotv3.1 code. We are developing a python control that can control simple motor motion. The code is not currently functional
2013-10-29 Nx Versions of in-house manufactured parts
    [bearing_spacer.prt, carrier_v2.prt, carriet_shaft.prt, encoder_shaft.prt, magnet_mount.prt, pivotshaft.prt]
2013-10-30 Python Demos
    Created DataPlotterForNewPic.py which allows for simple control and data
    measurement from the Gibbot v3 board.
2013-10-31 Modifications to PCB files
    [Gibbot v4.brd, Gibbot v4.sch]
2013-11-04 Changes to the Gibbot v4 board. GibbotV3.1 code is working with a wait state based I2C. I2C Write function is not yet implemented.
    [Gibbot v4.brd, Gibbot v4.sch]
2013-11-10 NX CAD model of frame bottom
    [frame_bottom.prt]
2013-11-14 Changes to PCBs
    Added Gibbot v4.1, a separate board for designing the charging system.
    [Gibbot v4.1.brd, Gibbot v4.1.sch, Gibbot v4.brd, Gibbot v4.sch]
2013-11-18 More Changes to PCB
    [Gibbot v4.1.brd, Gibbot v4.1.sch]
2013-11-20 Updated board size and refactored Camera.py
2013-11-25 NX Cad updates
    [bearing_spacer.prt, carrier_v2.prt, carriet_shaft.prt, frame_bottom.prt, frame_top.prt]
2013-11-26 Updates to the Gibbot v4.1 charge test board. The layout has been mostly completed. All that is left is to reroute the traces.
    [Gibbot v4.1.brd, Gibbot v4.1.sch]
2013-11-27 Additional changes to the Gibbot v4.1 Board
    The board is mostly complete except for the addition of a few connector
    test pads and a final review.
    [Gibbot v4.1.brd, Gibbot v4.1.sch]
2013-11-27 Schematic not included in previous commit
    [Gibbot v4.1.sch]
2013-12-04 Much improved camera debug window
2013-12-06 Changes to the Gibbot v4.1 PCB and the Gibbot V3.1 code. The board should now be at a point where it is ready to send to advanced circuits. The GibbotV3.1 code will respond to computer commands. The 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
    [Gibbot v4.1.brd, Gibbot v4.1.sch]
2013-12-06 Cameras use angle to detect middle corner markers
2014-01-21 Updated phys params and fixed sim timing
    [FixedPointSimulatorApp.py, GibbotModel.py]
2014-01-28 Fixed simulator reset after swing-over
    [FixedPointSimulatorApp.py]
2014-01-28 Created MotorTesting.X to facilitate debugging
    [Gibbot v4.1.brd, Gibbot v4.1.sch, Gibbot v4.brd, Gibbot v4.sch]
2014-02-03 Added Kinea Gibbot v1 Design Files
    Design files include drawings, solidworks models and pdf of specs.
    [001_000X.sldprt, 1001-0001-01 ELECTROMAGNET TEST FIXTURE.SLDDRW, 1001-0002-01 ELECTROMAGNET WINDING MANDREL.SLDDRW, 1001-2001 ELECTROMAGNET ASSY.sldasm, 1001-2001-03 ELECTROMAGNET ASSY.SLDDRW, 1001-2002-01 MOTOR LINK ASSY.SLDDRW, 1001-2003 BATTERY LINK ASSY.sldasm, 1001-2003-01 BATTERY LINK ASSY.SLDDRW]
2014-02-10 Revisions to Gibbot v4 PCB
    Small changes
    [Gibbot v4.2.brd, Gibbot v4.2.sch, Gibbot v4.sch]
2014-02-10 Added Documentation and Motor Testing Code
    Motor Testing Project file isolates motor control for debugging purposes
    [Gibbot v4.1.GBL, Gibbot v4.1.GBS, Gibbot v4.1.GTL, Gibbot v4.1.GTO, Gibbot v4.1.GTS]
2014-02-10 Fixed Power Path Image
2014-04-02 Added Final Gibbot v4.2 Files
    Includes new library, schematic and drawing along with the cam files
    that were sent to Advanced Circuits.
    [Gibbot v4.2-MotorDriverAlternate.brd, Gibbot v4.2-MotorDriverAlternate.sch, Gibbot v4.2.brd, Gibbot v4.2.sch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]
2014-04-02 Cleaning up PCB folder
    Deleted .s# and .b# backup files, renamed Gibbot v4.1 folder as Gibbot
    v4.1 CAM.
    [Gibbot v4.1.GBL, Gibbot v4.1.GBS, Gibbot v4.1.GTL, Gibbot v4.1.GTO, Gibbot v4.1.GTS]
2014-04-02 Cleaning up PCB folder
    Moved all of Jake's files and other early PCBs to Gibbot v1 folder.
    Moved Jason's dsPIC breakout board files to Gibbot v2 folder.
    [2_batt_con.sch, 2_power.sch, Battery Charger.sch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]
2014-04-02 Cleaning up Frame Folder
    Renamed from Gibbot Frame to Frame. Renamed "assembly CAD v2" as "CAD
    v2". Moved v2 CAM files inside "CAD v2" folder. Deleted files in CAD
    v3.
    [001_000X.sldprt, 1001-0001-01 ELECTROMAGNET TEST FIXTURE.SLDDRW, 1001-0002-01 ELECTROMAGNET WINDING MANDREL.SLDDRW, 1001-2001 ELECTROMAGNET ASSY.sldasm, 1001-2001-03 ELECTROMAGNET ASSY.SLDDRW, 1001-2002-01 MOTOR LINK ASSY.SLDDRW, 1001-2003 BATTERY LINK ASSY.sldasm, 1001-2003-01 BATTERY LINK ASSY.SLDDRW]
2014-04-03 Cleaning up Gibbot v4 Folder
    Changed names of projects from v4.1, v4.2, etc. to BatteryCharge and
    Control which are more descriptive.
    [BatteryCharge.brd, BatteryCharge.sch, Control-MotorDriverAlternate.brd, Control-MotorDriverAlternate.sch, Control-print.brd, Control.brd, Control.sch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]
2014-04-04 Cleaning up PCB folders
    Deleted backup .b# .s# files
2014-04-04 New CAD Files
    New frame design in progress
    [.75 Bore External Retaining Ring.SLDPRT, 1.625 Bore Internal Retaining Ring.SLDPRT, 10-32 Button Cap Thread Locking Screw.SLDPRT, Battery Holder - keystone-PN1043.SLDPRT, Battery PCB.SLDPRT, Bearing - .750.SLDPRT, Bearing-.625in.SLDPRT, Bearing-I8mmO16mm.SLDPRT]
2014-04-05 Updates to Battery Test Circuit
    Added documentation on a single cell battery test, added corrections to
    the battery circuit in a new schematic file.
    [Control.brd, Control.sch, RevisedChargerCircuit.sch]
2014-04-09 Adding Documentation
    Minor changes to the 1 Cell Test document, added v4 PCB documentation.
2014-04-09 Updated CAD models of the frame
    I added more fasteners, acrylic covers for the links, slip rings, and
    modified the encoders.
    [2-56 Screw.SLDPRT, 8-32 Screws.SLDPRT, Battery PCB.DXF, Battery PCB.SLDDRW, Battery PCB.SLDPRT, Bearing-I8mmO16mm.SLDPRT, Delrin_Ring.SLDPRT, Dowel Pin - .0625.SLDPRT]
2014-04-11 Frame V3 Final
    Contains final version of frame V3. The frame CAD models will be 3D
    printed.
    [#2 Spacer.SLDPRT, 2-56 Screw Short.SLDPRT, 4-40 Screws.SLDPRT, 8-32 Low Profile Screws.SLDPRT, 8-32 Screws.SLDPRT, Acrylic Cover 2 Wall Link.SLDPRT, Battery PCB.SLDPRT, Delrin_Ring.SLDPRT]
2014-04-28 Cleaning up code folder
    Moved files into three subdirectories for Python, PIC and MATLAB
    projects.
    [Control.brd, Control.sch]
2014-04-28 Cleaning up PIC projects folder
    Arranged into two subfolders for dsPIC and PIC32 projects. Deleted
    projects that were no longer relevant to the project.
    [7366.h, 7366_lib.c, I2CMaster.c, I2CMaster.h, NU32_2012.c, NU32_2012.h, PIC32 bldc.c, RAMbyte.c]
2014-04-28 Changes spaces to underscores
    Eliminated spaces in the names of folders within the code folder to
    prevent compiler errors.
    [7366.h, 7366_lib.c, Controller.py, DataPlotter.py, DataPlotter2.py, DataPlotter3.py, DataPlotterForNewPic.py, FixedPointGibbotFrame.py]
2014-04-29 Developing V4 dsPIC code
    Added Nelson's Linked List code. Added comments to motor and I2C code.
2014-05-01 Modified frame models for 3D printing
    Wall link and motor link frames were modified to fit within the 10x10
    space of the stratasys 3d printing machine. These modified models have
    a center to center distance of 9.4in. versus the original 10.5in.
    distance.
    [#2 Spacer.SLDPRT, .75 Bore External Retaining Ring.SLDPRT, 1.625 Bore Internal Retaining Ring.SLDPRT, 10-32 Button Cap Thread Locking Screw.SLDPRT, 2-56 Screw Short.SLDPRT, 2-56 Screw.SLDPRT, 3D Printer Bed.SLDPRT, 3d Printer Fit Assembly.SLDASM]
2014-05-08 Changes to dsPIC code and Documentation
    Development of the Primary and Secondary V4 dsPIC code. This version is
    not yet stable.
    [Control.brd]
2014-05-12 Updates to Primary and Secondary Code
    Test functions are fully functional. Error handling still needs to be
    built into I2C code to allow it to function with electrical noise.
    [BatteryManager.sch, Primary.brd, Primary.sch, Secondary.brd, Secondary.sch]
2014-05-16 updated dsPIC code for wixel
    Fixed uart problems
    [dsPICmain.c]
2014-05-30 Updates to Wixel Code
    Changes to code related to communication and interface and updated
    current ISR
2014-06-03 Changes to v5 PCB
    [BatteryManager.sch, Control copy.sch, Primary.brd, Primary.sch, Secondary.brd, Secondary.sch]
2014-06-10 Final Design of V5 Board
    Contains the final version of the V5 schematic and board files. Also
    contains the CAM files that were sent to AC. Also contains updates to
    PrimaryV4 dsPIC code and the V5 documentation.
    [Primary.brd, Primary.sch, Secondary.brd, Secondary.sch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]
2014-06-30 Documentation on V5 PCB ADC Issue
    There is an offset for some reason on the V5 PCB ADC current sensor.
    This documents problem and testing done.
2014-06-30 Code changes for primary/secondary V5 PCB
    The code was updated to reflect the new pinouts for the primary and
    secondary V5 PCB.
2014-07-01 UART code - secondary board
    Changed I2C between dsPICs to UART.
2014-07-01 splitting old wixel code and new wixel code into separate folders. The newer code serves as a template for writing wireless and uart communication between the wixels or a wixel and PC. The older code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
2014-07-01 didn't pull before pushing previous commit. moved remaining old wixel code into the OldWixel folder.
    [gibbot1_main.c, gibbot_rx1_main.c, testcode.c]
2014-07-03 Fixed conflict in comments
    [acrobot.c]
2014-07-03 Updated V5 Code
    Switched the I2C communication between dsPICs to UART. Got encoder
    values to correct send over UART.
    [ADC.c, ADC.h, UART.c, UART.h, encoder.c, encoder.h, test.c]
2014-07-07 Made changes mostly to CurrentSwipeTab to simulate data presentation
2014-07-08 Worked on CurrentSwipeTab and reorganized some files. NxRBananaPanel1 replaced by GibbotGUI.
2014-07-16 updated newserial files to recieve info from angle encoders; incorporated that into GUISerialPort, which is now a static class that will run the port for the entire project. Currently angle changes a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
    [GUISerialPort.java]
2014-07-17 clean beta version w/ initial drawing bugs fixed and unified timer. will be moving on to gui2 after this
    [GUISerialPort.java]
2014-07-21 switched to working in gui2, with better graphics and basic functionality
2014-07-22 Added switch statement to process bytes from UART
2014-07-22 Wixel Documentation
    Updated documentation for motor encoder
2014-07-23 Uncommented the command enabling QEI2 so we can use the wall encoder.
2014-07-29 Numbered graphs, altered scalars, changed color scheme. Running OK at current frequency (33ms/frame) and serial factor (3)
2014-07-31 Updated PIC to PC communication
    Included both string and data stream versions of communication and fixed
    a UART read issue for the MPU
    [MPU.c, UART.c, UART.h, test.c]
2014-08-11 PCB V6
    Added control board files (primary and secondary) and the gerber files
    used to create board, as well as the LED board files.
    [LEDboard.brd, LEDboard.sch, Primary.brd, Primary.sch, Secondary.brd, Secondary.sch, print.brd]
2014-08-11 dsPIC code for PCB V6
    Created new MPLAB projects for primary and secondary V6 board
2014-08-11 More PCB V6 code
    Missed these on first commit
    [ADC.c, ADC.h, I2CMaster.c, I2CMaster.h, MPU.c, MPU.h, UART.c, UART.h]
2014-08-11 Motor Drive PCB
    added motor driver eagle files to PCB V6 folder
    [MotorDriver.brd, MotorDriver.sch]
2014-08-12 Animations working @ 30 Hz, pull tab swipe action updated.
2014-08-14 Got rid of most magic numbers, replaced with constants.
    [GUISerialPort.java, Gibbot.java]
2014-08-15 Started debugger GUI; currently converts unreadable byte files to readable byte and readable numerical files.
2014-08-20 added batteryArrow image to imagefiles folder
2014-08-20 updated debugger files and final alterations to gui3, added updated version of batteryBar image to imagefiles.
2014-08-20 batteryBar image file
2014-08-20 took 2 files off stage
2014-08-26 added Wixel apps used for motor control and radio communication
2014-11-03 Added QEI interrupt to dsPIC code
    [BatteryManager.sch]
2014-12-19 Added files for Frame V4
    Frame V4 changes the material from 3D printed ABS to aluminum. It also
    includes new larger gears, double bearing at connection between the two
    links, new carrier and shaft, and longer links to accommodate wiring.
    [1.625 Bore Internal Retaining Ring.SLDPRT, 10-32 Button Cap Screw.SLDPRT, 10-32 Button Cap Thread Locking Screw.SLDPRT, 10-32 Thread Locking Nut.SLDPRT, 5-40 Bolt.SLDPRT, 5-40 Nylon Locknut.SLDPRT, Battery Assembly.SLDASM, Battery Holder - keystone-PN1043.SLDPRT]
2015-01-06 Adding gibbot and motor models. Still a work in progress, but almost done.
2015-01-10 updated coordinate system so that (x,y) is now end of magnet link instead of motor position.
2015-01-23 Craig is learning
    [pyoptitrack.sdf]
2015-01-24 added gitattributes to fix line endings across files.
    [Battery Charger.sch, Battery PCB.DXF, Harness_1-Motor Link-fromToList.xml, Motor Link Frame.STEP, Test.sch, Wall Link Frame.STEP, carrier_.125.DXF, carrier_.25.DXF]
2015-01-25 Adding files
    Added compiled versions of arrays.cpp (arrays.exe)
    Uncommented arrays.cpp
    Duplicated Arrays and named CameraJNI.java
    Duplicated arrays and named camerajni.cpp
    Added header file of CameraJNI.h
2015-01-26 Compiling camerajni error test
    Deleted CameraJNI.h as it was created prematurely.
    Added #include lines to camerajni.cpp
    Commented out #include <jni.h> to test, as it was creating an error
2015-01-26 Battery Manager PCB V1
    Pushed current battery manager v1 design
    [BatteryManagerV1.brd, BatteryManagerV1.sch]
2015-01-27 Changes to camerajni
    Added file path to jni header
    Replaced main method with JNI conventional method
2015-01-27 Produced header file from CameraJNI
2015-01-27 JNI modifications to CameraJNI
    Added 'native' notation in method declaration
    Added System.loadLibrary, named "camera" which will be used to create
    DLL
    Renamed reference of old class Array to CameraJNI
2015-01-27 Intro Board
    Intro Board
    [1-23.brd]
2015-01-27 Name change.
    [Vince.brd]
2015-01-27 New Board Schematic
    added new schematic
    [Ryan's board.brd]
2015-01-27 Added bidirectional diode to battery manager
    added bidirectional diode to battery manager schematic
    [BatteryManagerV1.brd, BatteryManagerV1.sch]
2015-01-28 Added a replacement serial drop-in, if XBee's are not available.
    [NU32.c, NU32.h, talkingPIC.c]
2015-01-30 double-checked motor values.
2015-01-30 added NU32 dev board year that code was tested on.
2015-01-30 Sam’s initial PCB assignment
    [Sam PCB Assignment.brd]
2015-01-30 moved into intro folder
    [Sam PCB Assignment.brd]
2015-01-30 Board with boundaries fixed
    [Sam PCB Assignment.brd, Sam.brd]
2015-01-30 V7 and Battery Manager Boards
    Added RPP and diodes to control boards and finished battery manager
    layout
    [BatteryManagerV1.brd, BatteryManagerV1.sch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]
2015-02-02 Figured out the problem of not adding new images See ImageHandler.java class
    [Gibbot.java]
2015-02-02 Hannah Timer Project
2015-02-02 Battery Manager Protection
    added protection diodes to battery manager board
    [BatteryManagerV1.brd, BatteryManagerV1.sch, BatteryPrintV1.brd]
2015-02-02 Added value to SOD523 component
    [BatteryManagerV1.brd, BatteryManagerV1.sch]
2015-02-02 Updated current control
2015-02-02 Added timer interrupts to motor test program
2015-02-02 Updated mainV6.c and time.c in motor test
2015-02-02 Battery Manager Gerber Files
    Fixed minor part issues on battery manager board and made gerber files
    [BatteryManagerV1.brd, BatteryManagerV1.sch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]
2015-02-02 V7 Board print board and gerber files
    Primary and secondary boards on one board for gerber files
    [BatteryPrintV1.brd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]
2015-02-03 Revised commutation pattern for Pittman motor
2015-02-03 Fixed motor control
2015-02-09 Code to communicate wirelessly
2015-02-11 Wireless communication work
2015-02-12 mainV6.c update
    Implemented commend u, d, and m (for increasing/decreasing duty and
    turning off the motor)
2015-02-12 mainV6.c update
    making sure ‘u’ and ‘d’ can only be effective once per call
2015-02-12 modified test code to switch lower and bottom magnets. MMA nb have no real changes to report.
2015-02-13 Program to test encoders
2015-02-13 Figured out why the original code ran so slow. In every call of repaint() in the CurrentBox, HardwareBox, and SpeedometerBox the shadow border behind them was re-drawn.
2015-02-13 H-bridge circuit from Application note
    [H-bridge circuit.sch]
2015-02-13 30ms interrupt to test encoders, fixed bug in encoder.c
    [encoder.c, initializeV6.c, mainV6.c, time.c]
2015-02-13 Print encoder data to screen
2015-02-13 More encoder testing
2015-02-16 Created folder for PWM select test files
2015-02-16 Updated encoder testing with the option to save to a global array
2015-02-16 Changing encoder.c
2015-02-17 Correct motion equations for Gibbot.java's arcMotionUpdate()
    [Gibbot.java]
2015-02-17 Finished torque animation in CurrentBox.java
2015-02-17 Thermometer level in HardwareBox.java is done CurrentBox.java has final touches done
2015-02-17 Updated Battery level in SpeedometerBox.java
2015-02-17 Fixed error in test_swing/time.c to prep for swinging testing
    [mainV6.c, time.c]
2015-02-17 Create spmodel.m
    Matlab function which reads encoder data from a text file and estimates moment of inertia and rotational damping
2015-02-17 Updates to wireless control in test_swing
2015-02-18 Fixed the TextBox.java to not have a wireless signal icon, simply info about the gibbot
2015-02-18 Debugging odd wireless behaviour
2015-02-20 modified code to try and debug why the robot wasn't working. verified that dsPIC is no longer outputting 3.3 V on PWM channels and that default value at startup was to have the bottom magnet on (this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
    [initializeV6.c, mainV6.c, motor.c, time.c]
2015-02-24 Current Control files
2015-02-24 More current control updates
2015-02-24 H-bridge changes 2-24
    [3-chip H-bridge circuit.sch, Sam PCB Assignment.brd, Sam.brd, single-chip H-bridge circuit.sch]
2015-02-24 Switch the speedometer symbols and the battery. Download new font for speedometer graphic. Updated thermometer and battery images.
2015-02-25 modified main so that it print encoder values
2015-02-26 Finished conversion for LayoutContainerPanel2.java and ChargingBox.java
2015-02-27 Adding all of Vision Code
    Working file is main.cpp in
    gibbot\Code\Python_Projects\Vision\C++Vision\GibbotPosition\GibbotPosition\ImageProcessing.
    There are a ton of support files that probably don't do anything but I
    don't feel comfortable deleting just in case they do
2015-02-28 adding new vision code to the project. still a work in progress. the goal is to take two synchronized images from the camera and return the position of the robot using the Camera SDK built-in labelin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
2015-03-01 PCB V8 and V7 changes
    Added V8 (broken-up) boards and minor updates to V7 boards.
    [IRBoardV1.brd, IRBoardV1.sch, Primary.brd, Primary.sch, Secondary.brd, Secondary.sch]
2015-03-02 Updates 3-1
    [3-chip H-bridge circuit.brd, 3-chip H-bridge circuit.sch]
2015-03-02 Adding a README for setting up a Visual Studio project using the Camera SDK and Java JDK.
2015-03-03 Finished circuit except for jumper, partially arranged board
    Some components are still need to be changed to correct package, jumper
    needs to be added to SR pin, and connections need to be made on board
    [3-chip H-bridge circuit.brd, 3-chip H-bridge circuit.sch]
2015-03-03 Updated current control with Matlab communications
2015-03-03 Finished Schematic and board
    All components correspond to components to be ordered. Board is laid
    out and ready to go.
    [3-chip H-bridge circuit.brd, 3-chip H-bridge circuit.sch]
2015-03-03 New Battery Manager Board
    New battery manager board and schematic for LTC6804-1
    [NEW Battery Manager V1.brd, NEW Battery Manager V1.sch]
2015-03-05 Code to verify commutation pattern in motor.c in test_swing.X
2015-03-05 Order-Ready board
    Increased thickness of connections next to choke inductors. Added test
    points. Moved C10 closer to chips.
    [3-chip H-bridge circuit.brd, 3-chip H-bridge circuit.sch]
2015-03-05 Near-Finished board
    Added some silk screen printing. Not all. edited some of the
    connections by C1
    [3-chip H-bridge circuit.brd]
2015-03-05 Minor Changes
    Added transformers and test points for GPIO
    [NEW Battery Manager V1.brd, NEW Battery Manager V1.sch]
2015-03-05 Final Board
    All silk-screen printing added
    [3-chip H-bridge circuit.brd]
2015-03-05 Updated V8 boards
    Finished routing wires for boards
    [Primary.brd, Primary.sch]
2015-03-05 Final Final Board
    Increased a few trace sizes. edited the polygon in the top right corner
    [3-chip H-bridge circuit.brd]
2015-03-08 PCB V8 - Primary and Secondary
    Additional changes to primary board and began secondary
    [Primary.brd, Primary.sch, Secondary.brd, Secondary.sch]
2015-03-09 1. Fixed hardcoding of fonts on TextBox and Speedometer and TorqueBox so they should fit onto larger screens better. May have to redo to take height into account (currently only doing width)
    2. Copied back old code from LayoutContainerPanel2 because of bug found
    during beta test - will go through it again
    3. Changed jungle image because it was sideways the whole time and no
    one noticed...not even the beta testers
    [GUISerialPort.java, Gibbot.java]
2015-03-09 Fixed the issue of the white rectangle behind the description words (Torque, Battery, etc.)
2015-03-09 Finished layout of secondary V8 board
    Finished layout of secondary V8 board and made small adjustments to
    primary
    [Primary.brd, Primary.sch, Secondary.brd, Secondary.sch]
2015-03-10 Updated current control files
2015-03-10 Finished 24V board on primary side
    finished 24V board for new contour and made some small changes to
    primary and secondary control boards, including adding Pickit
    silkscreen on both sides of board
    [Primary.brd, Primary.sch, Secondary.brd, Secondary.sch]
2015-03-12 Added magnet state to control communication
2015-03-13 Moved power connector on V8 primary board
    Connector was too close to edge and would not fit in frame properly
    [Primary.brd]
2015-03-16 Current control menu updates
2015-03-20 Current menu updates moved to primary files
2015-03-21 Finished PCB V8
    Finished layouts for PCB V8 and made all gerber files
    [Primary.brd, Primary.sch, Secondary.brd, Secondary.sch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]
2015-03-21 A couple more edits to vision code
    code is theoretically complete but running in to JNI error that wasn't
    encountered before
    [GibbotVision.cpp, TransformandCluster.h]
2015-04-03 finished adding DMA transfers for the pic2pic communication. Idea is to have important read-only peripherals "mapped" onto the primary PIC.
2015-04-04 finished writing dsPIC inter-board communication code. Originally was going to do DMA, but it wasn't working and there are synchornization issues even if it did so switched to simpler read/write_pic_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
    [pic2pic.c]
2015-04-04 removing some old code that was never used (kept as reference) and removed DMA code.
2015-06-09 Unfinished SPI code
